Avi-Y-Goldstein/compression-jig-solidworks/SUB_UpperStack.SLDASM

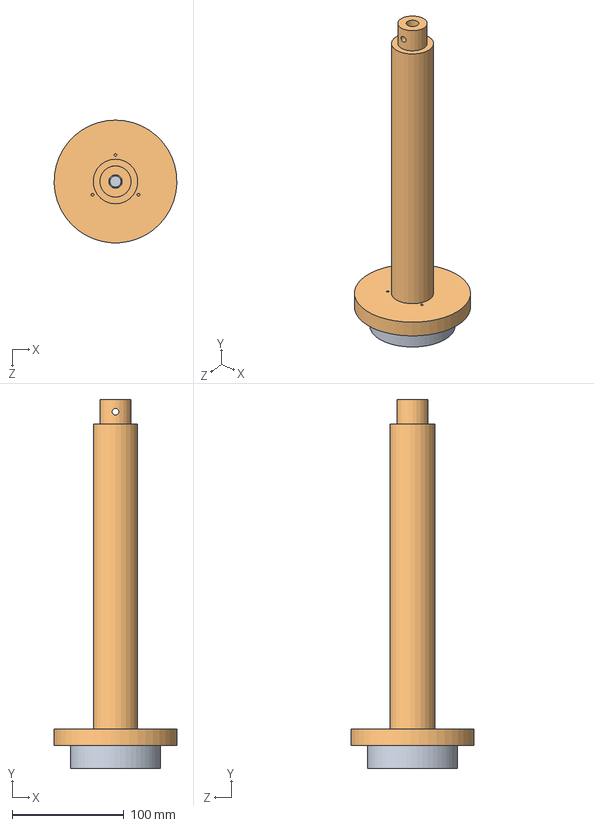
[picture p4: CAD file, 2026-10-13]
SUB_UpperStack.SLDASM
109.9 x 330.5 x 110.0 mm
24_MainCompressionRam
26_UpperPlatenInsulator
