Avi-Y-Goldstein/compression-jig-solidworks/CompressionJig_Assembly.SLDASM

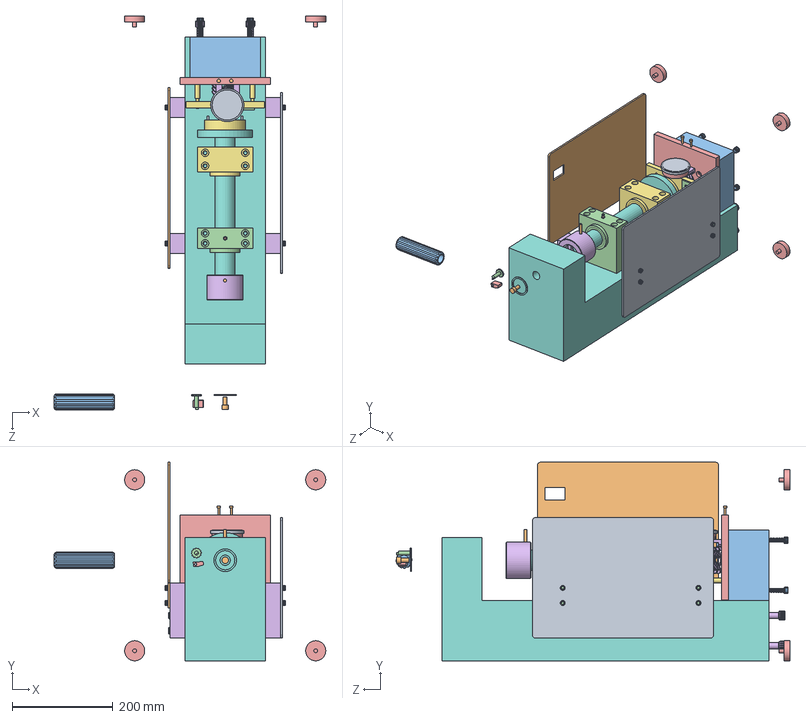
[picture p5: CAD file, 2026-10-13]
CompressionJig_Assembly.SLDASM
540.0 x 395.0 x 783.5 mm
01_Main_Frame_Body
04_LowerRamGuideBlock
08_ShieldMountingBracket x 4
16_BaseFeet x 4
05_UpperRamGuideBlock
03_Anvil_Pedestal
07_RightSafetyShield
06_Left_Safety_Shield
24_MainCompressionRam
26_UpperPlatenInsulator
23_RamCollar
20_SpringLoadedPawl
21_PawlSelectionSwitch
22_LeverHandleGrip
34_SHCS_M8x16_ISO4762
34_PawlPivotPin_4.5x18.5
35_Circlip_40x1.75_DIN471
34_SHCS_M8x40_ISO4762 x 8
34_SHCS_M12x45_ISO4762 x 4
34_GreaseFitting_M6_DIN71412
34_SHCS_M6x16_ISO4762 x 8
34_SHCS_M8x90_ISO4762 x 4
34_DowelPin_6x72_ISO2338
34_SHCS_M4x25_ISO4762 x 4
34_Magnet_D10x5_N42 x 2
31_LowerCompressionPlaten
09_WaveSpring
10_DialBackplate
12_DialNeedle
13_PinionGear
14_DialRack
11_DialBezel
15_LoadPlate
38_GuideStopPin x 2
36_DialFoot x 2
30_LowerInsulatingBaseBlock
28_LeftGuideBar
34_SHCS_M4x12_ISO4762 x 2
34_SHCS_M4x20_ISO4762 x 2
35_Circlip_46x1.75_DIN472
