Avi-Y-Goldstein/compression-jig-solidworks/SUB_LowerStack.SLDASM

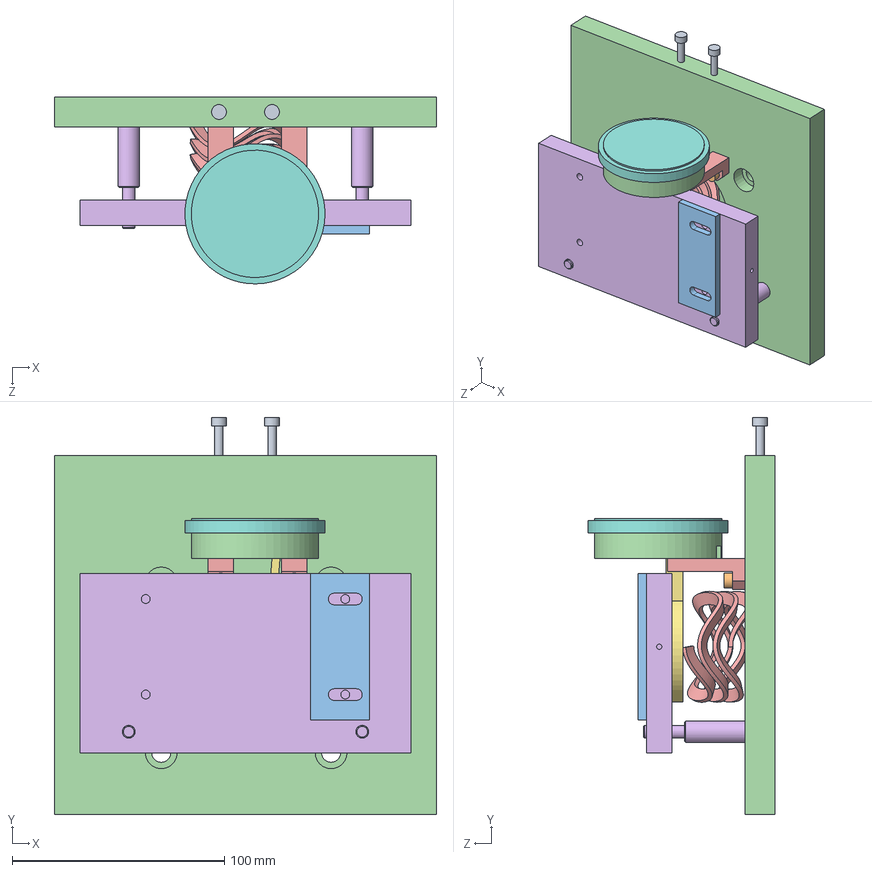
[picture p6: CAD file, 2026-10-13]
SUB_LowerStack.SLDASM
180.0 x 187.0 x 88.0 mm
31_LowerCompressionPlaten
09_WaveSpring
10_DialBackplate
12_DialNeedle
13_PinionGear
14_DialRack
11_DialBezel
15_LoadPlate
38_GuideStopPin x 2
36_DialFoot x 2
30_LowerInsulatingBaseBlock
28_LeftGuideBar
34_SHCS_M4x12_ISO4762 x 2
34_SHCS_M4x20_ISO4762 x 2
