Avi-Y-Goldstein/compression-jig-solidworks/Parts/24_MainCompressionRam.SLDPRT

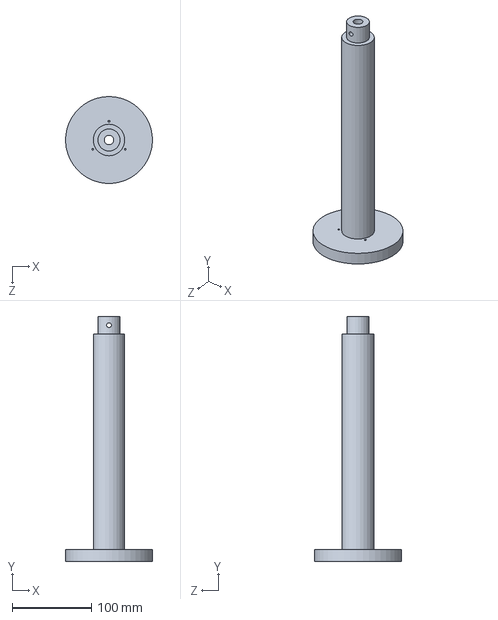
[picture p7: CAD file, 2026-10-13]
Parts/24_MainCompressionRam.SLDPRT
109.9 x 310.0 x 110.0 mm
