Avi-Y-Goldstein/compression-jig-solidworks/SUB_DialIndicator.SLDASM

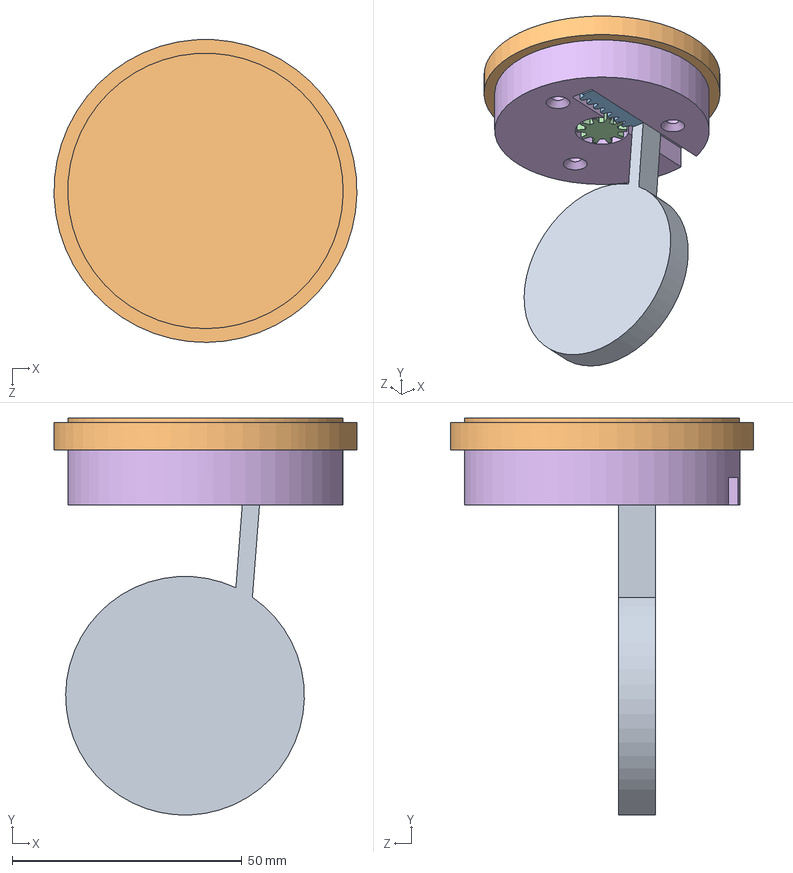
[picture p8: CAD file, 2026-10-13]
SUB_DialIndicator.SLDASM
66.0 x 86.5 x 66.0 mm
10_DialBackplate
12_DialNeedle
13_PinionGear
14_DialRack
11_DialBezel
15_LoadPlate
