Avi-Y-Goldstein/compression-jig-solidworks/Parts/01_Main_Frame_Body.SLDPRT

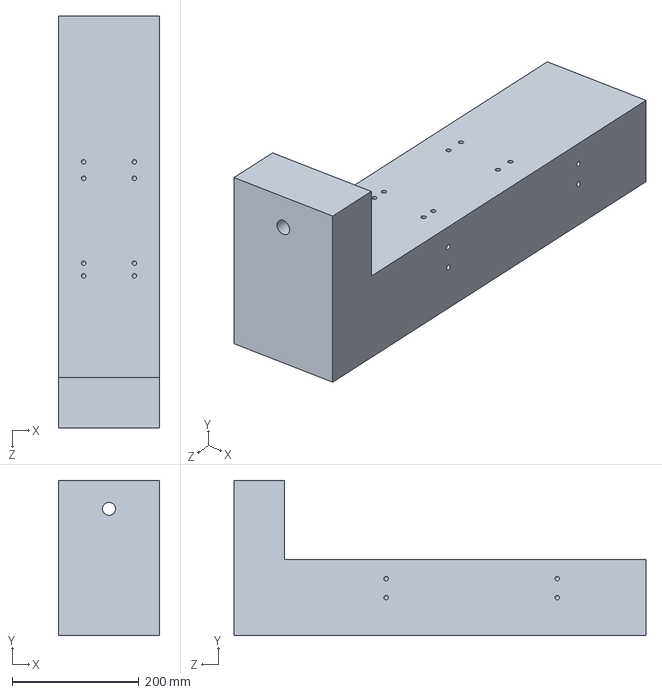
[picture p9: CAD file, 2026-10-13]
Parts/01_Main_Frame_Body.SLDPRT
160.0 x 245.0 x 650.0 mm
