Avi-Y-Goldstein/compression-jig-solidworks/Parts/07_RightSafetyShield.SLDPRT

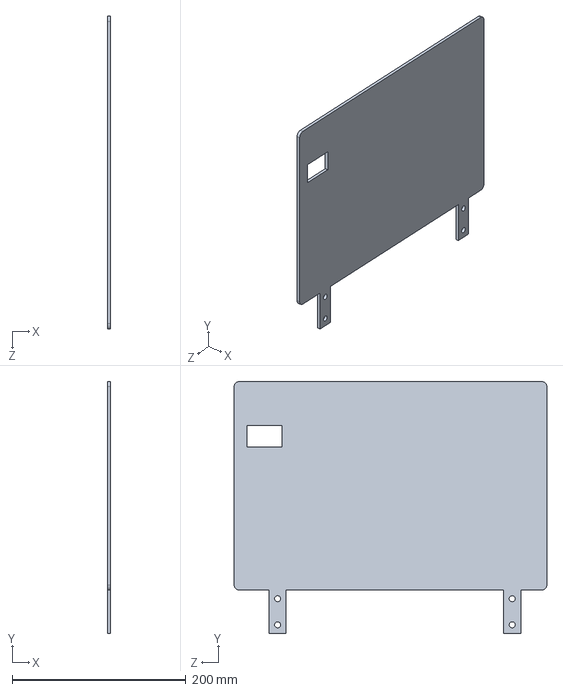
[picture p10: CAD file, 2026-10-13]
Parts/07_RightSafetyShield.SLDPRT
4.00 x 290.0 x 360.0 mm
