Avi-Y-Goldstein/compression-jig-solidworks/Parts/14_DialRack.SLDPRT

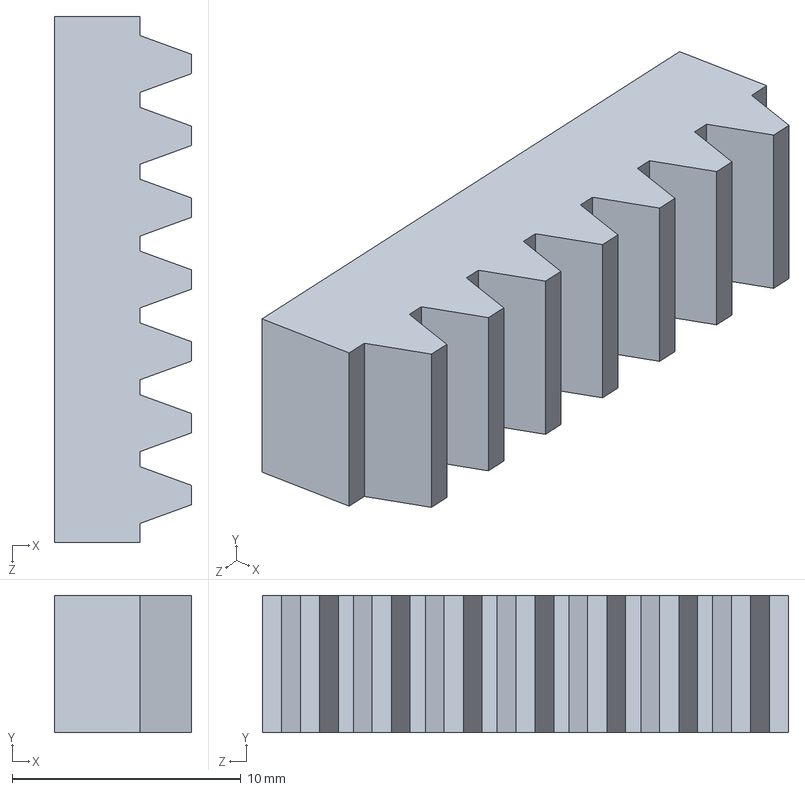
[picture p11: CAD file, 2026-10-13]
Parts/14_DialRack.SLDPRT
6.00 x 6.00 x 23.0 mm
