Avi-Y-Goldstein/compression-jig-solidworks/Parts/16_BaseFeet.SLDPRT

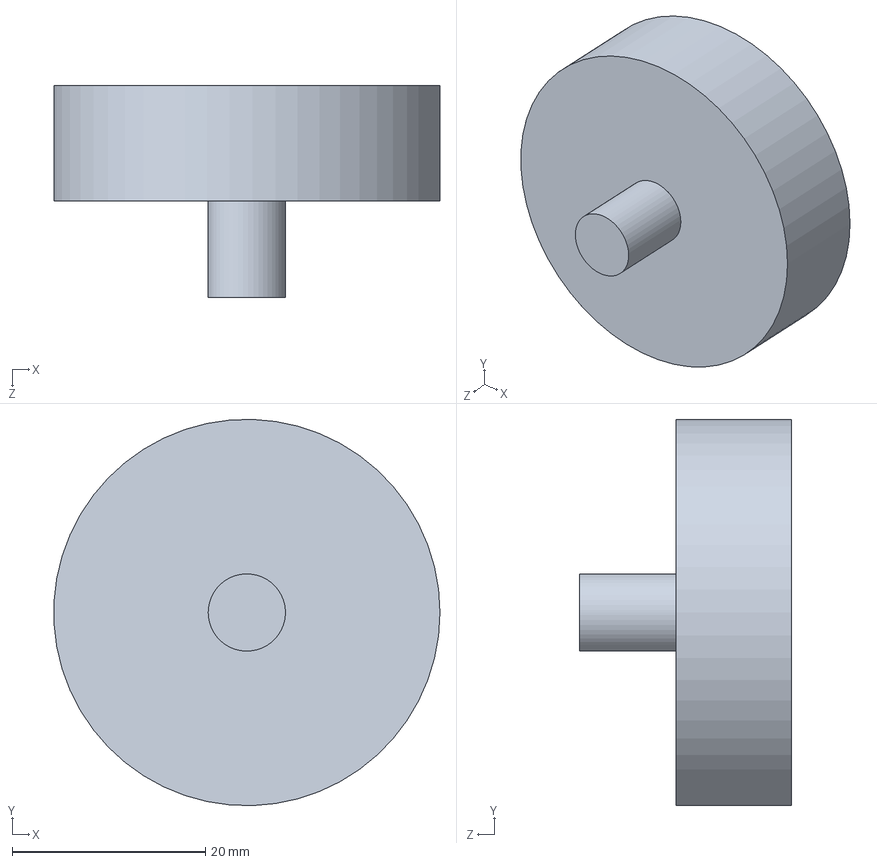
[picture p12: CAD file, 2026-10-13]
Parts/16_BaseFeet.SLDPRT
40.0 x 40.0 x 22.0 mm
