Avi-Y-Goldstein/compression-jig-solidworks/Parts/34_SHCS_M6x16_ISO4762.SLDPRT

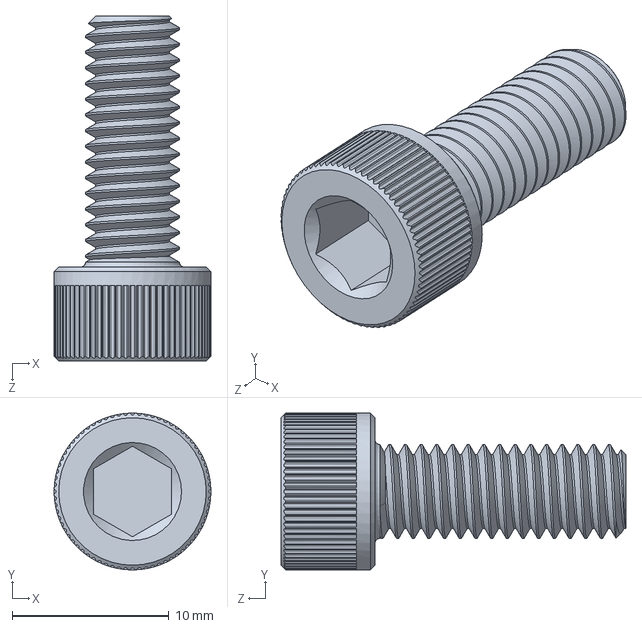
[picture p13: CAD file, 2026-10-13]
Parts/34_SHCS_M6x16_ISO4762.SLDPRT
10.0 x 10.0 x 22.0 mm
