Avi-Y-Goldstein/compression-jig-solidworks/Parts/28_LeftGuideBar.SLDPRT

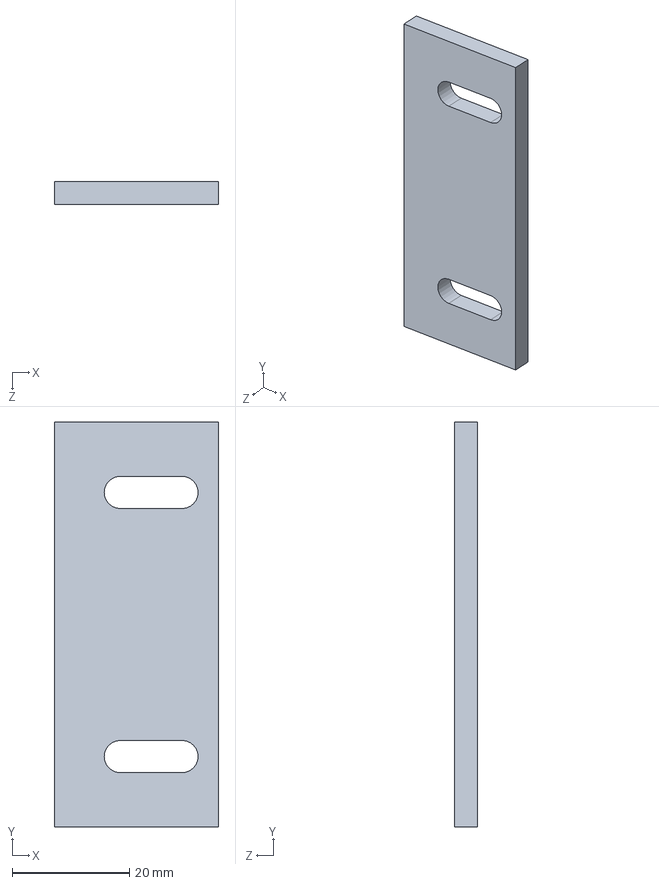
[picture p14: CAD file, 2026-10-13]
Parts/28_LeftGuideBar.SLDPRT
28.0 x 69.0 x 4.00 mm
