Avi-Y-Goldstein/compression-jig-solidworks/Parts/26_UpperPlatenInsulator.SLDPRT

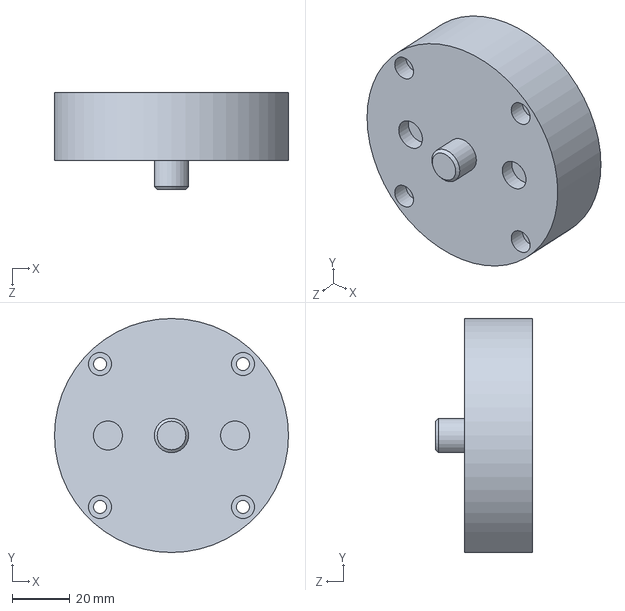
[picture p15: CAD file, 2026-10-13]
Parts/26_UpperPlatenInsulator.SLDPRT
81.0 x 81.0 x 33.5 mm
