Avi-Y-Goldstein/compression-jig-solidworks/Parts/21_PawlSelectionSwitch.SLDPRT

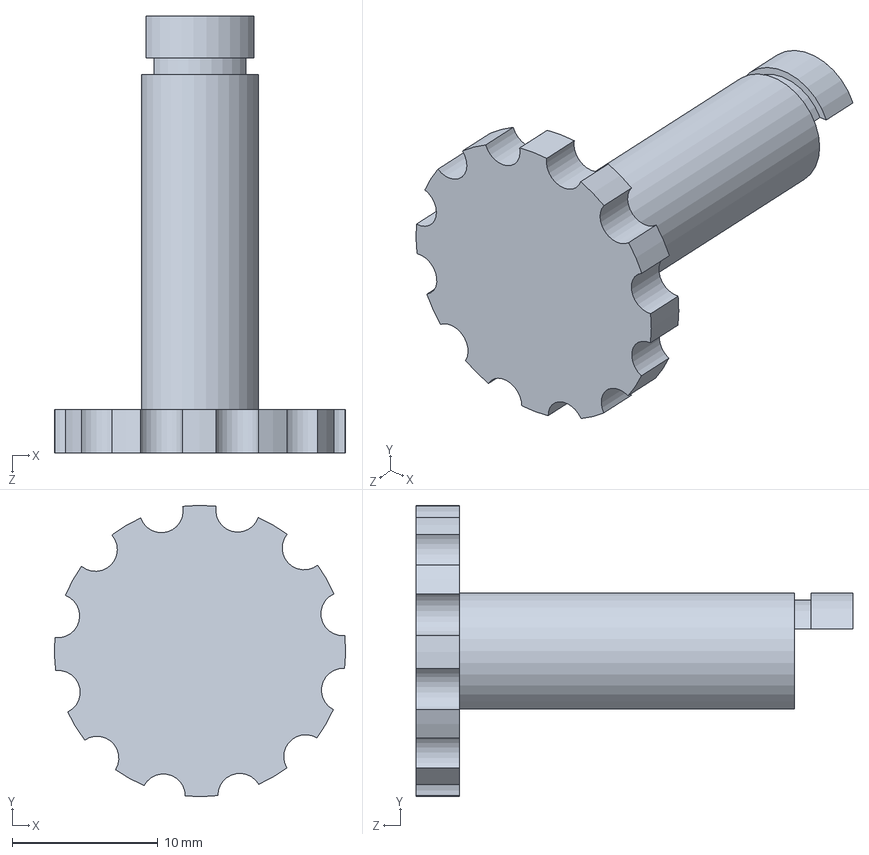
[picture p16: CAD file, 2026-10-13]
Parts/21_PawlSelectionSwitch.SLDPRT
20.0 x 20.0 x 30.0 mm
