Avi-Y-Goldstein/compression-jig-solidworks/Parts/34_SHCS_M4x12_ISO4762.SLDPRT

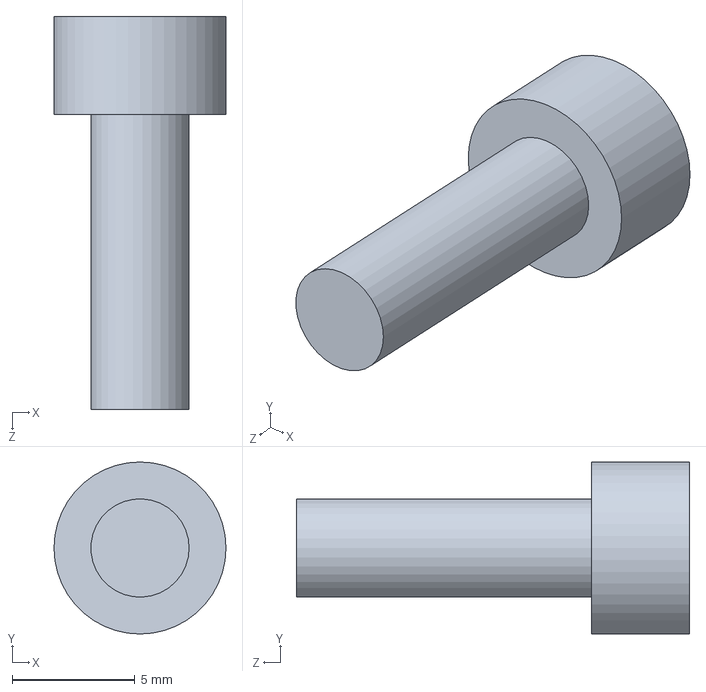
[picture p17: CAD file, 2026-10-13]
Parts/34_SHCS_M4x12_ISO4762.SLDPRT
7.00 x 7.00 x 16.0 mm
