Avi-Y-Goldstein/compression-jig-solidworks/Parts/34_SHCS_M8x90_ISO4762.SLDPRT

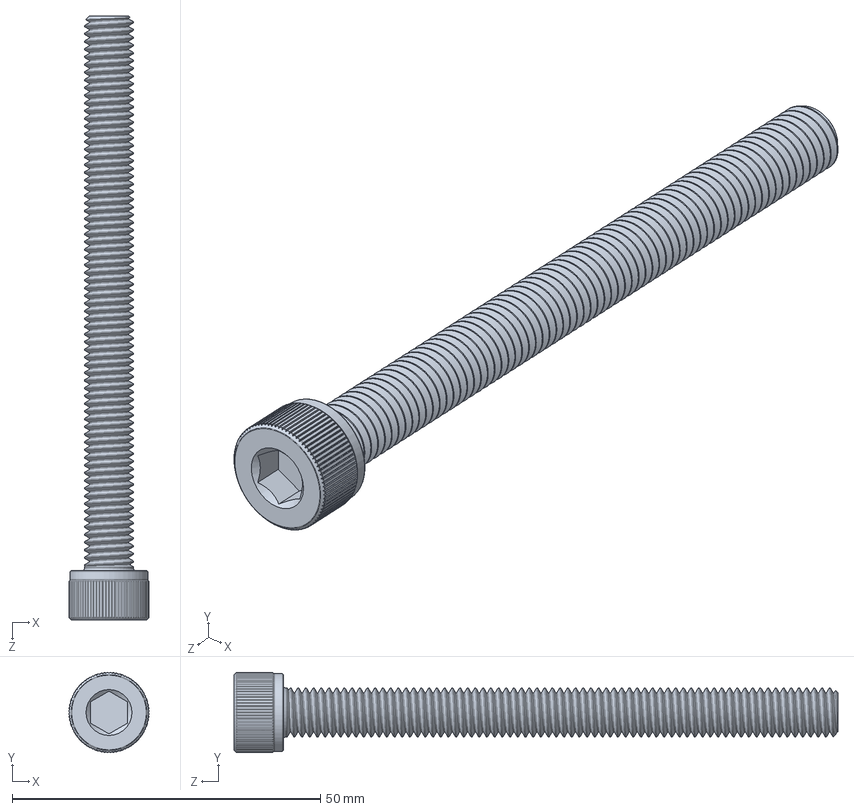
[picture p18: CAD file, 2026-10-13]
Parts/34_SHCS_M8x90_ISO4762.SLDPRT
13.0 x 13.0 x 98.0 mm
