Avi-Y-Goldstein/compression-jig-solidworks/Parts/04_LowerRamGuideBlock.SLDPRT

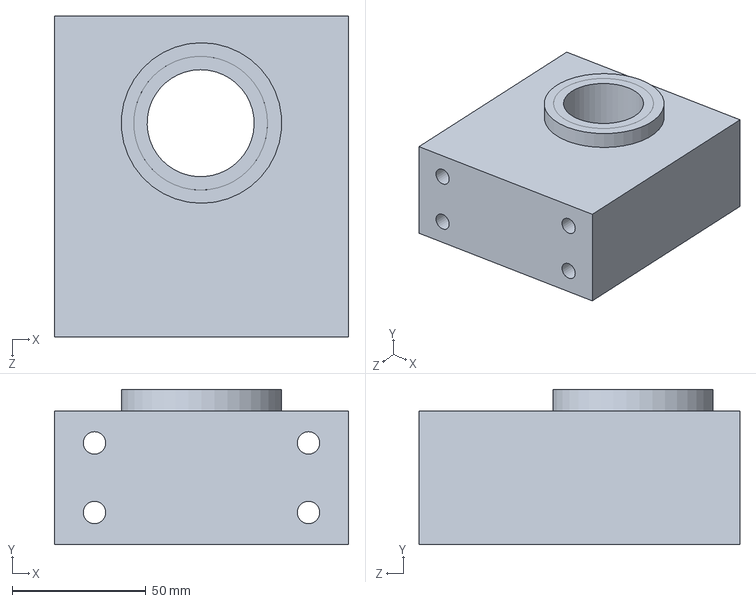
[picture p19: CAD file, 2026-10-13]
Parts/04_LowerRamGuideBlock.SLDPRT
110.0 x 58.0 x 120.0 mm
