Avi-Y-Goldstein/compression-jig-solidworks/Parts/34_SHCS_M12x45_ISO4762.SLDPRT

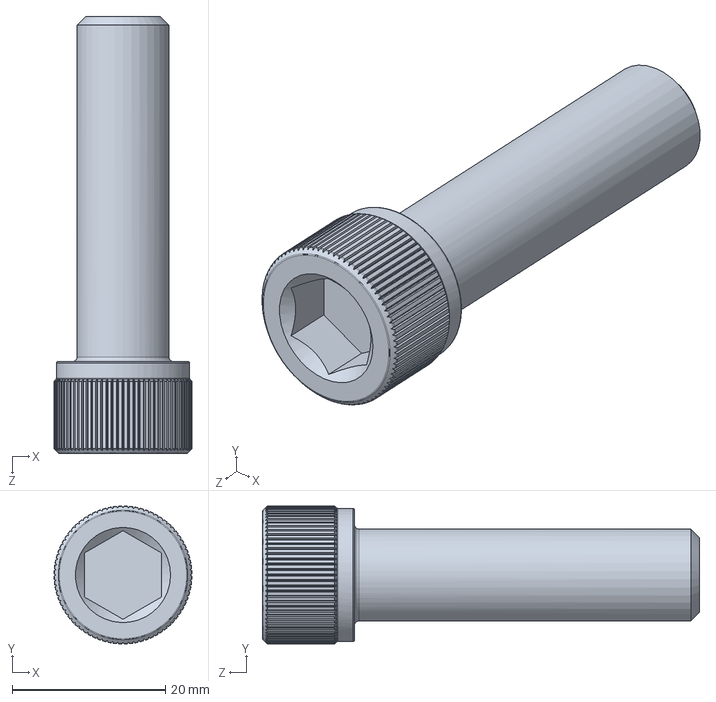
[picture p20: CAD file, 2026-10-13]
Parts/34_SHCS_M12x45_ISO4762.SLDPRT
18.0 x 18.0 x 57.0 mm
