Avi-Y-Goldstein/compression-jig-solidworks/Parts/05_UpperRamGuideBlock.SLDPRT

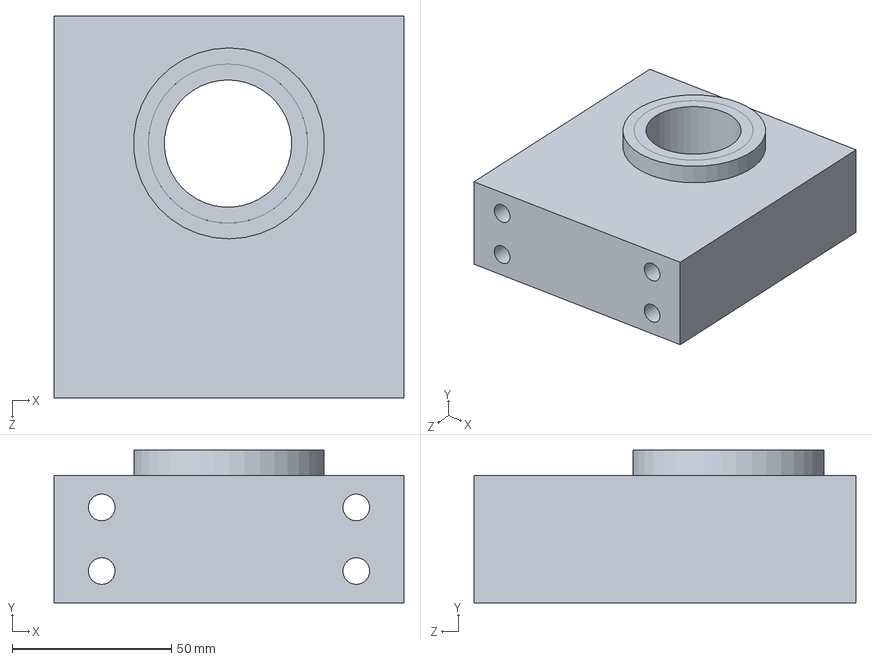
[picture p21: CAD file, 2026-10-13]
Parts/05_UpperRamGuideBlock.SLDPRT
110.0 x 48.0 x 120.0 mm
