Avi-Y-Goldstein/compression-jig-solidworks/Parts/34_Magnet_D10x5_N42.SLDPRT

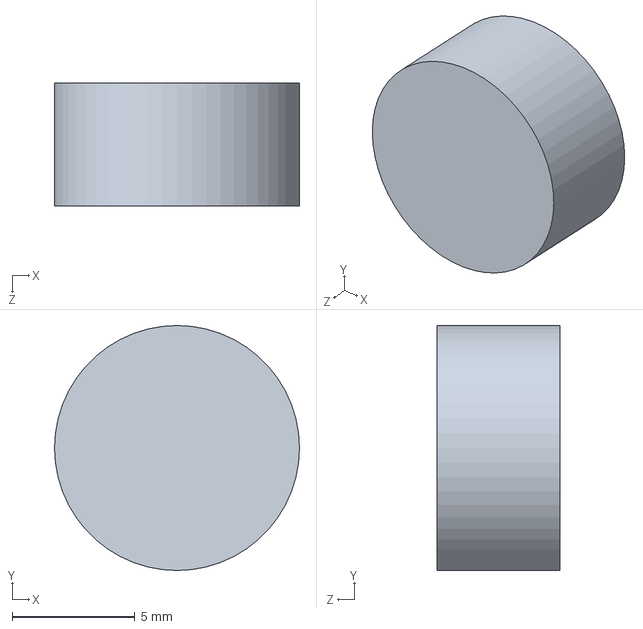
[picture p22: CAD file, 2026-10-13]
Parts/34_Magnet_D10x5_N42.SLDPRT
10.0 x 10.0 x 5.00 mm
