Avi-Y-Goldstein/compression-jig-solidworks/Parts/09_WaveSpring.SLDPRT

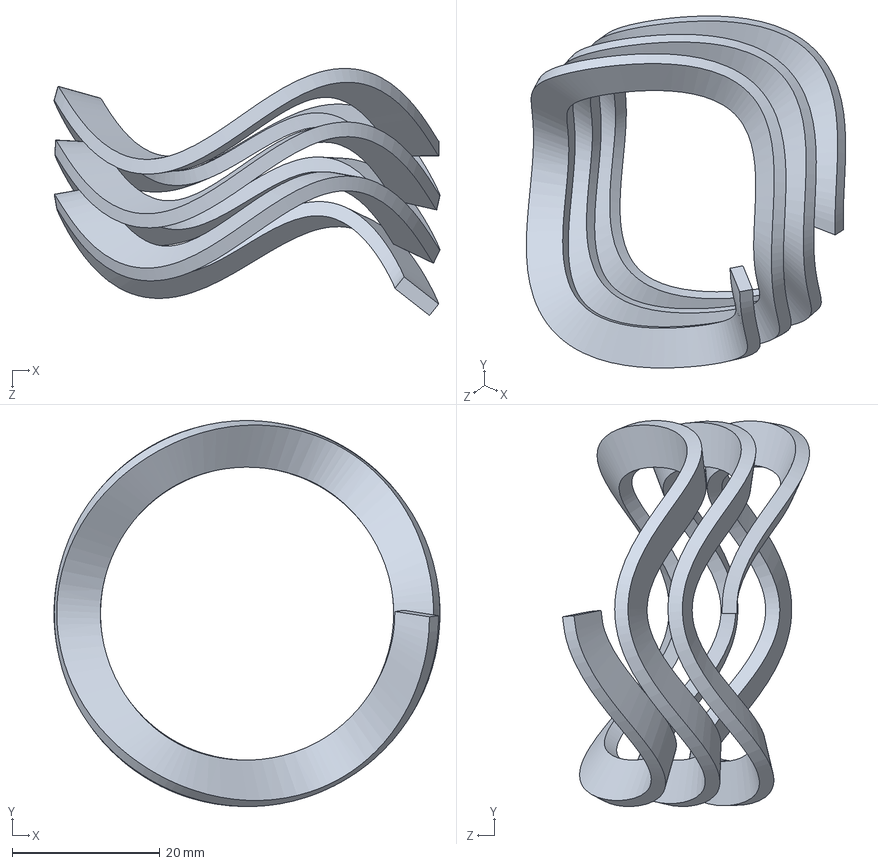
[picture p23: CAD file, 2026-10-13]
Parts/09_WaveSpring.SLDPRT
52.3 x 52.3 x 33.5 mm
