Avi-Y-Goldstein/compression-jig-solidworks/Parts/34_SHCS_M8x40_ISO4762.SLDPRT

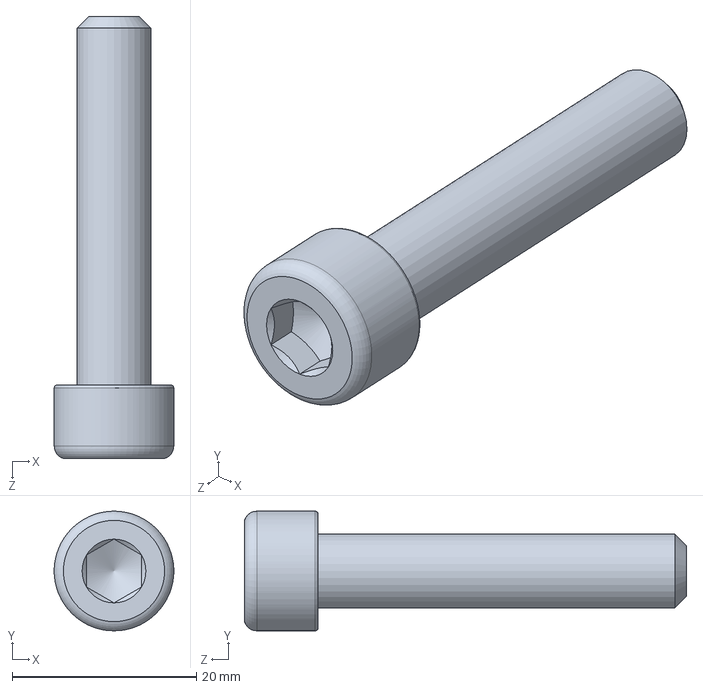
[picture p25: CAD file, 2026-10-13]
Parts/34_SHCS_M8x40_ISO4762.SLDPRT
13.0 x 13.0 x 48.0 mm
