Avi-Y-Goldstein/compression-jig-solidworks/Parts/35_Circlip_40x1.75_DIN471.SLDPRT

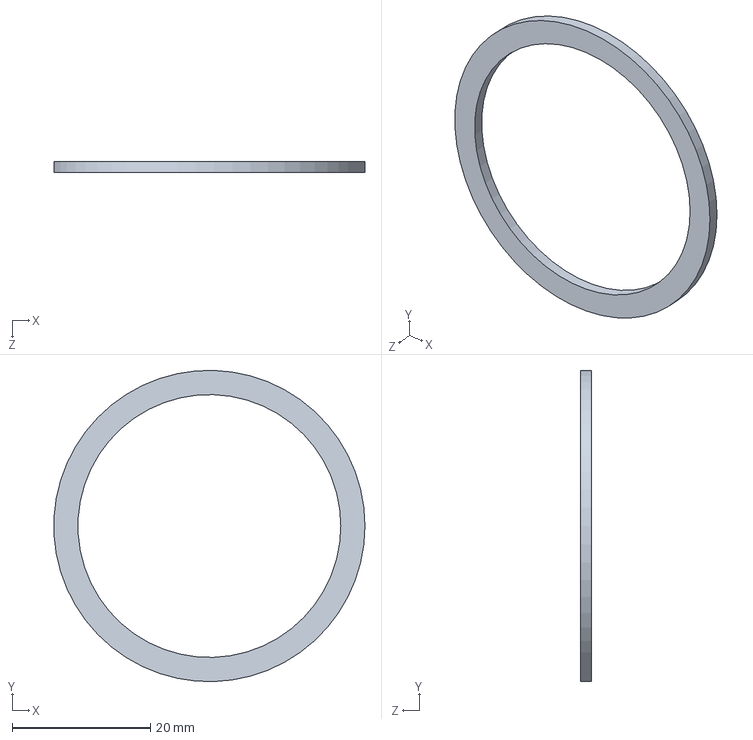
[picture p26: CAD file, 2026-10-13]
Parts/35_Circlip_40x1.75_DIN471.SLDPRT
45.0 x 45.0 x 1.60 mm
