Avi-Y-Goldstein/compression-jig-solidworks/Parts/38_GuideStopPin.SLDPRT

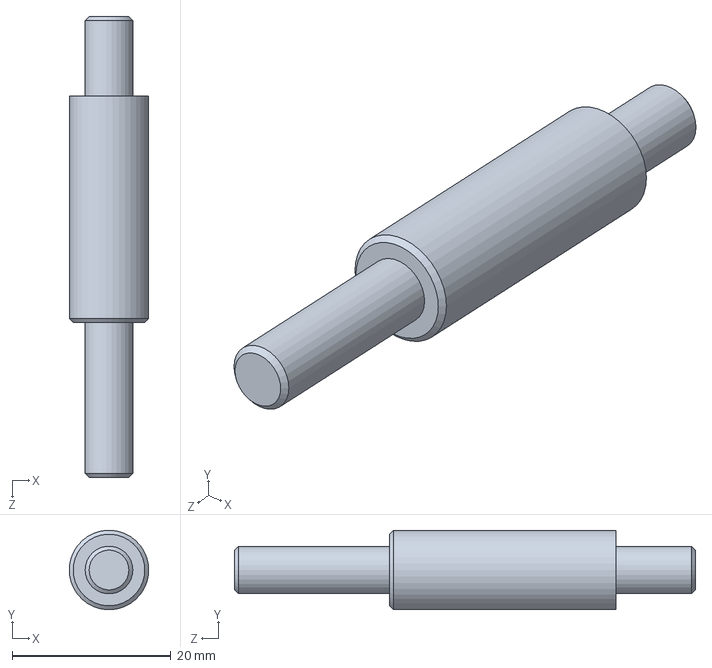
[picture p27: CAD file, 2026-10-13]
Parts/38_GuideStopPin.SLDPRT
10.0 x 9.97 x 58.0 mm
