Avi-Y-Goldstein/compression-jig-solidworks/Parts/34_GreaseFitting_M6_DIN71412.SLDPRT

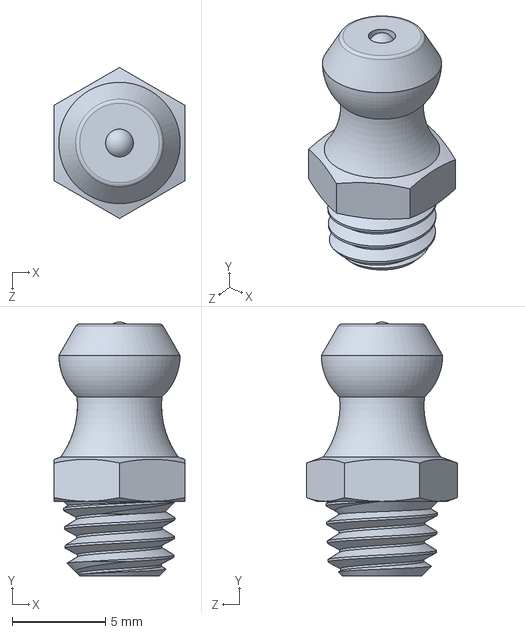
[picture p28: CAD file, 2026-10-13]
Parts/34_GreaseFitting_M6_DIN71412.SLDPRT
7.00 x 13.6 x 8.08 mm
