Avi-Y-Goldstein/compression-jig-solidworks/Parts/10_DialBackplate.SLDPRT

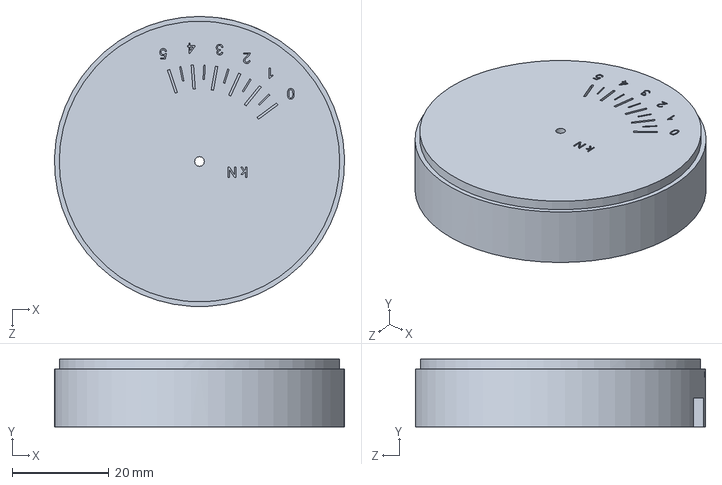
[picture p29: CAD file, 2026-10-13]
Parts/10_DialBackplate.SLDPRT
60.0 x 14.0 x 60.0 mm
