Avi-Y-Goldstein/compression-jig-solidworks/Parts/11_DialBezel.SLDPRT

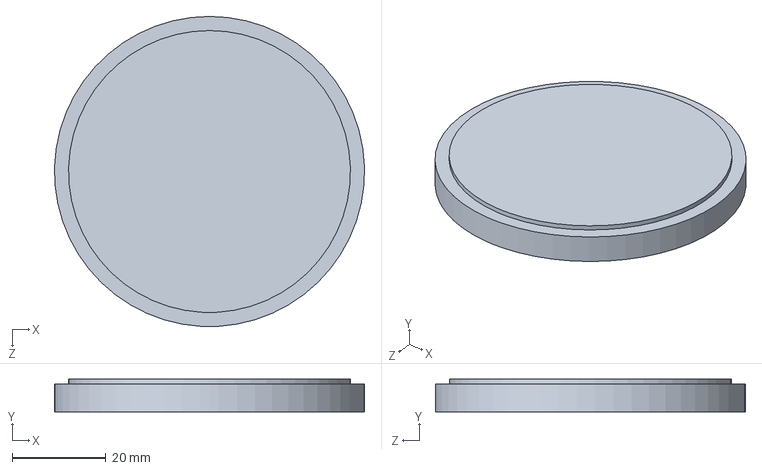
[picture p30: CAD file, 2026-10-13]
Parts/11_DialBezel.SLDPRT
66.0 x 7.00 x 66.0 mm
