Avi-Y-Goldstein/compression-jig-solidworks/Parts/20_SpringLoadedPawl.SLDPRT

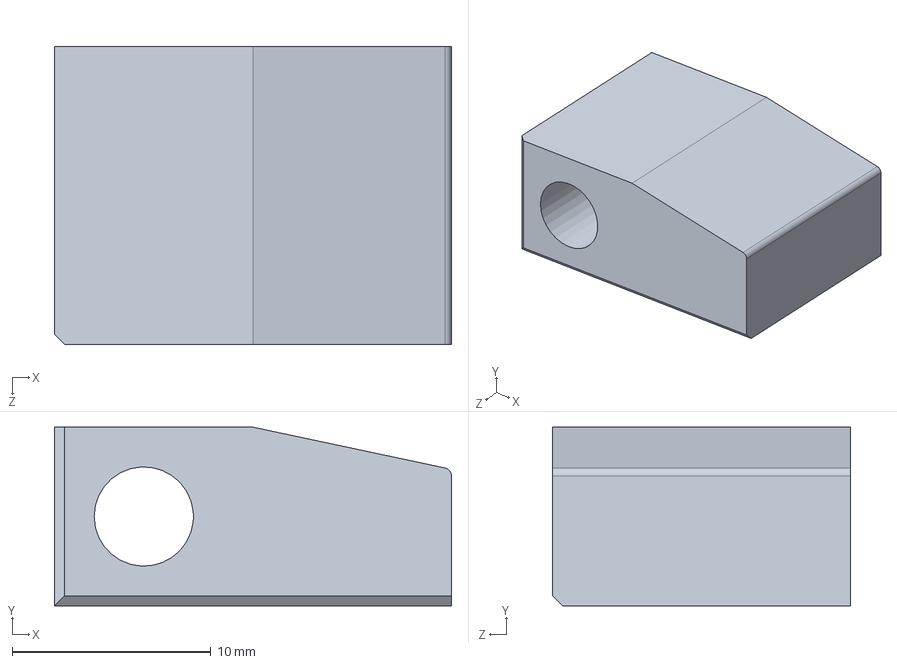
[picture p31: CAD file, 2026-10-13]
Parts/20_SpringLoadedPawl.SLDPRT
20.0 x 9.00 x 15.0 mm
