Avi-Y-Goldstein/compression-jig-solidworks/Parts/06_Left_Safety_Shield.SLDPRT

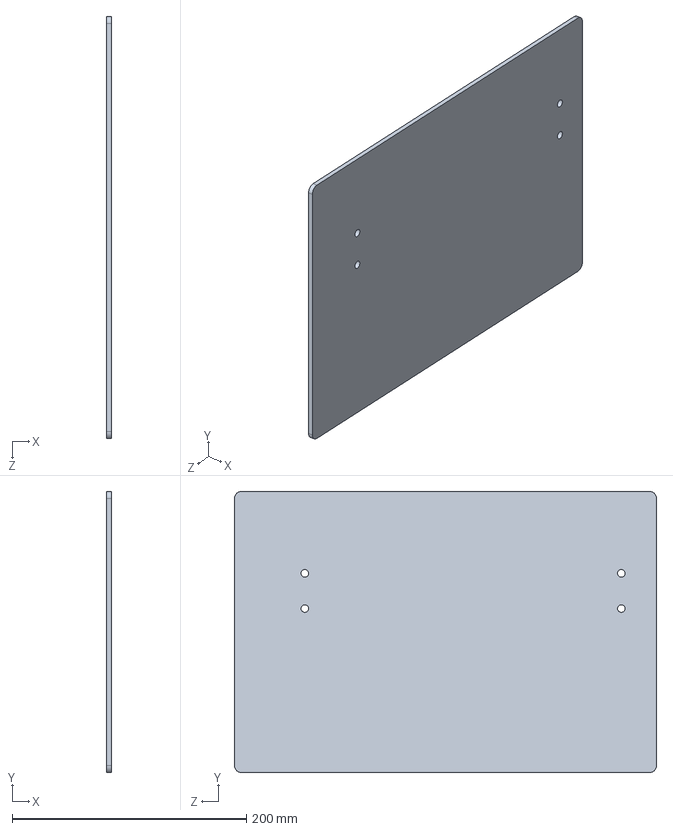
[picture p32: CAD file, 2026-10-13]
Parts/06_Left_Safety_Shield.SLDPRT
4.00 x 240.0 x 360.0 mm
