Avi-Y-Goldstein/compression-jig-solidworks/Parts/03_Anvil_Pedestal.SLDPRT

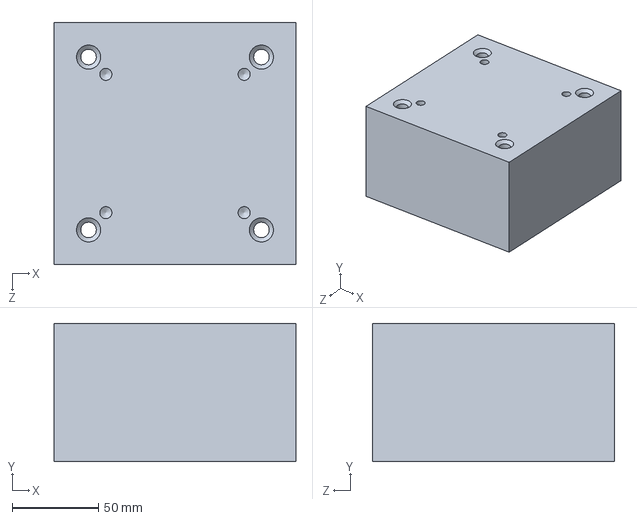
[picture p33: CAD file, 2026-10-13]
Parts/03_Anvil_Pedestal.SLDPRT
140.0 x 80.0 x 140.0 mm
