Avi-Y-Goldstein/compression-jig-solidworks/Parts/34_PawlPivotPin_4.5x18.5.SLDPRT

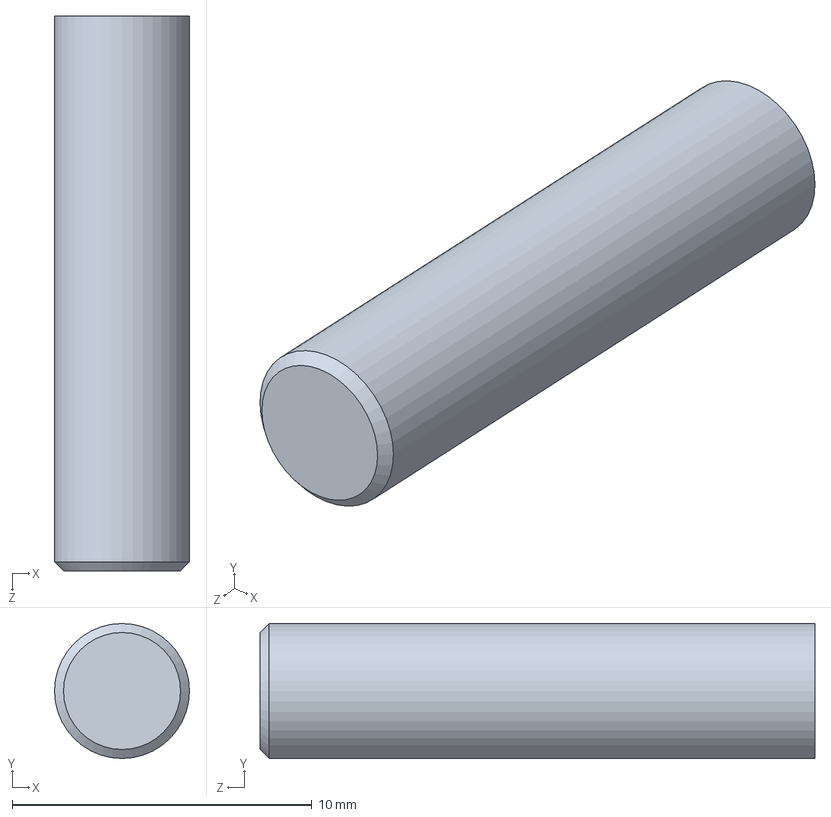
[picture p34: CAD file, 2026-10-13]
Parts/34_PawlPivotPin_4.5x18.5.SLDPRT
4.50 x 4.50 x 18.5 mm
