Avi-Y-Goldstein/compression-jig-solidworks/Parts/08_ShieldMountingBracket.SLDPRT

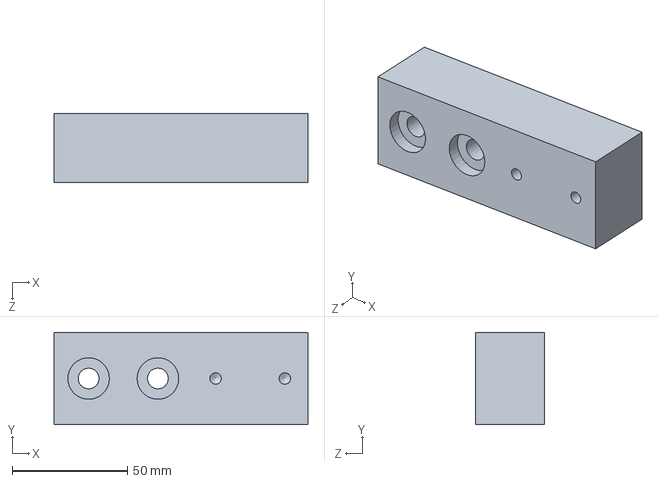
[picture p35: CAD file, 2026-10-13]
Parts/08_ShieldMountingBracket.SLDPRT
110.0 x 40.0 x 30.0 mm
