Avi-Y-Goldstein/compression-jig-solidworks/Parts/36_DialFoot.SLDPRT

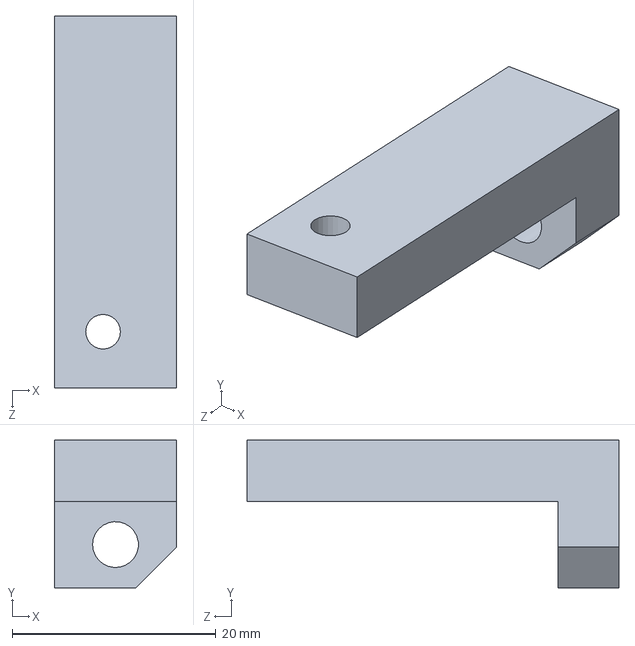
[picture p36: CAD file, 2026-10-13]
Parts/36_DialFoot.SLDPRT
12.0 x 14.5 x 36.5 mm
