Avi-Y-Goldstein/compression-jig-solidworks/Parts/13_PinionGear.SLDPRT

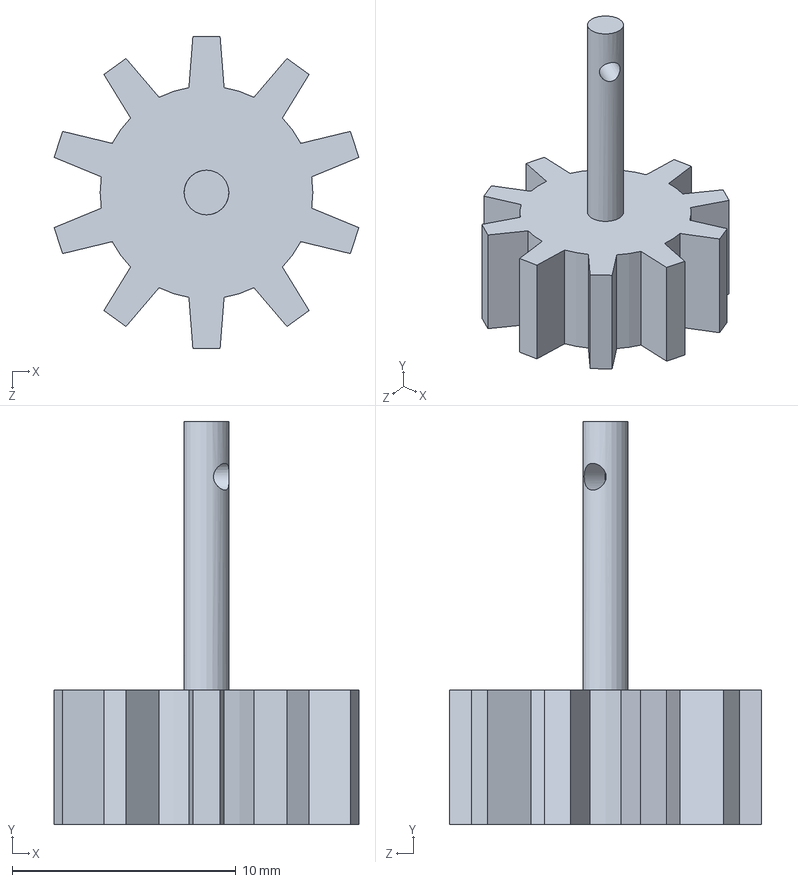
[picture p37: CAD file, 2026-10-13]
Parts/13_PinionGear.SLDPRT
13.6 x 18.0 x 13.9 mm
