Avi-Y-Goldstein/compression-jig-solidworks/Parts/30_LowerInsulatingBaseBlock.SLDPRT

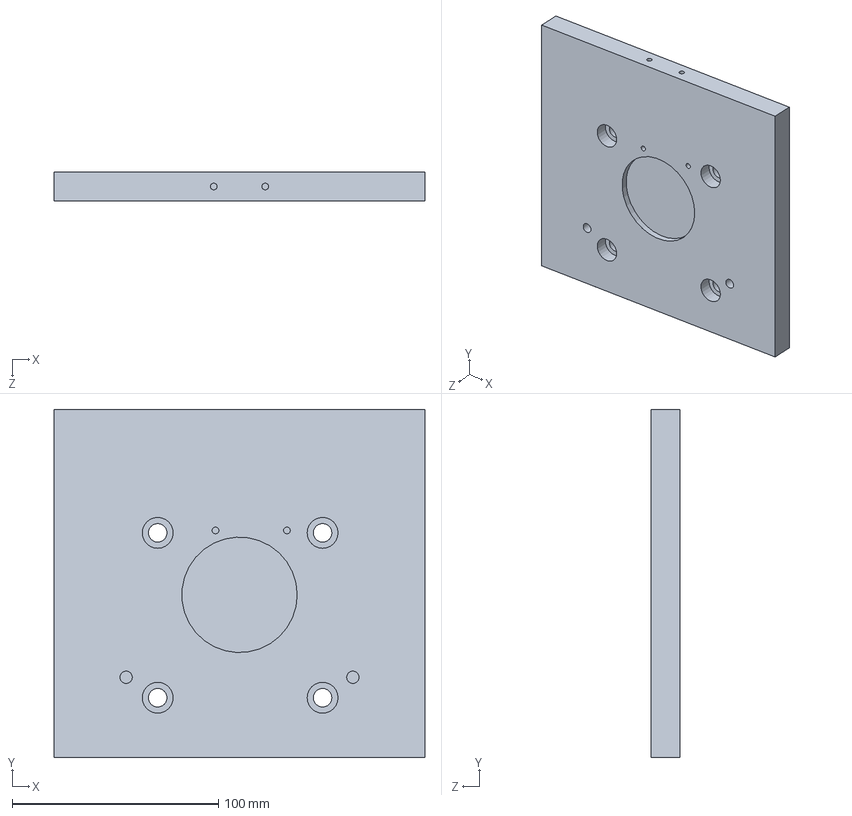
[picture p38: CAD file, 2026-10-13]
Parts/30_LowerInsulatingBaseBlock.SLDPRT
180.0 x 169.0 x 14.0 mm
