Avi-Y-Goldstein/compression-jig-solidworks/Parts/34_DowelPin_6x72_ISO2338.SLDPRT

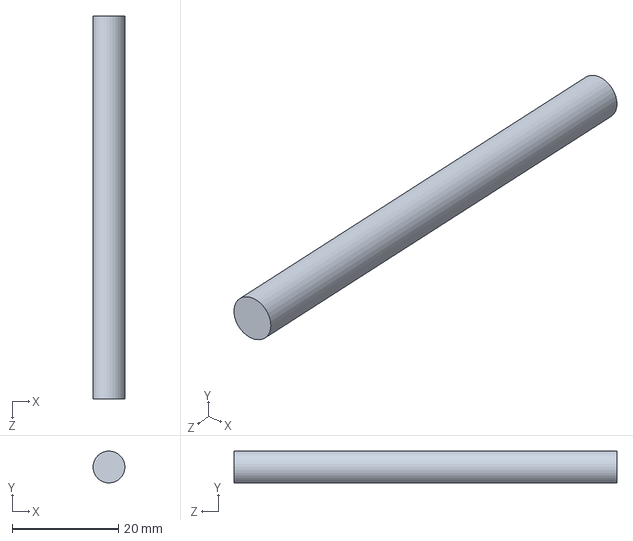
[picture p39: CAD file, 2026-10-13]
Parts/34_DowelPin_6x72_ISO2338.SLDPRT
5.99 x 5.99 x 72.0 mm
