Avi-Y-Goldstein/compression-jig-solidworks/Parts/35_Circlip_46x1.75_DIN472.SLDPRT

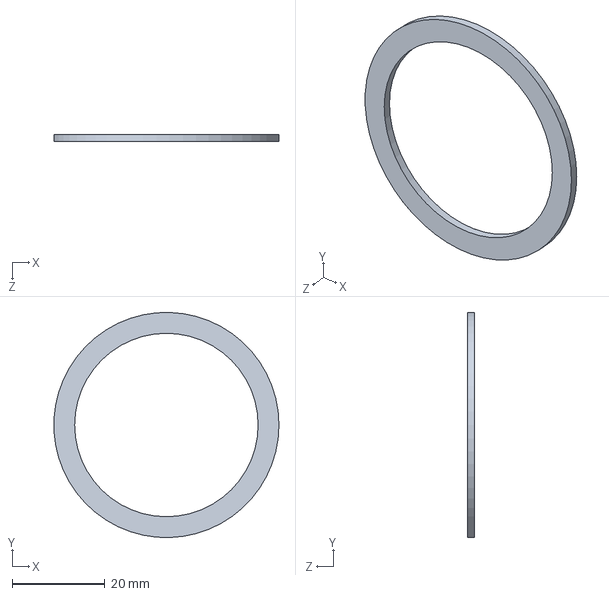
[picture p40: CAD file, 2026-10-13]
Parts/35_Circlip_46x1.75_DIN472.SLDPRT
48.5 x 48.5 x 1.60 mm
