Avi-Y-Goldstein/compression-jig-solidworks/Parts/22_LeverHandleGrip.SLDPRT

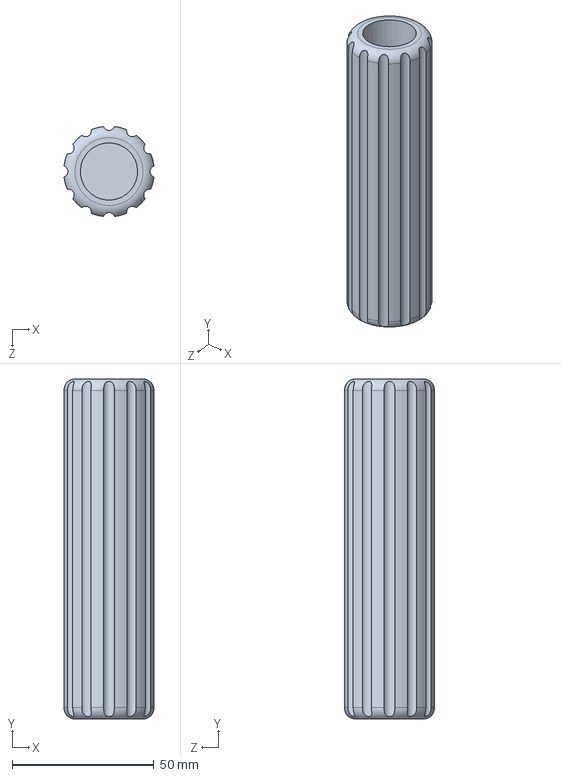
[picture p41: CAD file, 2026-10-13]
Parts/22_LeverHandleGrip.SLDPRT
31.8 x 120.0 x 31.8 mm
