Avi-Y-Goldstein/compression-jig-solidworks/Parts/15_LoadPlate.SLDPRT

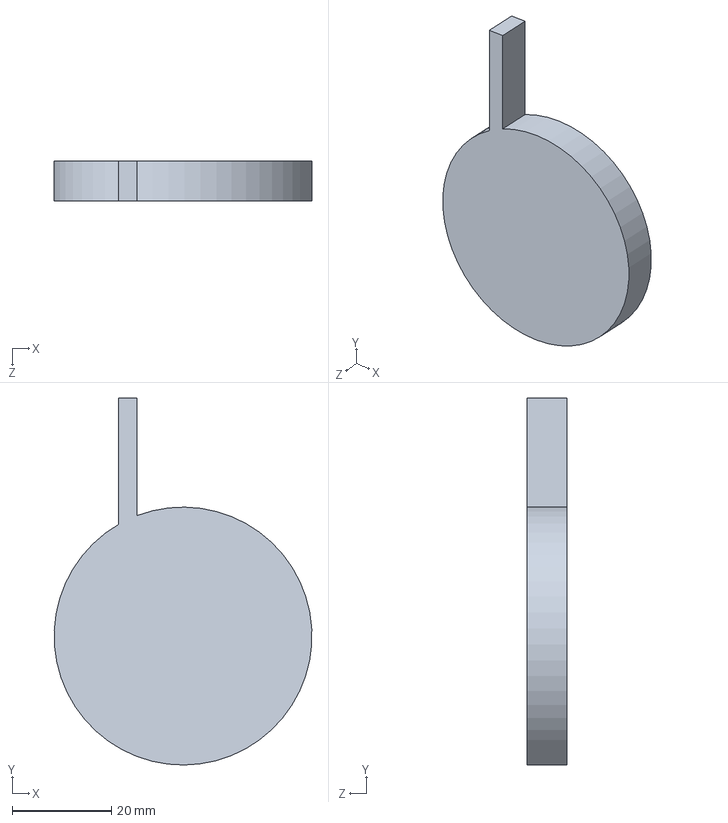
[picture p42: CAD file, 2026-10-13]
Parts/15_LoadPlate.SLDPRT
51.9 x 74.0 x 8.00 mm
