Avi-Y-Goldstein/compression-jig-solidworks/Parts/12_DialNeedle.SLDPRT

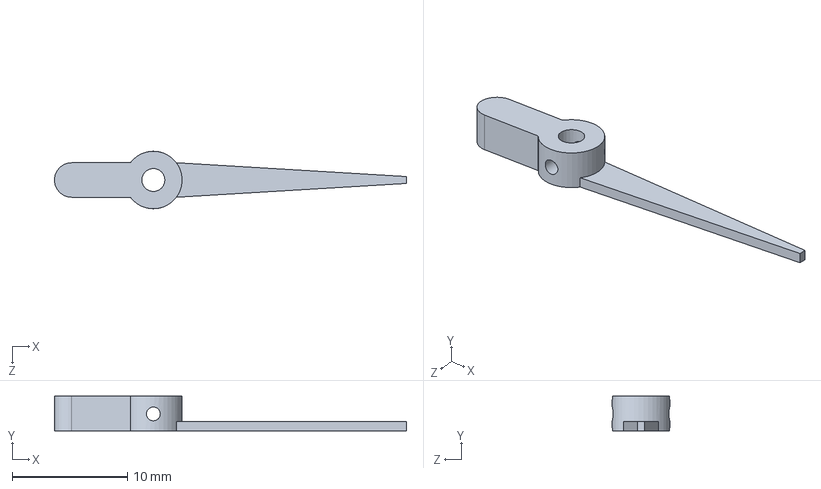
[picture p43: CAD file, 2026-10-13]
Parts/12_DialNeedle.SLDPRT
30.6 x 3.00 x 5.00 mm
