Avi-Y-Goldstein/compression-jig-solidworks/Parts/23_RamCollar.SLDPRT

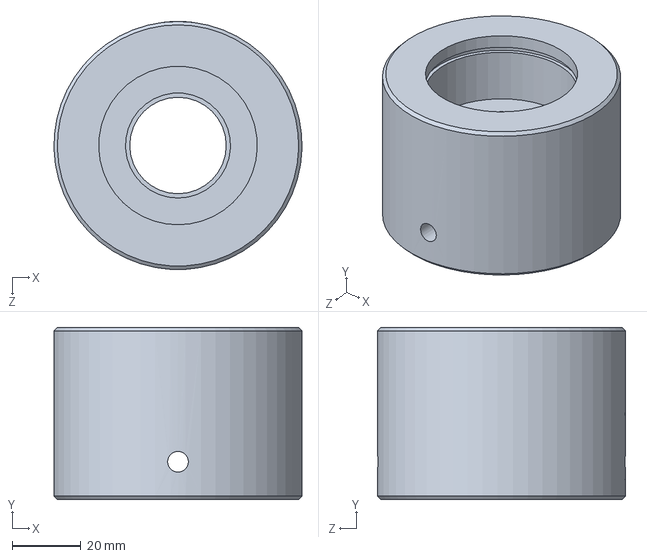
[picture p44: CAD file, 2026-10-13]
Parts/23_RamCollar.SLDPRT
72.0 x 50.0 x 72.0 mm
