Avi-Y-Goldstein/compression-jig-solidworks/Parts/31_LowerCompressionPlaten.SLDPRT

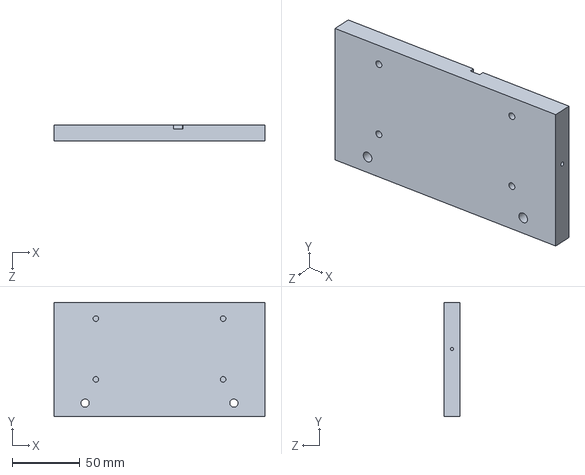
[picture p45: CAD file, 2026-10-13]
Parts/31_LowerCompressionPlaten.SLDPRT
156.0 x 84.5 x 12.0 mm
