Avi-Y-Goldstein/compression-jig-solidworks/Parts/34_SHCS_M4x20_ISO4762.SLDPRT

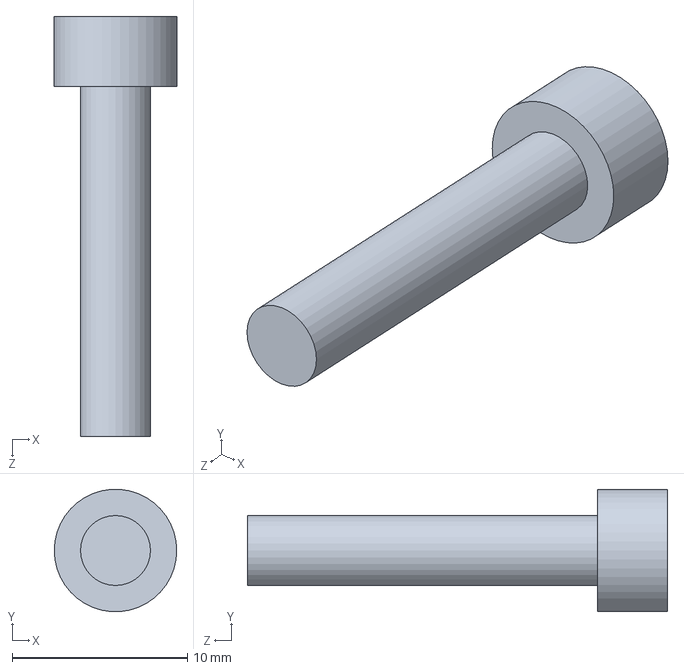
[picture p46: CAD file, 2026-10-13]
Parts/34_SHCS_M4x20_ISO4762.SLDPRT
7.00 x 6.98 x 24.0 mm
