Avi-Y-Goldstein/compression-jig-solidworks/Parts/34_SHCS_M4x25_ISO4762.SLDPRT

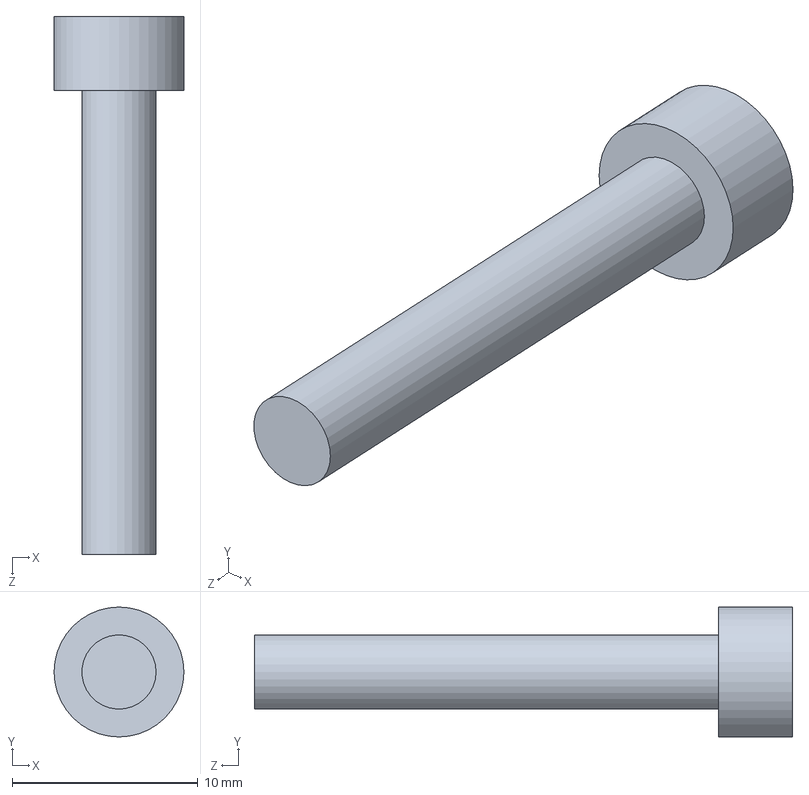
[picture p47: CAD file, 2026-10-13]
Parts/34_SHCS_M4x25_ISO4762.SLDPRT
7.00 x 7.00 x 29.0 mm
