Avi-Y-Goldstein/compression-jig-solidworks/Parts/18_RatchetingLeverArm.SLDPRT

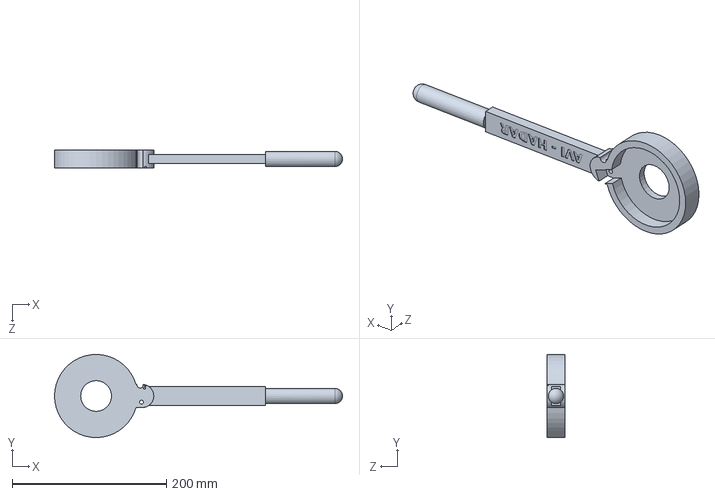
[picture p48: CAD file, 2026-10-13]
Parts/18_RatchetingLeverArm.SLDPRT
374.0 x 108.0 x 23.0 mm
