Avi-Y-Goldstein/compression-jig-solidworks/Parts/37_DialPin.SLDPRT

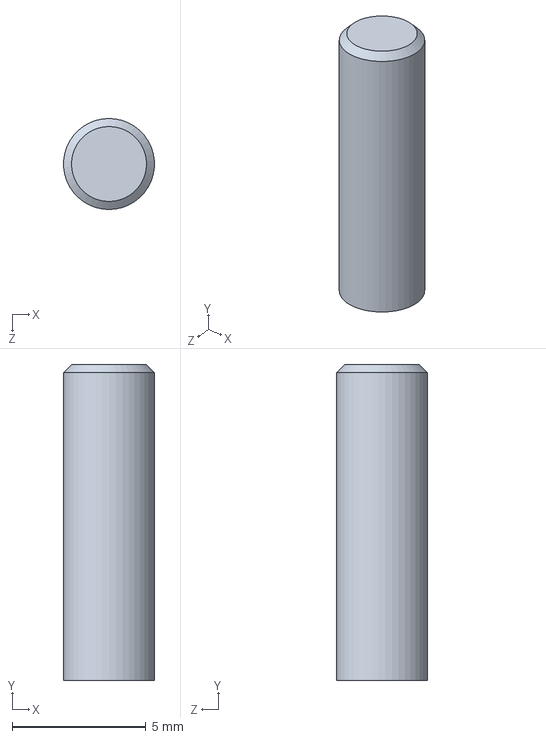
[picture p49: CAD file, 2026-10-13]
Parts/37_DialPin.SLDPRT
3.39 x 11.8 x 3.40 mm
