Avi-Y-Goldstein/compression-jig-solidworks/Parts/35_RetainingRing_8x0.8_DIN471.SLDPRT

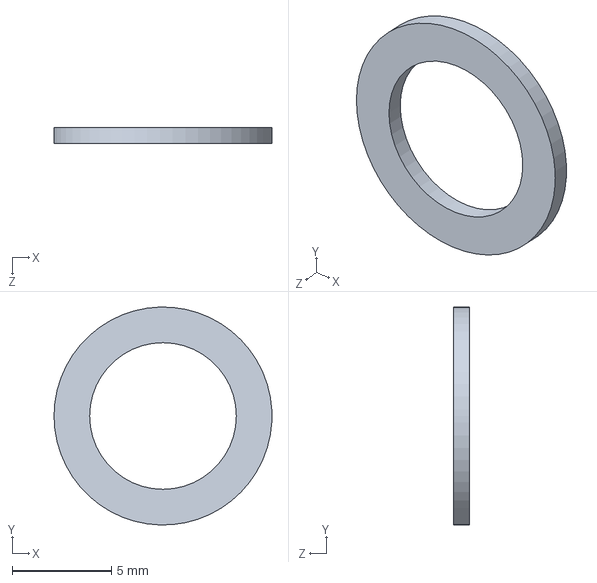
[picture p50: CAD file, 2026-10-13]
Parts/35_RetainingRing_8x0.8_DIN471.SLDPRT
11.0 x 11.0 x 0.8 mm
