Avi-Y-Goldstein/compression-jig-solidworks/Parts/32_TerminalContactBlock.SLDPRT

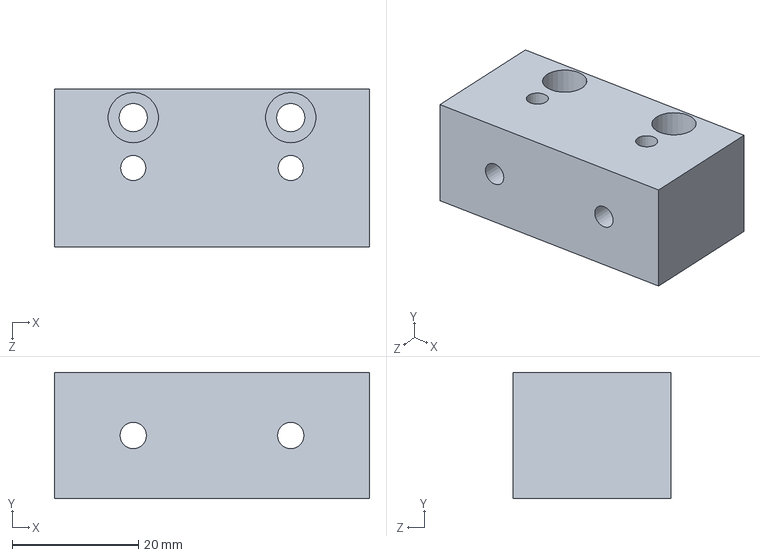
[picture p51: CAD file, 2026-10-13]
Parts/32_TerminalContactBlock.SLDPRT
50.0 x 20.0 x 25.0 mm
