Avi-Y-Goldstein/compression-jig-solidworks/Parts/19_RatchetGearHub.SLDPRT

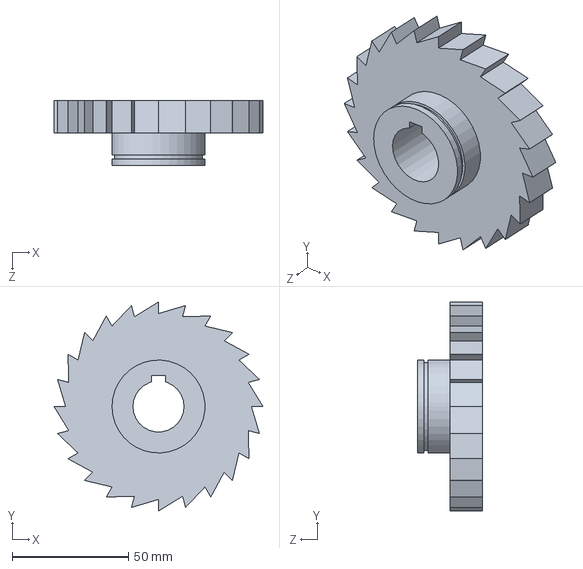
[picture p52: CAD file, 2026-10-13]
Parts/19_RatchetGearHub.SLDPRT
90.0 x 90.0 x 28.0 mm
