Avi-Y-Goldstein/compression-jig-solidworks/Parts/34_HexNut_DialNeedle.SLDPRT

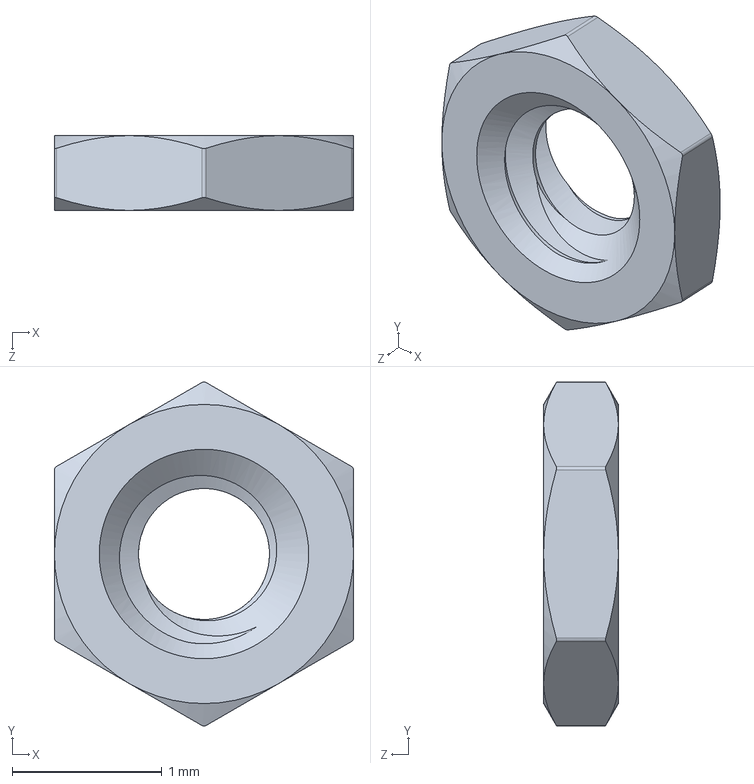
[picture p55: CAD file, 2026-10-13]
Parts/34_HexNut_DialNeedle.SLDPRT
2.00 x 2.30 x 0.5 mm
