Avi-Y-Goldstein/compression-jig-solidworks/Parts/33_MultiLayerBatterySample.SLDPRT

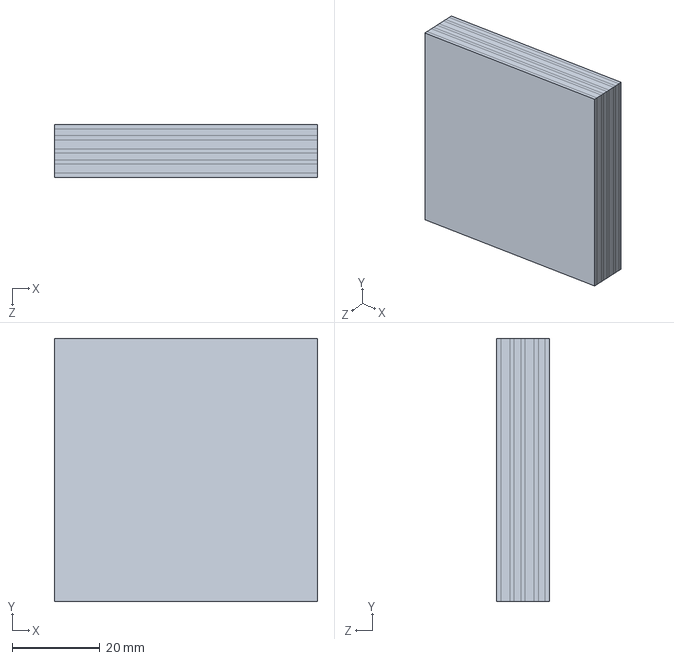
[picture p56: CAD file, 2026-10-13]
Parts/33_MultiLayerBatterySample.SLDPRT
60.0 x 60.0 x 12.0 mm
