Avi-Y-Goldstein/compression-jig-solidworks/Parts/27_UpperCompressionPlaten.SLDPRT

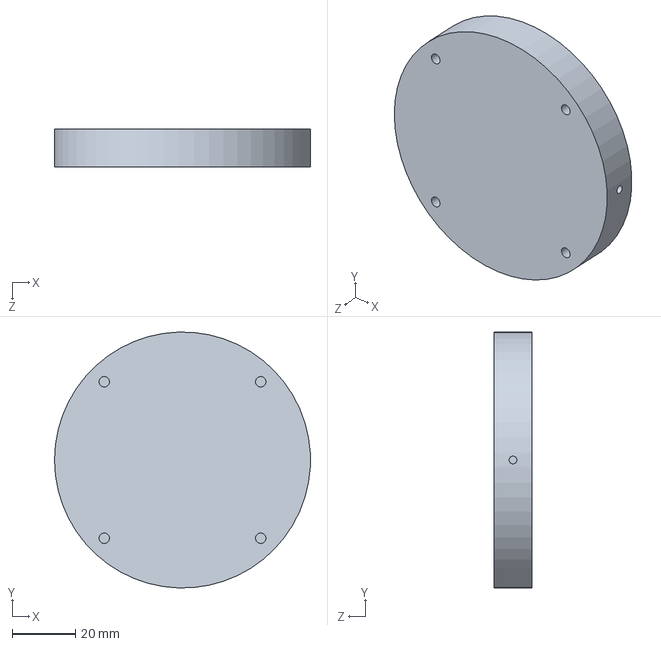
[picture p57: CAD file, 2026-10-13]
Parts/27_UpperCompressionPlaten.SLDPRT
81.0 x 81.0 x 12.0 mm
