Avi-Y-Goldstein/compression-jig-solidworks/Parts/02_Heavy_Base_Plate.SLDPRT

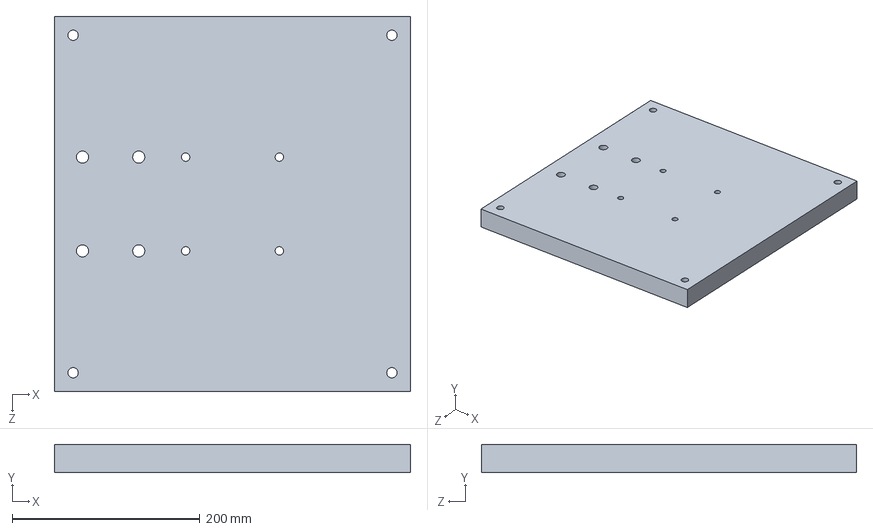
[picture p58: CAD file, 2026-10-13]
Parts/02_Heavy_Base_Plate.SLDPRT
380.0 x 30.0 x 400.0 mm
