Avi-Y-Goldstein/compression-jig-solidworks/Parts/34_ParallelKey_6x6x20_DIN6885.SLDPRT

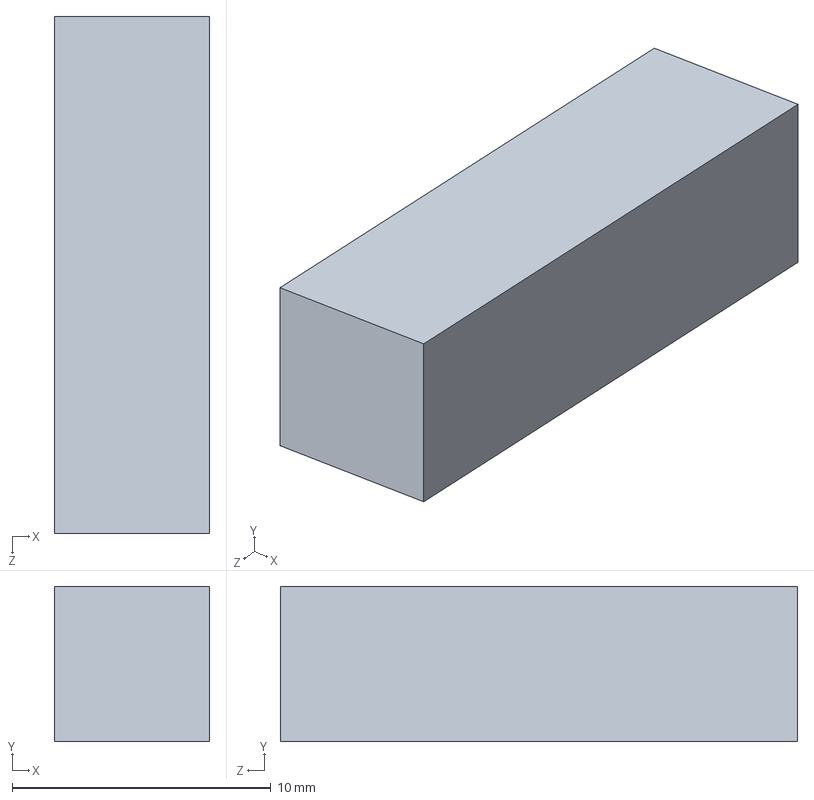
[picture p59: CAD file, 2026-10-13]
Parts/34_ParallelKey_6x6x20_DIN6885.SLDPRT
6.00 x 6.00 x 20.0 mm
