Avi-Y-Goldstein/compression-jig-solidworks/Parts/34_SHCS_M3x8_ISO4762.SLDPRT

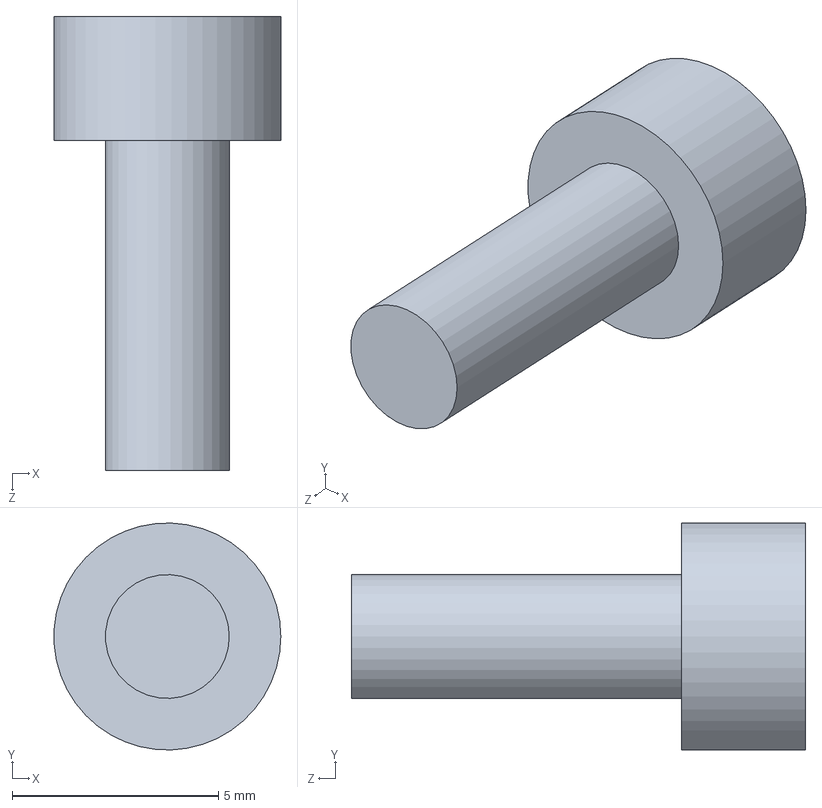
[picture p60: CAD file, 2026-10-13]
Parts/34_SHCS_M3x8_ISO4762.SLDPRT
5.49 x 5.50 x 11.0 mm
