Avi-Y-Goldstein/compression-jig-solidworks/SUB_RatchetDrive.SLDASM

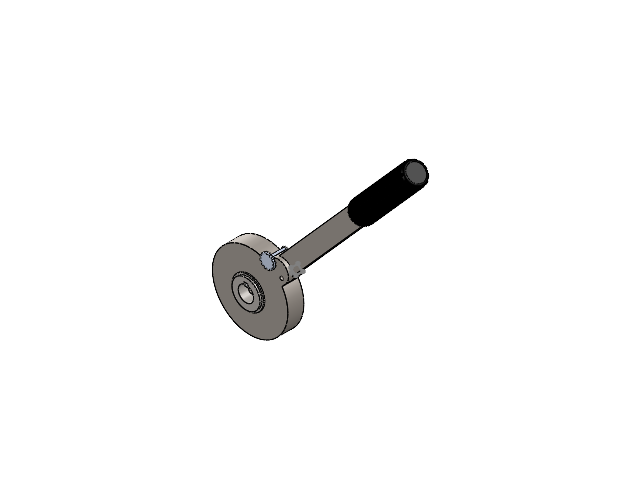
[picture p61: CAD file, 2026-10-13]
SUB_RatchetDrive.SLDASM
19_RatchetGearHub
18_RatchetingLeverArm
20_SpringLoadedPawl
21_PawlSelectionSwitch
35_RetainingRing_8x0.8_DIN471
22_LeverHandleGrip
34_SHCS_M8x16_ISO4762
34_ParallelKey_6x6x20_DIN6885
34_PawlPivotPin_4.5x18.5
34_Washer_8.4x24x2_DIN9021
35_Circlip_40x1.75_DIN471
