Avi-Y-Goldstein/compression-jig-solidworks/(list of files, cad)

Other CAD files:
Parts/29_RightGuideBar.SLDPRT
Drawings/01_Main_Frame_Body.SLDDRW
Drawings/02_Heavy_Base_Plate.SLDDRW
Drawings/03_Anvil_Pedestal.SLDDRW
Drawings/04_LowerRamGuideBlock.SLDDRW
Drawings/05_UpperRamGuideBlock.SLDDRW
Drawings/06_Left_Safety_Shield.SLDDRW
Drawings/07_RightSafetyShield.SLDDRW
Drawings/08_ShieldMountingBracket.SLDDRW
Drawings/09_WaveSpring.SLDDRW
Drawings/10_DialBackplate.SLDDRW
Drawings/11_DialBezel.SLDDRW
Drawings/12_DialNeedle.SLDDRW
Drawings/13_PinionGear.SLDDRW
Drawings/14_DialRack.SLDDRW
Drawings/15_LoadPlate.SLDDRW
Drawings/16_BaseFeet.SLDDRW
Drawings/17_ThreadedLeadScrew.SLDDRW
Drawings/18_RatchetingLeverArm.SLDDRW
Drawings/19_RatchetGearHub.SLDDRW
Drawings/20_SpringLoadedPawl.SLDDRW
Drawings/21_PawlSelectionSwitch.SLDDRW
Drawings/22_LeverHandleGrip.SLDDRW
Drawings/23_RamCollar.SLDDRW
Drawings/24_MainCompressionRam.SLDDRW
Drawings/25_ThrustWasher.SLDDRW
Drawings/26_UpperPlatenInsulator.SLDDRW
Drawings/27_UpperCompressionPlaten.SLDDRW
Drawings/28_LeftGuideBar.SLDDRW
Drawings/29_RightGuideBar.SLDDRW
Drawings/30_LowerInsulatingBaseBlock.SLDDRW
Drawings/31_LowerCompressionPlaten.SLDDRW
Drawings/32_TerminalContactBlock.SLDDRW
Drawings/33_MultiLayerBatterySample.SLDDRW
Drawings/34_ButtonHeadScrew_M5x10_ISO7380.SLDDRW
Drawings/34_CheeseHeadScrew_DialNeedle.SLDDRW
Drawings/34_DowelPin_6x72_ISO2338.SLDDRW
Drawings/34_GreaseFitting_M6_DIN71412.SLDDRW
Drawings/34_HexNut_DialNeedle.SLDDRW
Drawings/34_Magnet_D10x5_N42.SLDDRW
Drawings/34_ParallelKey_6x6x20_DIN6885.SLDDRW
Drawings/34_PawlPivotPin_4.5x18.5.SLDDRW
Drawings/34_SHCS_M12x45_ISO4762.SLDDRW
Drawings/34_SHCS_M3x8_ISO4762.SLDDRW
Drawings/34_SHCS_M4x12_ISO4762.SLDDRW
Drawings/34_SHCS_M4x20_ISO4762.SLDDRW
Drawings/34_SHCS_M4x25_ISO4762.SLDDRW
Drawings/34_SHCS_M6x16_ISO4762.SLDDRW
Drawings/34_SHCS_M8x16_ISO4762.SLDDRW
Drawings/34_SHCS_M8x20_ISO4762.SLDDRW
Drawings/34_SHCS_M8x40_ISO4762.SLDDRW
Drawings/34_SHCS_M8x80_ISO4762.SLDDRW
Drawings/34_SHCS_M8x90_ISO4762.SLDDRW
Drawings/34_Washer_8.4x24x2_DIN9021.SLDDRW
Drawings/35_Circlip_40x1.75_DIN471.SLDDRW
Drawings/35_Circlip_46x1.75_DIN472.SLDDRW
Drawings/35_RetainingRing_8x0.8_DIN471.SLDDRW
Drawings/36_DialFoot.SLDDRW
Drawings/37_DialPin.SLDDRW
Drawings/38_GuideStopPin.SLDDRW
Parts/17_ThreadedLeadScrew.SLDPRT
Parts/25_ThrustWasher.SLDPRT
Parts/34_ButtonHeadScrew_M5x10_ISO7380.SLDPRT
Parts/34_CheeseHeadScrew_DialNeedle.SLDPRT
Parts/34_Washer_8.4x24x2_DIN9021.SLDPRT
