Avi-Y-Goldstein/compression-jig-solidworks/CompressionJig_Drawings.pdf

E | E
F | F

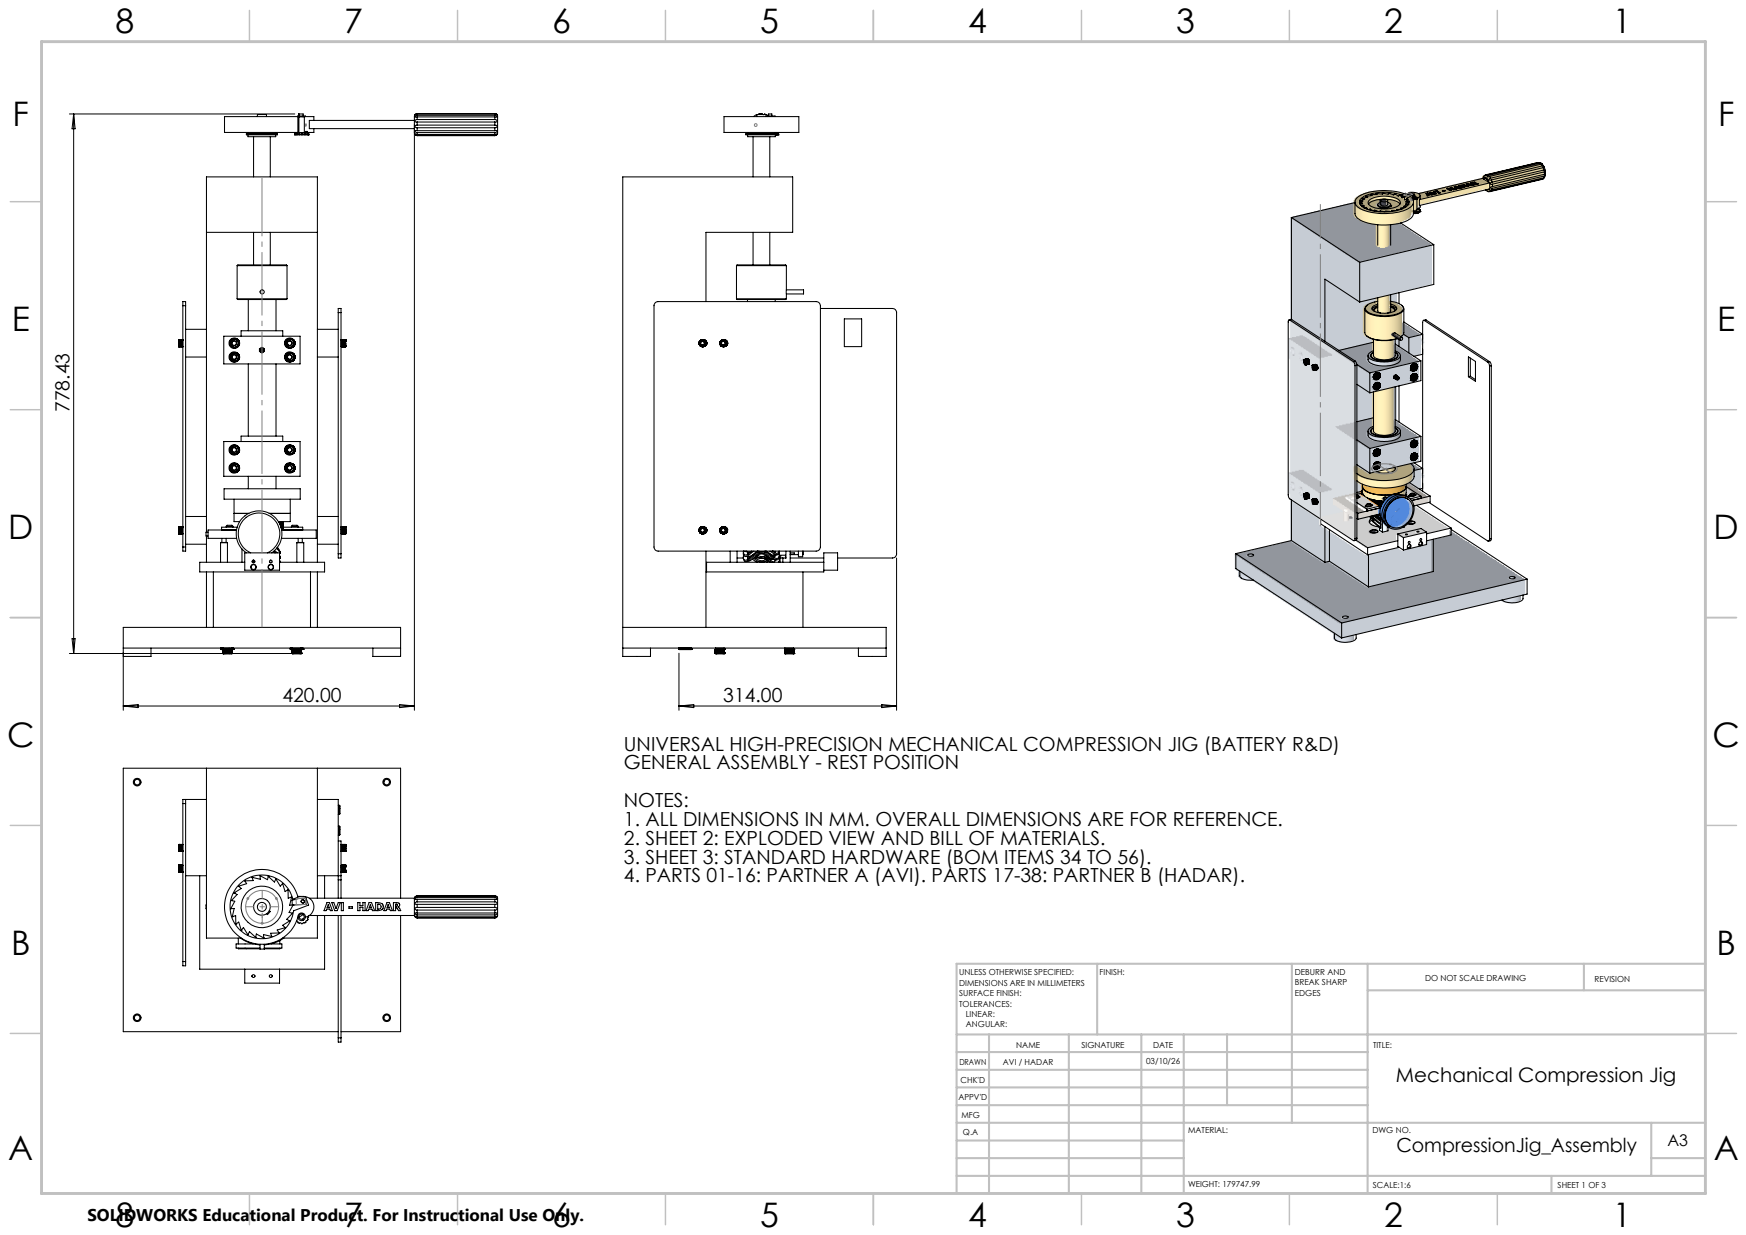
[picture p62: page 1]
FINISH:; DEBURR AND; BREAK SHARP EDGES; DO NOT SCALE DRAWING; REVISION; SCALE:1:6; SHEET 1 OF 3; WEIGHT: 179747.99

UNIVERSAL HIGH-PRECISION MECHANICAL COMPRESSION JIG (BATTERY R&D)
GENERAL ASSEMBLY - REST POSITION
NOTES:
1. ALL DIMENSIONS IN MM. OVERALL DIMENSIONS ARE FOR REFERENCE.
2. SHEET 2: EXPLODED VIEW AND BILL OF MATERIALS.
3. SHEET 3: STANDARD HARDWARE (BOM ITEMS 34 TO 56).
4. PARTS 01-16: PARTNER A (AVI). PARTS 17-38: PARTNER B (HADAR).

UNLESS OTHERWISE SPECIFIED:
DIMENSIONS ARE IN MILLIMETERS
SURFACE FINISH:
TOLERANCES:
LINEAR:
ANGULAR:

NAME | SIGNATURE | DATE | | | | TITLE: Mechanical Compression Jig

DRAWN | AVI / HADAR | | 03/10/26
CHK'D
APPV'D
MFG
Q.A | | | | MATERIAL: | DWG NO. CompressionJig_Assembly | A3

SOLIDWORKS Educational Product. For Instructional Use Only.

54 | 18 | 19 | 53 | 48 | 41 | 56 | 20 | 21

55

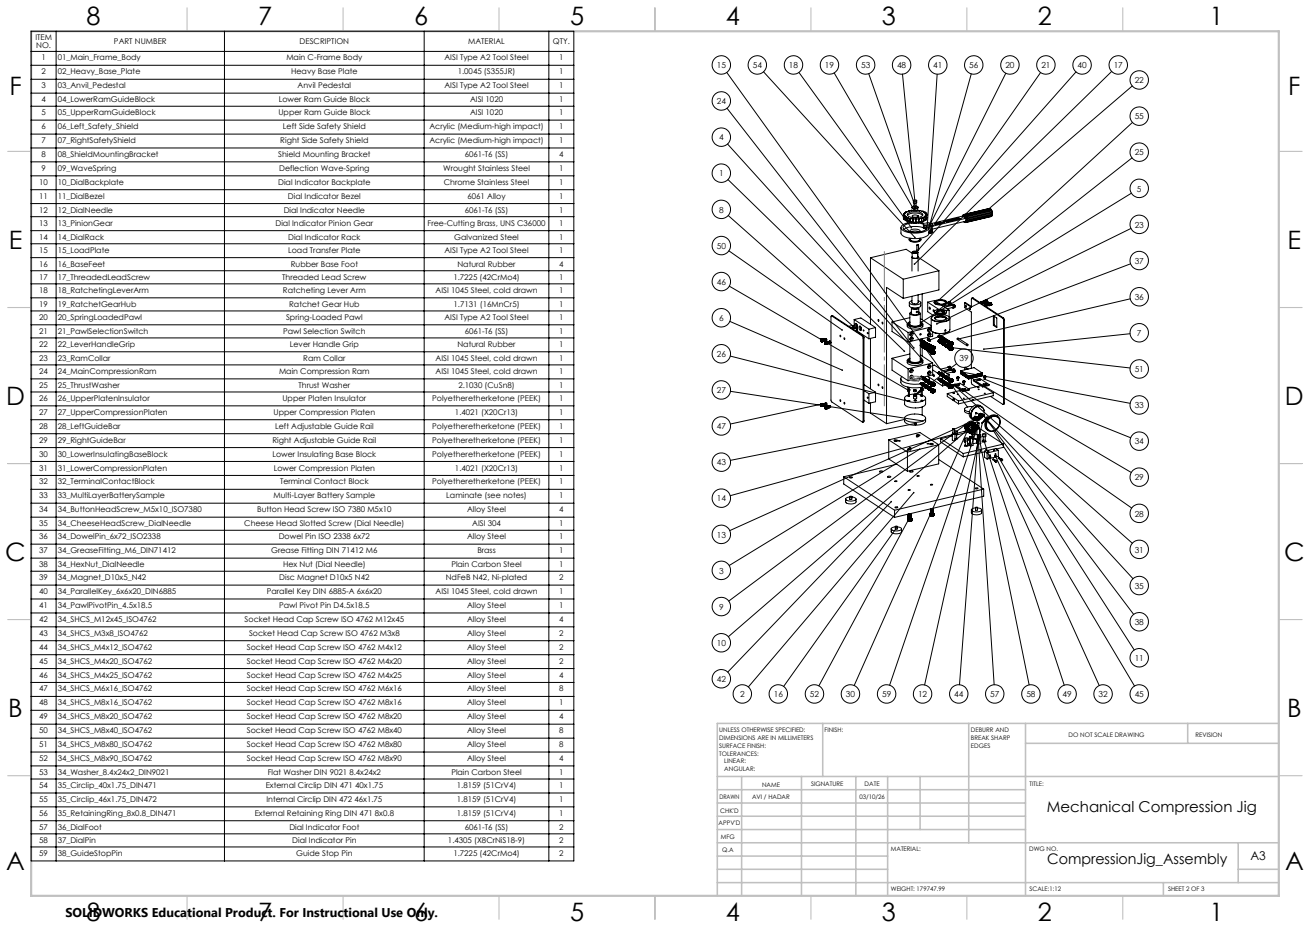
[picture p63: page 2]
ITEM; PART NUMBER; DESCRIPTION; MATERIAL; QTY.; 1 01_Main_Frame_Body; Main C-Frame Body; AISI Type A2 Tool Steel; 2 02_Heavy_Base_Plate; Heavy Base Plate; 3 03_Anvil_Pedestal; Anvil Pedestal; 4 04_LowerRamGuideBlock; Lower Ram Guide Block; AISI 1020; 5 05_UpperRamGuideBlock; Upper Ram Guide Block; 6 06_Left_Safety_Shield; Left Side Safety Shield; Acrylic (Medium-high impact); 7 07_RightSafetyShield; Right Side Safety Shield; 8 08_ShieldMountingBracket; Shield Mounting Bracket; 9 09_WaveSpring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

UNLESS OTHERWISE SPECIFIED:
DIMENSIONS ARE IN MILLIMETERS
SURFACE FINISH:
TOLERANCES:
LINEAR:
ANGULAR:

NAME | SIGNATURE | DATE | | | TITLE: Mechanical Compression Jig

DRAWN | AVI / HADAR | | 03/10/26
CHK'D
APPV'D
MFG

CompressionJig_Assembly | A3

## SOCKET HEAD CAP SCREW ISO 4762 M8x40

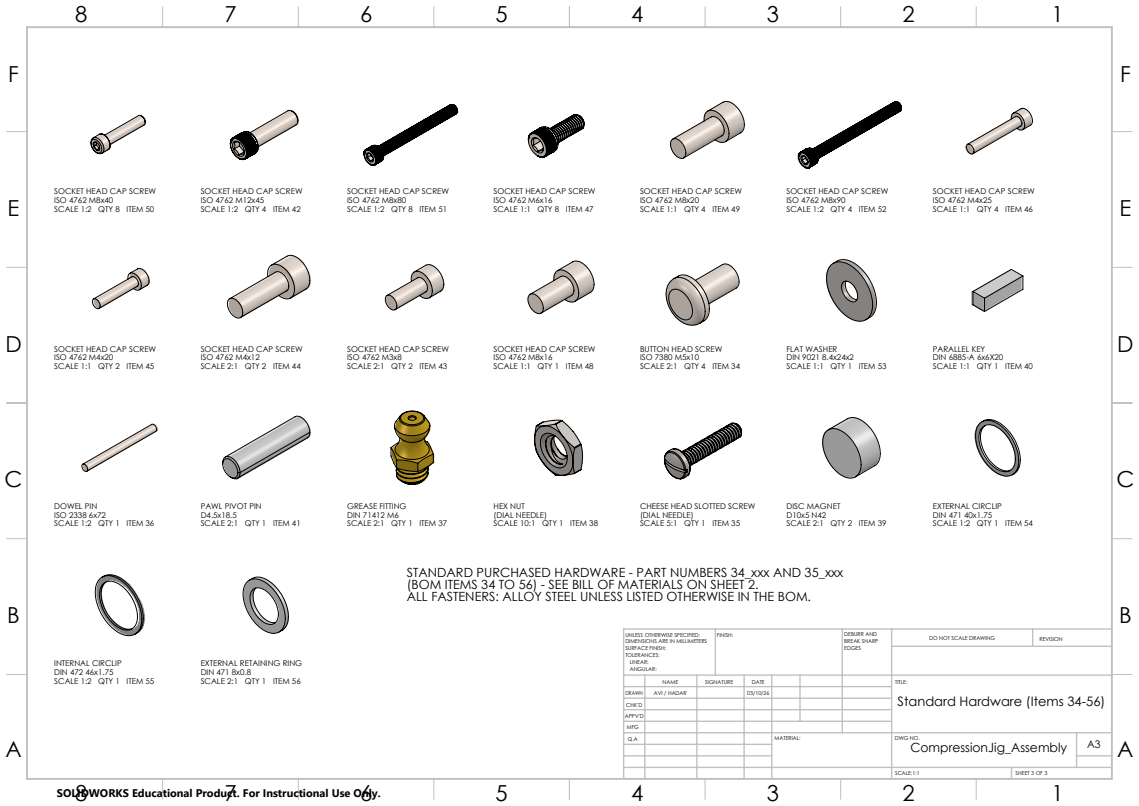
[picture p64: page 3]
FINISH:; DEBURR AND; BREAK SHARP EDGES; DO NOT SCALE DRAWING; REVISION; SCALE:1:1; SHEET 3 OF 3

SOCKET HEAD CAP SCREW
ISO 4762 M12x45
SCALE 1:2 QTY 4 ITEM 42

ISO 4762 M8x80
SCALE 1:2 QTY 8 ITEM 51

ISO 4762 M6x16
SCALE 1:1 QTY 8 ITEM 47

ISO 4762 M8x20
SCALE 1:1 QTY 4 ITEM 49

ISO 4762 M8x90
SCALE 1:2 QTY 4 ITEM 52

ISO 4762 M4x25
SCALE 1:1 QTY 4 ITEM 46

SCALE 1:2 QTY 8 ITEM 50

ISO 4762 M4x20
SCALE 1:1 QTY 2 ITEM 45

ISO 4762 M4x12
SCALE 2:1 QTY 2 ITEM 44

ISO 4762 M3x8
SCALE 2:1 QTY 2 ITEM 43

ISO 4762 M8x16
SCALE 1:1 QTY 1 ITEM 48

BUTTON HEAD SCREW
ISO 7380 M5x10
SCALE 2:1 QTY 4 ITEM 34

FLAT WASHER
DIN 9021 8.4x24x2
SCALE 1:1 QTY 1 ITEM 53

PARALLEL KEY
DIN 6885-A 6x6X20
SCALE 1:1 QTY 1 ITEM 40

DOWEL PIN
ISO 2338 6x72
SCALE 1:2 QTY 1 ITEM 36

PAWL PIVOT PIN
SCALE 2:1 QTY 1 ITEM 41

GREASE FITTING
DIN 71412 M6
SCALE 2:1 QTY 1 ITEM 37

HEX NUT
(DIAL NEEDLE)
SCALE 10:1 QTY 1 ITEM 38

CHEESE HEAD SLOTTED SCREW
SCALE 5:1 QTY 1 ITEM 35

DISC MAGNET
SCALE 2:1 QTY 2 ITEM 39

EXTERNAL CIRCLIP
DIN 471 40x1.75
SCALE 1:2 QTY 1 ITEM 54

STANDARD PURCHASED HARDWARE - PART NUMBERS 34_xxx AND 35_xxx
(BOM ITEMS 34 TO 56) - SEE BILL OF MATERIALS ON SHEET 2.
ALL FASTENERS: ALLOY STEEL UNLESS LISTED OTHERWISE IN THE BOM.

UNLESS OTHERWISE SPECIFIED:
DIMENSIONS ARE IN MILLIMETERS
SURFACE FINISH:
TOLERANCES:
LINEAR:
ANGULAR:

INTERNAL CIRCLIP
DIN 472 46x1.75
SCALE 1:2 QTY 1 ITEM 55

EXTERNAL RETAINING RING
DIN 471 8x0.8
SCALE 2:1 QTY 1 ITEM 56

NAME | SIGNATURE | DATE | | | TITLE: Standard Hardware (Items 34-56)

DRAWN | AVI / HADAR | | 03/10/26
CHK'D
APPV'D
MFG

CompressionJig_Assembly | A3

# 20.50 THRU ALL 45.00

80.00

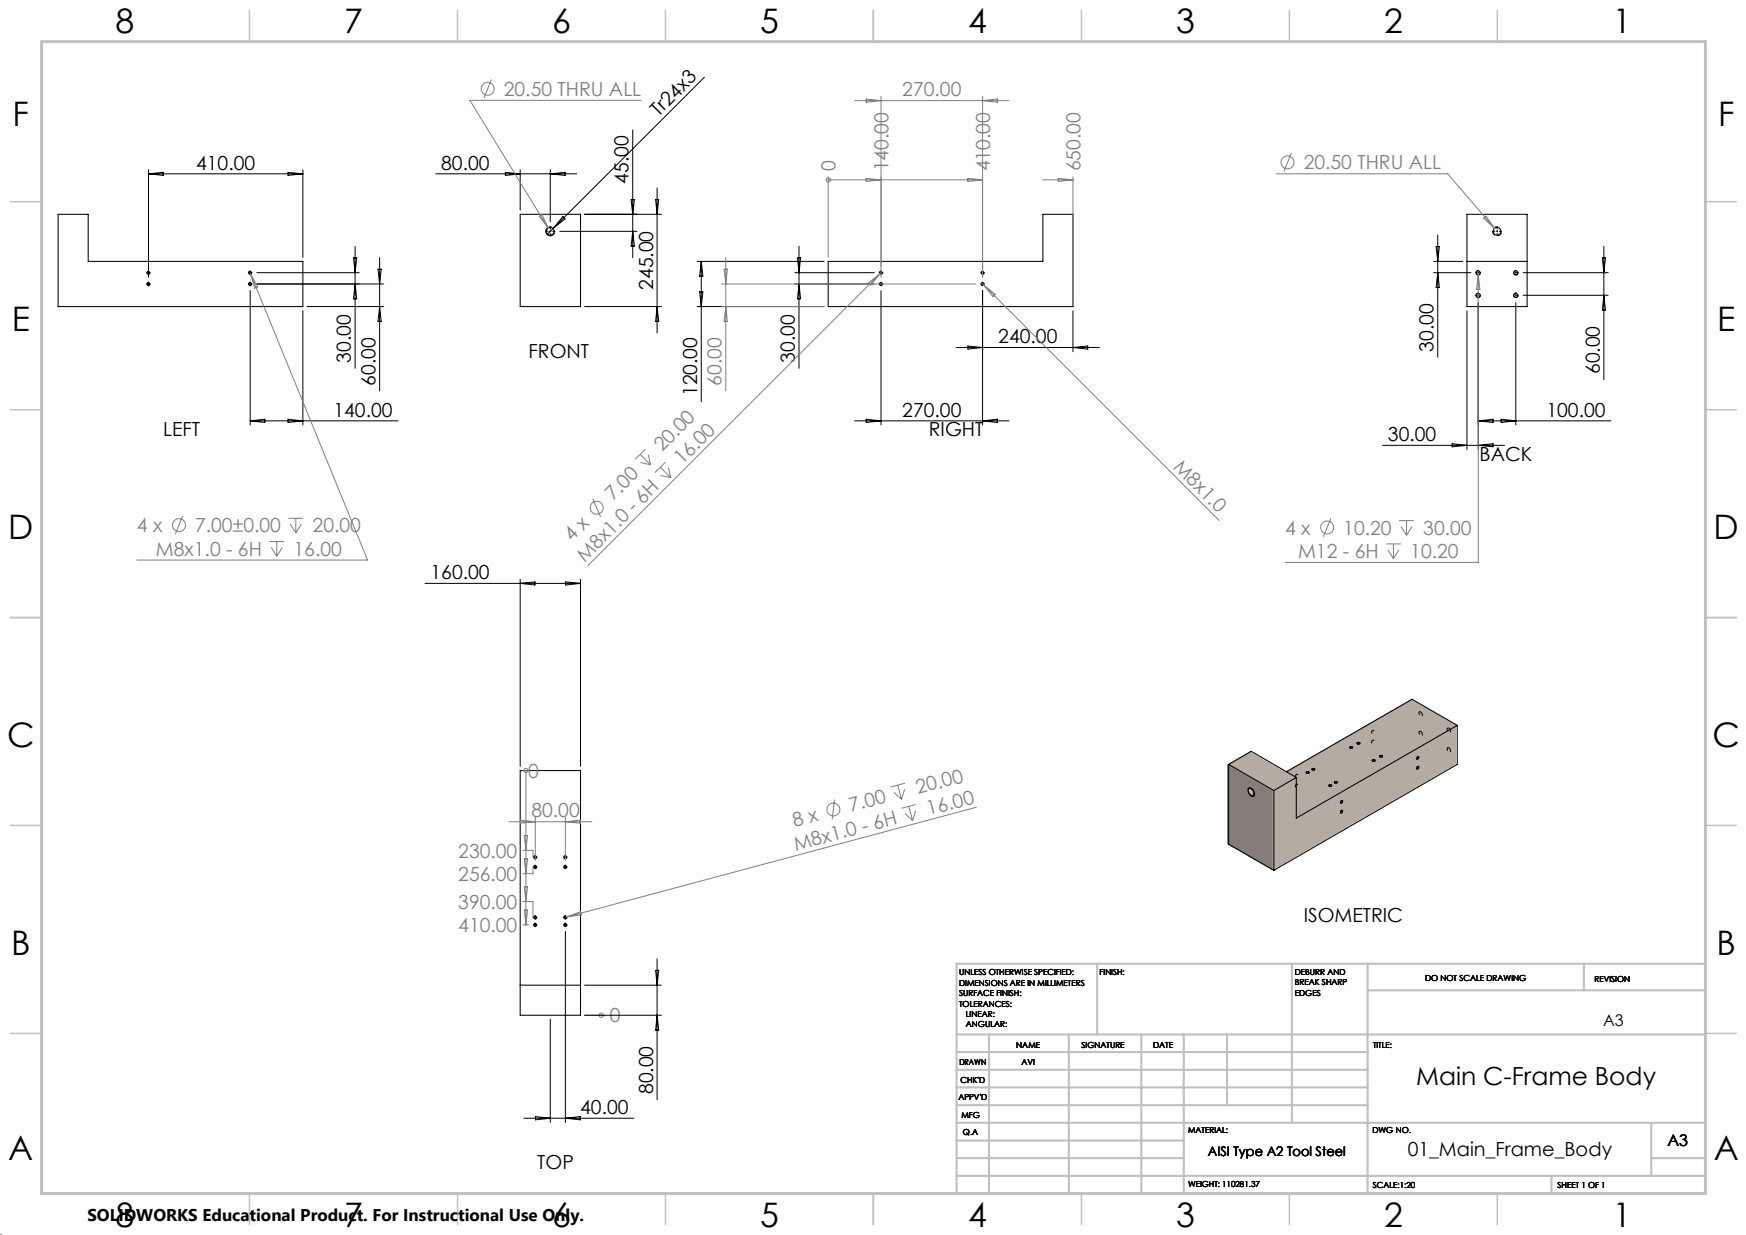
[picture p65: page 4]
FRONT; TOP; RIGHT; LEFT; 20.50 THRU ALL 30.00; BACK; ISOMETRIC; FINISH:; DEBURR AND; BREAK SHARP EDGES; DO NOT SCALE DRAWING; REVISION

UNLESS OTHERWISE SPECIFIED:
DIMENSIONS ARE IN MILLIMETERS
SURFACE FINISH:
TOLERANCES:
LINEAR:
ANGULAR:

NAME NAME NAME NAME NAME | SIGNATURE SIGNATURE SIGNATURE SIGNATURE SIGNATURE | DATE DATE DATE DATE DATE | | | | TITLE: TITLE: TITLE: TITLE: TITLE: Main C-Frame Body

DRAWN DRAWN DRAWN DRAWN DRAWN | AVI AVI AVI AVI AVI
CHK'D CHK'D CHK'D CHK'D CHK'D
APPV'D APPV'D APPV'D APPV'D APPV'D
MFG MFG MFG MFG MFG

AISI Type A2 Tool Steel | 01_Main_Frame_Body | A3 AISI Type A2 Tool Steel A3 AISI Type A2 Tool Steel

WEIGHT: 110281.37 WEIGHT: 110281.37 WEIGHT: 110281.37 WEIGHT: 110281.37 WEIGHT: 110281.37 | SCALE:1:20 SCALE:1:20 SCALE:1:20 SCALE:1:20 SCALE:1:20 | SHEET 1 OF 1 SHEET 1 OF 1 SHEET 1 OF 1 SHEET 1 OF 1 SHEET 1 OF 1

250.00
E | E

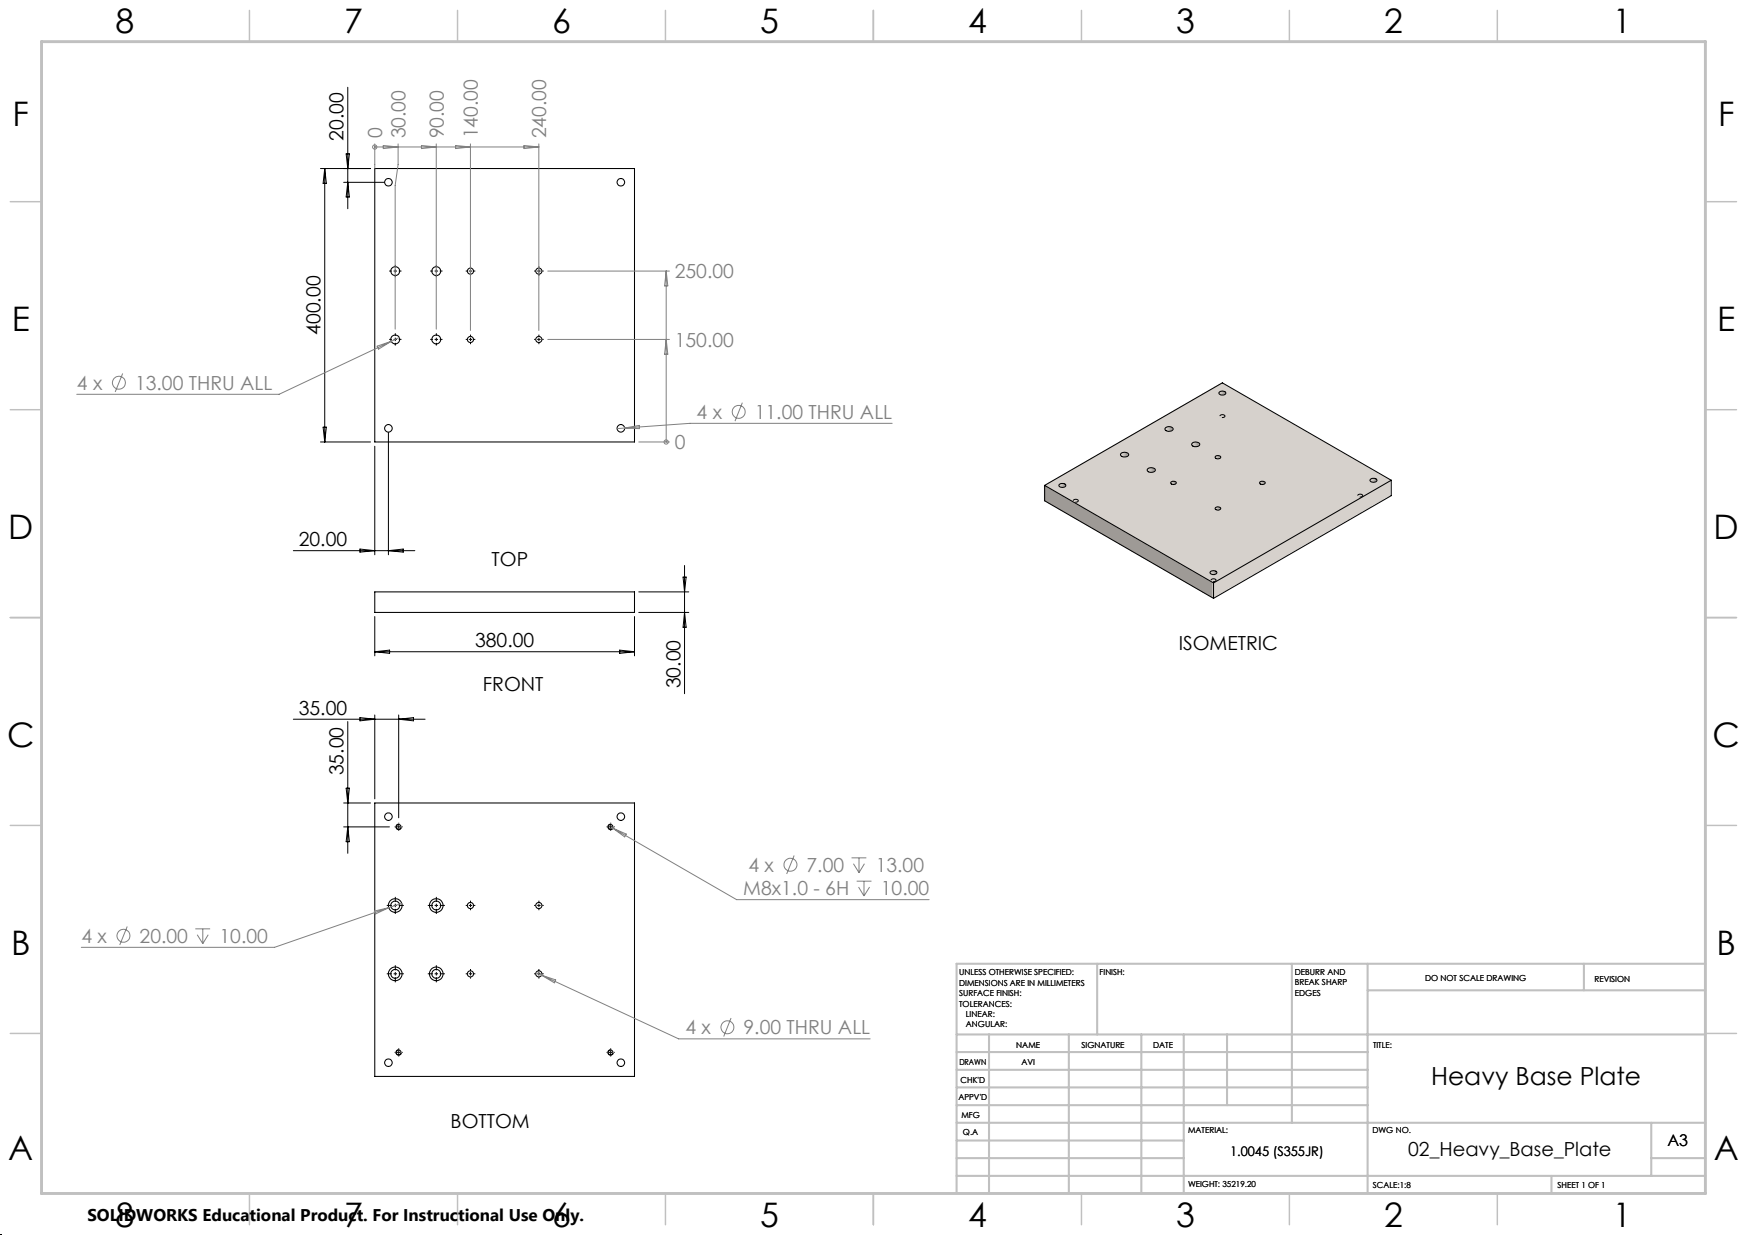
[picture p66: page 5]
FRONT; 13.00 THRU ALL; 11.00 THRU ALL; TOP; 9.00 THRU ALL; BOTTOM; ISOMETRIC; FINISH:; DEBURR AND; BREAK SHARP EDGES; DO NOT SCALE DRAWING; REVISION

UNLESS OTHERWISE SPECIFIED:
DIMENSIONS ARE IN MILLIMETERS
SURFACE FINISH:
TOLERANCES:
LINEAR:
ANGULAR:

NAME | SIGNATURE | DATE | | | | TITLE: TITLE: Heavy Base Plate

DRAWN | AVI
CHK'D
APPV'D
MFG

02_Heavy_Base_Plate | A3 1.0045 (S355JR)

WEIGHT: 35219.20 | SCALE:1:8 | SHEET 1 OF 1

80.00

# 4 x 9.00 THRU ALL

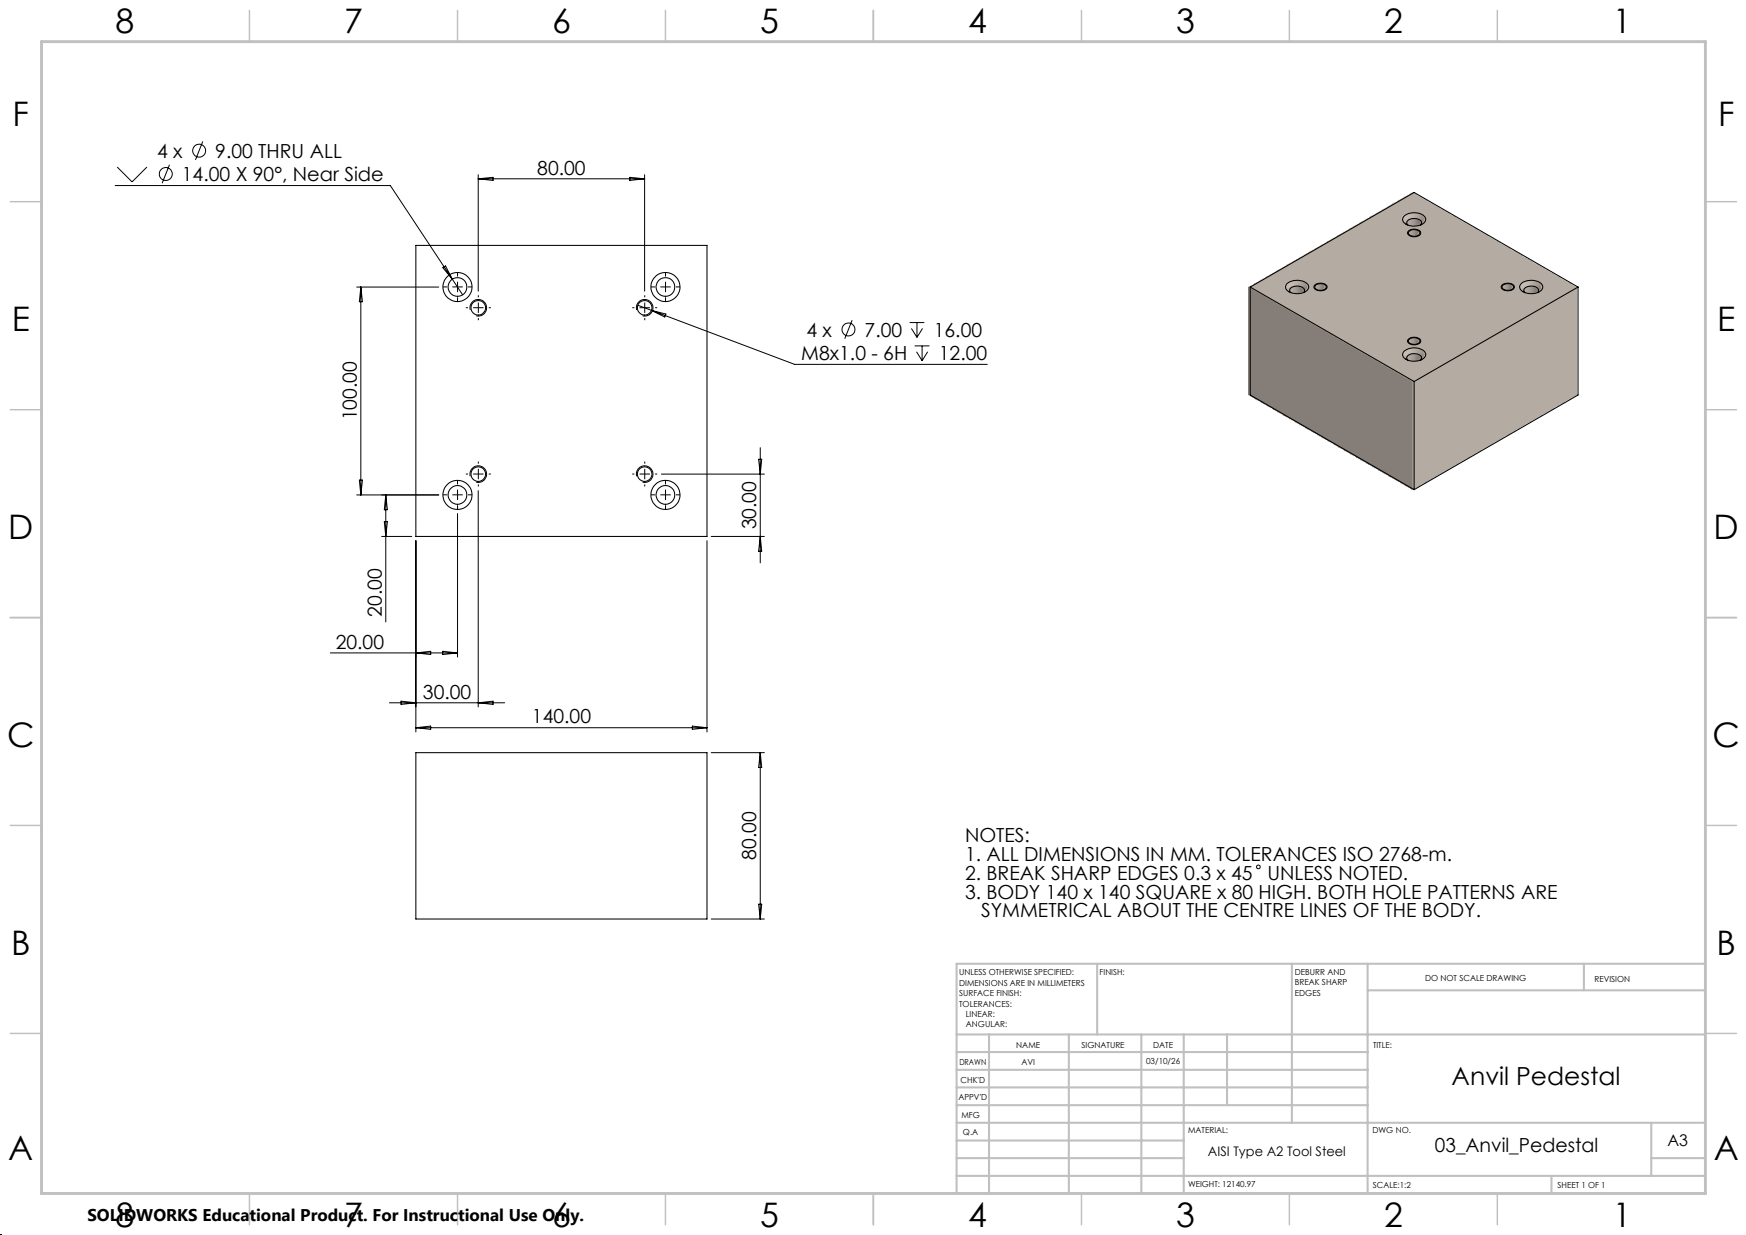
[picture p67: page 6]
20.00 ¹⁰⁰.00 20.00; 14.00 X 90°, Near Side; FINISH:; DEBURR AND; BREAK SHARP EDGES; DO NOT SCALE DRAWING; REVISION

NOTES:
1. ALL DIMENSIONS IN MM. TOLERANCES ISO 2768-m.
2. BREAK SHARP EDGES 0.3 x 45 UNLESS NOTED.
3. BODY 140 x 140 SQUARE x 80 HIGH. BOTH HOLE PATTERNS ARE
SYMMETRICAL ABOUT THE CENTRE LINES OF THE BODY.

UNLESS OTHERWISE SPECIFIED:
DIMENSIONS ARE IN MILLIMETERS
SURFACE FINISH:
TOLERANCES:
LINEAR:
ANGULAR:

NAME | SIGNATURE | DATE | | | | TITLE: Anvil Pedestal

DRAWN | AVI | | 03/10/26
CHK'D
APPV'D
MFG

03_Anvil_Pedestal | A3 AISI Type A2 Tool Steel

WEIGHT: 12140.97 | SCALE:1:2 | SHEET 1 OF 1

40.00

H7

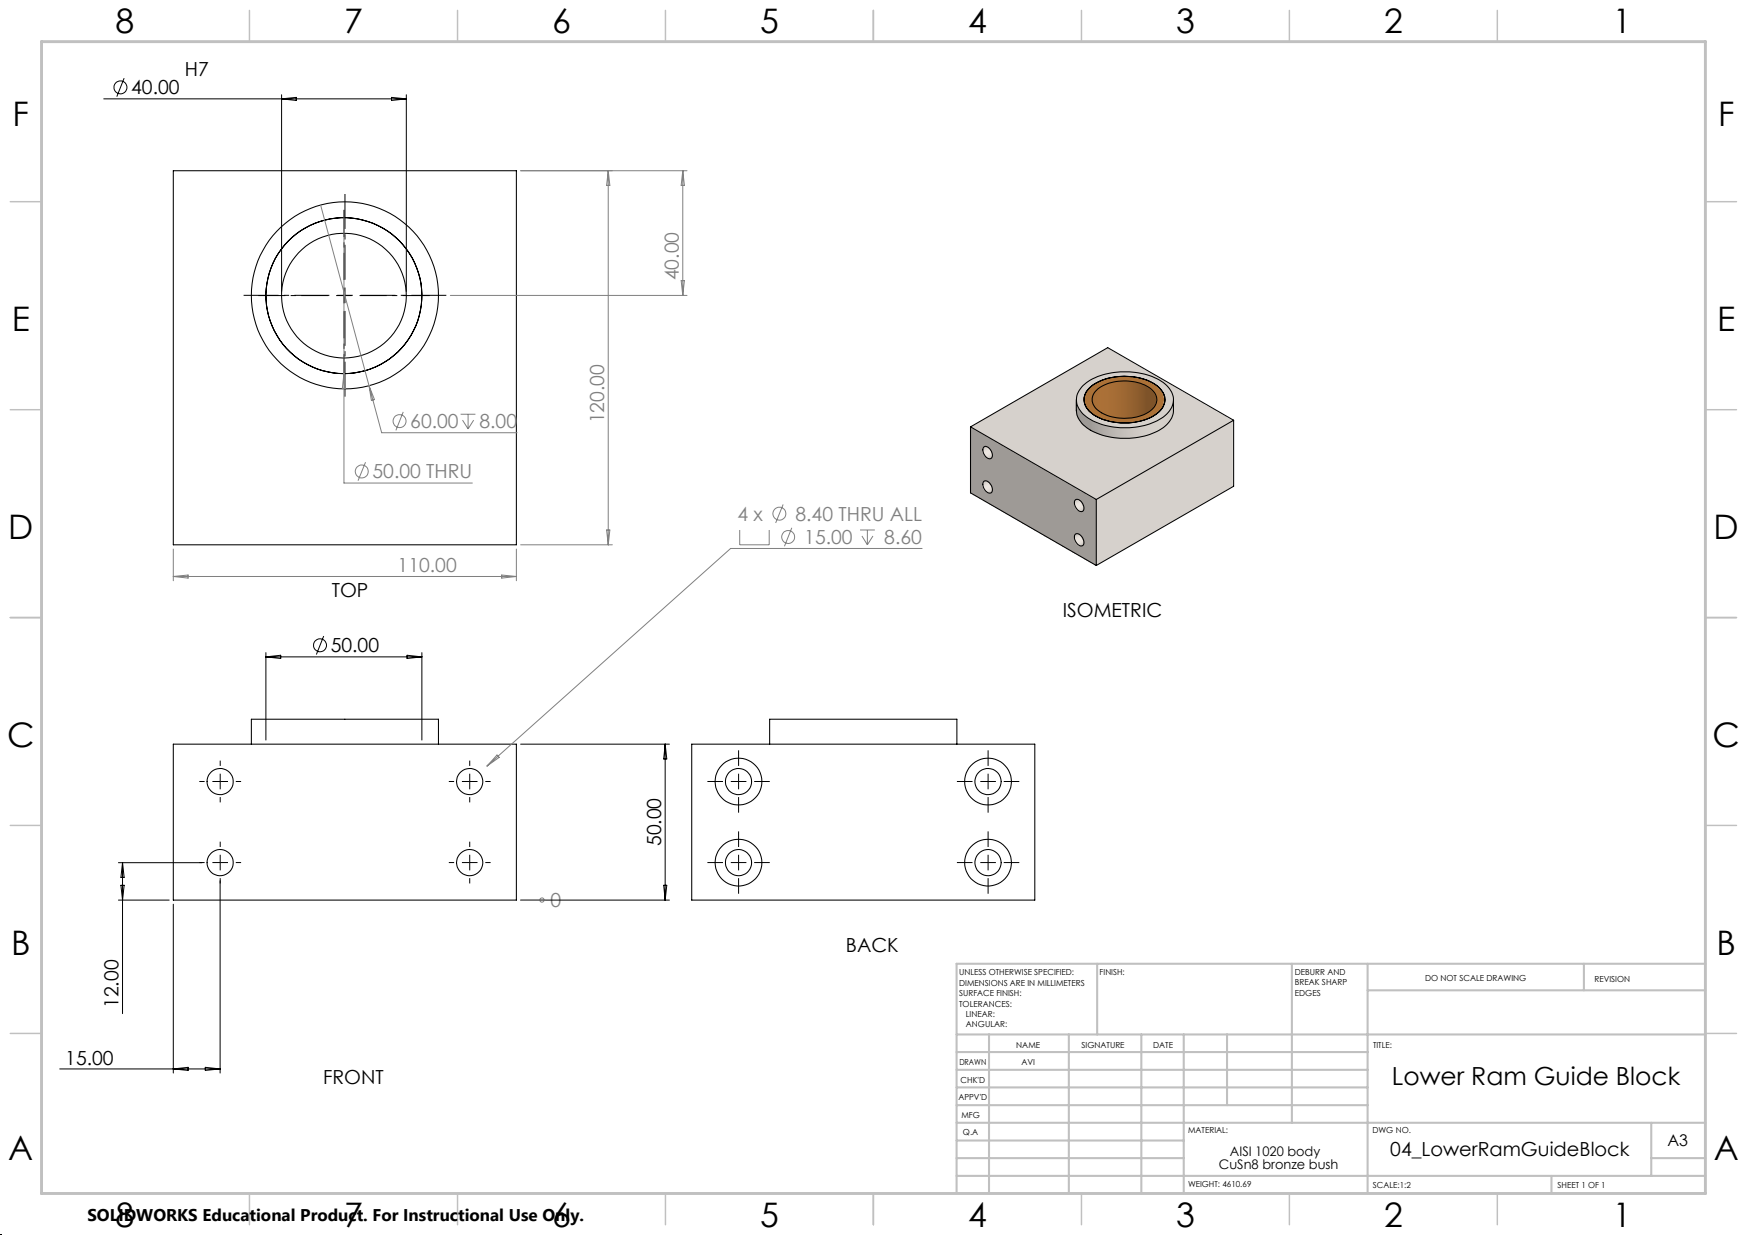
[picture p68: page 7]
8.40 THRU ALL; FRONT; 50.00 THRU; TOP; BACK; ISOMETRIC; 04_LowerRamGuideBlock; FINISH:; DEBURR AND; BREAK SHARP EDGES; DO NOT SCALE DRAWING; REVISION

UNLESS OTHERWISE SPECIFIED:
DIMENSIONS ARE IN MILLIMETERS
SURFACE FINISH:
TOLERANCES:
LINEAR:
ANGULAR:

NAME | SIGNATURE | DATE | | | | TITLE: Lower Ram Guide Block

DRAWN | AVI
CHK'D
APPV'D
MFG

CuSn8 bronze bush | | A3 AISI 1020 body

WEIGHT: 4610.69 | SCALE:1:2 | SHEET 1 OF 1

50.00

15.00

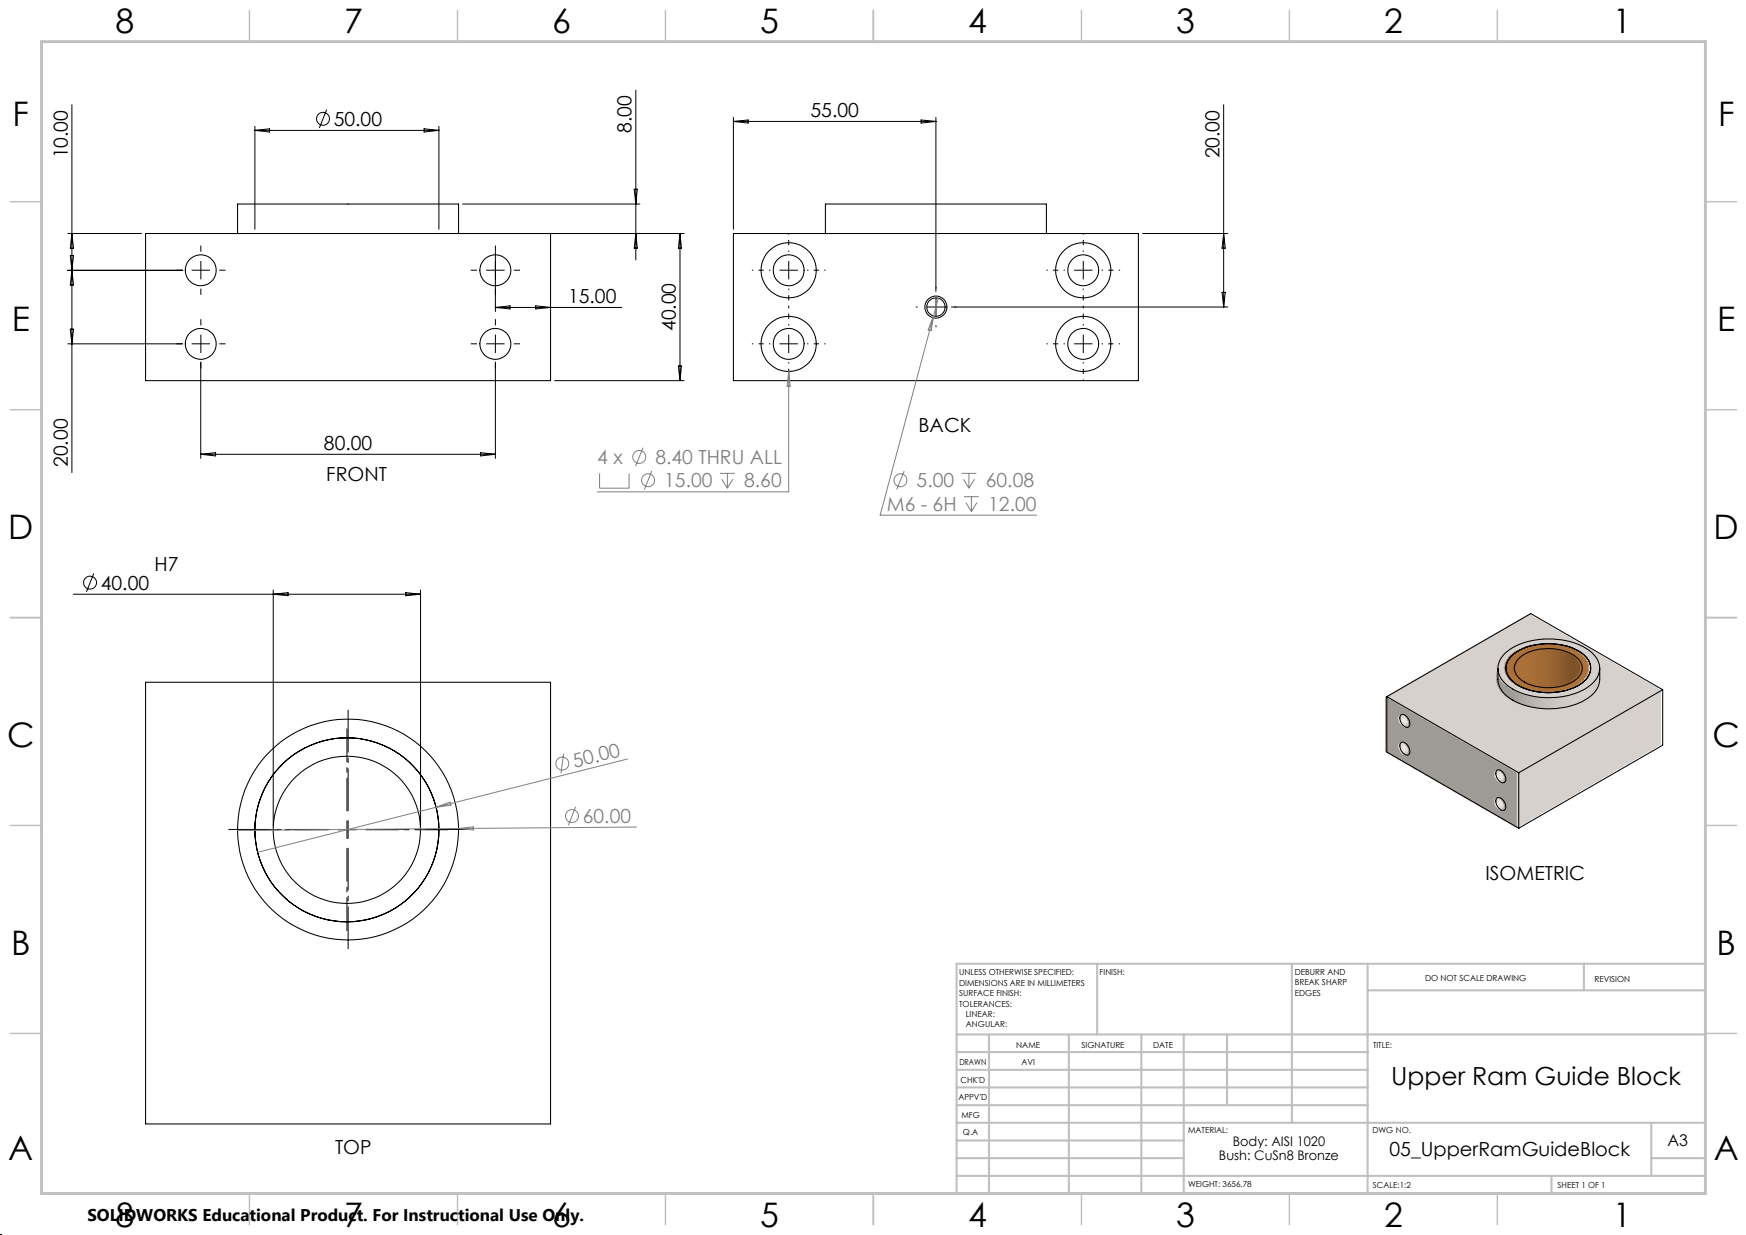
[picture p69: page 8]
FRONT; TOP; 8.40 THRU ALL; BACK; ISOMETRIC; 05_UpperRamGuideBlock; FINISH:; DEBURR AND; BREAK SHARP EDGES; DO NOT SCALE DRAWING; REVISION; SCALE:1:2; SHEET 1 OF 1; WEIGHT: 3656.78

UNLESS OTHERWISE SPECIFIED:
DIMENSIONS ARE IN MILLIMETERS
SURFACE FINISH:
TOLERANCES:
LINEAR:
ANGULAR:

NAME | SIGNATURE | DATE | | | TITLE: Upper Ram Guide Block

DRAWN | AVI
CHK'D
APPV'D
MFG

Body: AISI 1020 Bush: CuSn8 Bronze | A3

E | E
F | F

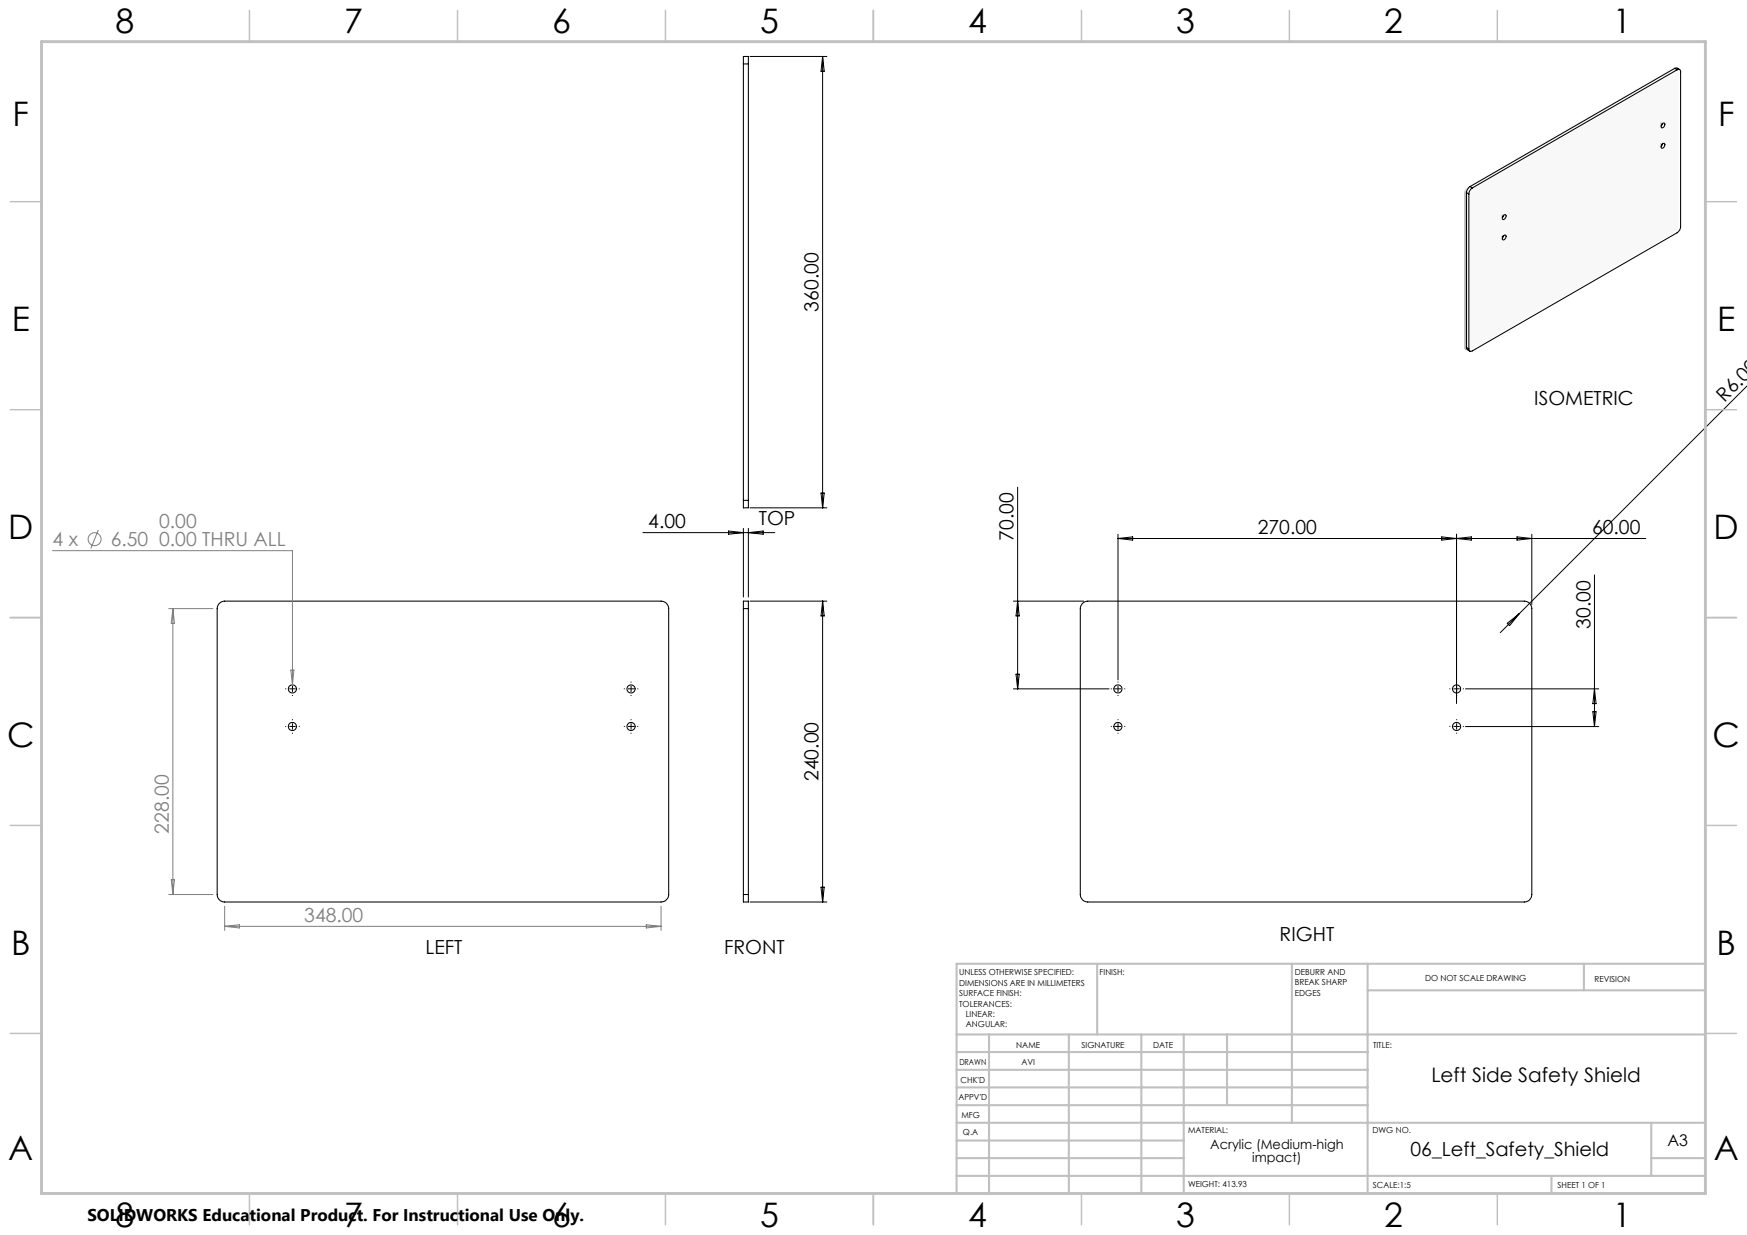
[picture p70: page 9]
FRONT; TOP; RIGHT; 0.00 0.00 THRU ALL 228.00; LEFT; ISOMETRIC; 06_Left_Safety_Shield; FINISH:; DEBURR AND; BREAK SHARP EDGES; DO NOT SCALE DRAWING; REVISION; SCALE:1:5; SHEET 1 OF 1; WEIGHT: 413.93

UNLESS OTHERWISE SPECIFIED:
DIMENSIONS ARE IN MILLIMETERS
SURFACE FINISH:
TOLERANCES:
LINEAR:
ANGULAR:

NAME | SIGNATURE | DATE | | | TITLE: Left Side Safety Shield

DRAWN | AVI
CHK'D
APPV'D
MFG

Acrylic (Medium-high impact) | A3

4.00
15.00

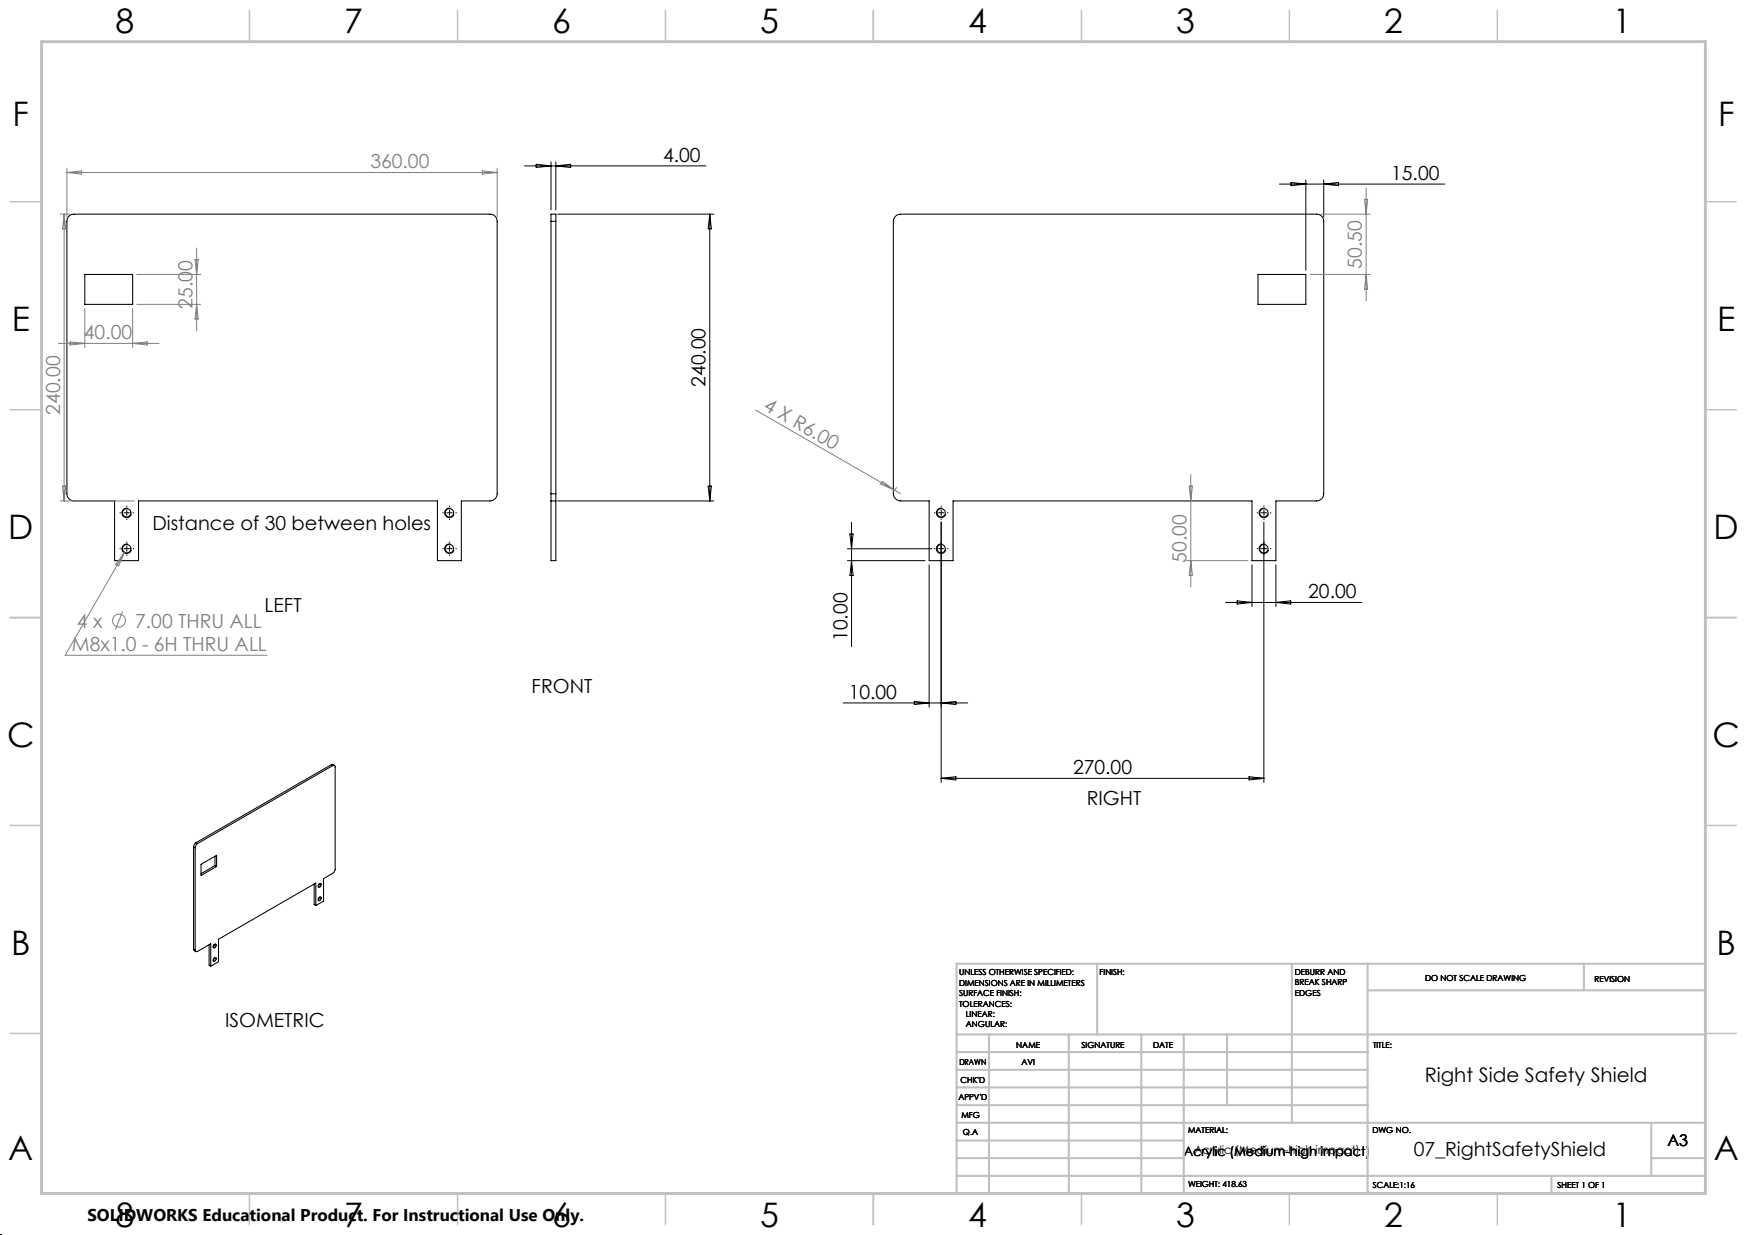
[picture p71: page 10]
FRONT; RIGHT; 7.00 THRU ALL; M8x1.0 - 6H THRU ALL; LEFT; ISOMETRIC; FINISH:; DEBURR AND; BREAK SHARP EDGES; DO NOT SCALE DRAWING; REVISION

Distance of 30 between holes

UNLESS OTHERWISE SPECIFIED:
DIMENSIONS ARE IN MILLIMETERS
SURFACE FINISH:
TOLERANCES:
LINEAR:
ANGULAR:

NAME NAME | SIGNATURE SIGNATURE | DATE DATE | | | | TITLE: TITLE: TITLE: TITLE: Right Side Safety Shield

DRAWN DRAWN | AVI AVI
CHK'D CHK'D
APPV'D APPV'D
MFG MFG

07_RightSafetyShield | A3 Acrylic (Medium-high impact) A3 Acrylic (Medium-high impact)

WEIGHT: 418.63 WEIGHT: 418.63 | SCALE:1:16 SCALE:1:16 | SHEET 1 OF 1 SHEET 1 OF 1

110.00

E | E

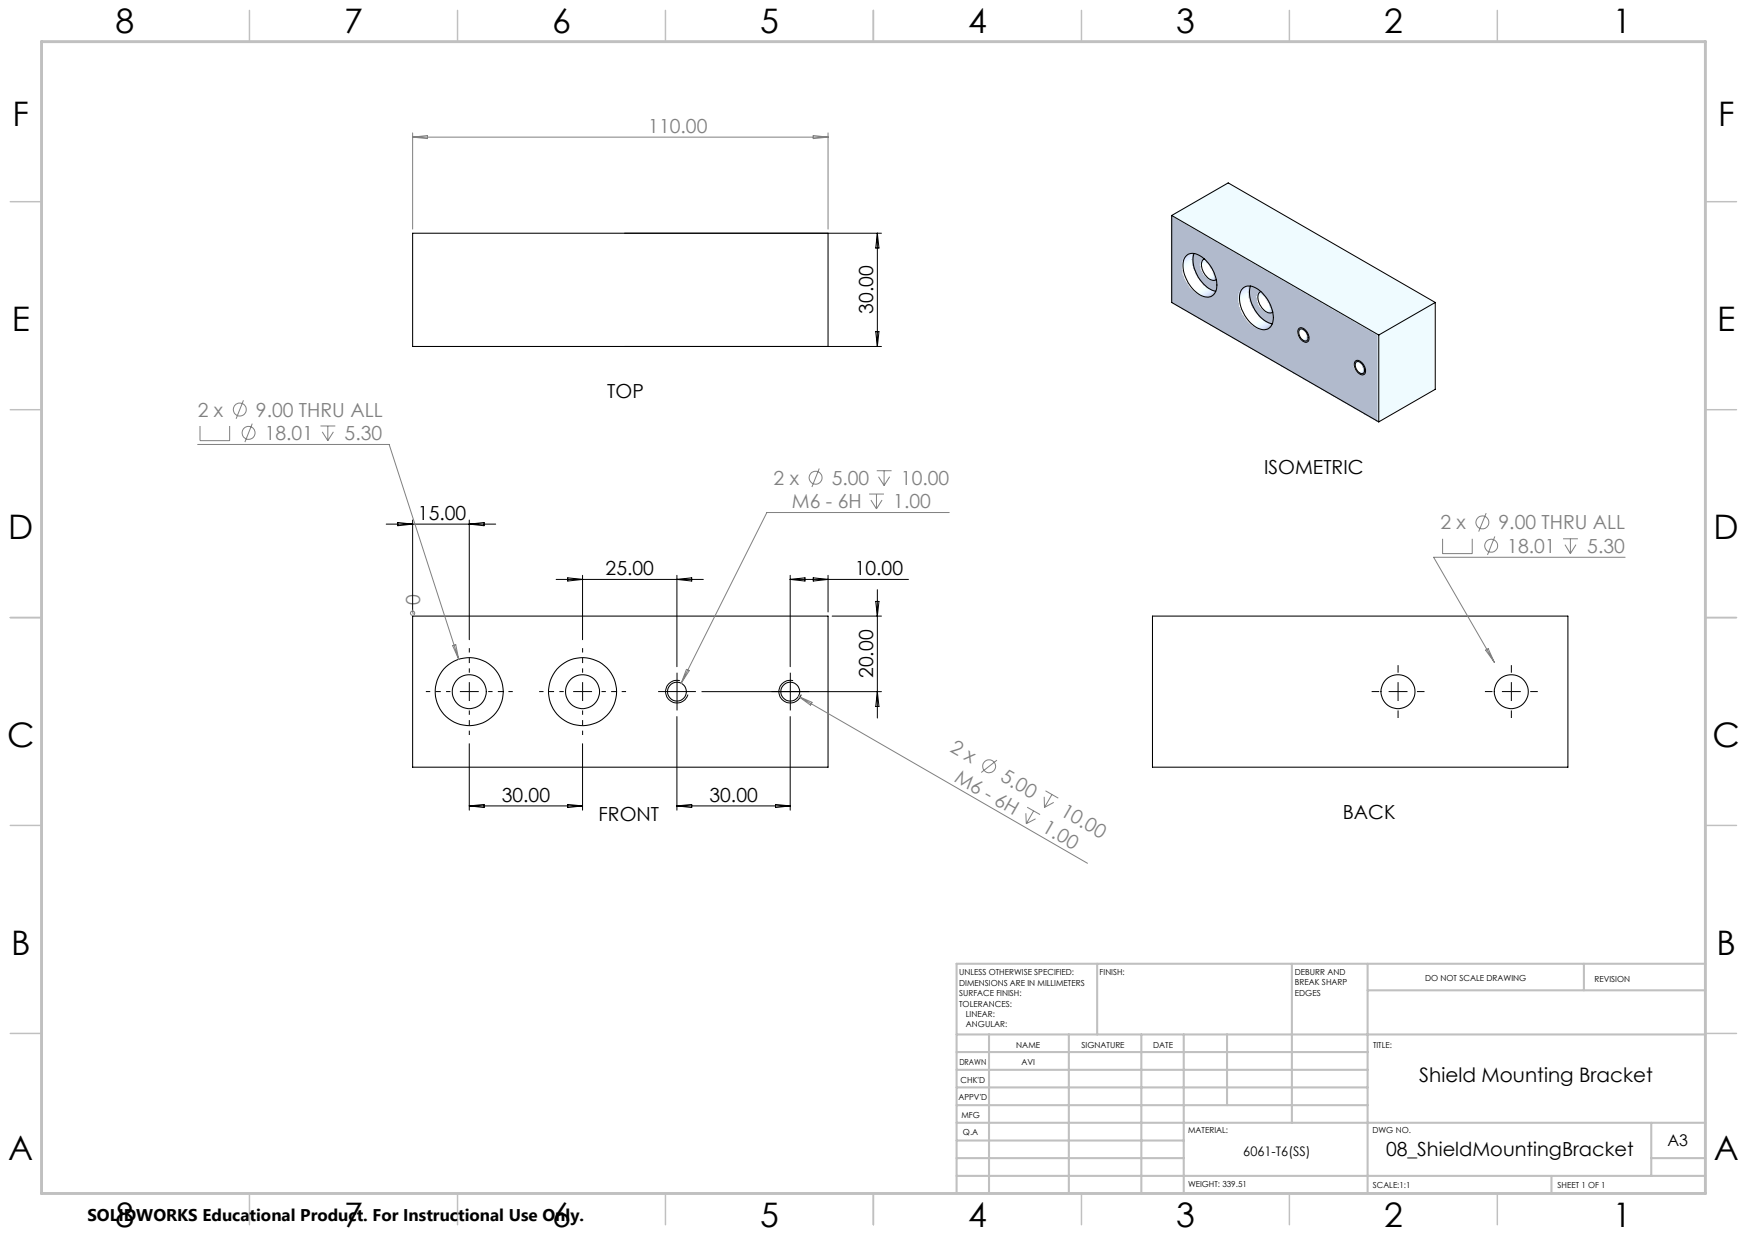
[picture p72: page 11]
9.00 THRU ALL; FRONT; TOP; BACK; ISOMETRIC; 08_ShieldMountingBracket; FINISH:; DEBURR AND; BREAK SHARP EDGES; DO NOT SCALE DRAWING; REVISION

UNLESS OTHERWISE SPECIFIED:
DIMENSIONS ARE IN MILLIMETERS
SURFACE FINISH:
TOLERANCES:
LINEAR:
ANGULAR:

NAME | SIGNATURE | DATE | | | | TITLE: Shield Mounting Bracket

DRAWN | AVI
CHK'D
APPV'D
MFG

WEIGHT: 339.51 | SCALE:1:1 | SHEET 1 OF 1

# Free Height: 31

E | E

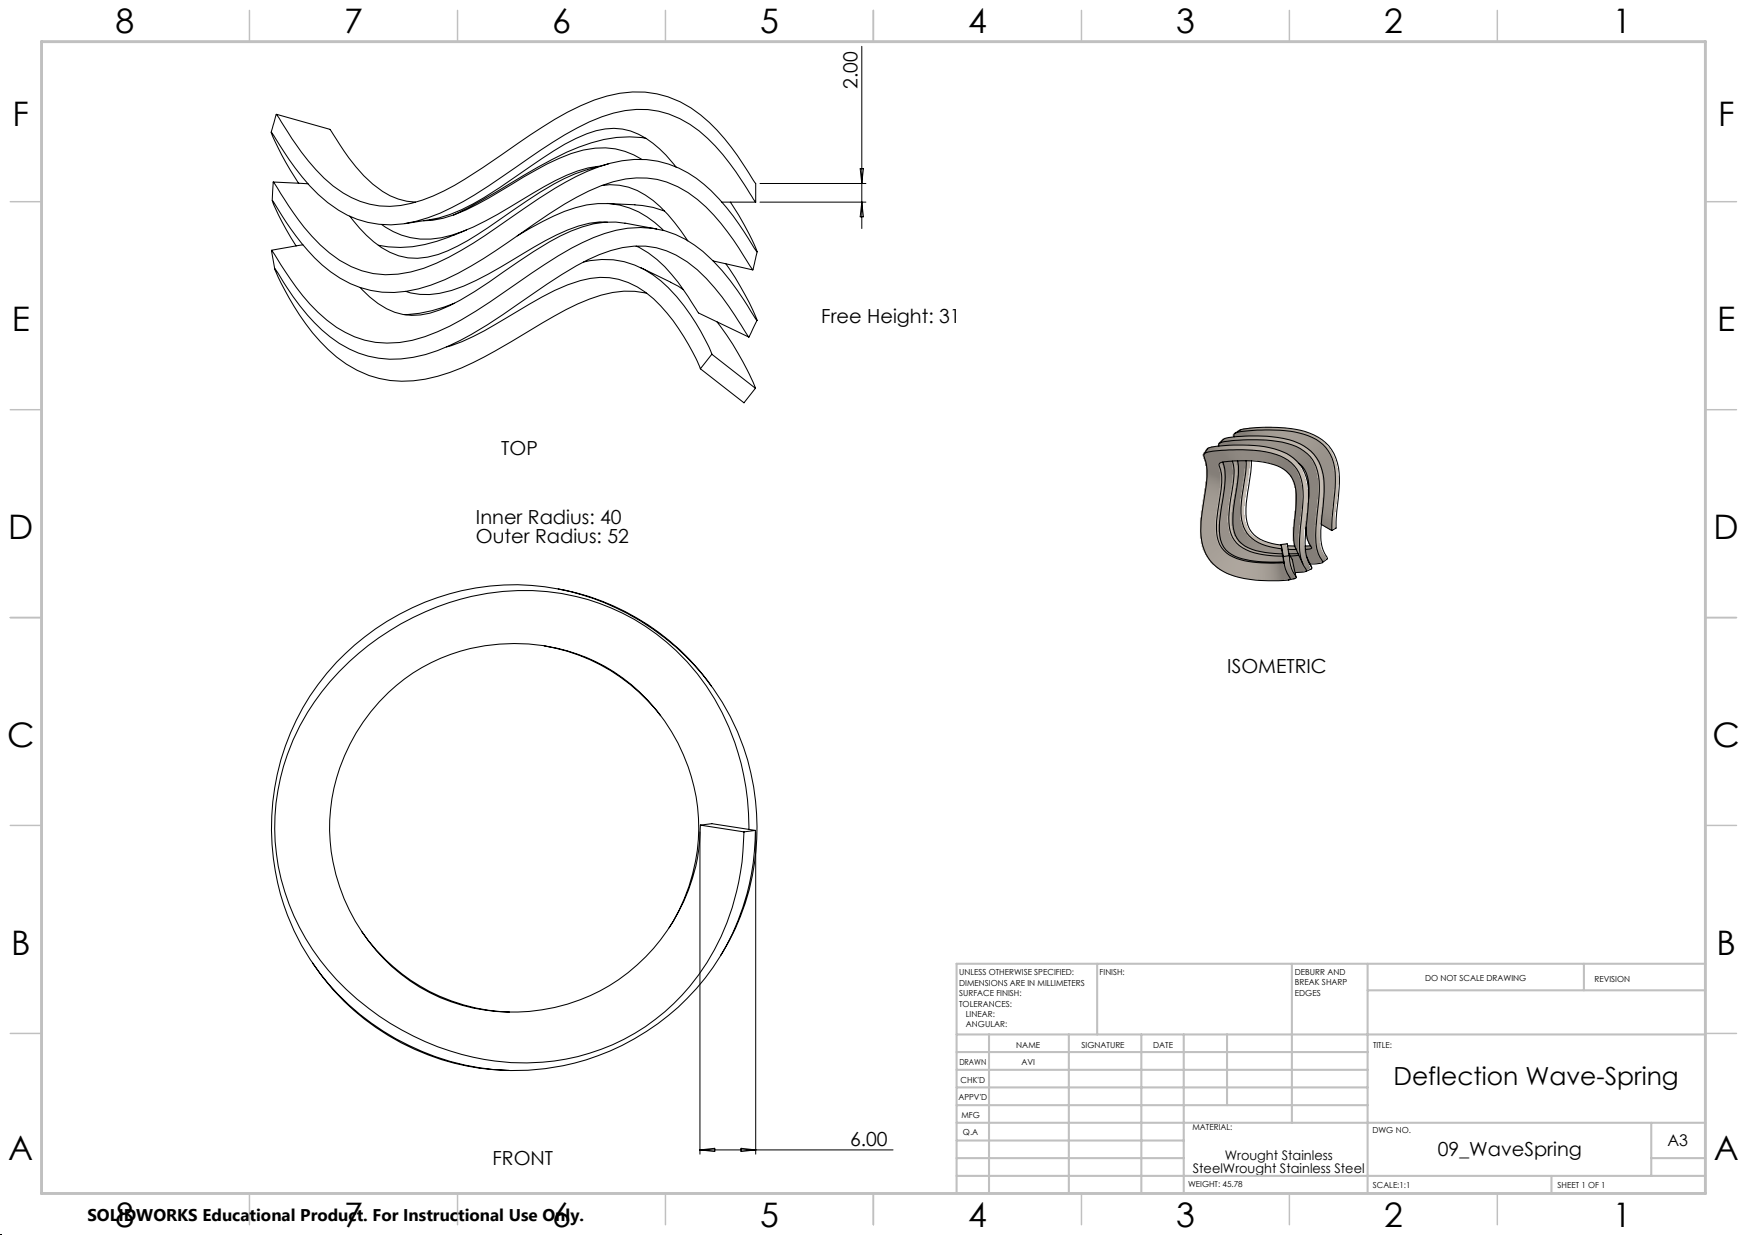
[picture p73: page 12]
FRONT; Inner Radius: 40 Outer Radius: 52; TOP; ISOMETRIC; 09_WaveSpring; FINISH:; DEBURR AND; BREAK SHARP EDGES; DO NOT SCALE DRAWING; REVISION; SCALE:1:1; SHEET 1 OF 1; WEIGHT: 45.78

UNLESS OTHERWISE SPECIFIED:
DIMENSIONS ARE IN MILLIMETERS
SURFACE FINISH:
TOLERANCES:
LINEAR:
ANGULAR:

NAME | SIGNATURE | DATE | | | TITLE: Deflection Wave-Spring

DRAWN | AVI
CHK'D
APPV'D
MFG

MATERIAL: Wrought Stainless SteelWrought Stainless Steel | A3

# Dial scale 0-5 kN engraved over the 72 deg needle sweep, 2 mm deep

# (0 = rest, 5 = overload stop) 15.00

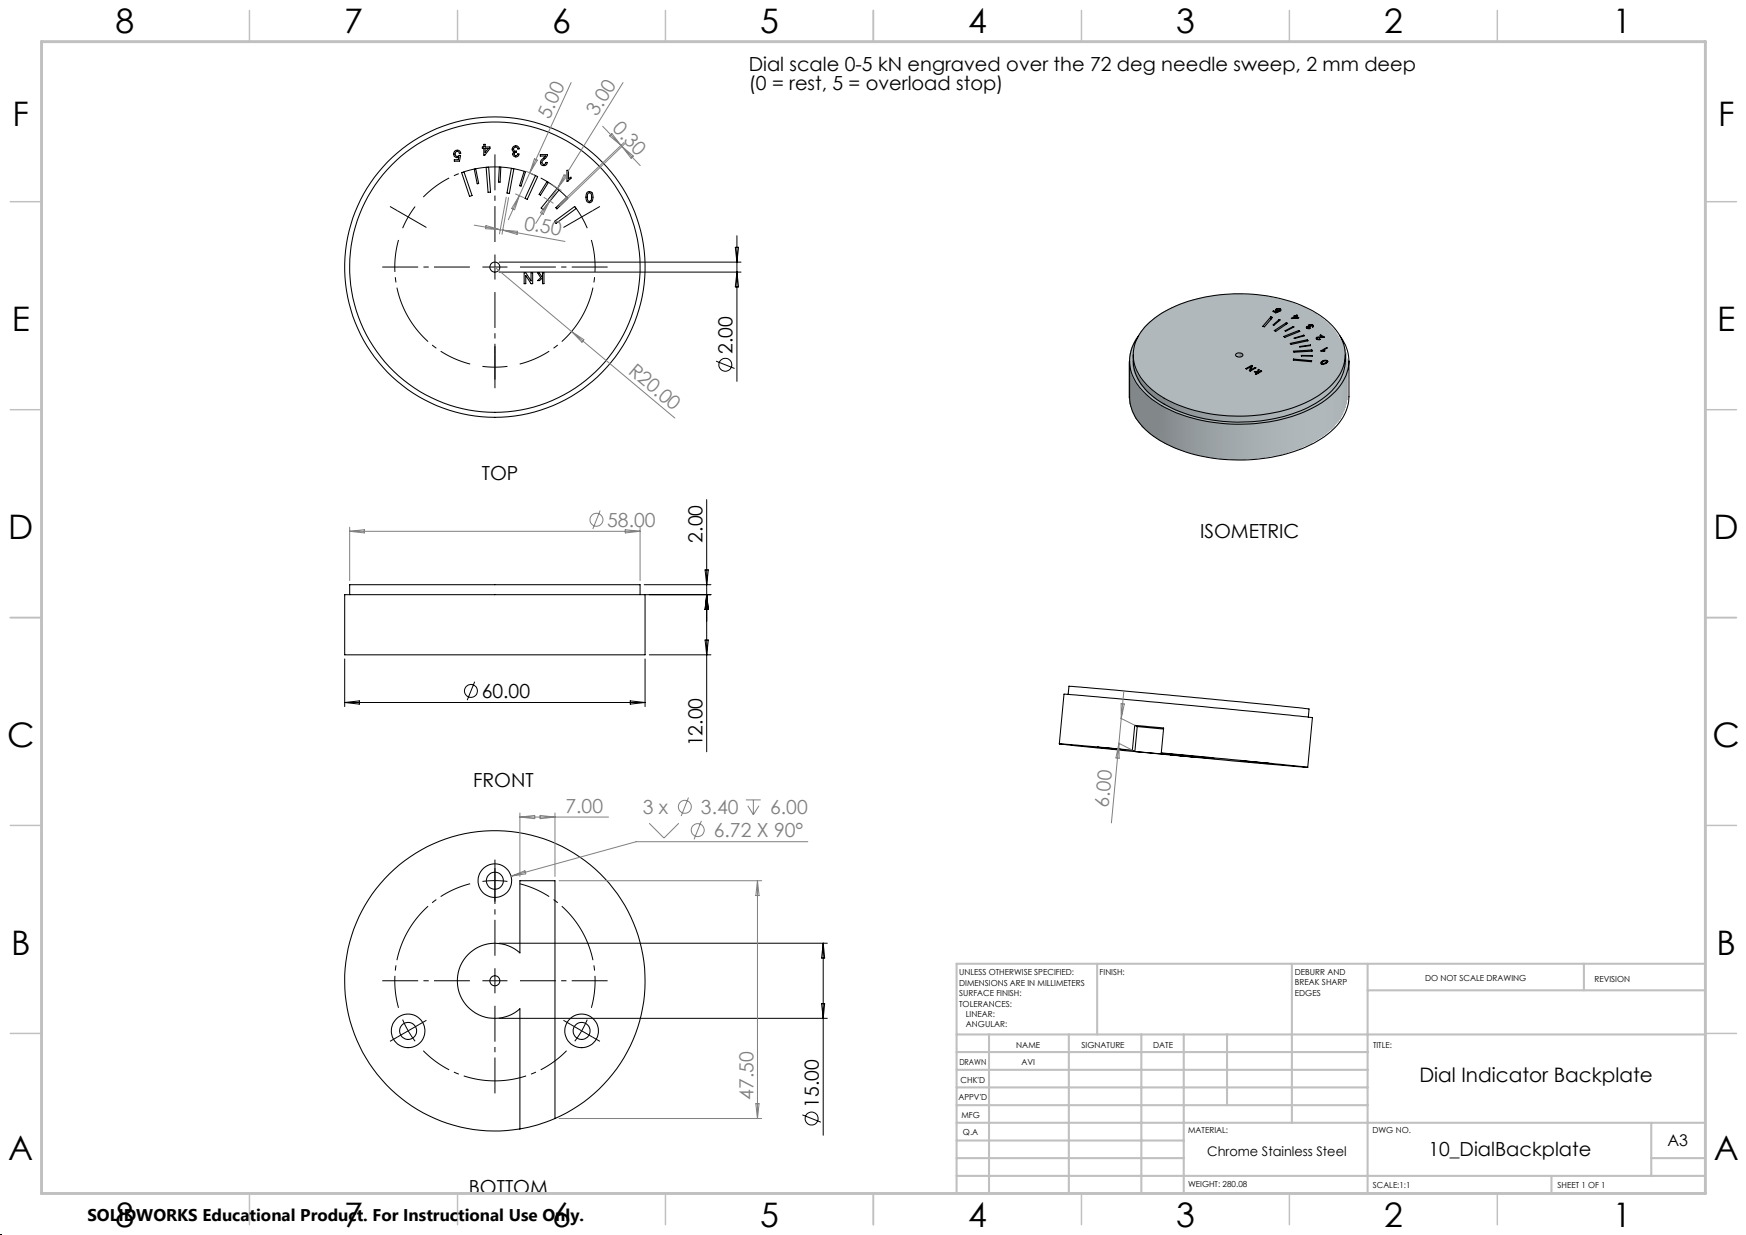
[picture p74: page 13]
FRONT; TOP; BOTTOM; ISOMETRIC; 10_DialBackplate; FINISH:; DEBURR AND; BREAK SHARP EDGES; DO NOT SCALE DRAWING; REVISION

UNLESS OTHERWISE SPECIFIED:
DIMENSIONS ARE IN MILLIMETERS
SURFACE FINISH:
TOLERANCES:
LINEAR:
ANGULAR:

NAME | SIGNATURE | DATE | | | | TITLE: Dial Indicator Backplate

DRAWN | AVI
CHK'D
APPV'D
MFG

A3 Chrome Stainless Steel

WEIGHT: 280.08 | SCALE:1:1 | SHEET 1 OF 1

60.00

66.00

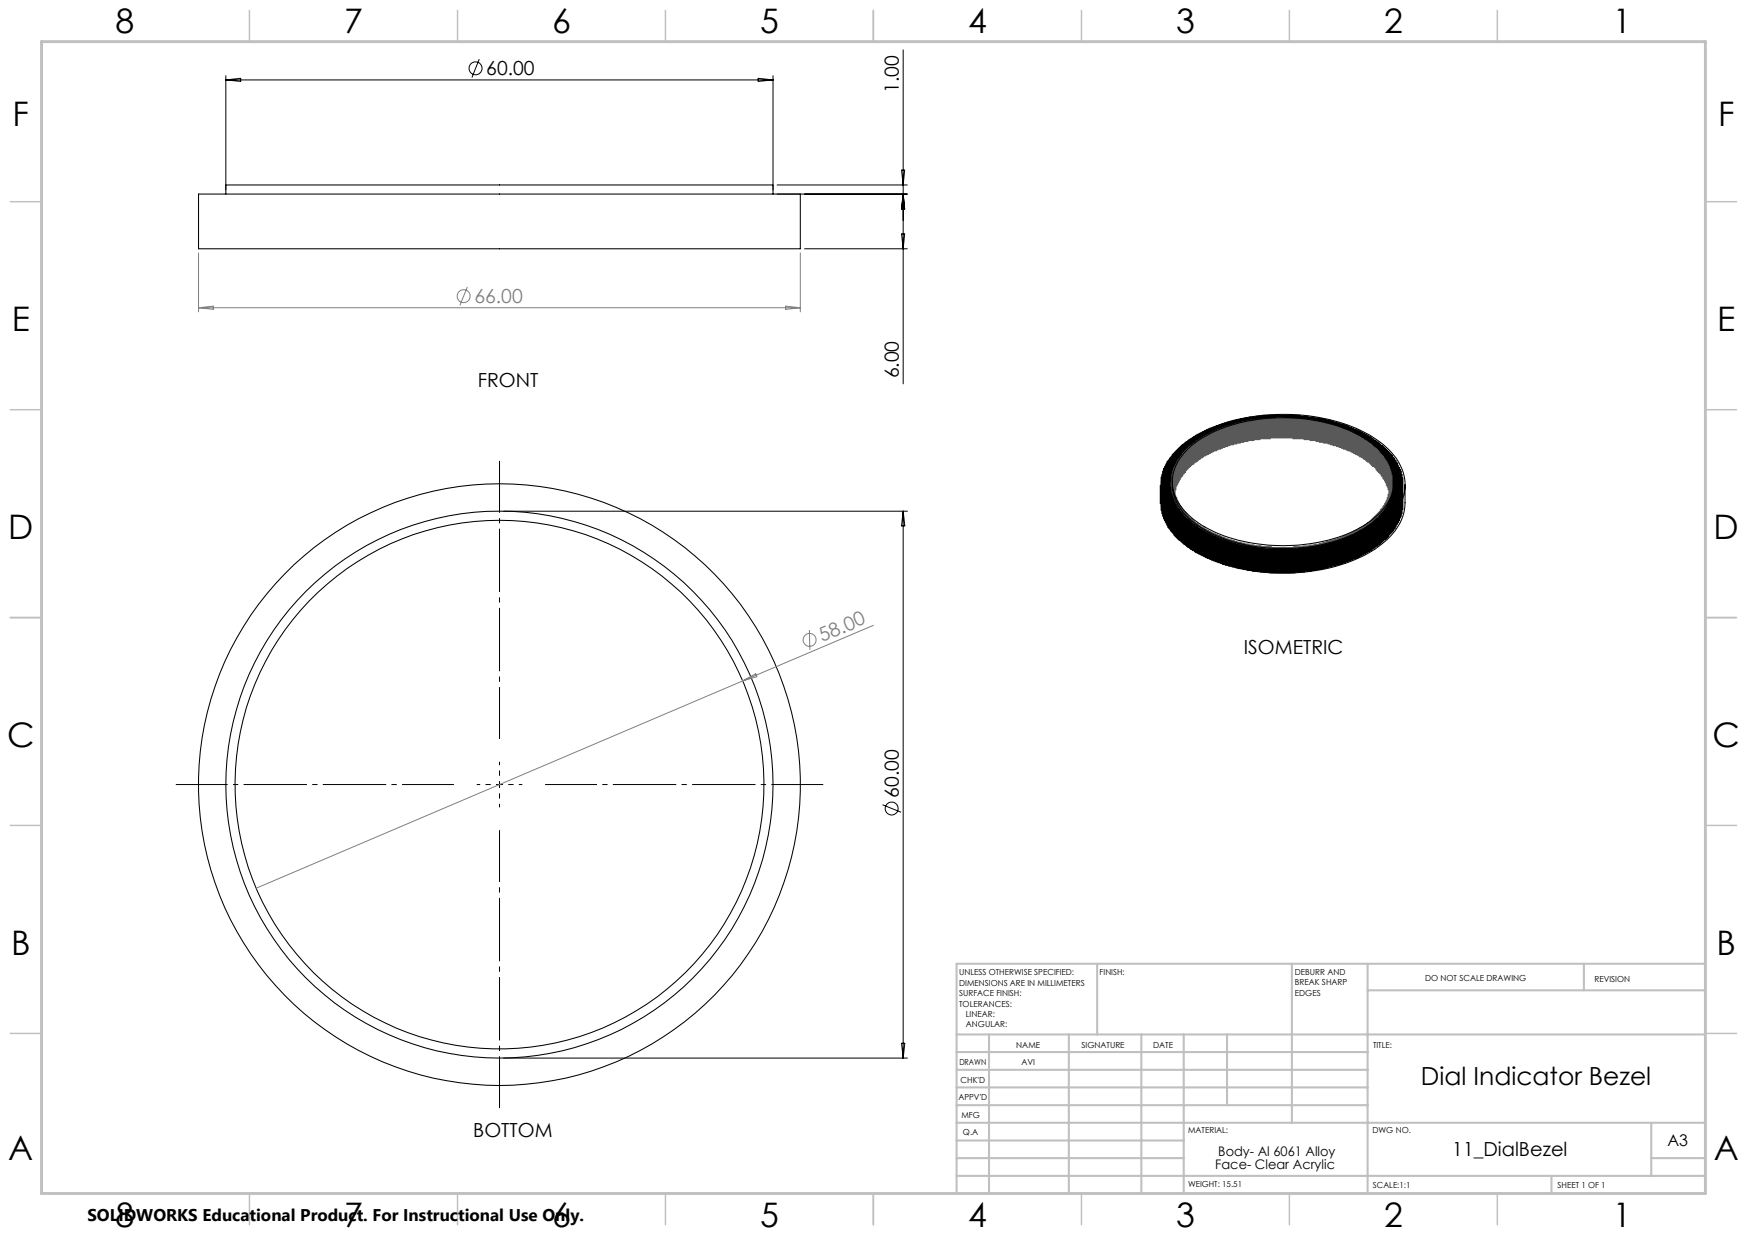
[picture p75: page 14]
FRONT; BOTTOM; ISOMETRIC; 11_DialBezel; FINISH:; DEBURR AND; BREAK SHARP EDGES; DO NOT SCALE DRAWING; REVISION

UNLESS OTHERWISE SPECIFIED:
DIMENSIONS ARE IN MILLIMETERS
SURFACE FINISH:
TOLERANCES:
LINEAR:
ANGULAR:

NAME | SIGNATURE | DATE | | | | TITLE: Dial Indicator Bezel

DRAWN | AVI
CHK'D
APPV'D
MFG

Face- Clear Acrylic | | A3 Body- Al 6061 Alloy

WEIGHT: 15.51 | SCALE:1:1 | SHEET 1 OF 1

11.10
E | E

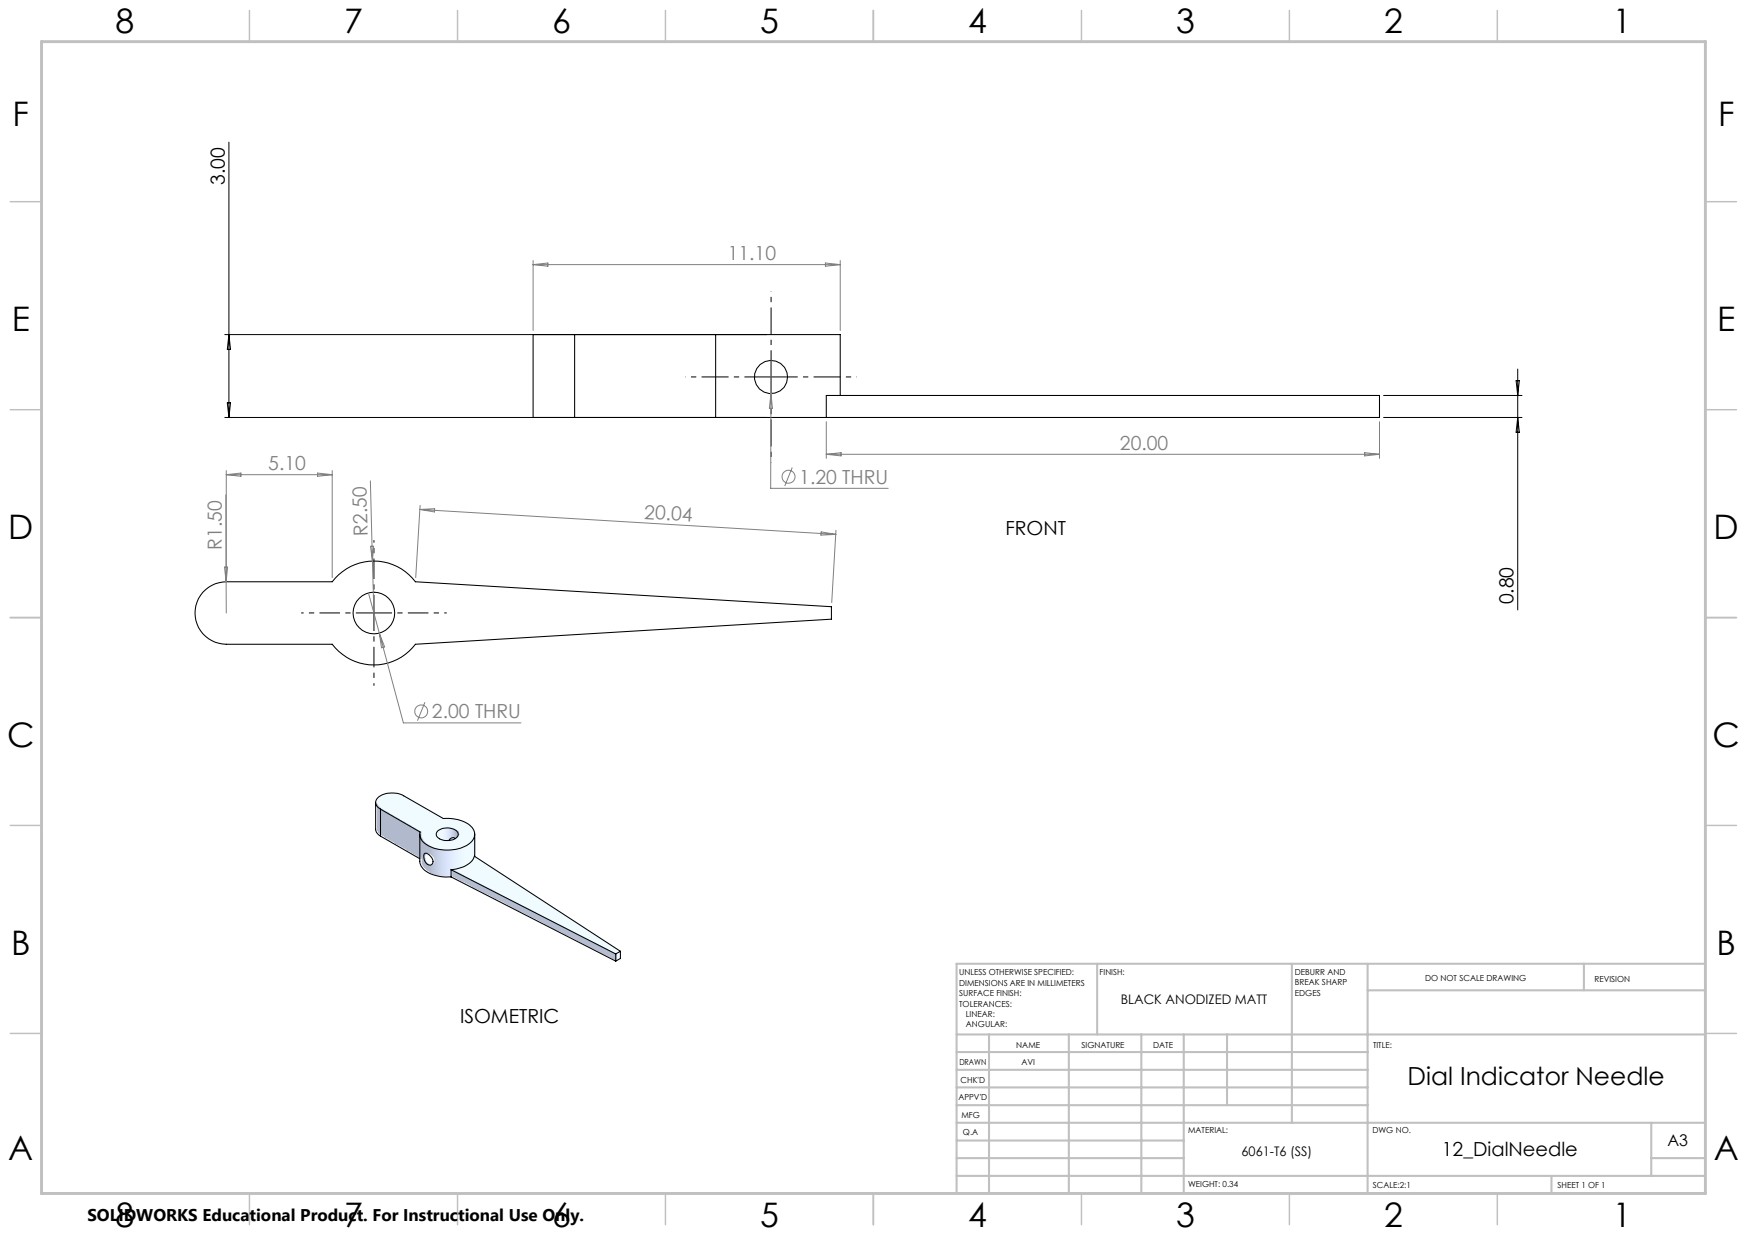
[picture p76: page 15]
1.20 THRU; FRONT; ISOMETRIC; 2.00 THRU; 12_DialNeedle; FINISH:; DEBURR AND; BREAK SHARP EDGES; DO NOT SCALE DRAWING; REVISION

UNLESS OTHERWISE SPECIFIED:
DIMENSIONS ARE IN MILLIMETERS
SURFACE FINISH:
TOLERANCES:
LINEAR:
ANGULAR:

BLACK ANODIZED MATT

NAME | SIGNATURE | DATE | | | | TITLE: Dial Indicator Needle

DRAWN | AVI
CHK'D
APPV'D
MFG

WEIGHT: 0.34 | SCALE:2:1 | SHEET 1 OF 1

E | E
F | F

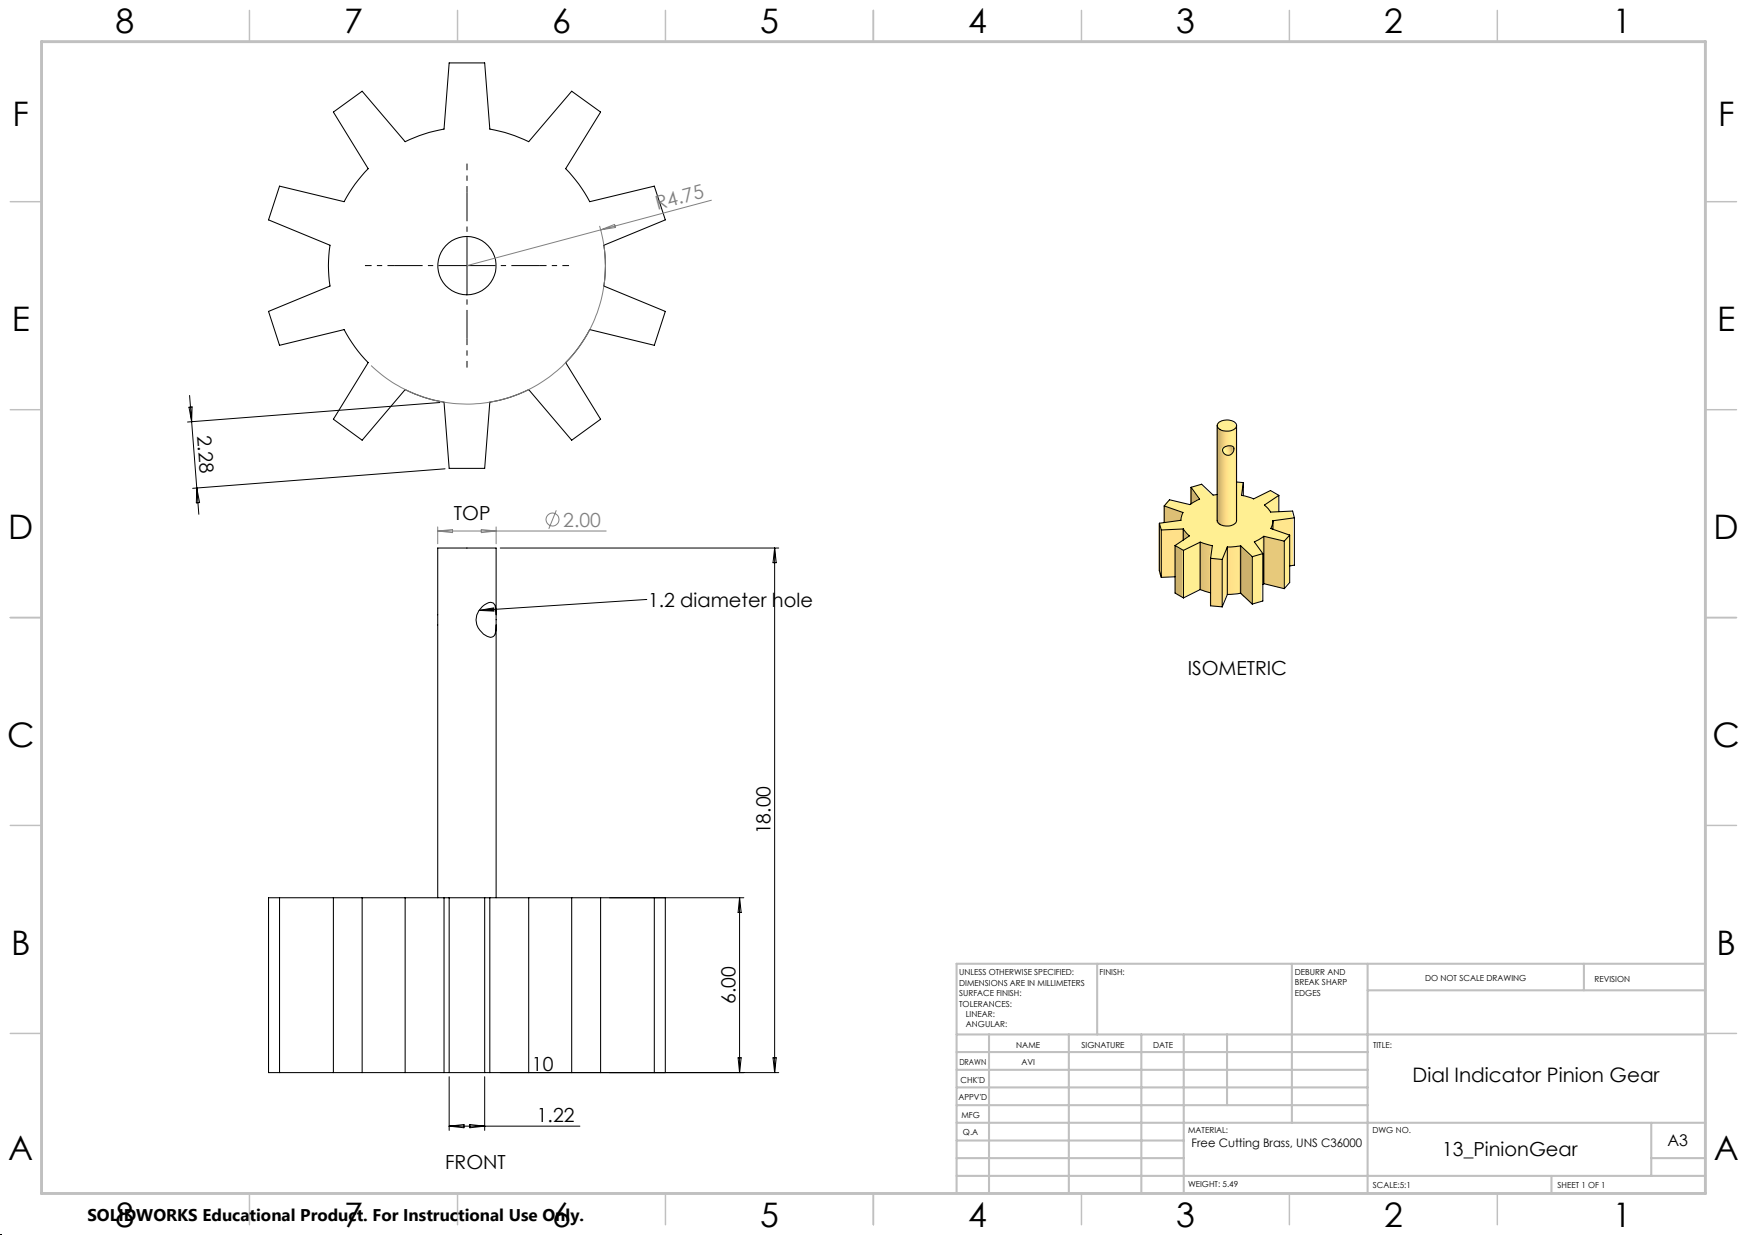
[picture p77: page 16]
FRONT; 1.2 diameter hole; TOP; ISOMETRIC; 13_PinionGear; FINISH:; DEBURR AND; BREAK SHARP EDGES; DO NOT SCALE DRAWING; REVISION; SCALE:5:1; SHEET 1 OF 1; WEIGHT: 5.49

UNLESS OTHERWISE SPECIFIED:
DIMENSIONS ARE IN MILLIMETERS
SURFACE FINISH:
TOLERANCES:
LINEAR:
ANGULAR:

NAME | SIGNATURE | DATE | | | TITLE: Dial Indicator Pinion Gear

DRAWN | AVI
CHK'D
APPV'D
MFG

Free Cutting Brass, UNS C36000 | A3

E | E
F | F

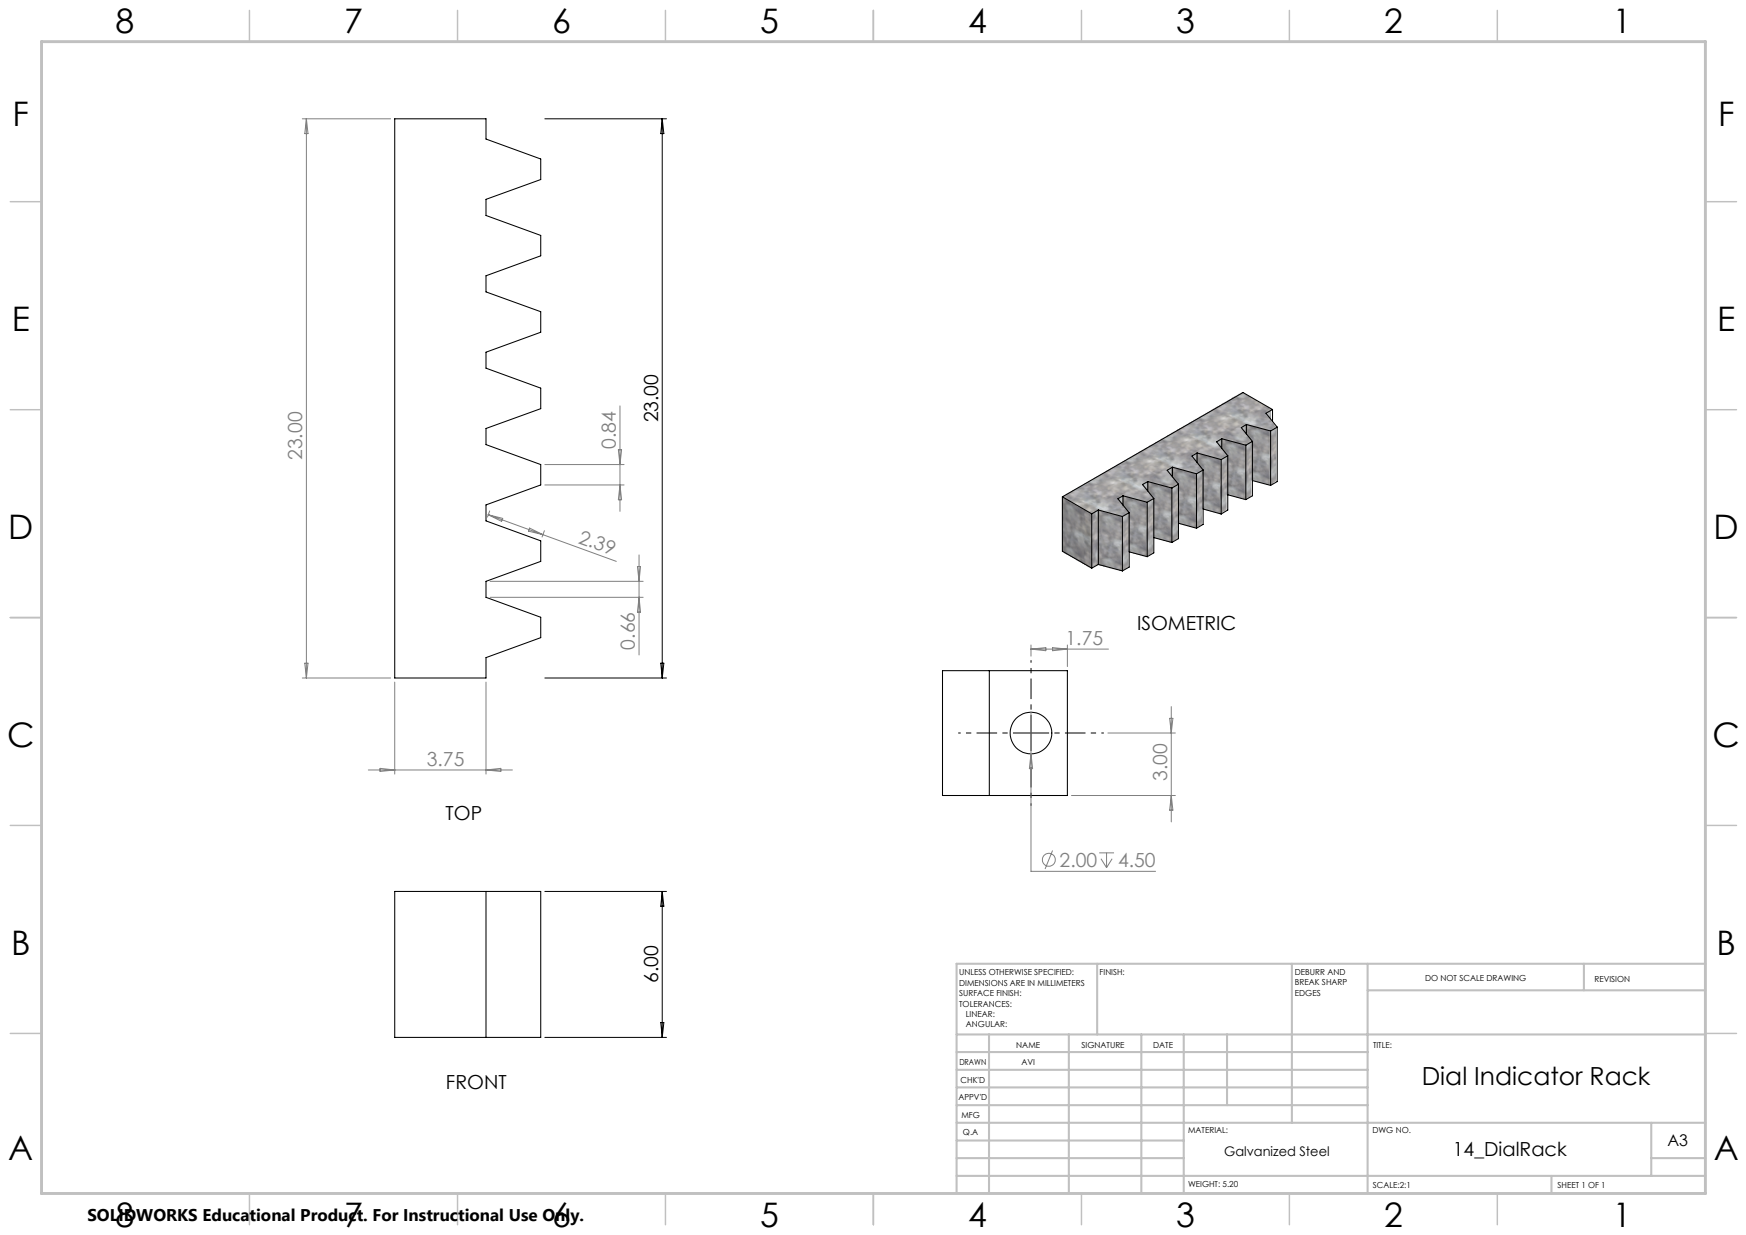
[picture p78: page 17]
FRONT; TOP; ISOMETRIC; 14_DialRack; FINISH:; DEBURR AND; BREAK SHARP EDGES; NAME; SIGNATURE; DATE; DO NOT SCALE DRAWING; REVISION

UNLESS OTHERWISE SPECIFIED:
DIMENSIONS ARE IN MILLIMETERS
SURFACE FINISH:
TOLERANCES:
LINEAR:
ANGULAR:

TITLE:
Dial Indicator Rack

DRAWN | AVI
CHK'D
APPV'D
MFG

A3 Galvanized Steel

WEIGHT: 5.20 | SCALE:2:1 | SHEET 1 OF 1

3.75

# TOP

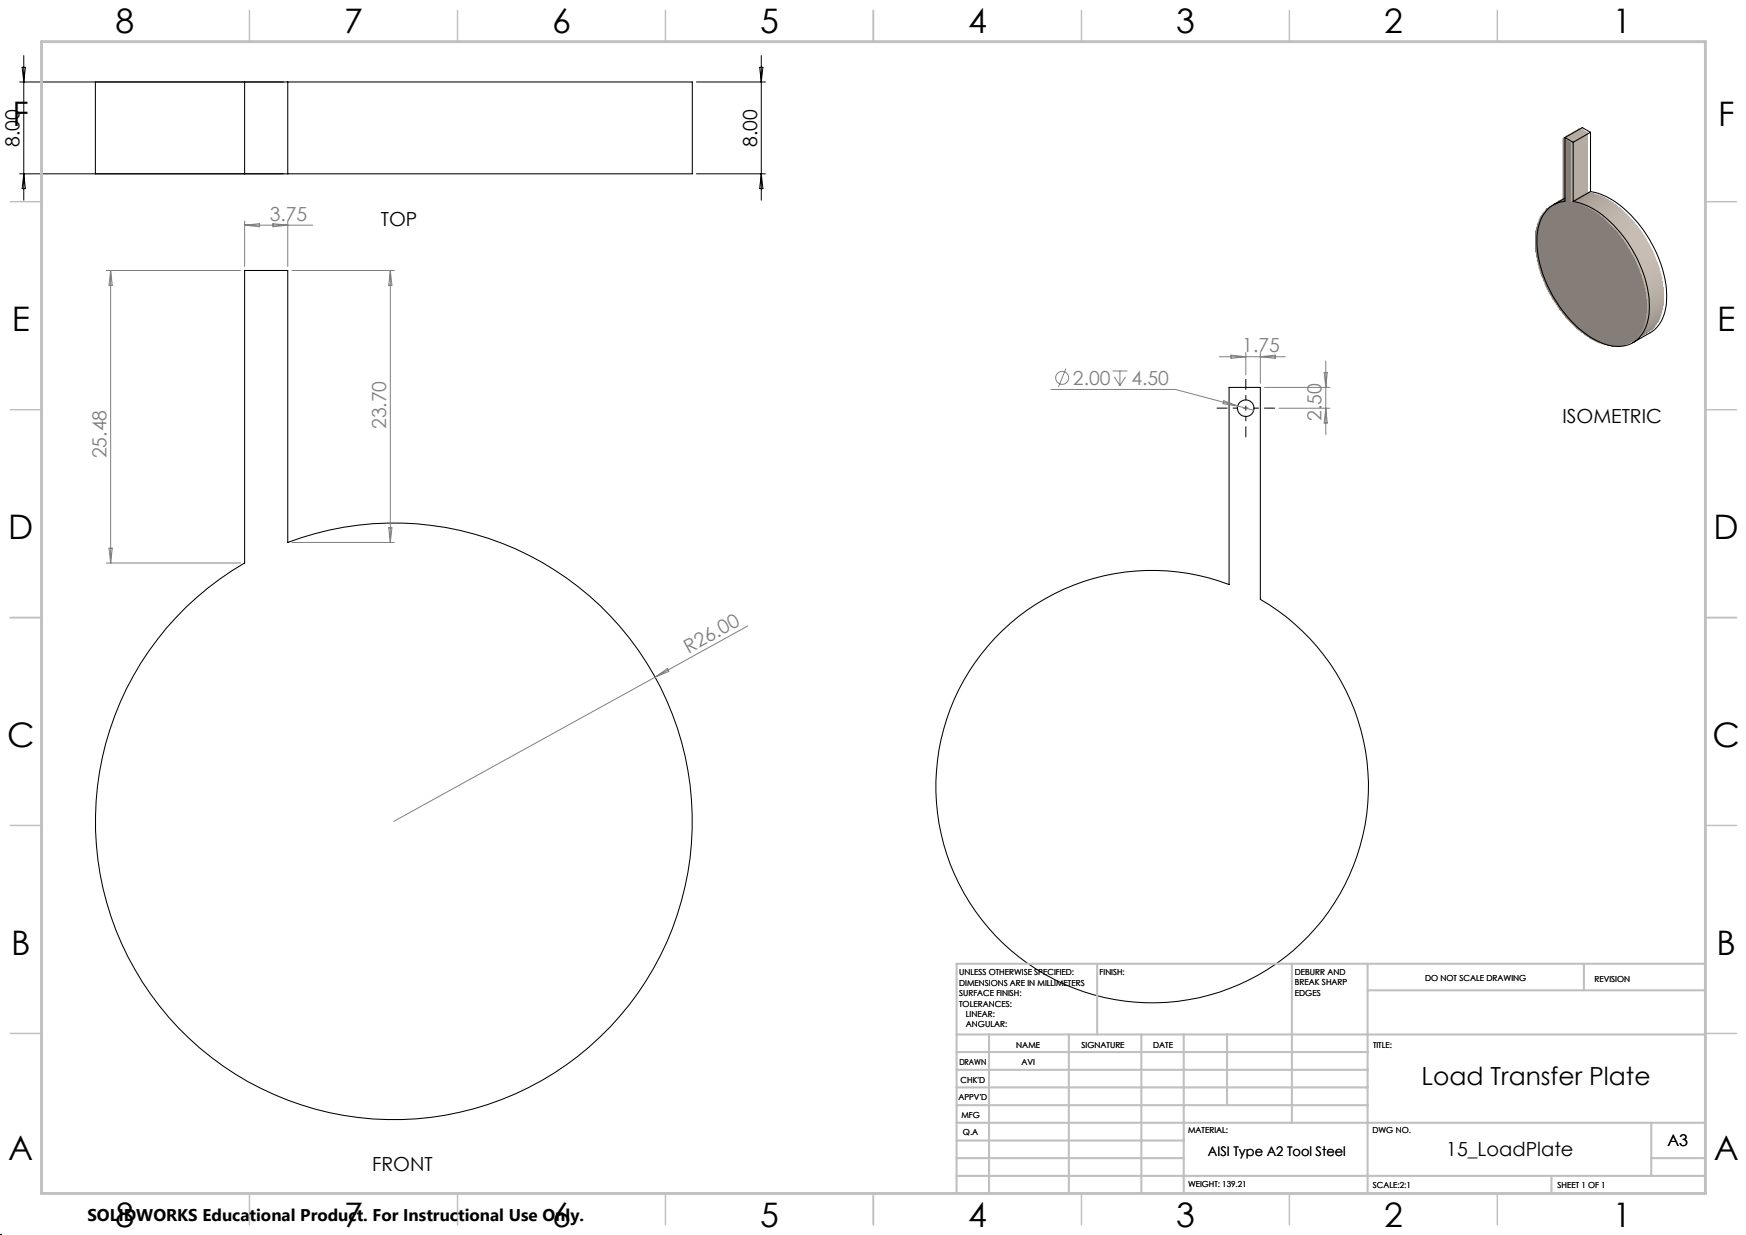
[picture p79: page 18]
FRONT; ISOMETRIC; FINISH:; DEBURR AND; BREAK SHARP EDGES; DO NOT SCALE DRAWING; REVISION

UNLESS OTHERWISE SPECIFIED:
DIMENSIONS ARE IN MILLIMETERS
SURFACE FINISH:
TOLERANCES:
LINEAR:
ANGULAR:

NAME | SIGNATURE | DATE | | | | TITLE: TITLE: Load Transfer Plate

DRAWN | AVI
CHK'D
APPV'D
MFG

15_LoadPlate | A3 AISI Type A2 Tool Steel

WEIGHT: 139.21 | SCALE:2:1 | SHEET 1 OF 1

E | E
F | F

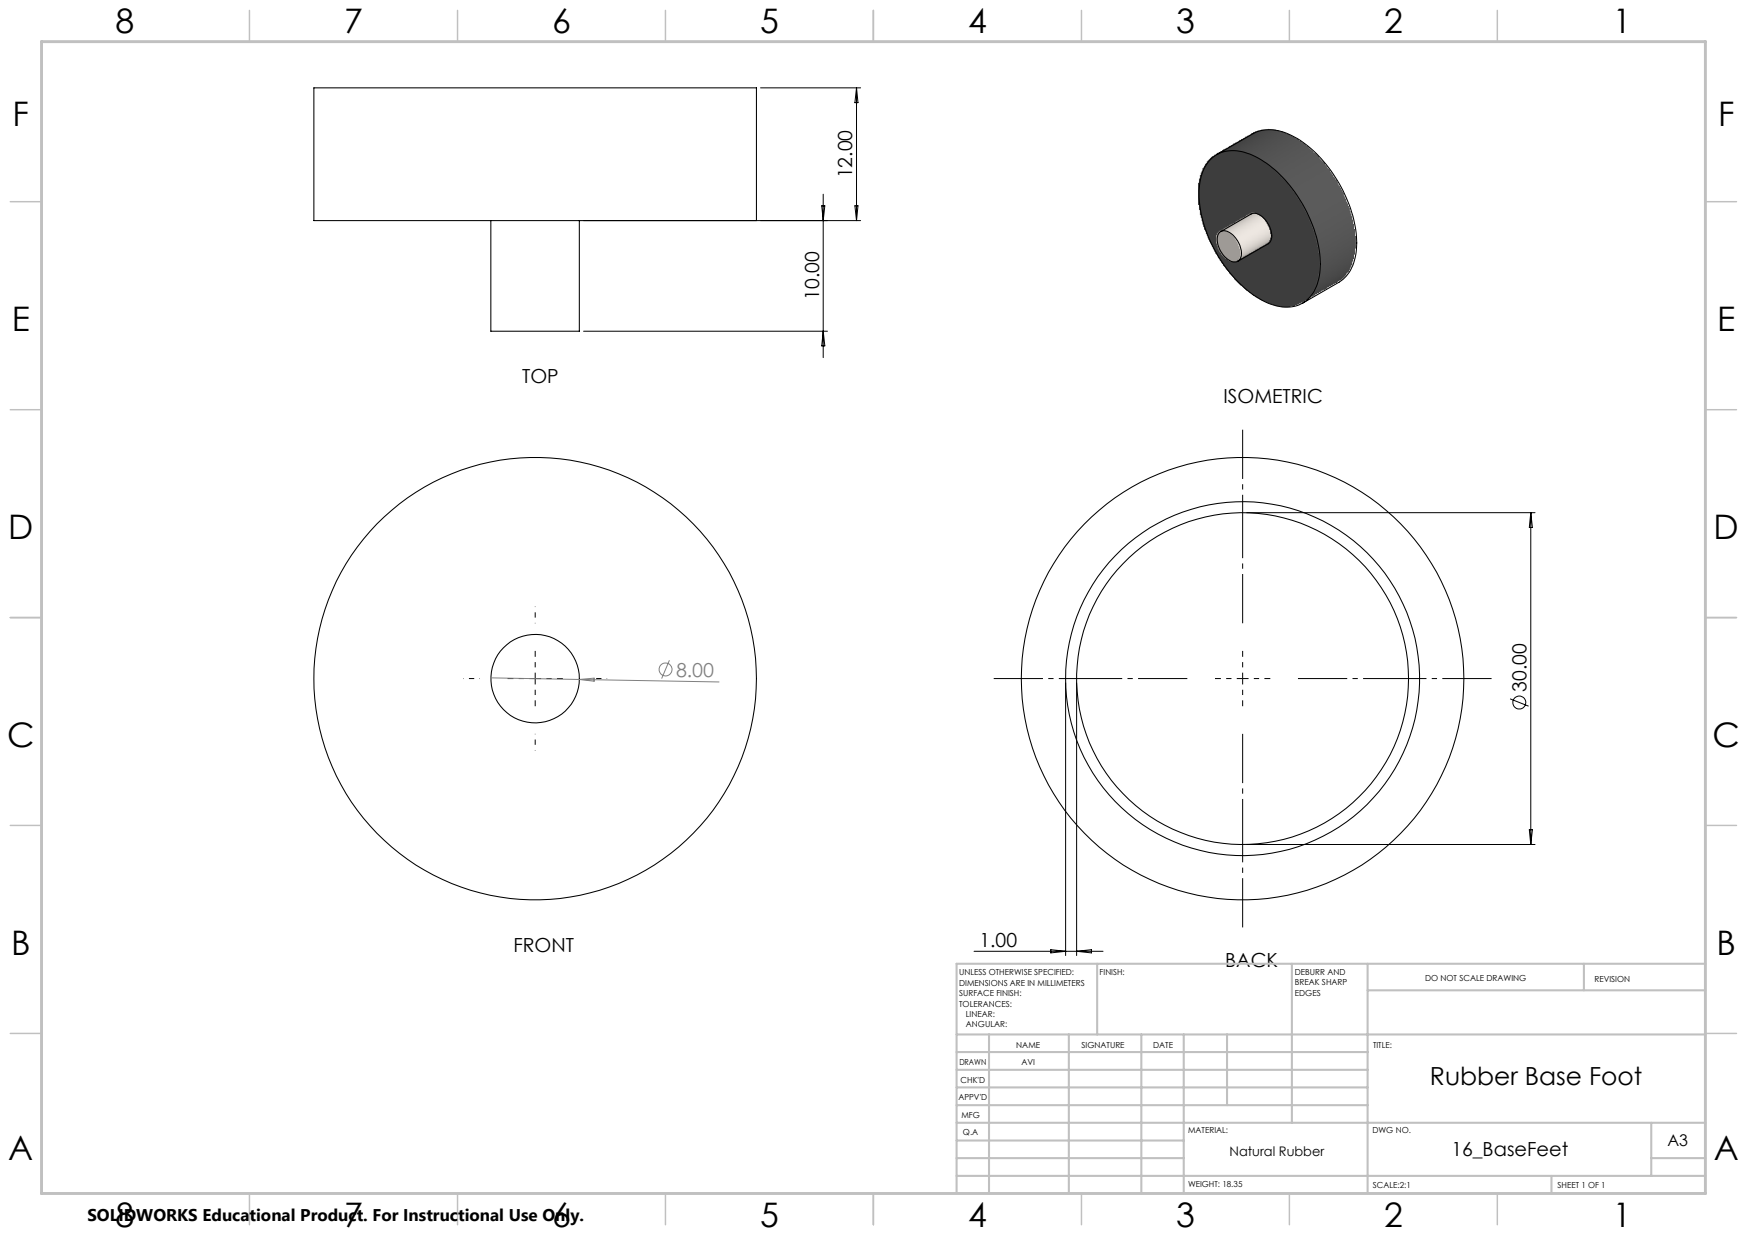
[picture p80: page 19]
FRONT; TOP; BACK; ISOMETRIC; 16_BaseFeet; FINISH:; DEBURR AND; BREAK SHARP EDGES; DO NOT SCALE DRAWING; REVISION

UNLESS OTHERWISE SPECIFIED:
DIMENSIONS ARE IN MILLIMETERS
SURFACE FINISH:
TOLERANCES:
LINEAR:
ANGULAR:

NAME | SIGNATURE | DATE | | | | TITLE: Rubber Base Foot

DRAWN | AVI
CHK'D
APPV'D
MFG

A3 Natural Rubber

WEIGHT: 18.35 | SCALE:2:1 | SHEET 1 OF 1

22.00 24.00
19.00

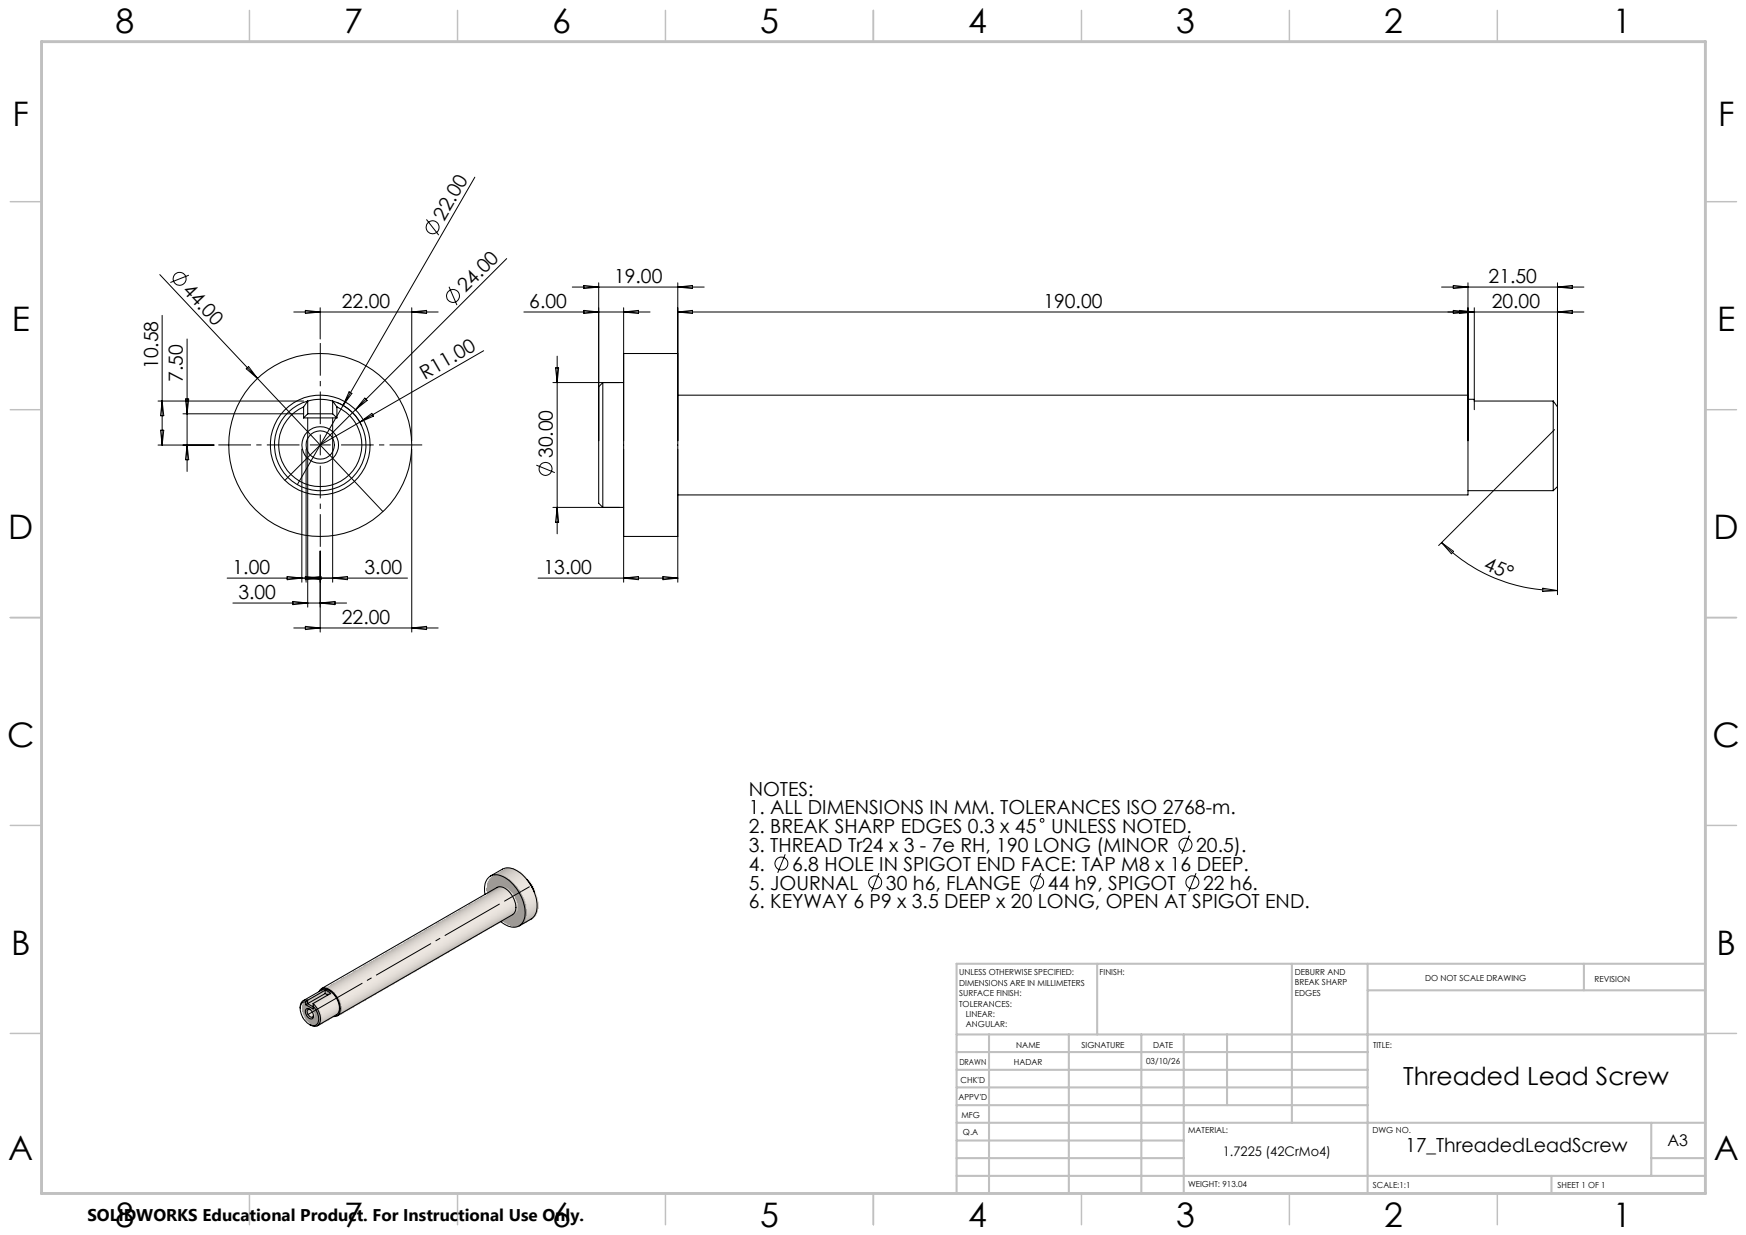
[picture p81: page 20]
FINISH:; DEBURR AND; BREAK SHARP EDGES; DO NOT SCALE DRAWING; REVISION

NOTES:
1. ALL DIMENSIONS IN MM. TOLERANCES ISO 2768-m.
2. BREAK SHARP EDGES 0.3 x 45 UNLESS NOTED.
3. THREAD Tr24 x 3 - 7e RH, 190 LONG (MINOR 20.5).
4. 6.8 HOLE IN SPIGOT END FACE: TAP M8 x 16 DEEP.
5. JOURNAL 30 h6, FLANGE 44 h9, SPIGOT 22 h6.
6. KEYWAY 6 P9 x 3.5 DEEP x 20 LONG, OPEN AT SPIGOT END.

UNLESS OTHERWISE SPECIFIED:
DIMENSIONS ARE IN MILLIMETERS
SURFACE FINISH:
TOLERANCES:
LINEAR:
ANGULAR:

NAME | SIGNATURE | DATE | | | | TITLE: Threaded Lead Screw

DRAWN | HADAR | | 03/10/26
CHK'D
APPV'D
MFG

17_ThreadedLeadScrew | A3 1.7225 (42CrMo4)

WEIGHT: 913.04 | SCALE:1:1 | SHEET 1 OF 1

60.00

320.00

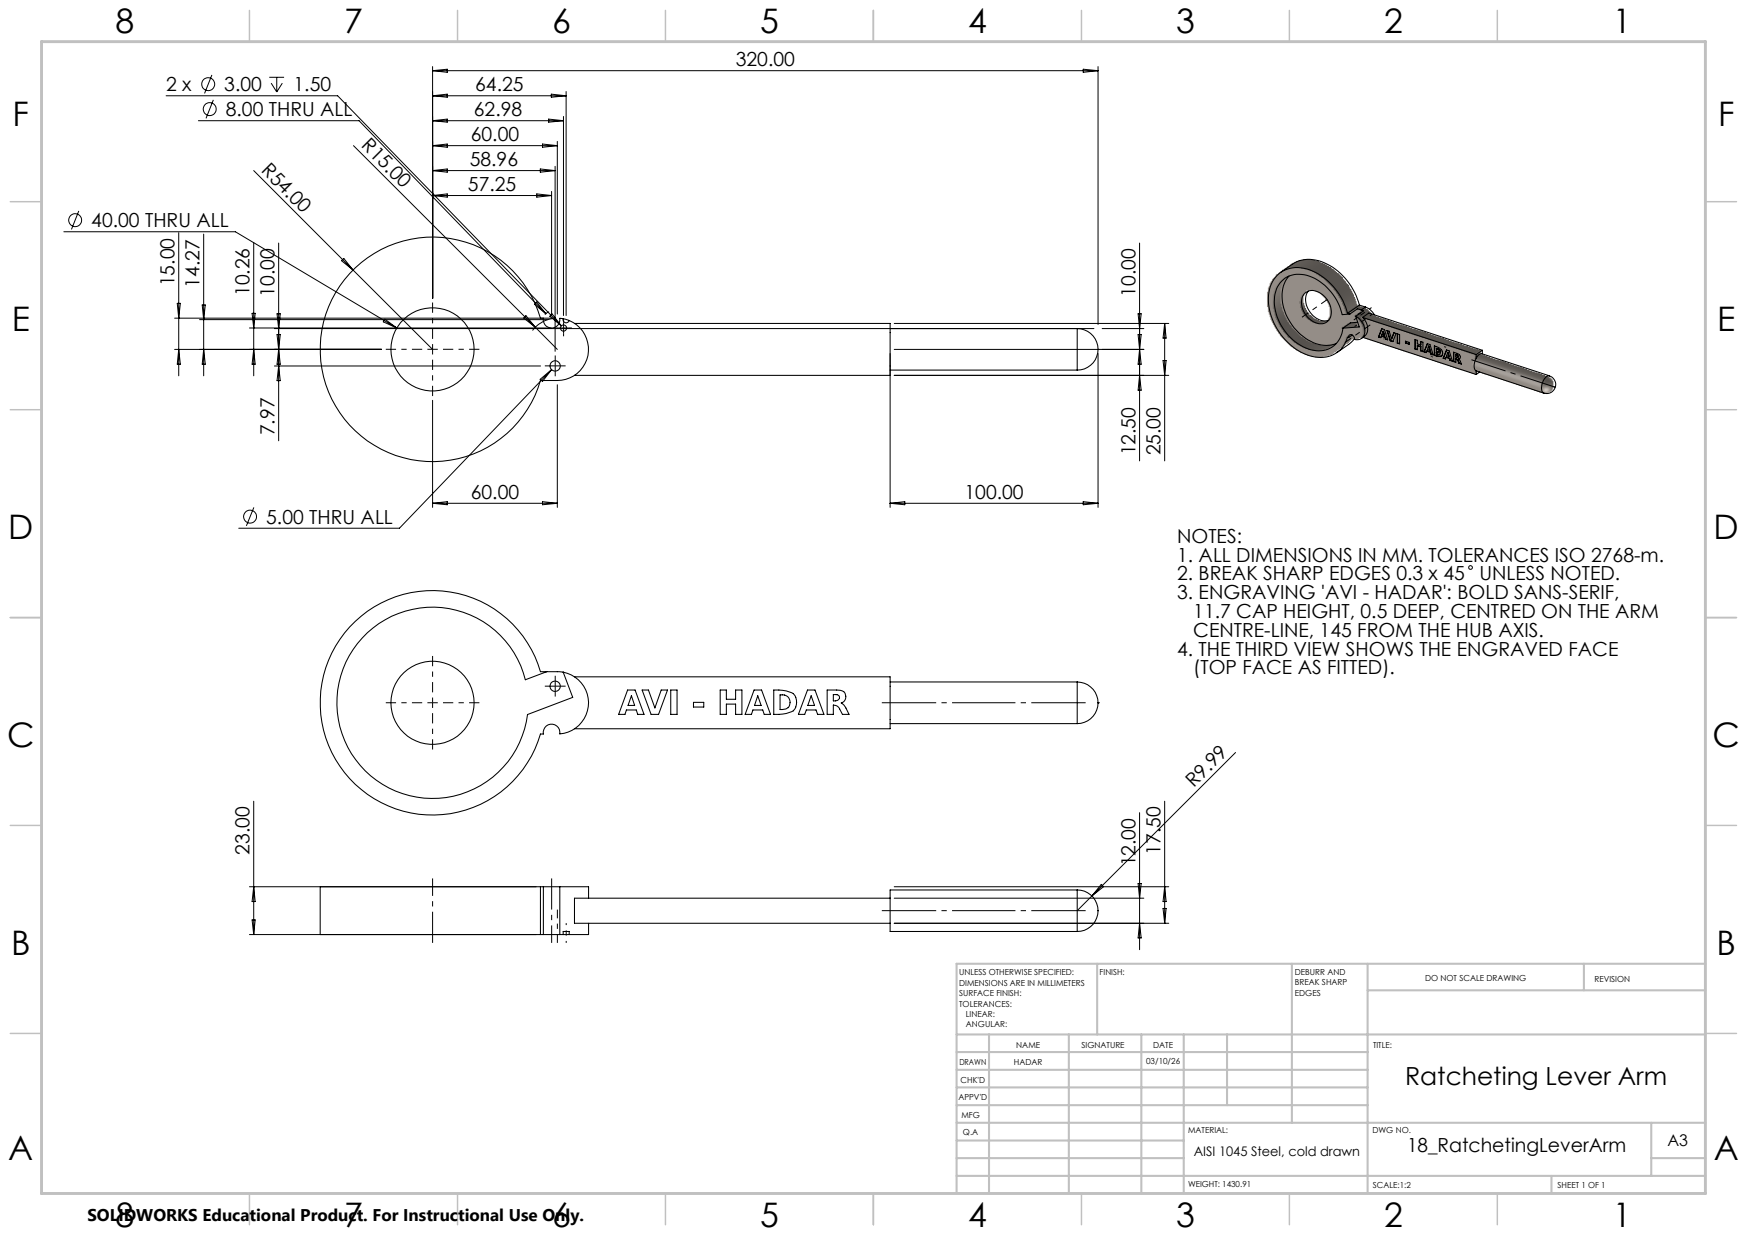
[picture p82: page 21]
8.00 THRU ALL; 5.00 THRU ALL; 40.00 THRU ALL; FINISH:; DEBURR AND; BREAK SHARP EDGES; DO NOT SCALE DRAWING; REVISION

NOTES:
1. ALL DIMENSIONS IN MM. TOLERANCES ISO 2768-m.
2. BREAK SHARP EDGES 0.3 x 45 UNLESS NOTED.
3. ENGRAVING 'AVI - HADAR': BOLD SANS-SERIF,
11.7 CAP HEIGHT, 0.5 DEEP, CENTRED ON THE ARM
CENTRE-LINE, 145 FROM THE HUB AXIS.
4. THE THIRD VIEW SHOWS THE ENGRAVED FACE
(TOP FACE AS FITTED).

UNLESS OTHERWISE SPECIFIED:
DIMENSIONS ARE IN MILLIMETERS
SURFACE FINISH:
TOLERANCES:
LINEAR:
ANGULAR:

NAME | SIGNATURE | DATE | | | | TITLE: Ratcheting Lever Arm

DRAWN | HADAR | | 03/10/26
CHK'D
APPV'D
MFG

18_RatchetingLeverArm | A3 AISI 1045 Steel, cold drawn

WEIGHT: 1430.91 | SCALE:1:2 | SHEET 1 OF 1

90.00
6.00

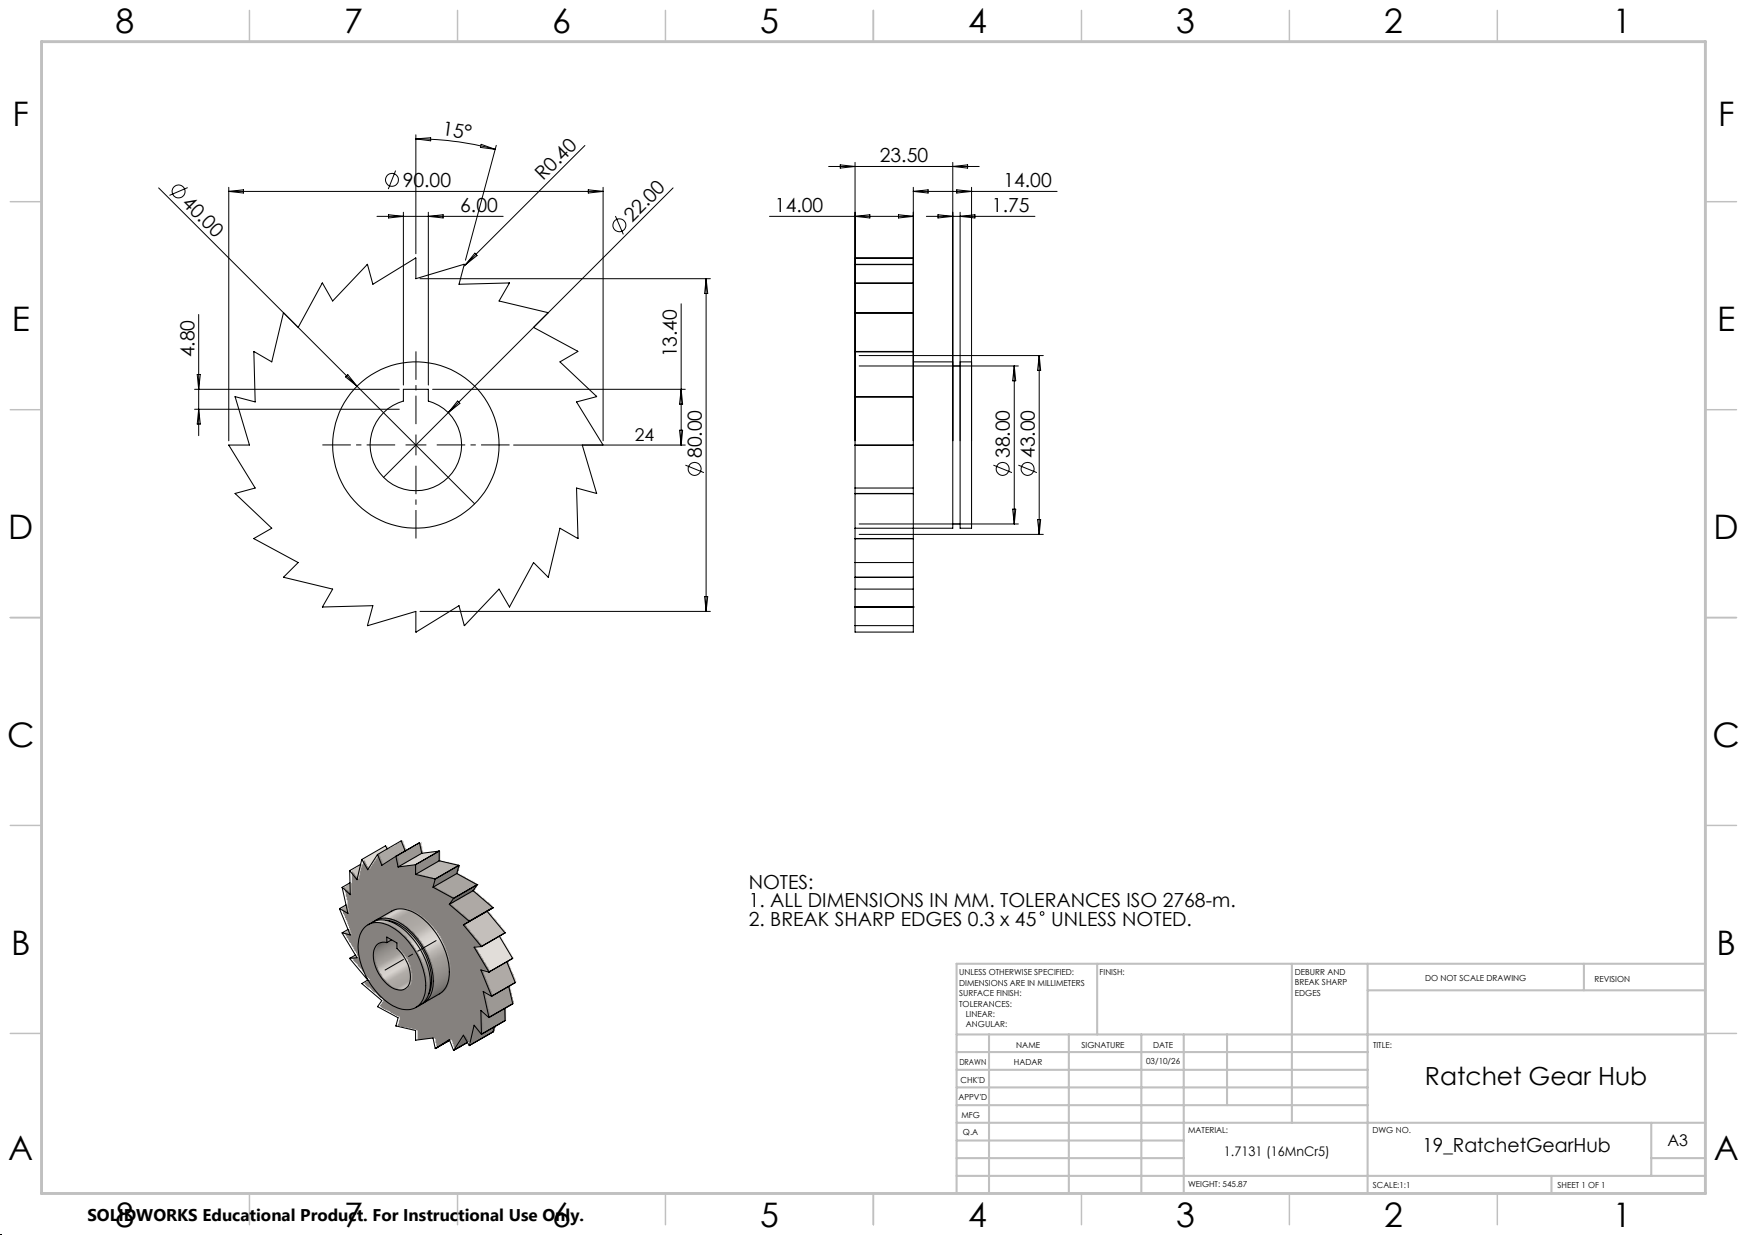
[picture p83: page 22]
FINISH:; DEBURR AND; BREAK SHARP EDGES; DO NOT SCALE DRAWING; REVISION

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

UNLESS OTHERWISE SPECIFIED:
DIMENSIONS ARE IN MILLIMETERS
SURFACE FINISH:
TOLERANCES:
LINEAR:
ANGULAR:

NAME | SIGNATURE | DATE | | | | TITLE: Ratchet Gear Hub

DRAWN | HADAR | | 03/10/26
CHK'D
APPV'D
MFG

19_RatchetGearHub | A3 1.7131 (16MnCr5)

WEIGHT: 545.87 | SCALE:1:1 | SHEET 1 OF 1

5.00

10.00

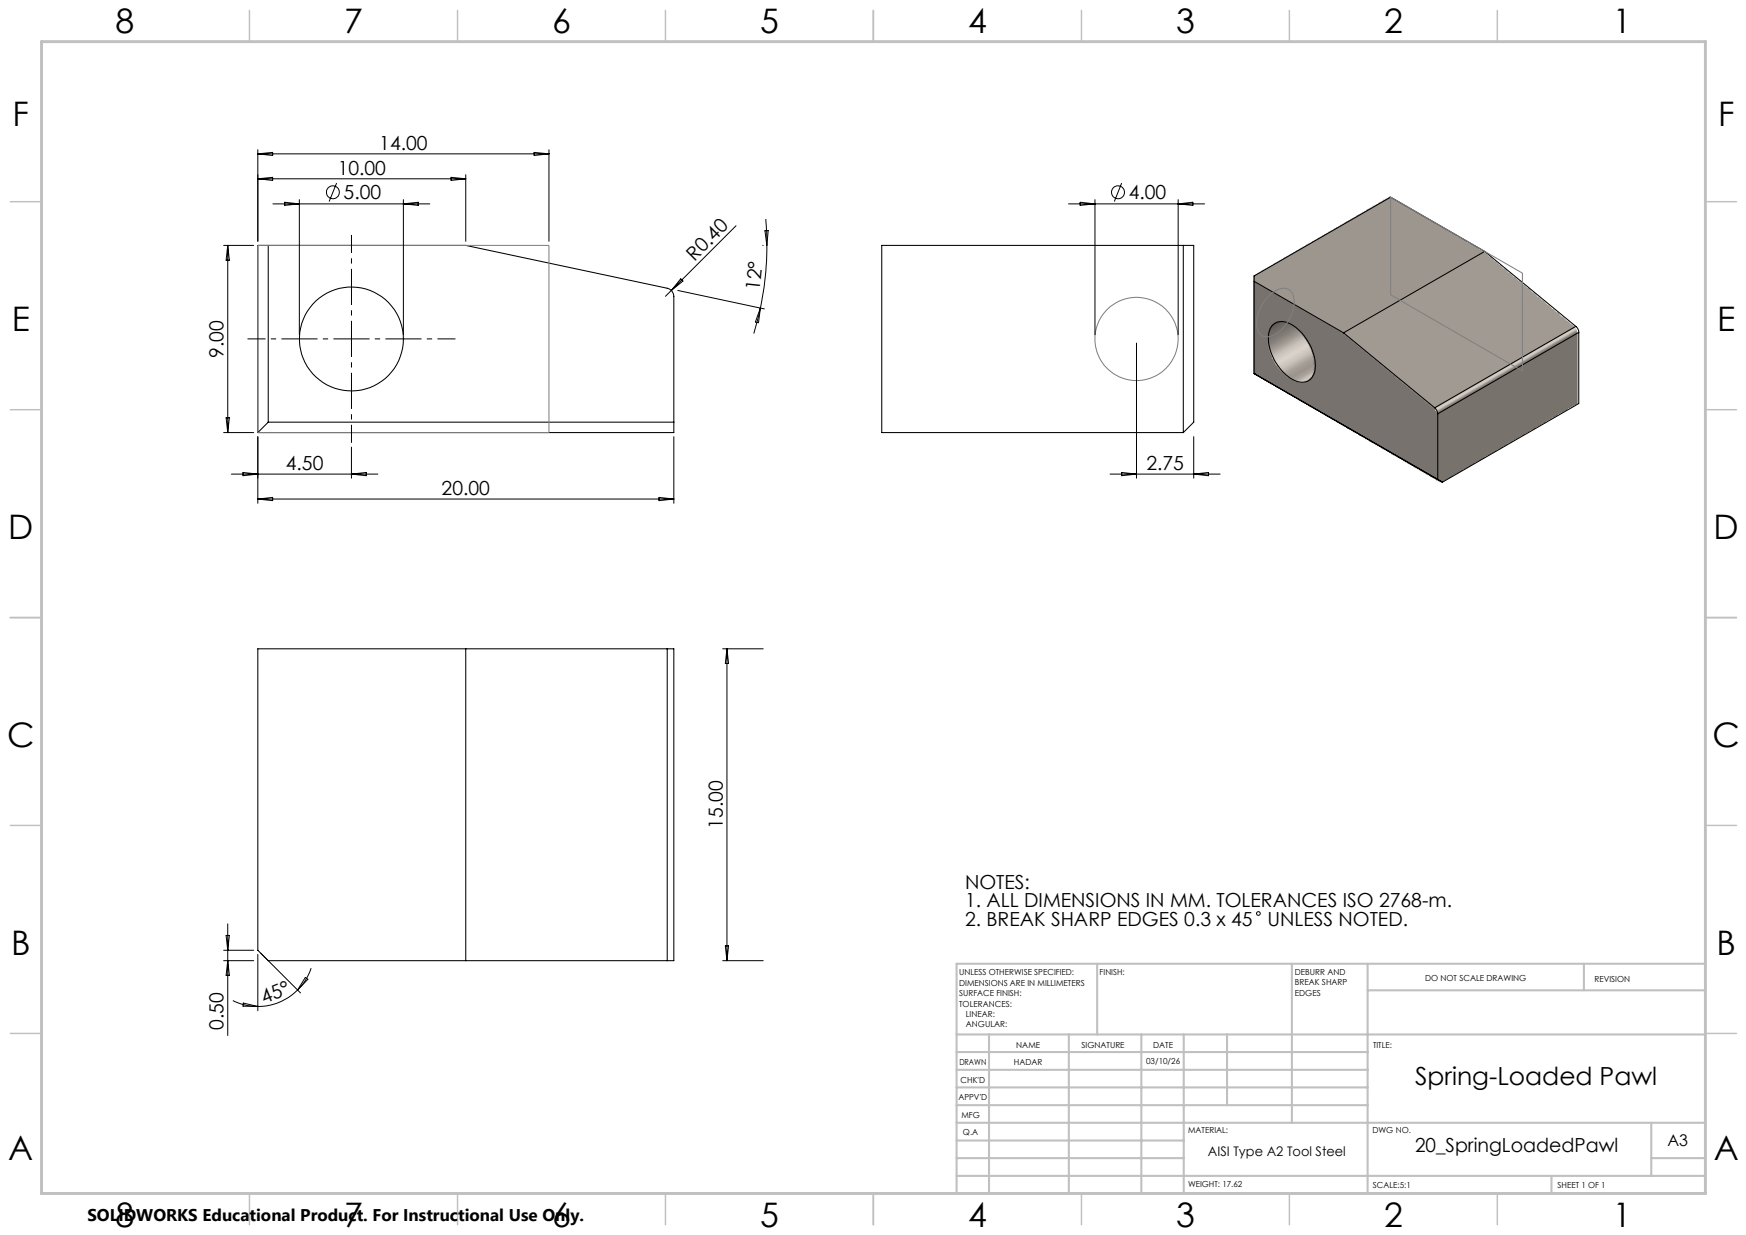
[picture p84: page 23]
FINISH:; DEBURR AND; BREAK SHARP EDGES; DO NOT SCALE DRAWING; REVISION

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

UNLESS OTHERWISE SPECIFIED:
DIMENSIONS ARE IN MILLIMETERS
SURFACE FINISH:
TOLERANCES:
LINEAR:
ANGULAR:

NAME | SIGNATURE | DATE | | | | TITLE: Spring-Loaded Pawl

DRAWN | HADAR | | 03/10/26
CHK'D
APPV'D
MFG

20_SpringLoadedPawl | A3 AISI Type A2 Tool Steel

WEIGHT: 17.62 | SCALE:5:1 | SHEET 1 OF 1

20.00

12

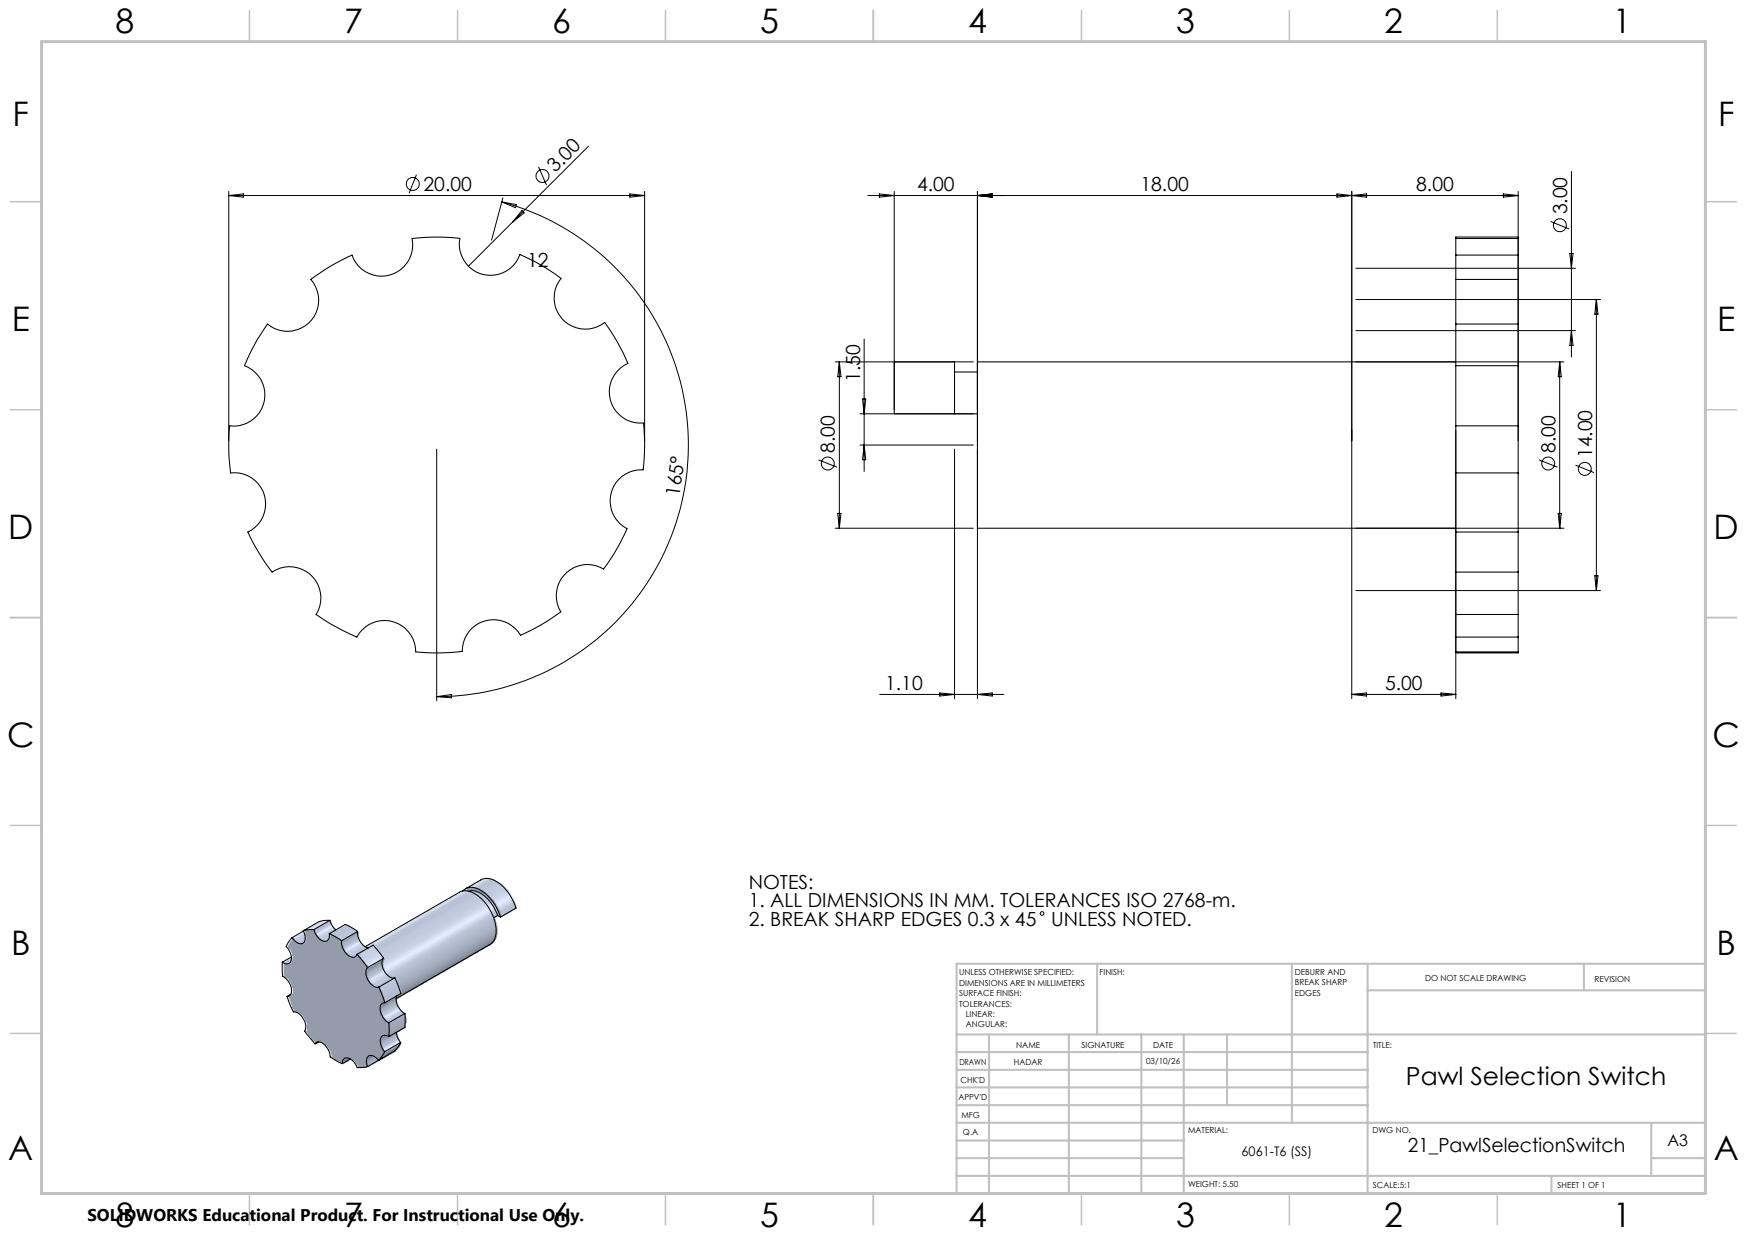
[picture p85: page 24]
FINISH:; DEBURR AND; BREAK SHARP EDGES; DO NOT SCALE DRAWING; REVISION

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

UNLESS OTHERWISE SPECIFIED:
DIMENSIONS ARE IN MILLIMETERS
SURFACE FINISH:
TOLERANCES:
LINEAR:
ANGULAR:

NAME | SIGNATURE | DATE | | | | TITLE: Pawl Selection Switch

DRAWN | HADAR | | 03/10/26
CHK'D
APPV'D
MFG

21_PawlSelectionSwitch | A3 6061-T6 (SS)

WEIGHT: 5.50 | SCALE:5:1 | SHEET 1 OF 1

E | E
F | F

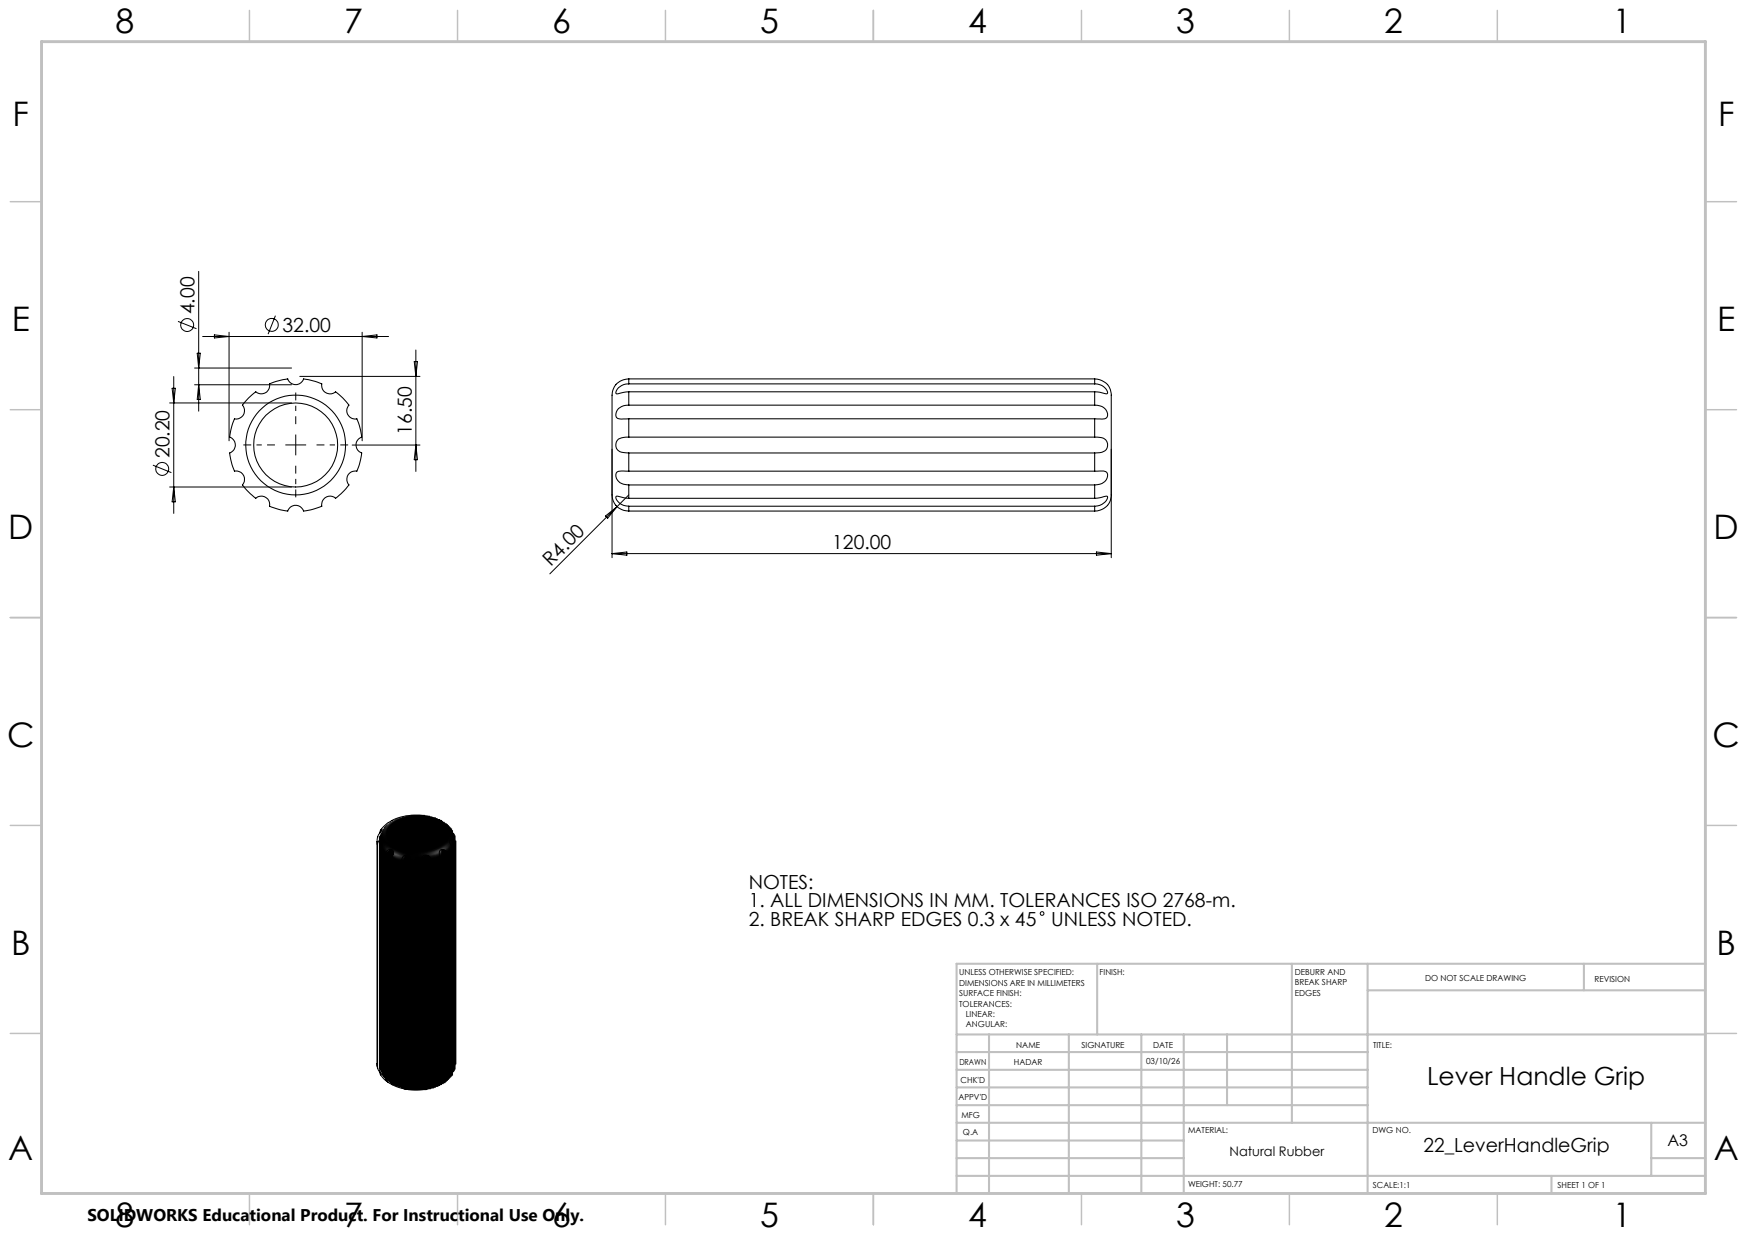
[picture p86: page 25]
FINISH:; DEBURR AND; BREAK SHARP EDGES; DO NOT SCALE DRAWING; REVISION

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

UNLESS OTHERWISE SPECIFIED:
DIMENSIONS ARE IN MILLIMETERS
SURFACE FINISH:
TOLERANCES:
LINEAR:
ANGULAR:

NAME | SIGNATURE | DATE | | | | TITLE: Lever Handle Grip

DRAWN | HADAR | | 03/10/26
CHK'D
APPV'D
MFG

22_LeverHandleGrip | A3 Natural Rubber

WEIGHT: 50.77 | SCALE:1:1 | SHEET 1 OF 1

72.00
46.00

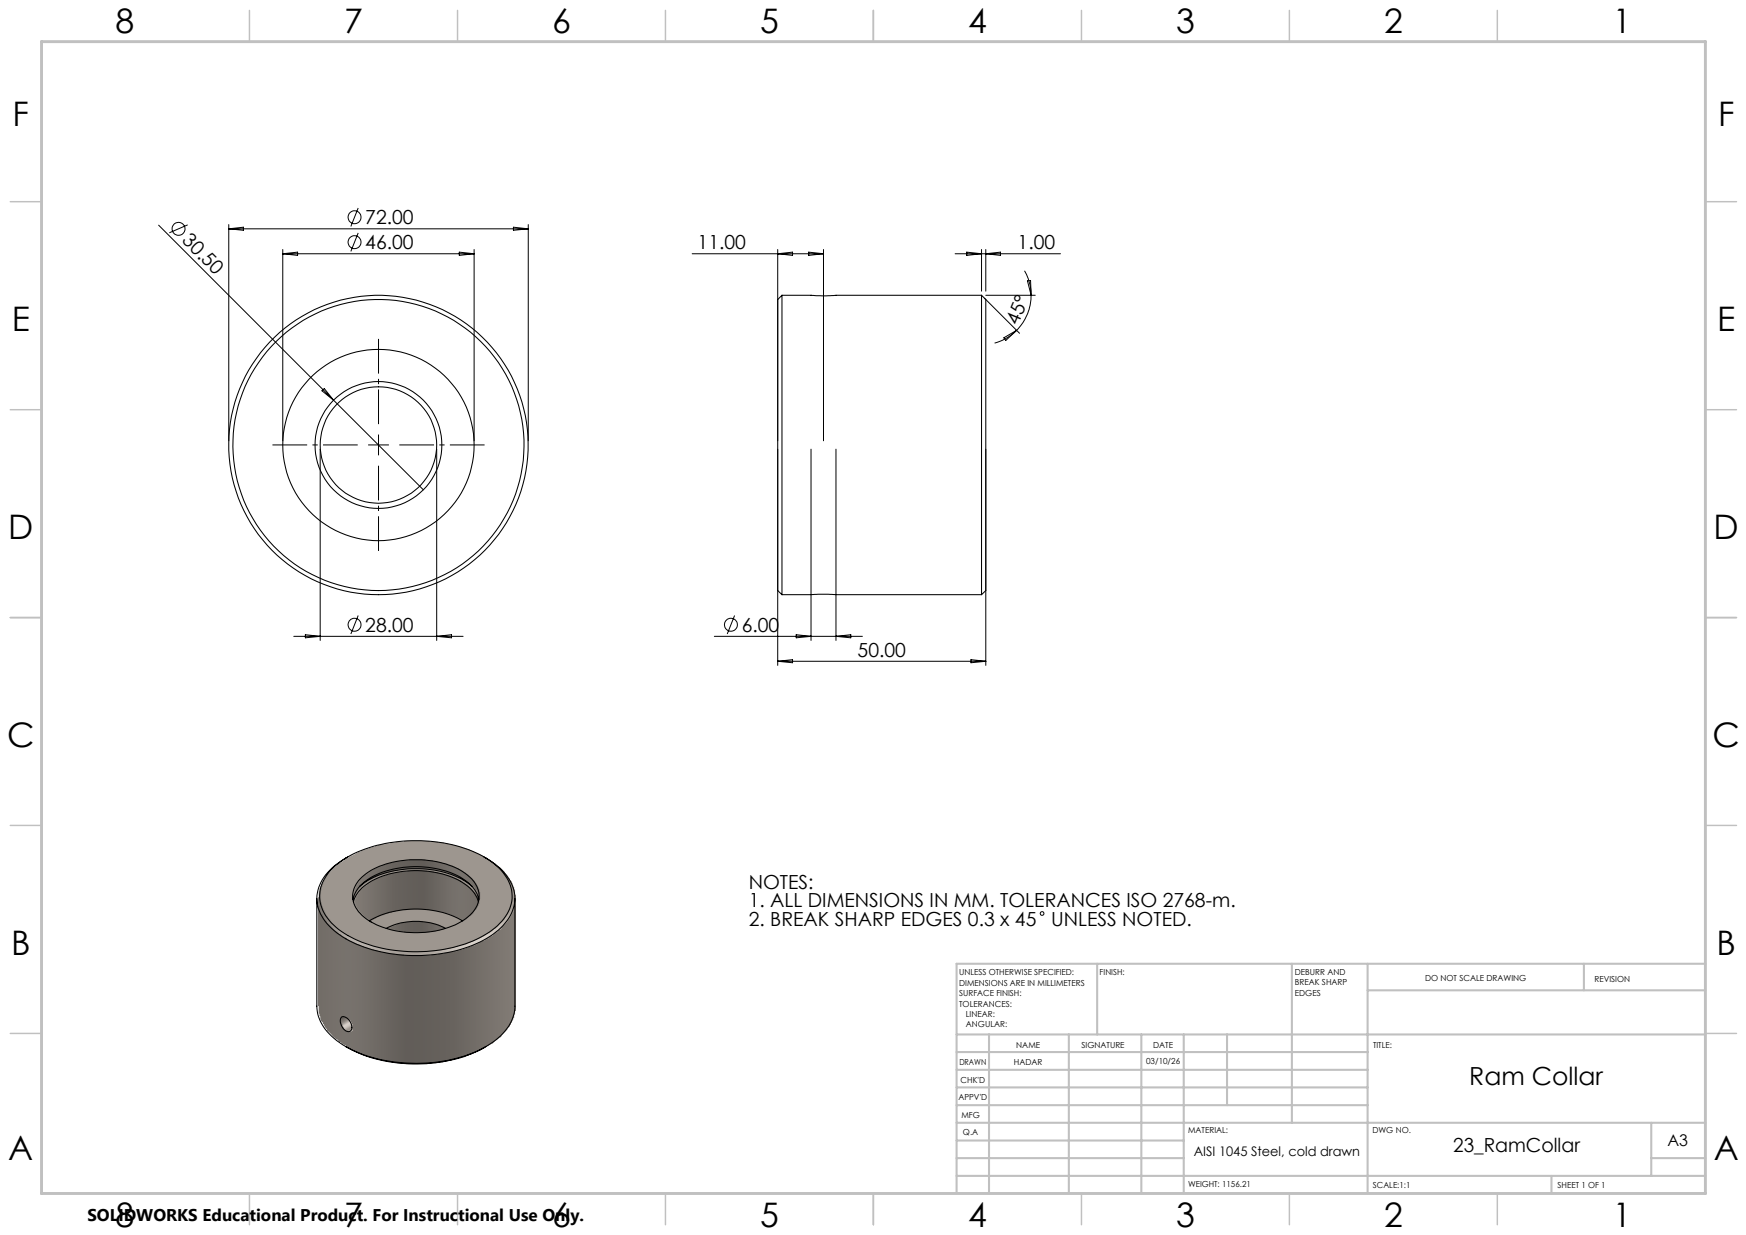
[picture p87: page 26]
FINISH:; DEBURR AND; BREAK SHARP EDGES; DO NOT SCALE DRAWING; REVISION

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

UNLESS OTHERWISE SPECIFIED:
DIMENSIONS ARE IN MILLIMETERS
SURFACE FINISH:
TOLERANCES:
LINEAR:
ANGULAR:

NAME | SIGNATURE | DATE | | | | TITLE: Ram Collar

DRAWN | HADAR | | 03/10/26
CHK'D
APPV'D
MFG

23_RamCollar | A3 AISI 1045 Steel, cold drawn

WEIGHT: 1156.21 | SCALE:1:1 | SHEET 1 OF 1

110.00
40.00

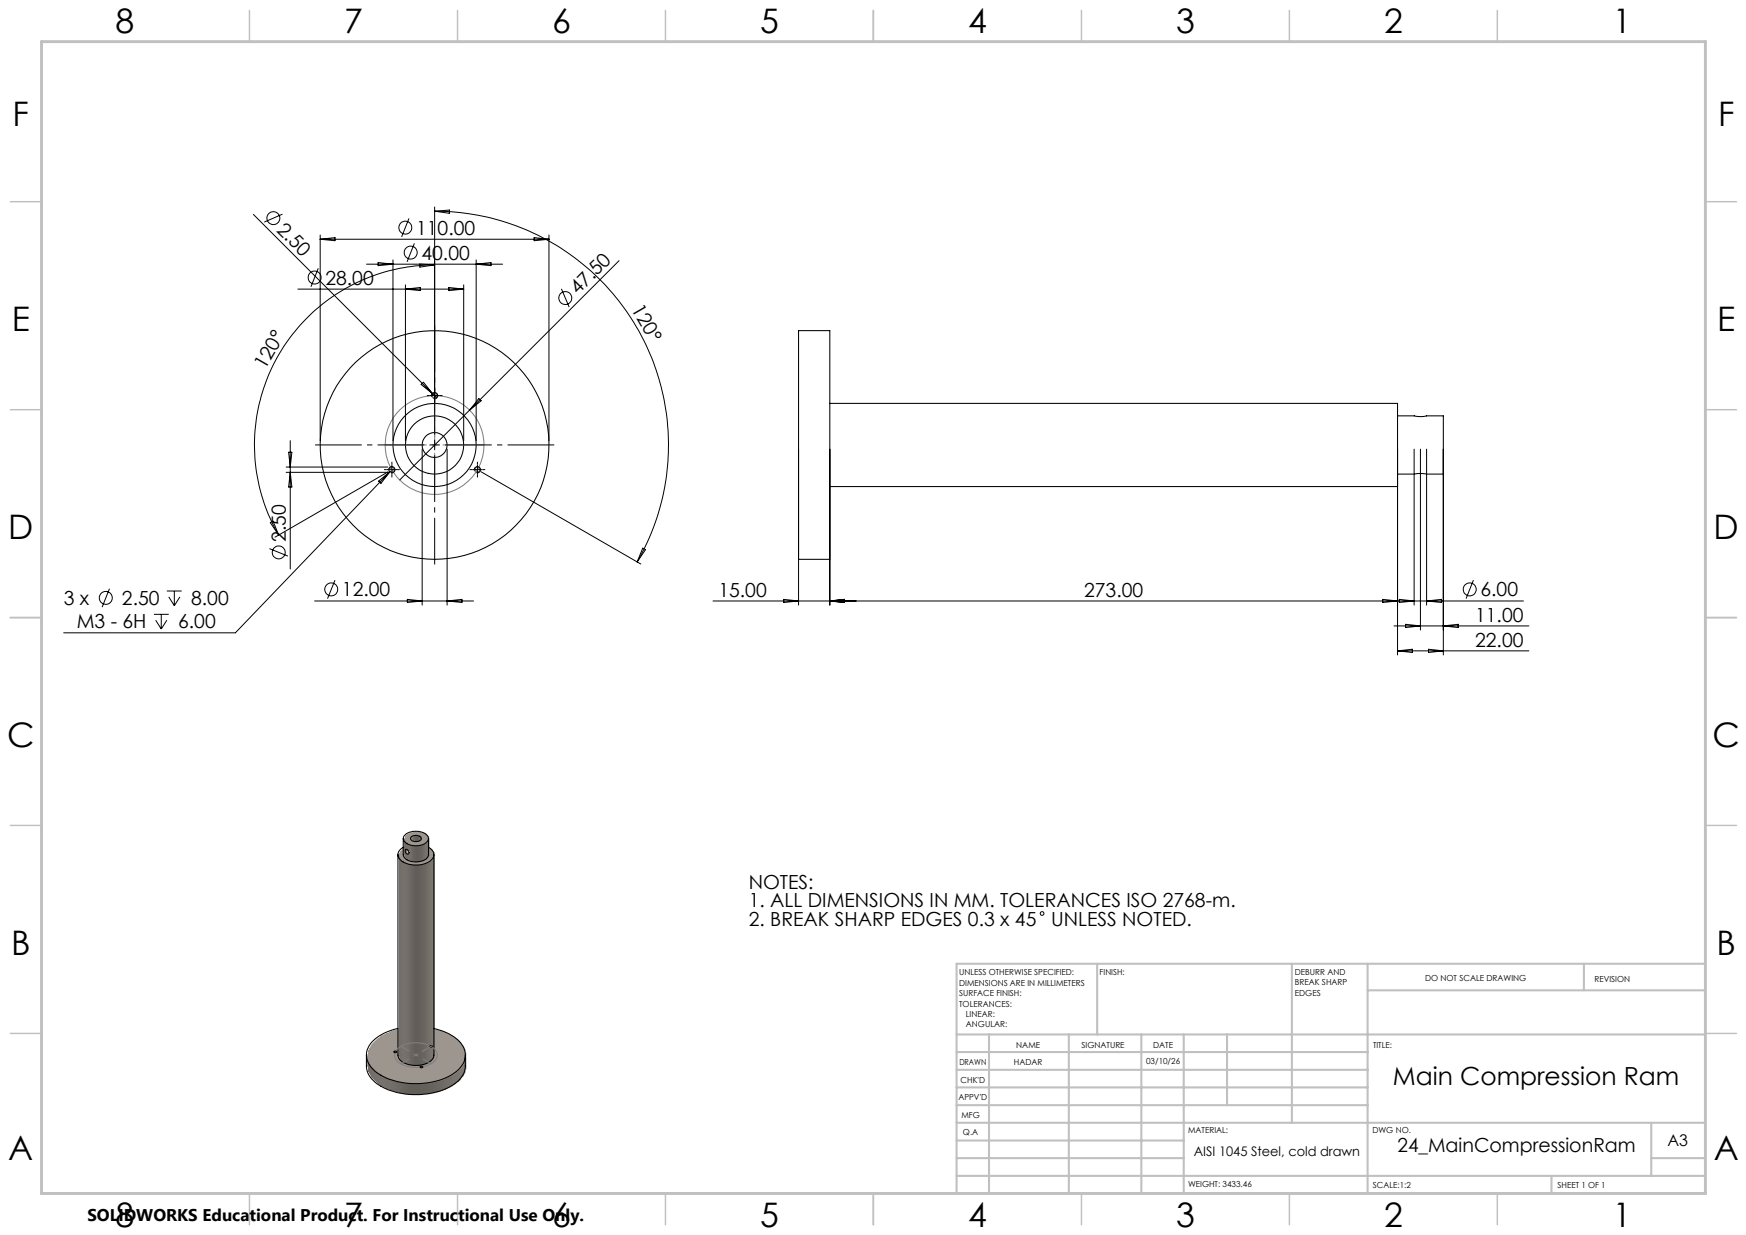
[picture p88: page 27]
FINISH:; DEBURR AND; BREAK SHARP EDGES; DO NOT SCALE DRAWING; REVISION

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

UNLESS OTHERWISE SPECIFIED:
DIMENSIONS ARE IN MILLIMETERS
SURFACE FINISH:
TOLERANCES:
LINEAR:
ANGULAR:

NAME | SIGNATURE | DATE | | | | TITLE: Main Compression Ram

DRAWN | HADAR | | 03/10/26
CHK'D
APPV'D
MFG

24_MainCompressionRam | A3 AISI 1045 Steel, cold drawn

WEIGHT: 3433.46 | SCALE:1:2 | SHEET 1 OF 1

46.00

2.00

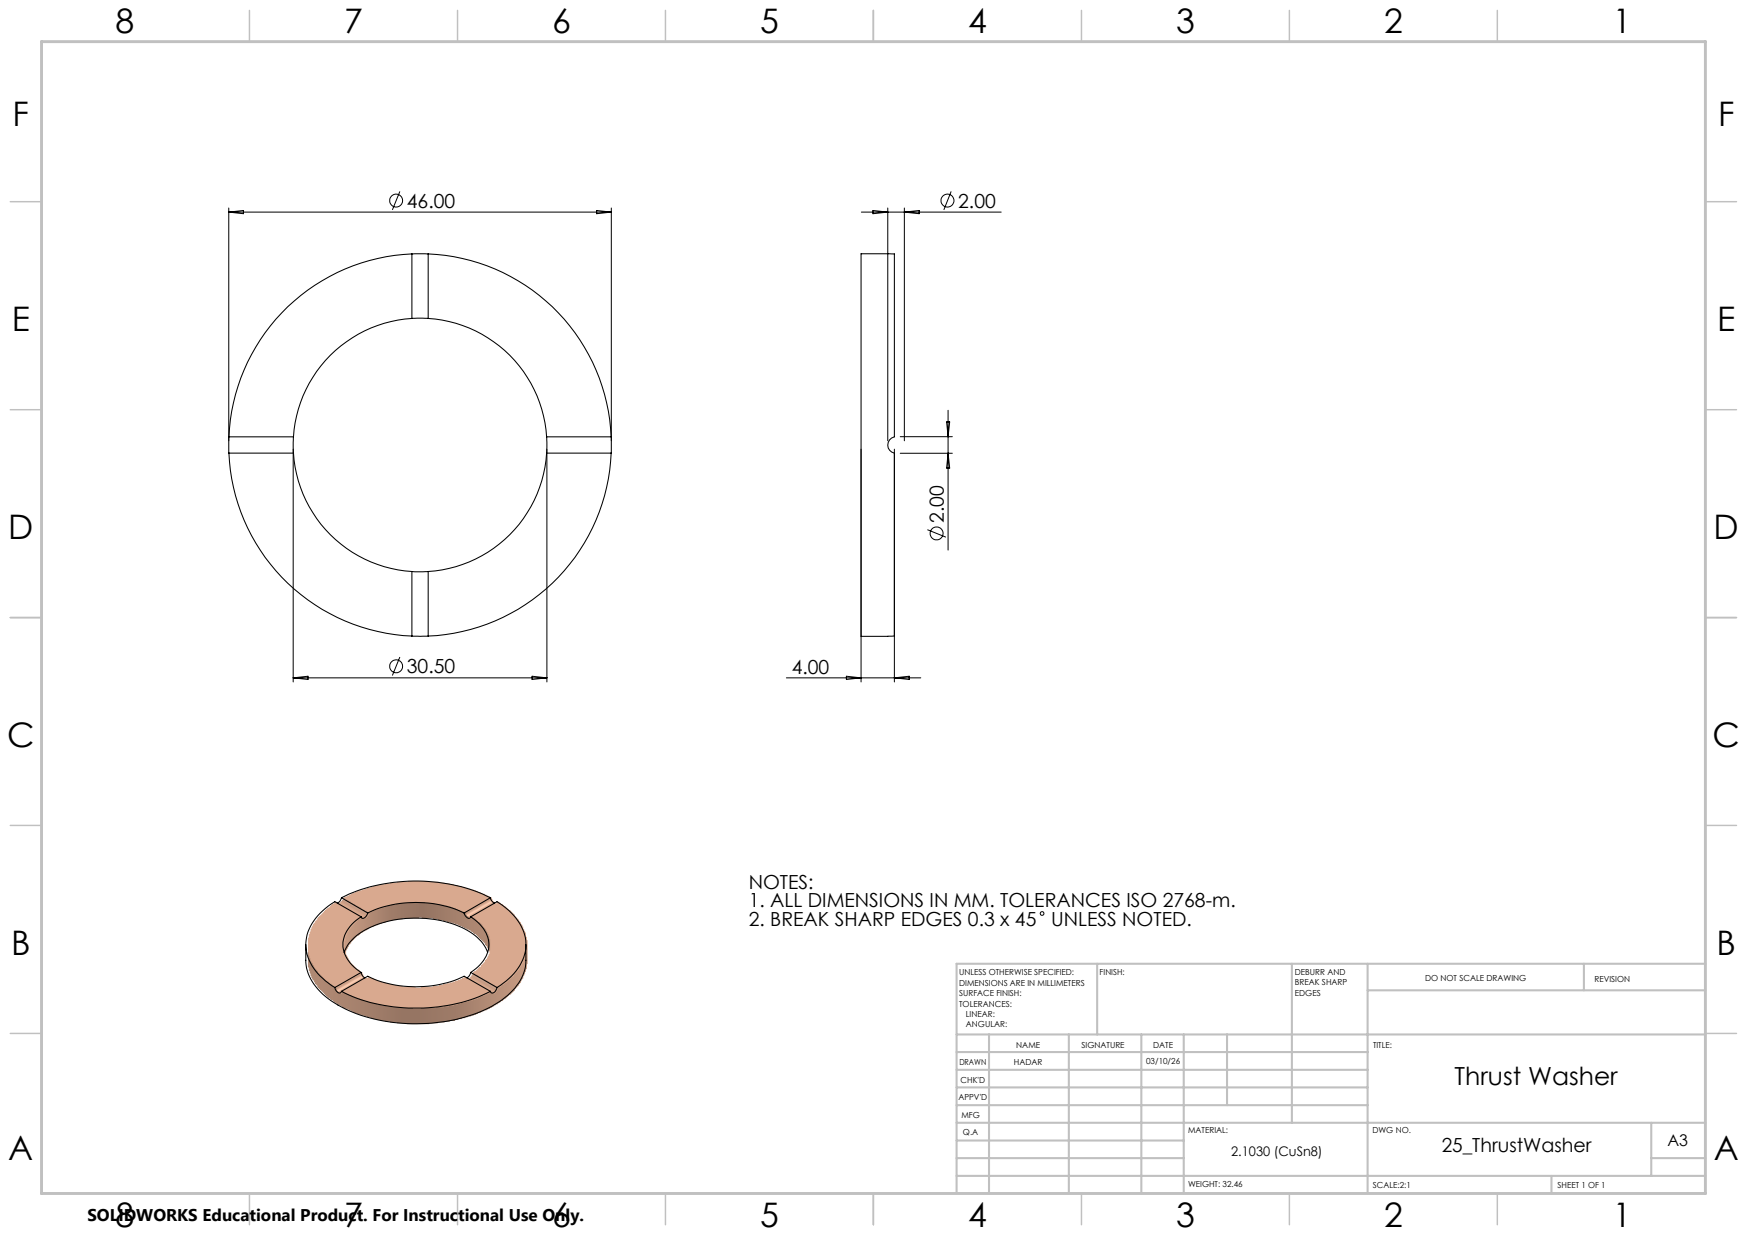
[picture p89: page 28]
FINISH:; DEBURR AND; BREAK SHARP EDGES; DO NOT SCALE DRAWING; REVISION

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

UNLESS OTHERWISE SPECIFIED:
DIMENSIONS ARE IN MILLIMETERS
SURFACE FINISH:
TOLERANCES:
LINEAR:
ANGULAR:

NAME | SIGNATURE | DATE | | | | TITLE: Thrust Washer

DRAWN | HADAR | | 03/10/26
CHK'D
APPV'D
MFG

25_ThrustWasher | A3 2.1030 (CuSn8)

WEIGHT: 32.46 | SCALE:2:1 | SHEET 1 OF 1

2 x 10.10 5.20

22.00

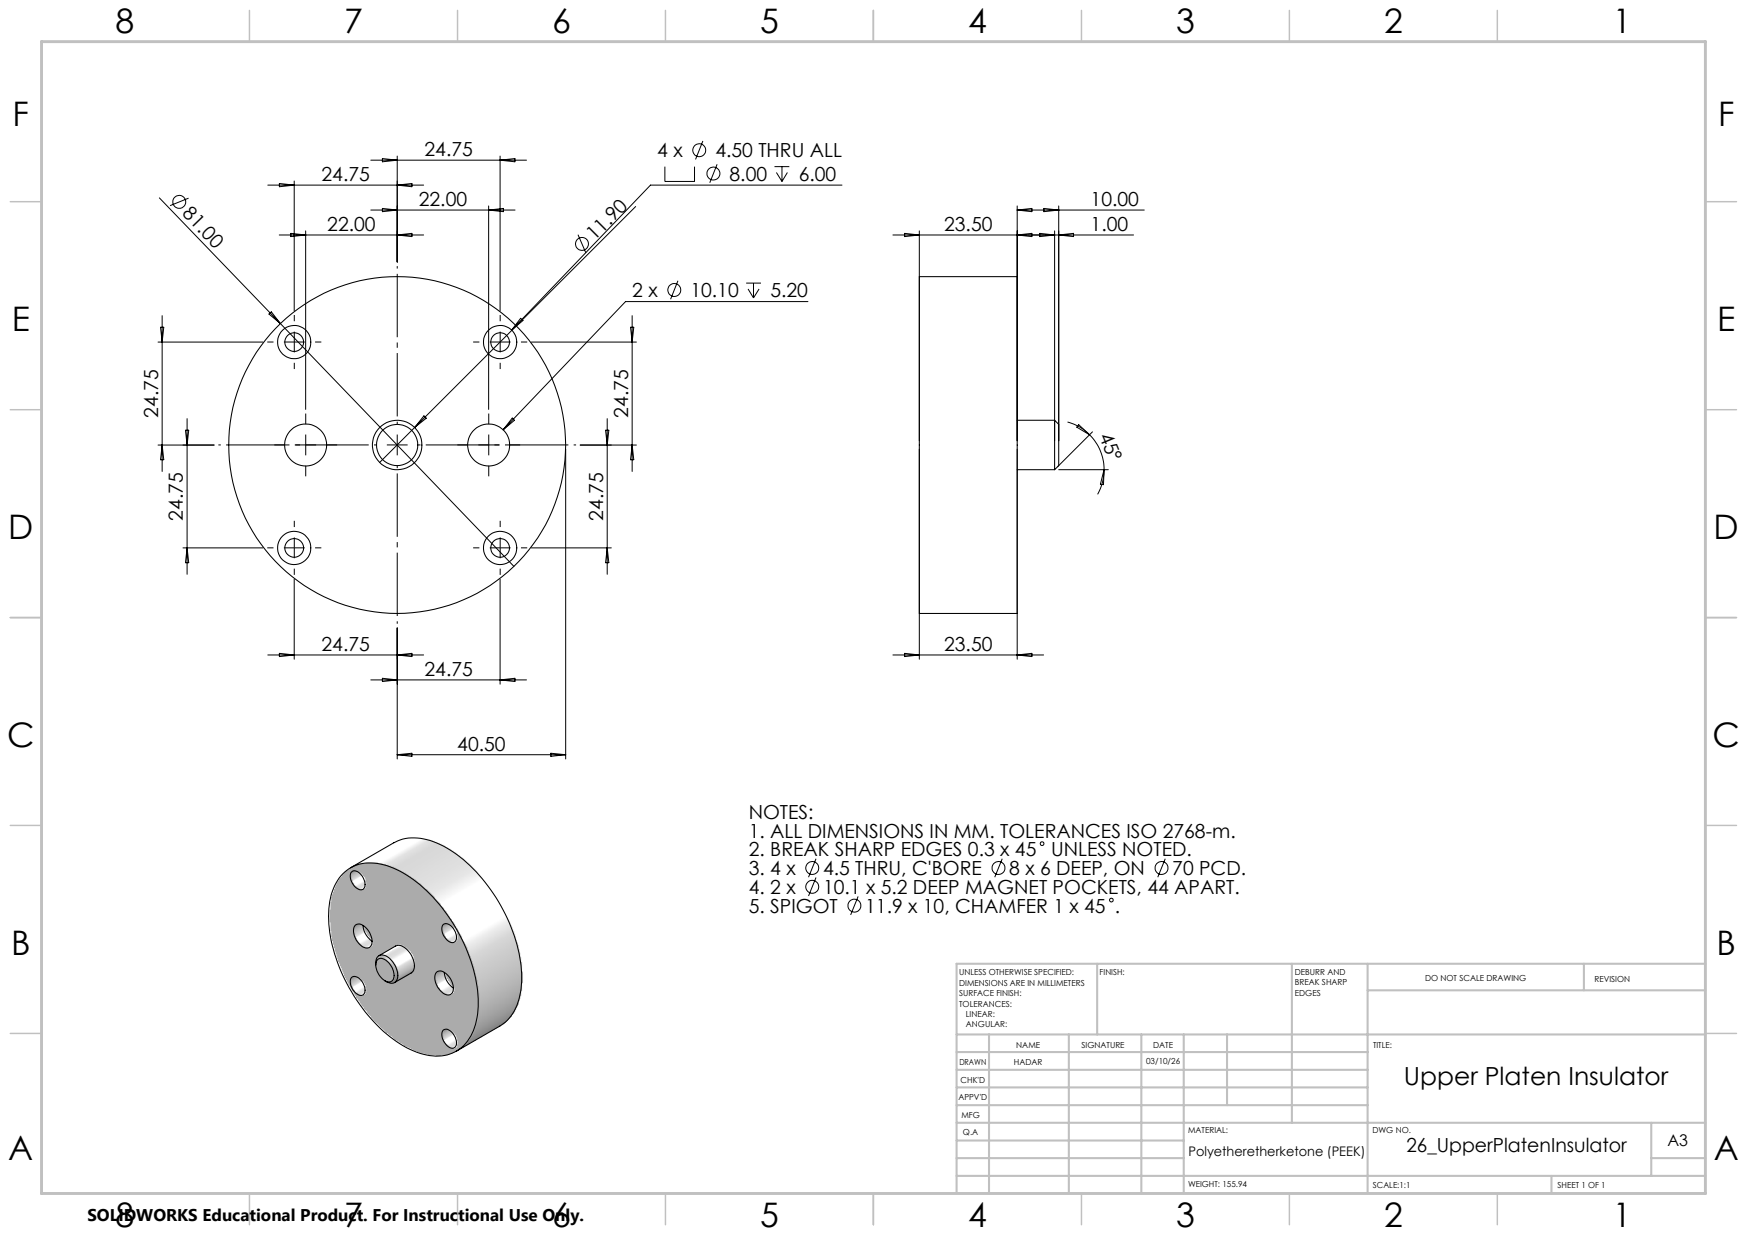
[picture p90: page 29]
4.50 THRU ALL; FINISH:; DEBURR AND; BREAK SHARP EDGES; DO NOT SCALE DRAWING; REVISION

NOTES:
1. ALL DIMENSIONS IN MM. TOLERANCES ISO 2768-m.
2. BREAK SHARP EDGES 0.3 x 45 UNLESS NOTED.
3. 4 x 4.5 THRU, C'BORE 8 x 6 DEEP, ON 70 PCD.
4. 2 x 10.1 x 5.2 DEEP MAGNET POCKETS, 44 APART.
5. SPIGOT 11.9 x 10, CHAMFER 1 x 45 .

UNLESS OTHERWISE SPECIFIED:
DIMENSIONS ARE IN MILLIMETERS
SURFACE FINISH:
TOLERANCES:
LINEAR:
ANGULAR:

NAME | SIGNATURE | DATE | | | | TITLE: Upper Platen Insulator

DRAWN | HADAR | | 03/10/26
CHK'D
APPV'D
MFG

26_UpperPlatenInsulator | A3 Polyetheretherketone (PEEK)

WEIGHT: 155.94 | SCALE:1:1 | SHEET 1 OF 1

4 x 3.30 8.00

24.75

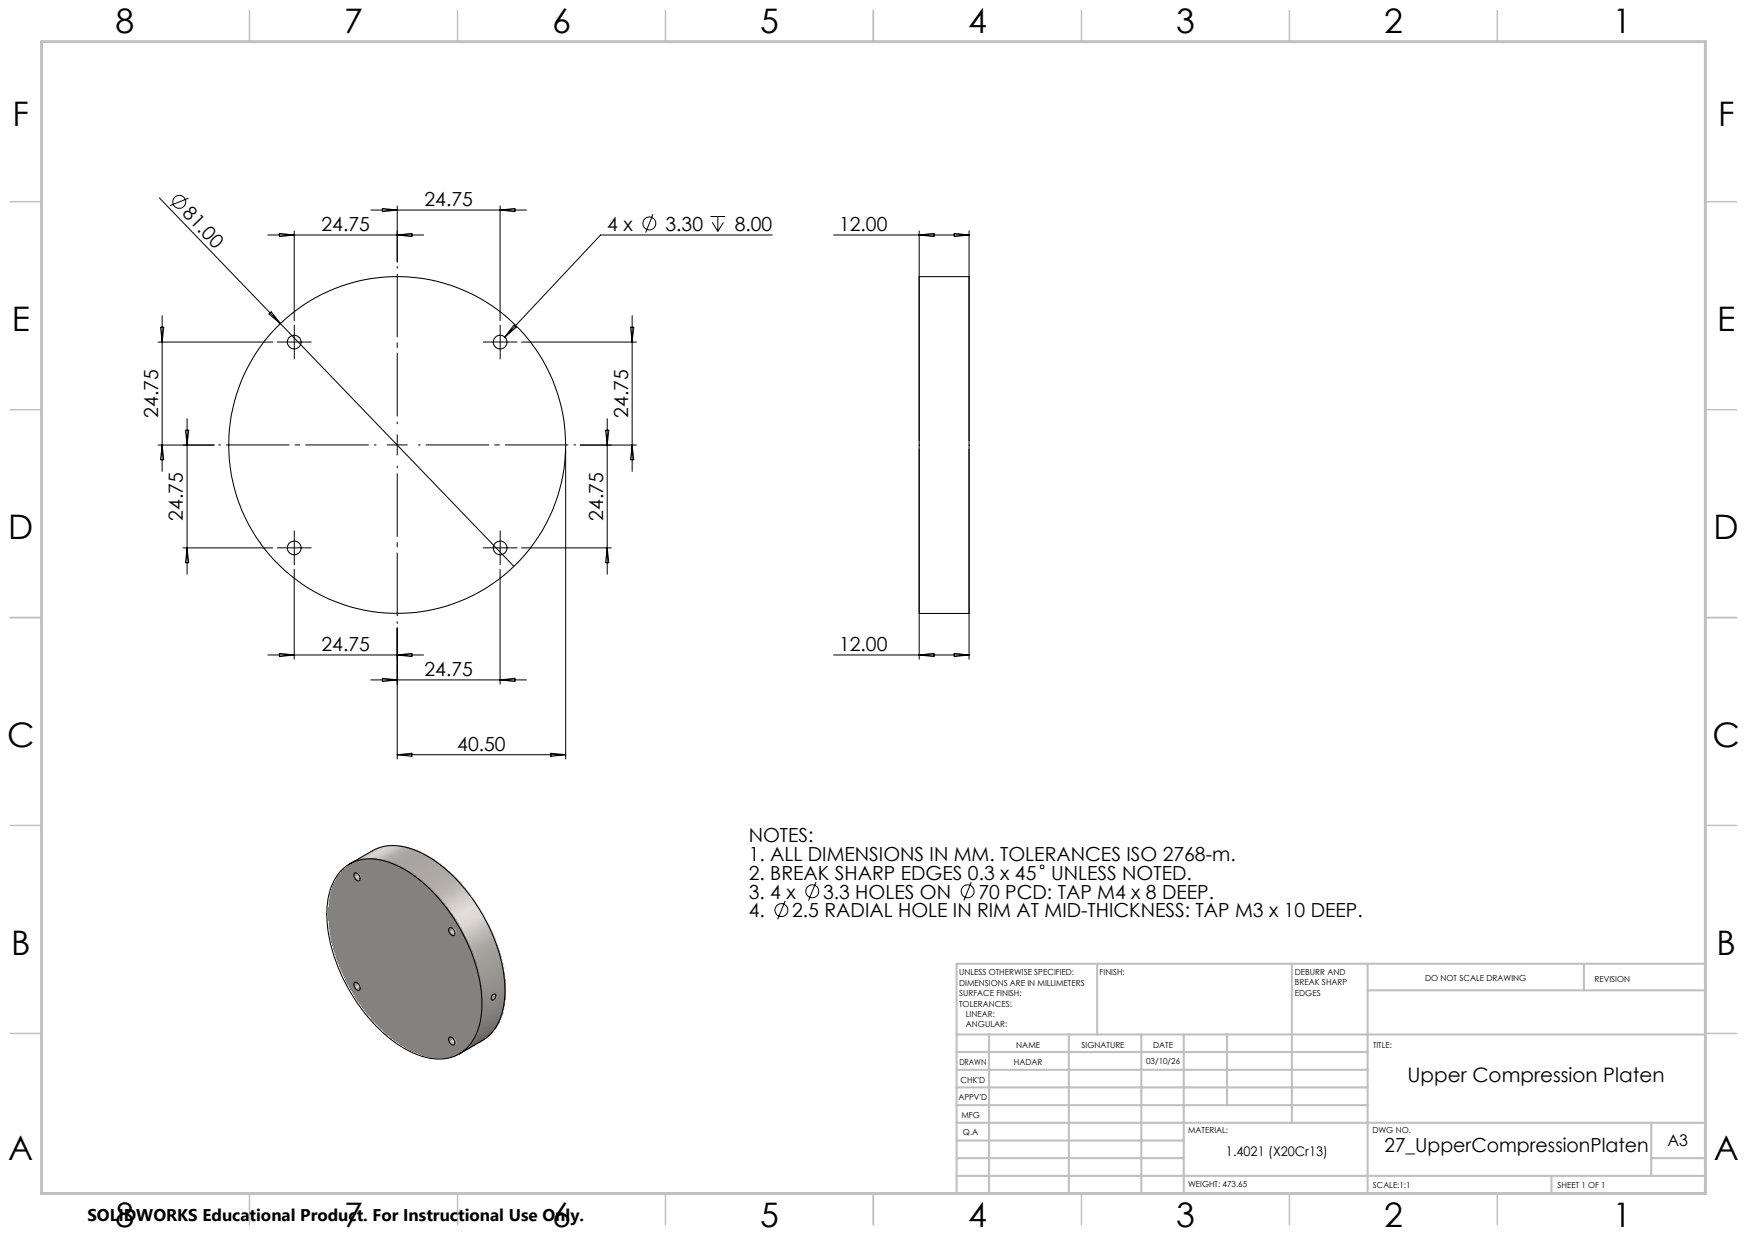
[picture p91: page 30]
FINISH:; DEBURR AND; BREAK SHARP EDGES; DO NOT SCALE DRAWING; REVISION

NOTES:
1. ALL DIMENSIONS IN MM. TOLERANCES ISO 2768-m.
2. BREAK SHARP EDGES 0.3 x 45 UNLESS NOTED.
3. 4 x 3.3 HOLES ON 70 PCD: TAP M4 x 8 DEEP.
4. 2.5 RADIAL HOLE IN RIM AT MID-THICKNESS: TAP M3 x 10 DEEP.

UNLESS OTHERWISE SPECIFIED:
DIMENSIONS ARE IN MILLIMETERS
SURFACE FINISH:
TOLERANCES:
LINEAR:
ANGULAR:

NAME | SIGNATURE | DATE | | | | TITLE: Upper Compression Platen

DRAWN | HADAR | | 03/10/26
CHK'D
APPV'D
MFG

27_UpperCompressionPlaten | A3 1.4021 (X20Cr13)

WEIGHT: 473.65 | SCALE:1:1 | SHEET 1 OF 1

E | E
F | F

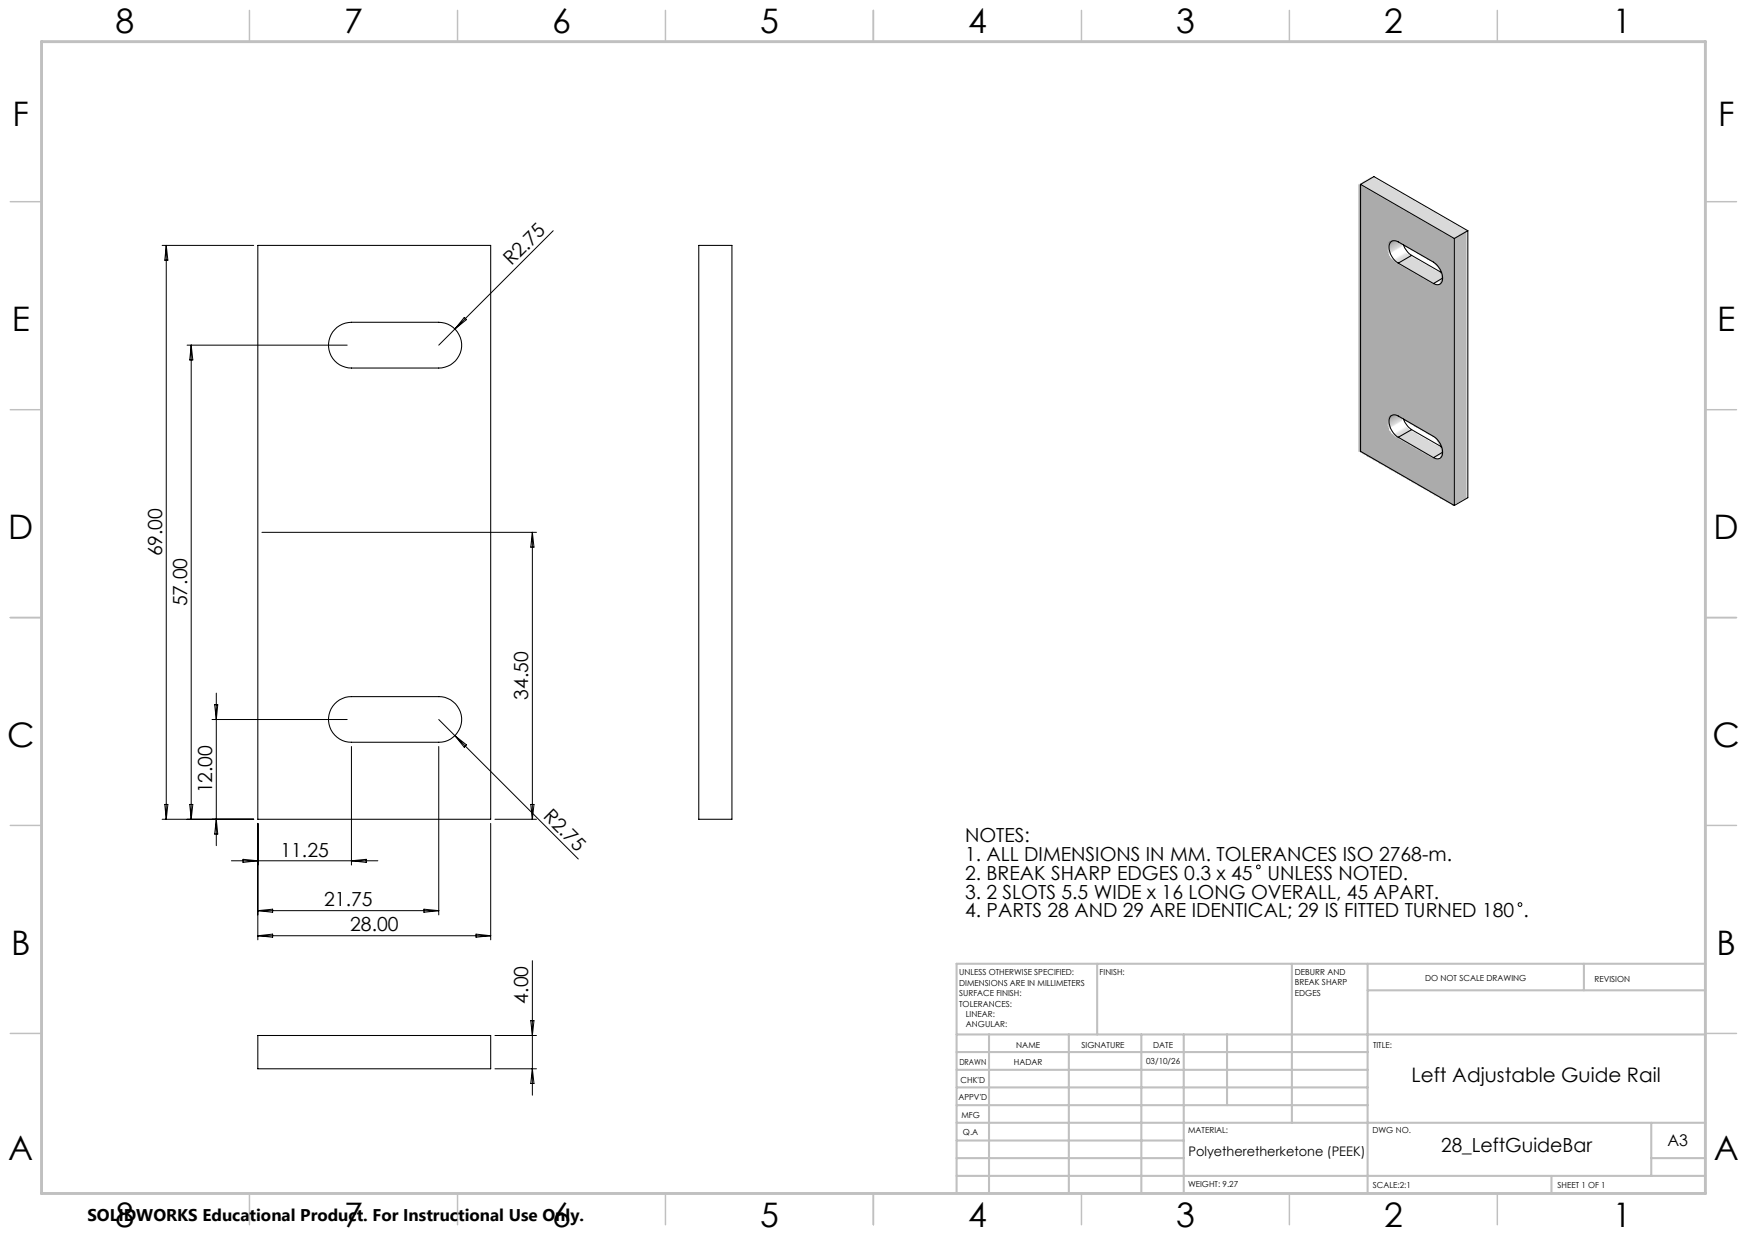
[picture p92: page 31]
FINISH:; DEBURR AND; BREAK SHARP EDGES; DO NOT SCALE DRAWING; REVISION

NOTES:
1. ALL DIMENSIONS IN MM. TOLERANCES ISO 2768-m.
2. BREAK SHARP EDGES 0.3 x 45 UNLESS NOTED.
3. 2 SLOTS 5.5 WIDE x 16 LONG OVERALL, 45 APART.
4. PARTS 28 AND 29 ARE IDENTICAL; 29 IS FITTED TURNED 180 .

UNLESS OTHERWISE SPECIFIED:
DIMENSIONS ARE IN MILLIMETERS
SURFACE FINISH:
TOLERANCES:
LINEAR:
ANGULAR:

NAME | SIGNATURE | DATE | | | | TITLE: Left Adjustable Guide Rail

DRAWN | HADAR | | 03/10/26
CHK'D
APPV'D
MFG

28_LeftGuideBar | A3 Polyetheretherketone (PEEK)

WEIGHT: 9.27 | SCALE:2:1 | SHEET 1 OF 1

E | E
F | F

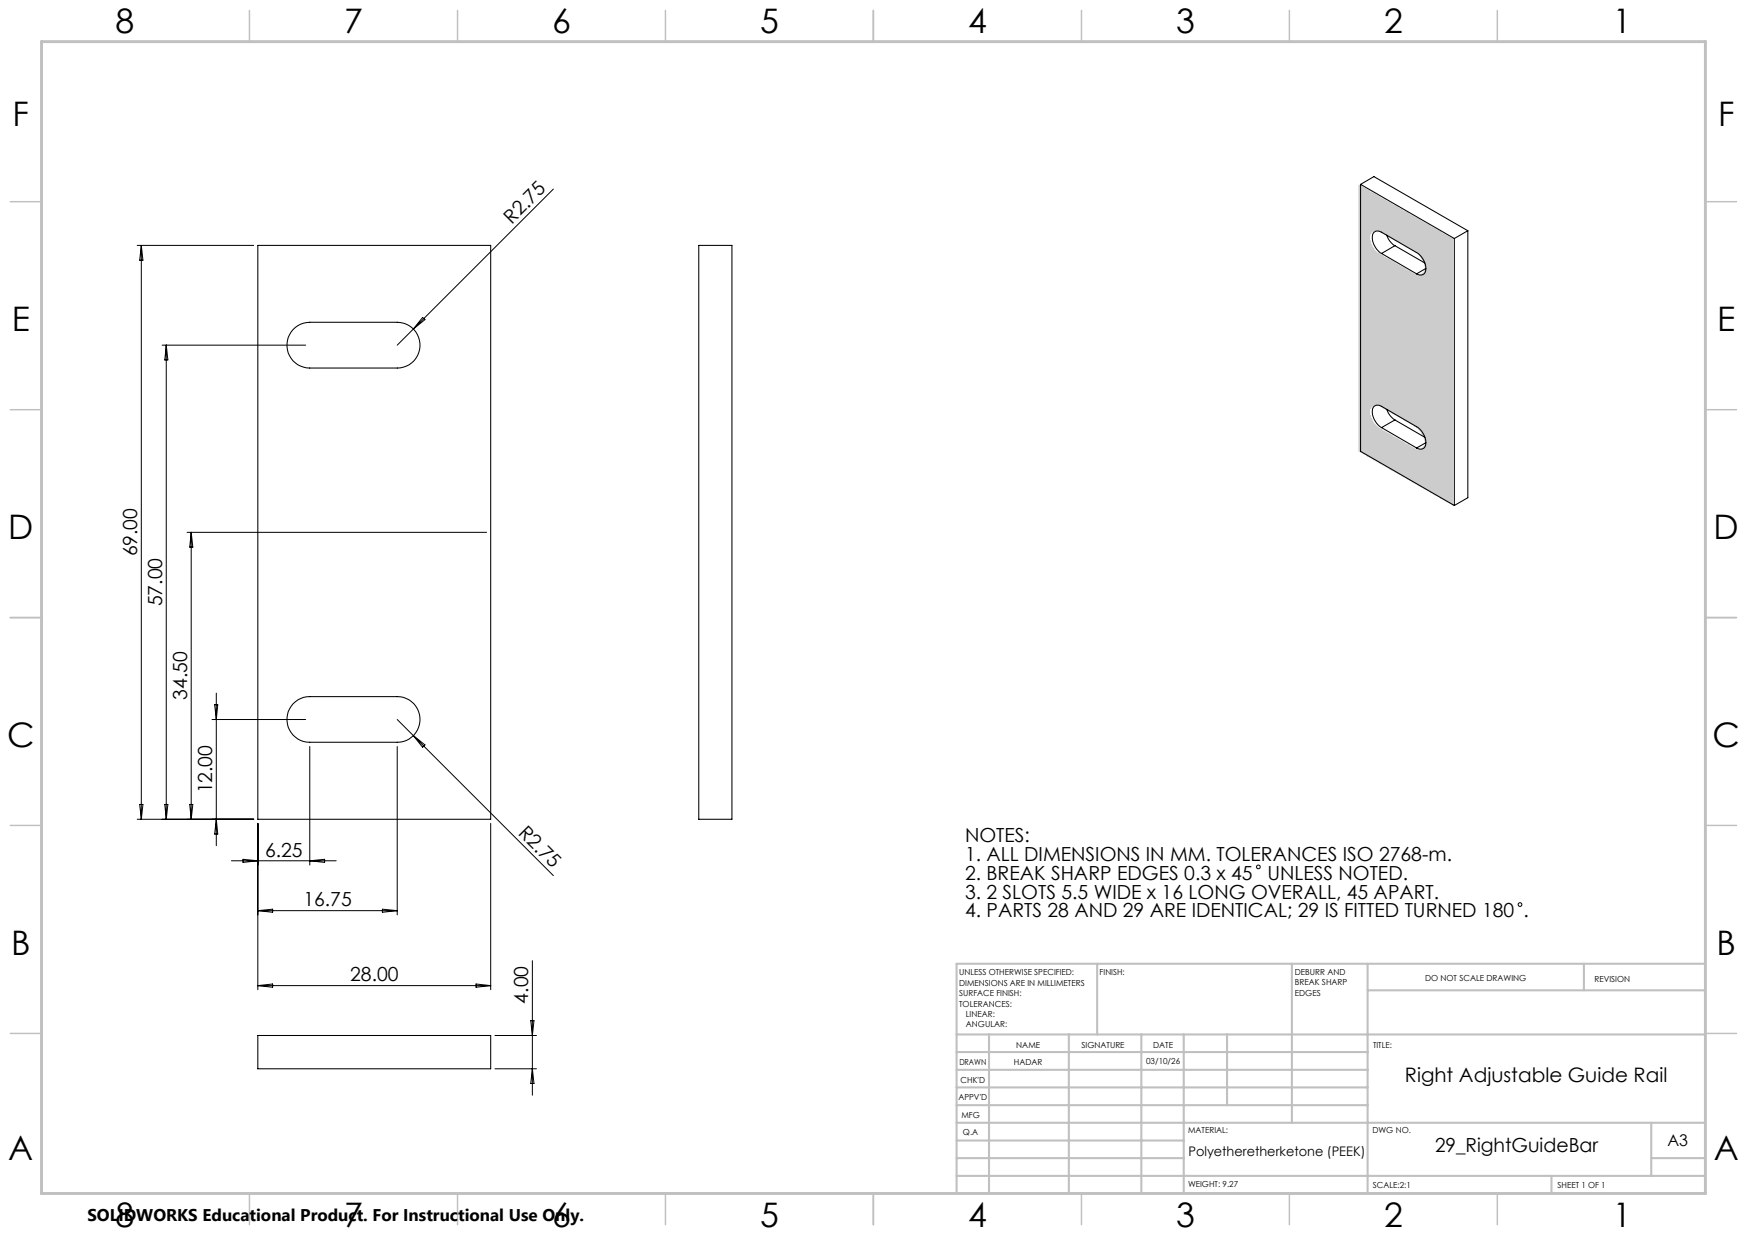
[picture p93: page 32]
FINISH:; DEBURR AND; BREAK SHARP EDGES; DO NOT SCALE DRAWING; REVISION

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

UNLESS OTHERWISE SPECIFIED:
DIMENSIONS ARE IN MILLIMETERS
SURFACE FINISH:
TOLERANCES:
LINEAR:
ANGULAR:

NAME | SIGNATURE | DATE | | | | TITLE: Right Adjustable Guide Rail

DRAWN | HADAR | | 03/10/26
CHK'D
APPV'D
MFG

29_RightGuideBar | A3 Polyetheretherketone (PEEK)

WEIGHT: 9.27 | SCALE:2:1 | SHEET 1 OF 1

90.00

56.00 4.00

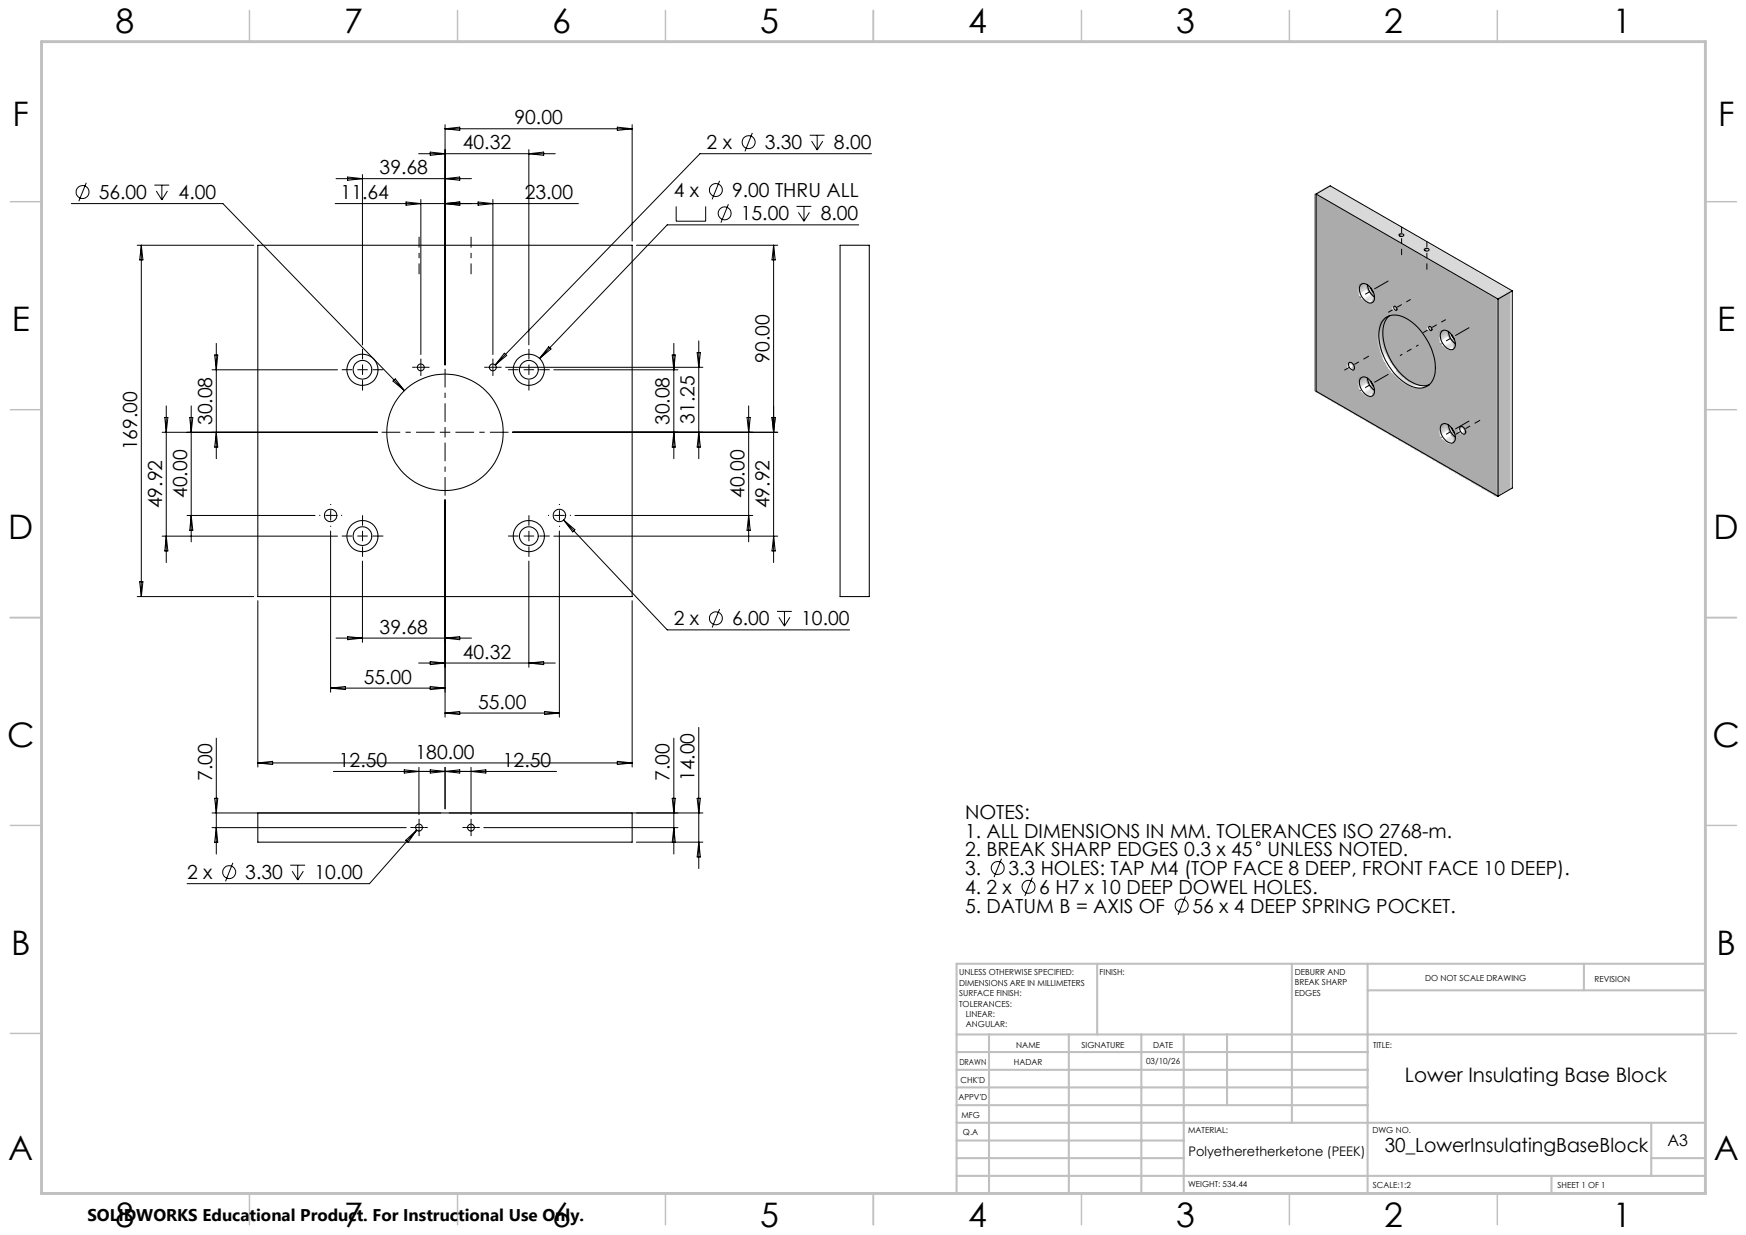
[picture p94: page 33]
9.00 THRU ALL; FINISH:; DEBURR AND; BREAK SHARP EDGES; DO NOT SCALE DRAWING; REVISION

NOTES:
1. ALL DIMENSIONS IN MM. TOLERANCES ISO 2768-m.
2. BREAK SHARP EDGES 0.3 x 45 UNLESS NOTED.
3. 3.3 HOLES: TAP M4 (TOP FACE 8 DEEP, FRONT FACE 10 DEEP).
4. 2 x 6 H7 x 10 DEEP DOWEL HOLES.
5. DATUM B = AXIS OF 56 x 4 DEEP SPRING POCKET.

UNLESS OTHERWISE SPECIFIED:
DIMENSIONS ARE IN MILLIMETERS
SURFACE FINISH:
TOLERANCES:
LINEAR:
ANGULAR:

NAME | SIGNATURE | DATE | | | | TITLE: Lower Insulating Base Block

DRAWN | HADAR | | 03/10/26
CHK'D
APPV'D
MFG

30_LowerInsulatingBaseBlock | A3 Polyetheretherketone (PEEK)

WEIGHT: 534.44 | SCALE:1:2 | SHEET 1 OF 1

4 x 4.20 8.00

47.00

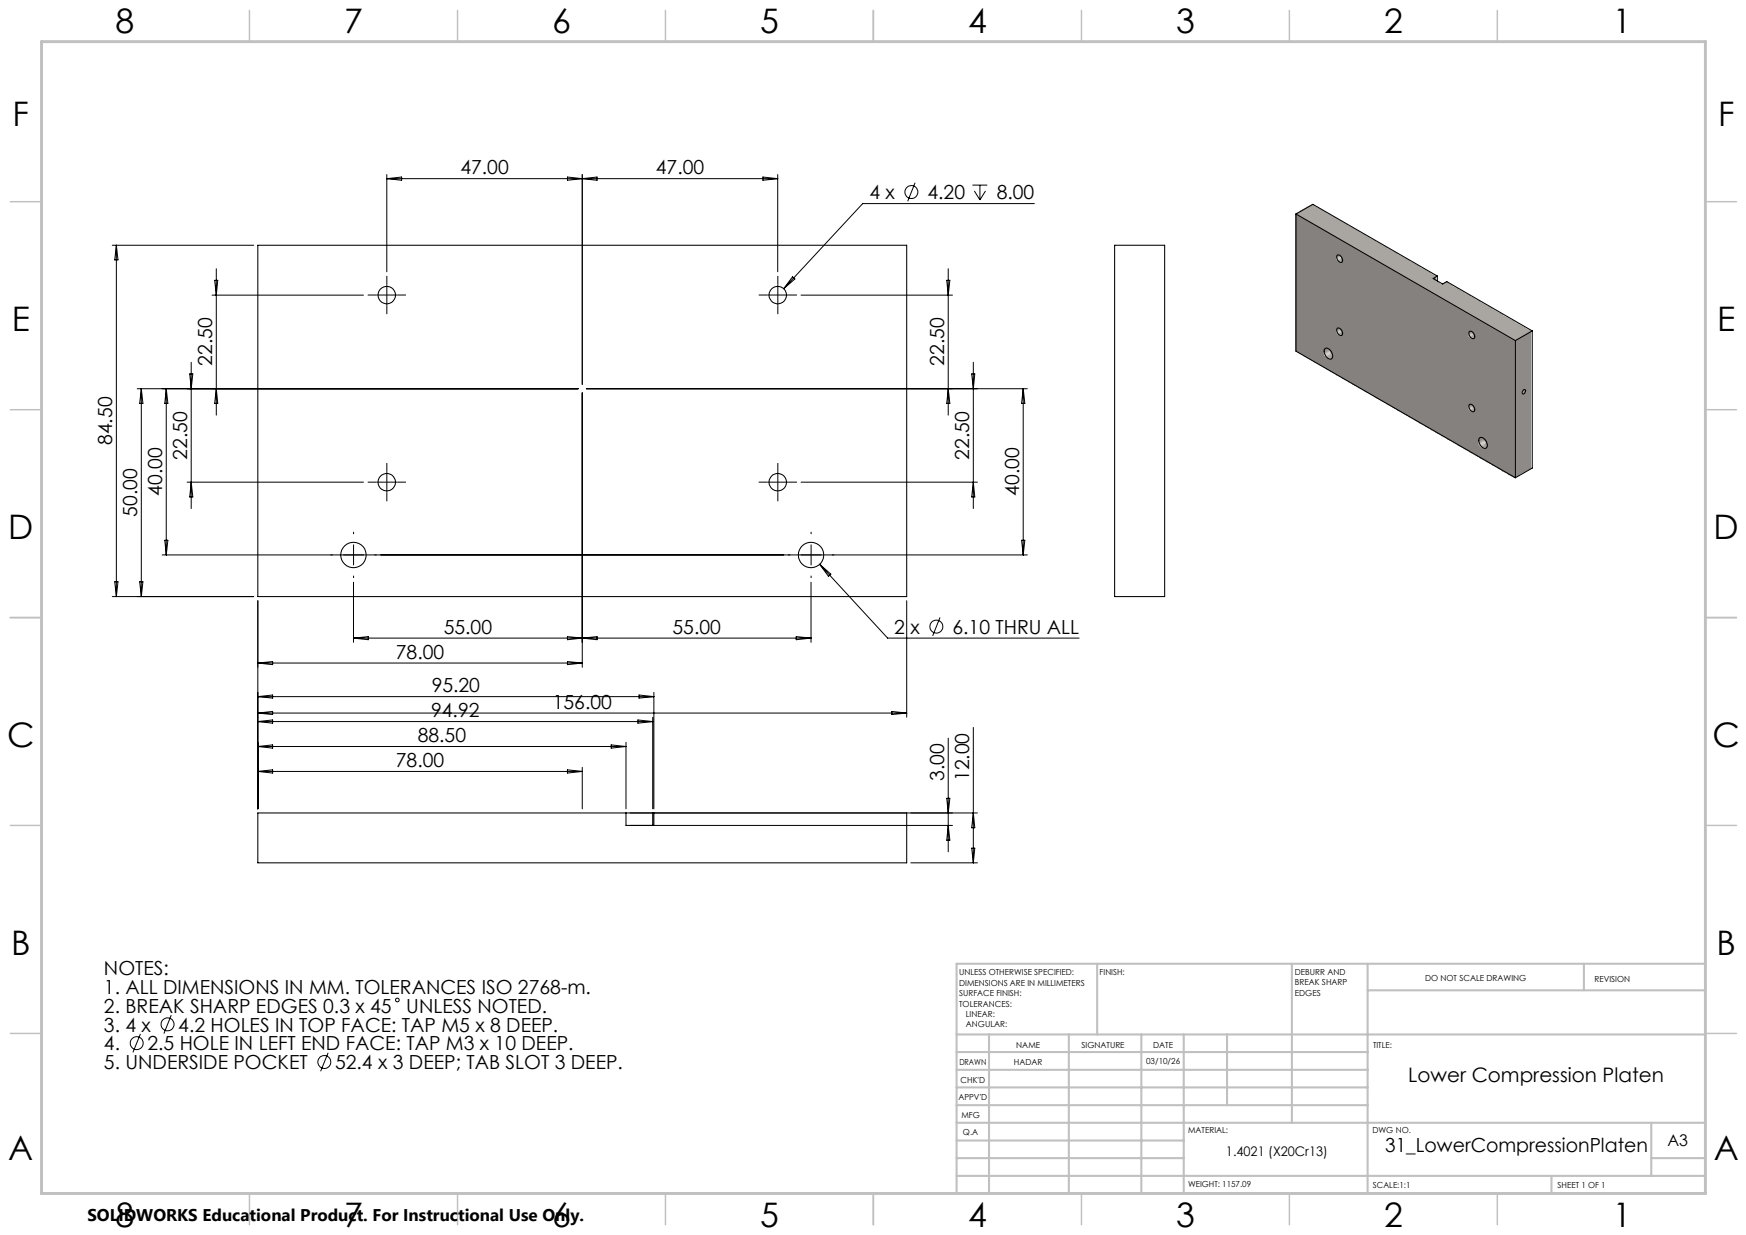
[picture p95: page 34]
6.10 THRU ALL; 5. UNDERSIDE POCKET 52.4 x 3 DEEP; TAB SLOT 3 DEEP.; Lower Compression Platen; FINISH:; DEBURR AND; BREAK SHARP EDGES; DO NOT SCALE DRAWING; REVISION

NOTES:
1. ALL DIMENSIONS IN MM. TOLERANCES ISO 2768-m.
2. BREAK SHARP EDGES 0.3 x 45 UNLESS NOTED.
3. 4 x 4.2 HOLES IN TOP FACE: TAP M5 x 8 DEEP.
4. 2.5 HOLE IN LEFT END FACE: TAP M3 x 10 DEEP.

UNLESS OTHERWISE SPECIFIED:
DIMENSIONS ARE IN MILLIMETERS
SURFACE FINISH:
TOLERANCES:
LINEAR:
ANGULAR:

NAME | SIGNATURE | DATE | | | | TITLE:

DRAWN | HADAR | | 03/10/26
CHK'D
APPV'D
MFG

31_LowerCompressionPlaten | A3 1.4021 (X20Cr13)

WEIGHT: 1157.09 | SCALE:1:1 | SHEET 1 OF 1

2 x | 4.20 44.69 | 12.50

12.50

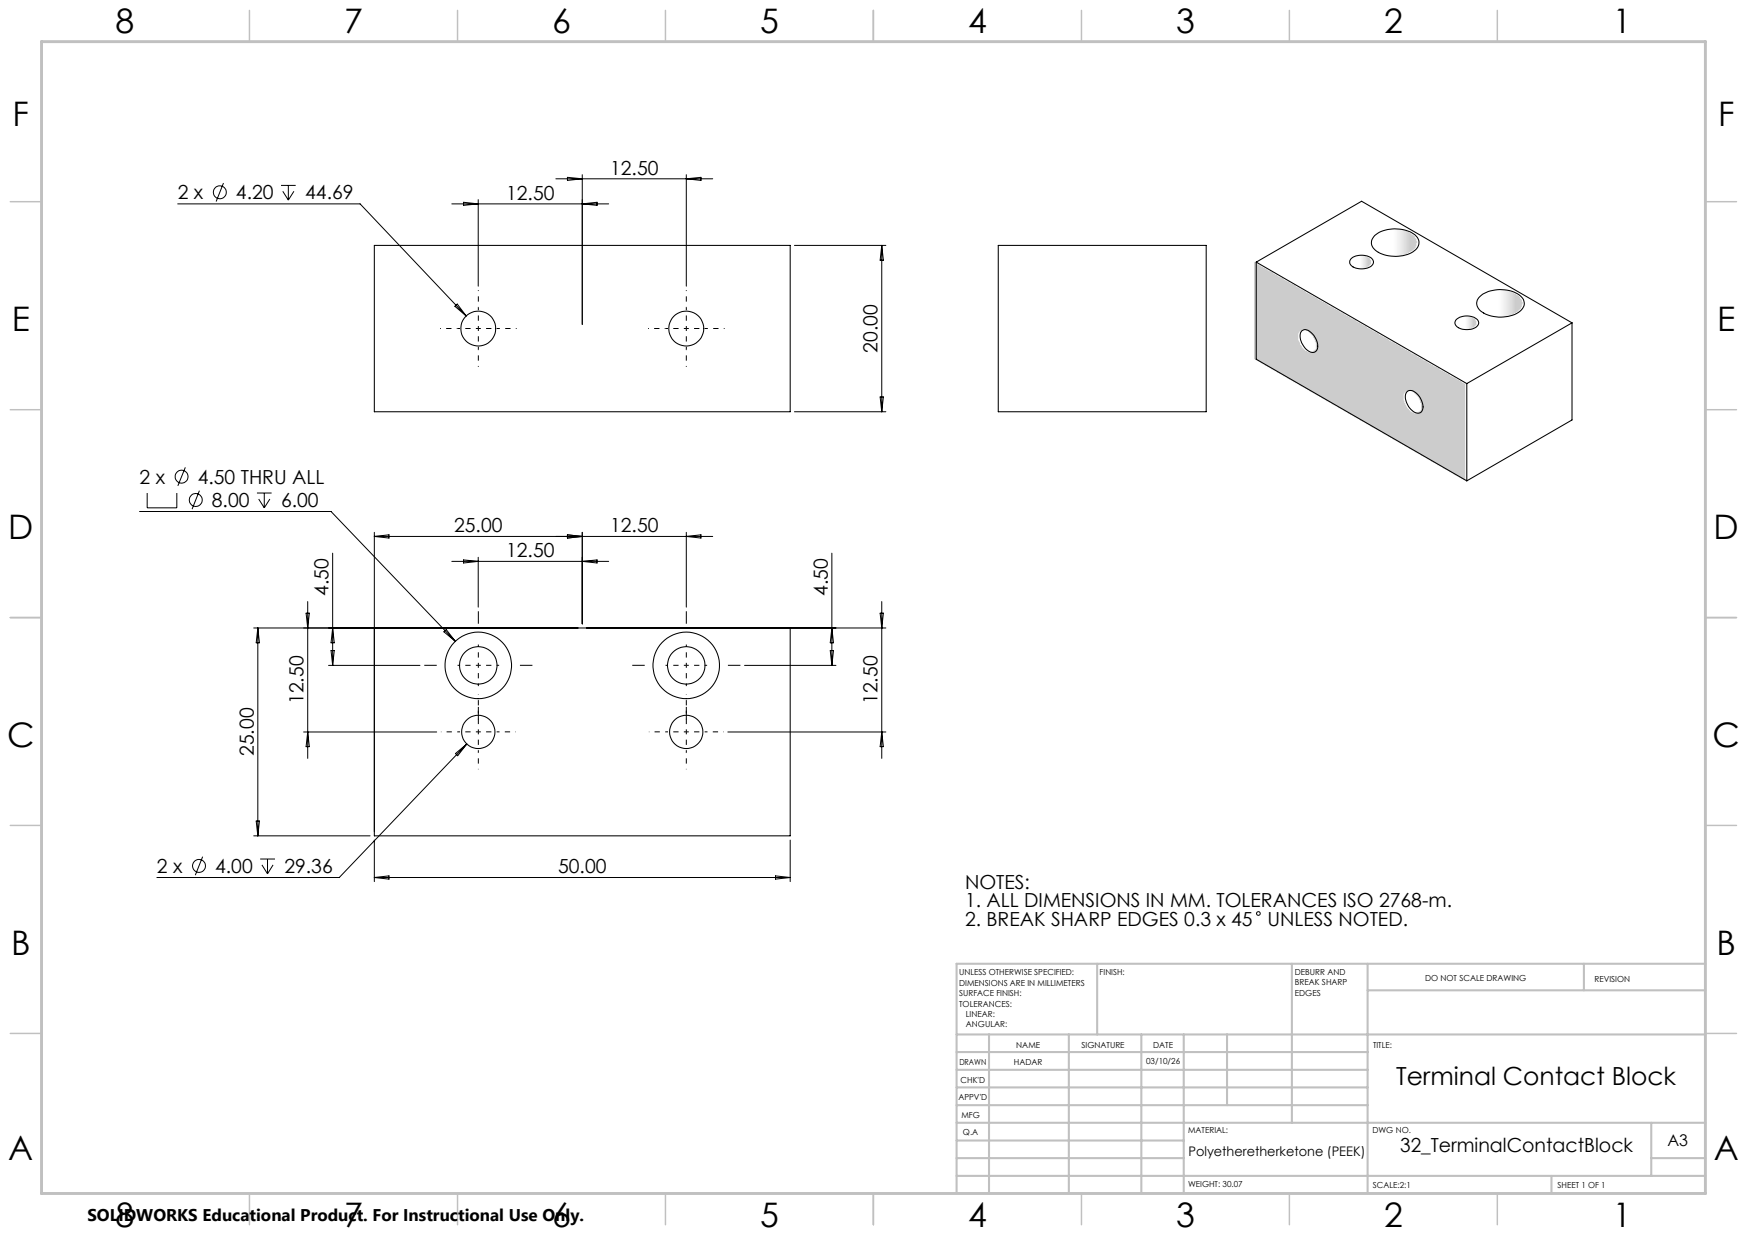
[picture p96: page 35]
4.50 THRU ALL; FINISH:; DEBURR AND; BREAK SHARP EDGES; DO NOT SCALE DRAWING; REVISION

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

UNLESS OTHERWISE SPECIFIED:
DIMENSIONS ARE IN MILLIMETERS
SURFACE FINISH:
TOLERANCES:
LINEAR:
ANGULAR:

NAME | SIGNATURE | DATE | | | | TITLE: Terminal Contact Block

DRAWN | HADAR | | 03/10/26
CHK'D
APPV'D
MFG

32_TerminalContactBlock | A3 Polyetheretherketone (PEEK)

WEIGHT: 30.07 | SCALE:2:1 | SHEET 1 OF 1

1.00

1.50

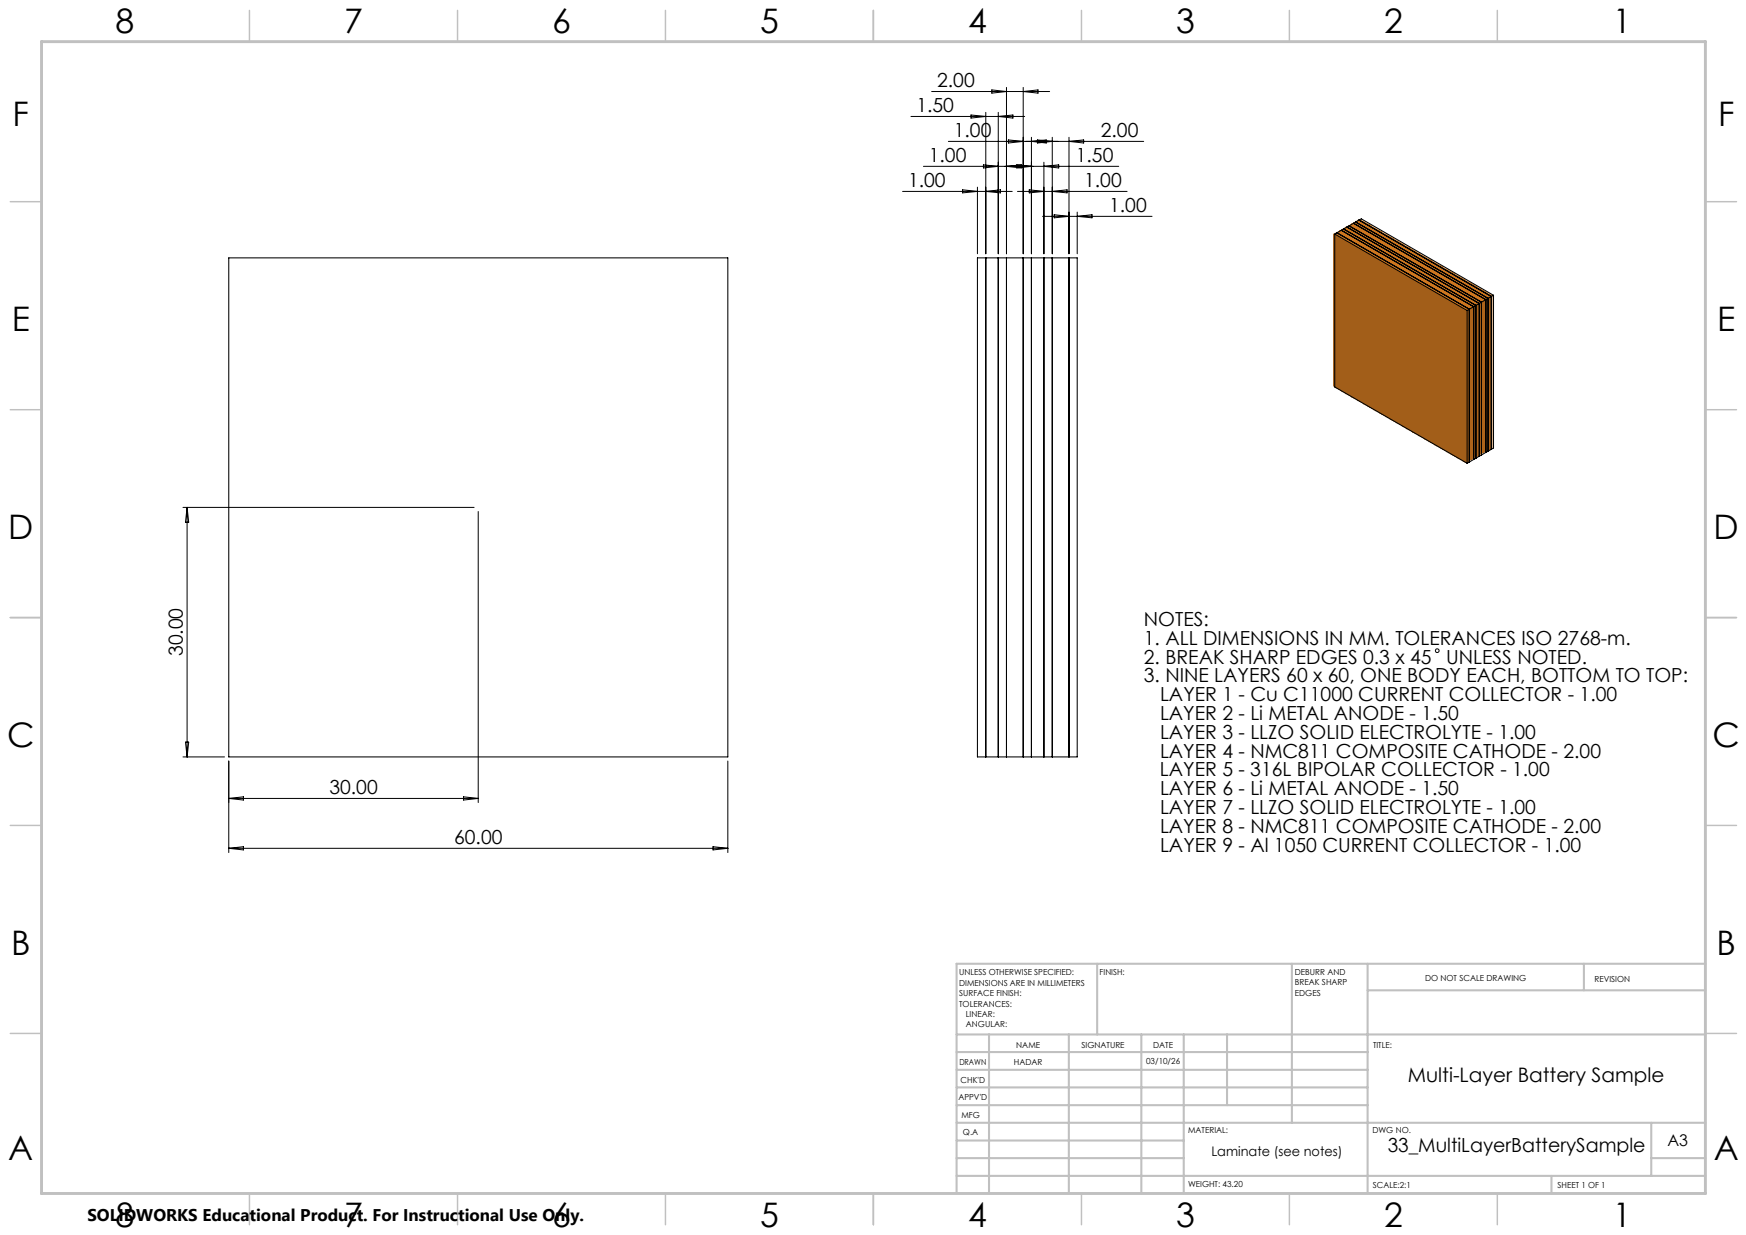
[picture p97: page 36]
FINISH:; DEBURR AND; BREAK SHARP EDGES; DO NOT SCALE DRAWING; REVISION

NOTES:
1. ALL DIMENSIONS IN MM. TOLERANCES ISO 2768-m.
2. BREAK SHARP EDGES 0.3 x 45 UNLESS NOTED.
3. NINE LAYERS 60 x 60, ONE BODY EACH, BOTTOM TO TOP:
LAYER 1 - Cu C11000 CURRENT COLLECTOR - 1.00
LAYER 2 - Li METAL ANODE - 1.50
LAYER 3 - LLZO SOLID ELECTROLYTE - 1.00
LAYER 4 - NMC811 COMPOSITE CATHODE - 2.00
LAYER 5 - 316L BIPOLAR COLLECTOR - 1.00
LAYER 6 - Li METAL ANODE - 1.50
LAYER 7 - LLZO SOLID ELECTROLYTE - 1.00
LAYER 8 - NMC811 COMPOSITE CATHODE - 2.00
LAYER 9 - Al 1050 CURRENT COLLECTOR - 1.00

UNLESS OTHERWISE SPECIFIED:
DIMENSIONS ARE IN MILLIMETERS
SURFACE FINISH:
TOLERANCES:
LINEAR:
ANGULAR:

NAME | SIGNATURE | DATE | | | | TITLE: Multi-Layer Battery Sample

DRAWN | HADAR | | 03/10/26
CHK'D
APPV'D
MFG

33_MultiLayerBatterySample | A3 Laminate (see notes)

WEIGHT: 43.20 | SCALE:2:1 | SHEET 1 OF 1

E | E
F | F

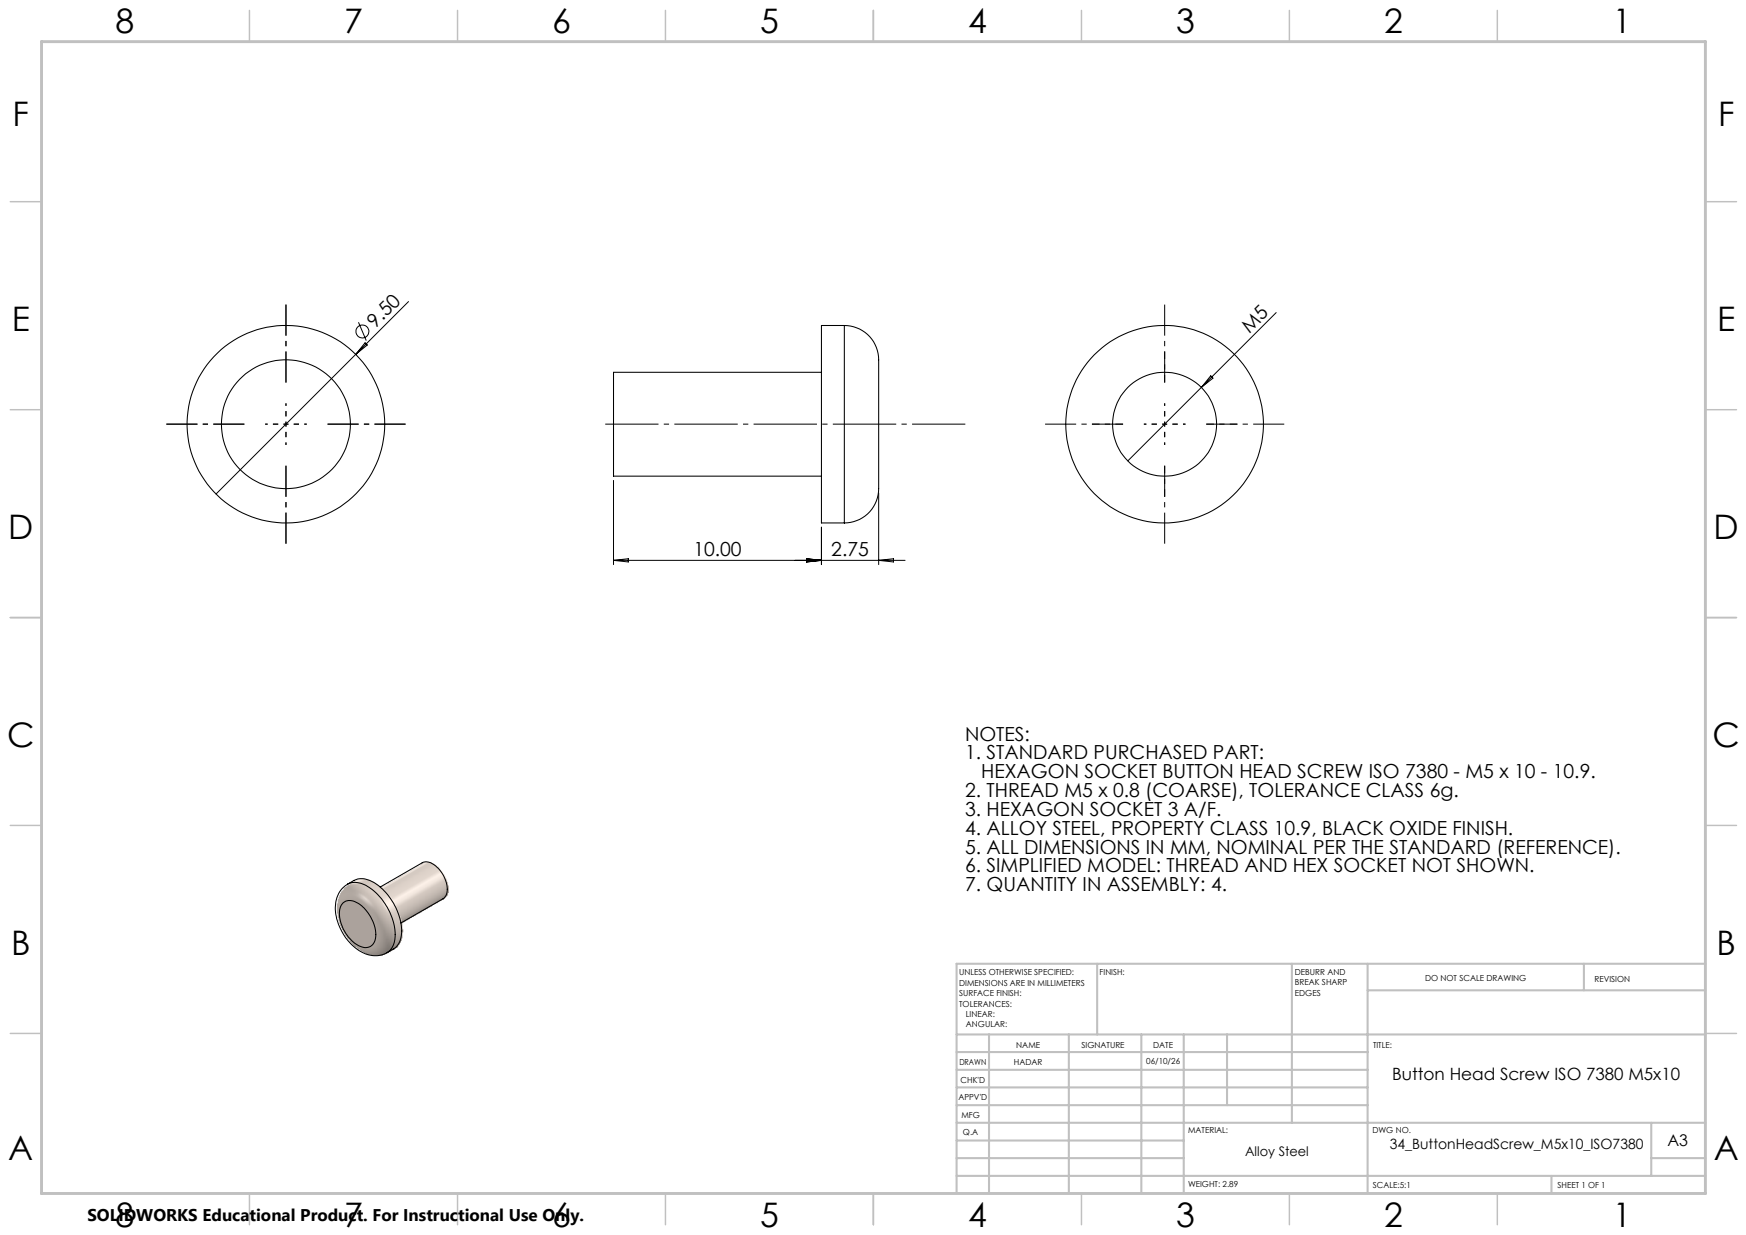
[picture p98: page 37]
FINISH:; DEBURR AND; BREAK SHARP EDGES; DO NOT SCALE DRAWING; REVISION

NOTES:
1. STANDARD PURCHASED PART:
HEXAGON SOCKET BUTTON HEAD SCREW ISO 7380 - M5 x 10 - 10.9.
2. THREAD M5 x 0.8 (COARSE), TOLERANCE CLASS 6g.
3. HEXAGON SOCKET 3 A/F.
4. ALLOY STEEL, PROPERTY CLASS 10.9, BLACK OXIDE FINISH.
5. ALL DIMENSIONS IN MM, NOMINAL PER THE STANDARD (REFERENCE).
6. SIMPLIFIED MODEL: THREAD AND HEX SOCKET NOT SHOWN.
7. QUANTITY IN ASSEMBLY: 4.

UNLESS OTHERWISE SPECIFIED:
DIMENSIONS ARE IN MILLIMETERS
SURFACE FINISH:
TOLERANCES:
LINEAR:
ANGULAR:

NAME | SIGNATURE | DATE | | | | TITLE: Button Head Screw ISO 7380 M5x10

DRAWN | HADAR | | 06/10/26
CHK'D
APPV'D
MFG

34_ButtonHeadScrew_M5x10_ISO7380 | A3 Alloy Steel

WEIGHT: 2.89 | SCALE:5:1 | SHEET 1 OF 1

E | E
F | F

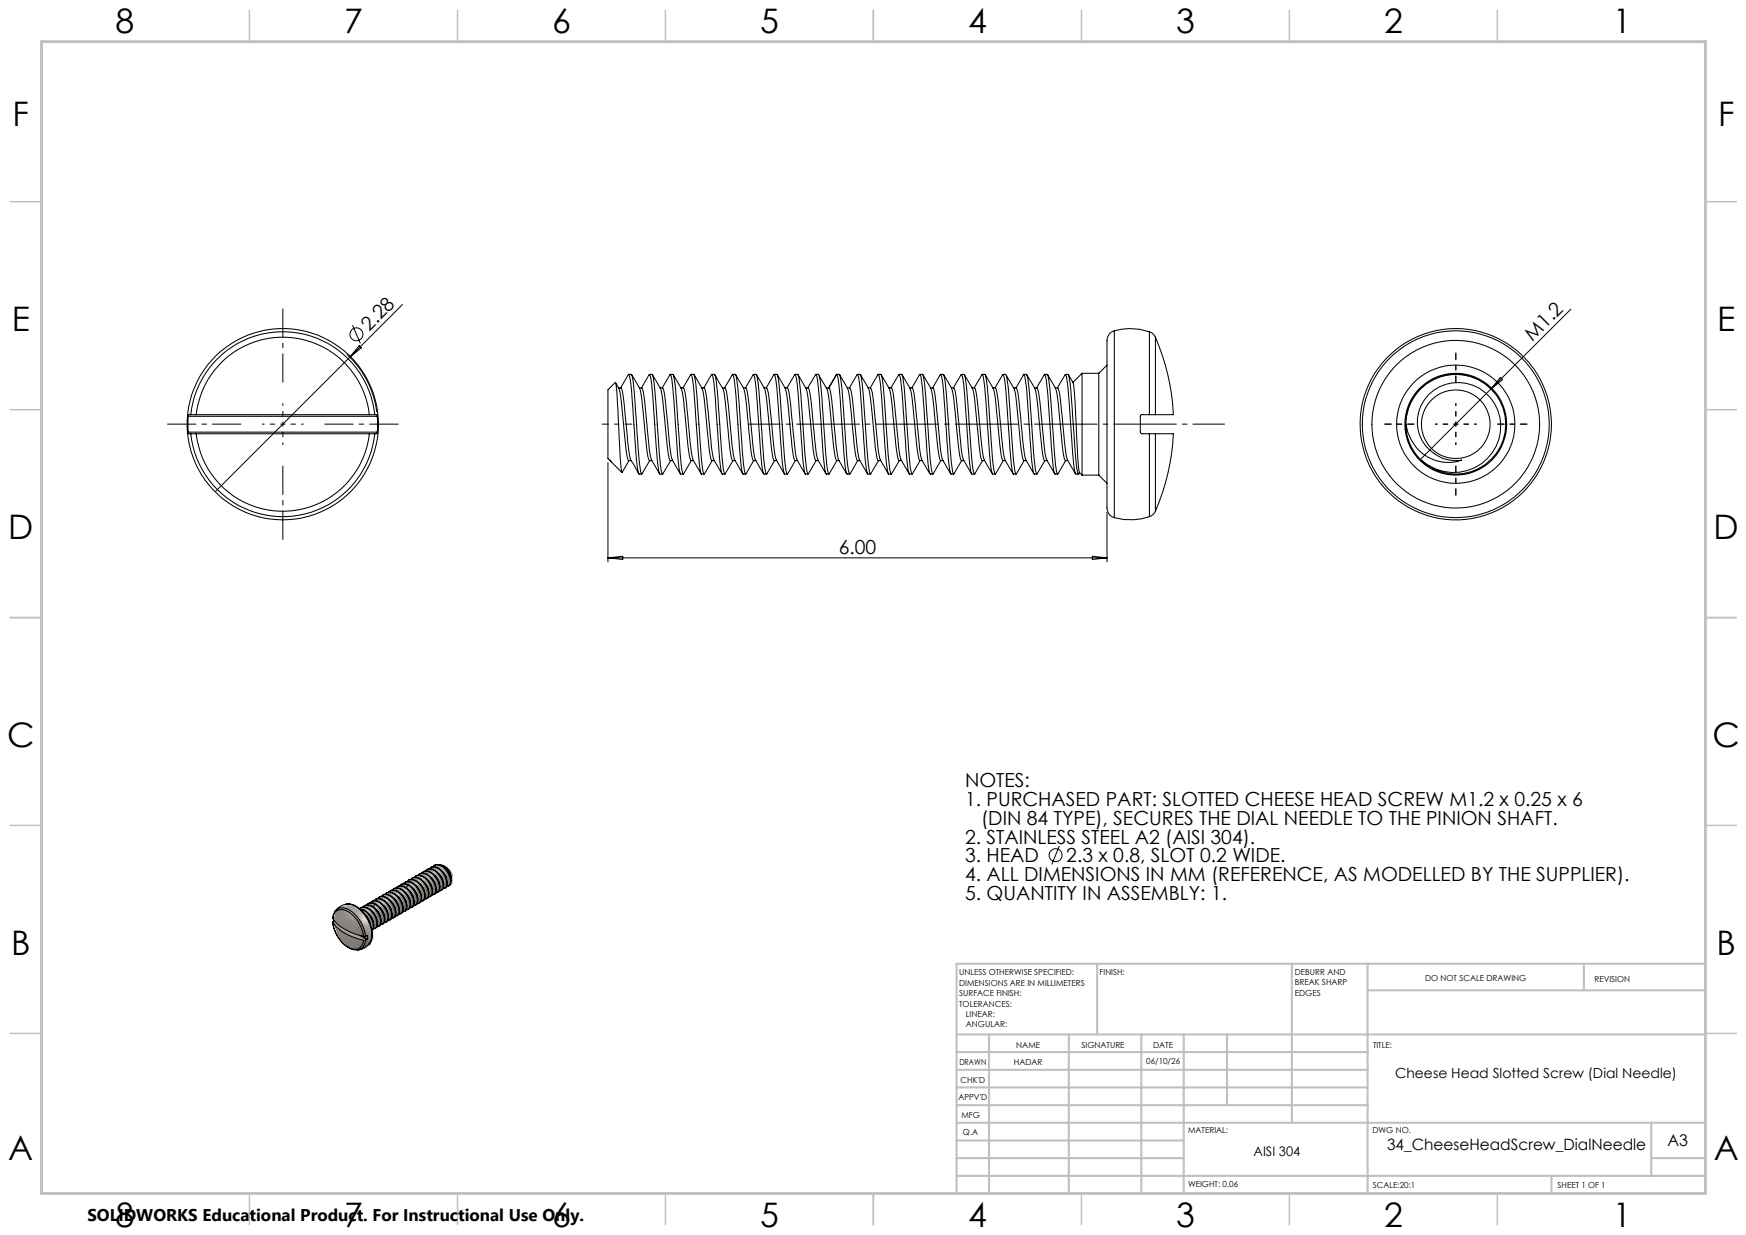
[picture p99: page 38]
FINISH:; DEBURR AND; BREAK SHARP EDGES; DO NOT SCALE DRAWING; REVISION

NOTES:
1. PURCHASED PART: SLOTTED CHEESE HEAD SCREW M1.2 x 0.25 x 6
(DIN 84 TYPE), SECURES THE DIAL NEEDLE TO THE PINION SHAFT.
2. STAINLESS STEEL A2 (AISI 304).
3. HEAD 2.3 x 0.8, SLOT 0.2 WIDE.
4. ALL DIMENSIONS IN MM (REFERENCE, AS MODELLED BY THE SUPPLIER).
5. QUANTITY IN ASSEMBLY: 1.

UNLESS OTHERWISE SPECIFIED:
DIMENSIONS ARE IN MILLIMETERS
SURFACE FINISH:
TOLERANCES:
LINEAR:
ANGULAR:

NAME | SIGNATURE | DATE | | | | TITLE: Cheese Head Slotted Screw (Dial Needle)

DRAWN | HADAR | | 06/10/26
CHK'D
APPV'D
MFG

34_CheeseHeadScrew_DialNeedle | A3 AISI 304

WEIGHT: 0.06 | SCALE:20:1 | SHEET 1 OF 1

E | E
F | F

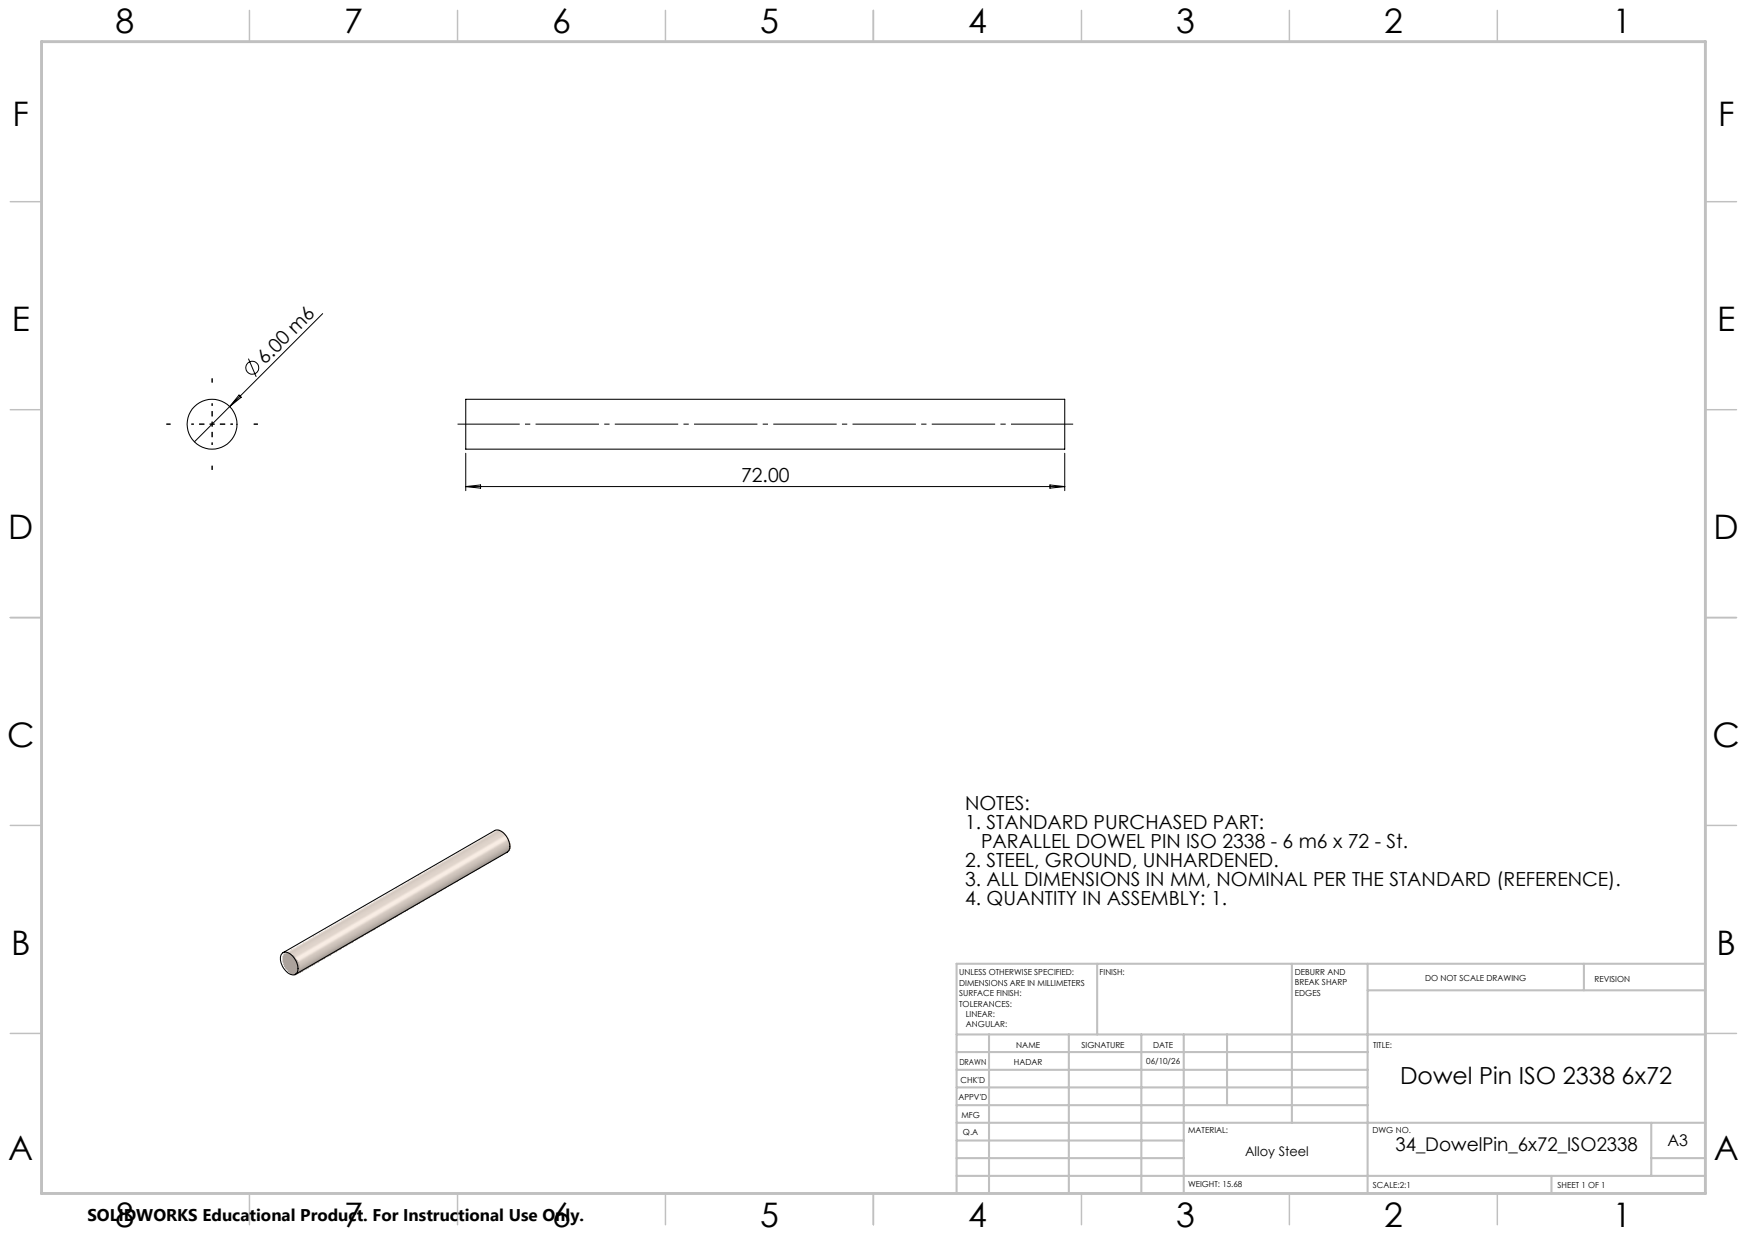
[picture p100: page 39]
FINISH:; DEBURR AND; BREAK SHARP EDGES; DO NOT SCALE DRAWING; REVISION

NOTES:
1. STANDARD PURCHASED PART:
PARALLEL DOWEL PIN ISO 2338 - 6 m6 x 72 - St.
2. STEEL, GROUND, UNHARDENED.
3. ALL DIMENSIONS IN MM, NOMINAL PER THE STANDARD (REFERENCE).
4. QUANTITY IN ASSEMBLY: 1.

UNLESS OTHERWISE SPECIFIED:
DIMENSIONS ARE IN MILLIMETERS
SURFACE FINISH:
TOLERANCES:
LINEAR:
ANGULAR:

NAME | SIGNATURE | DATE | | | | TITLE: Dowel Pin ISO 2338 6x72

DRAWN | HADAR | | 06/10/26
CHK'D
APPV'D
MFG

34_DowelPin_6x72_ISO2338 | A3 Alloy Steel

WEIGHT: 15.68 | SCALE:2:1 | SHEET 1 OF 1

4.00
E | E

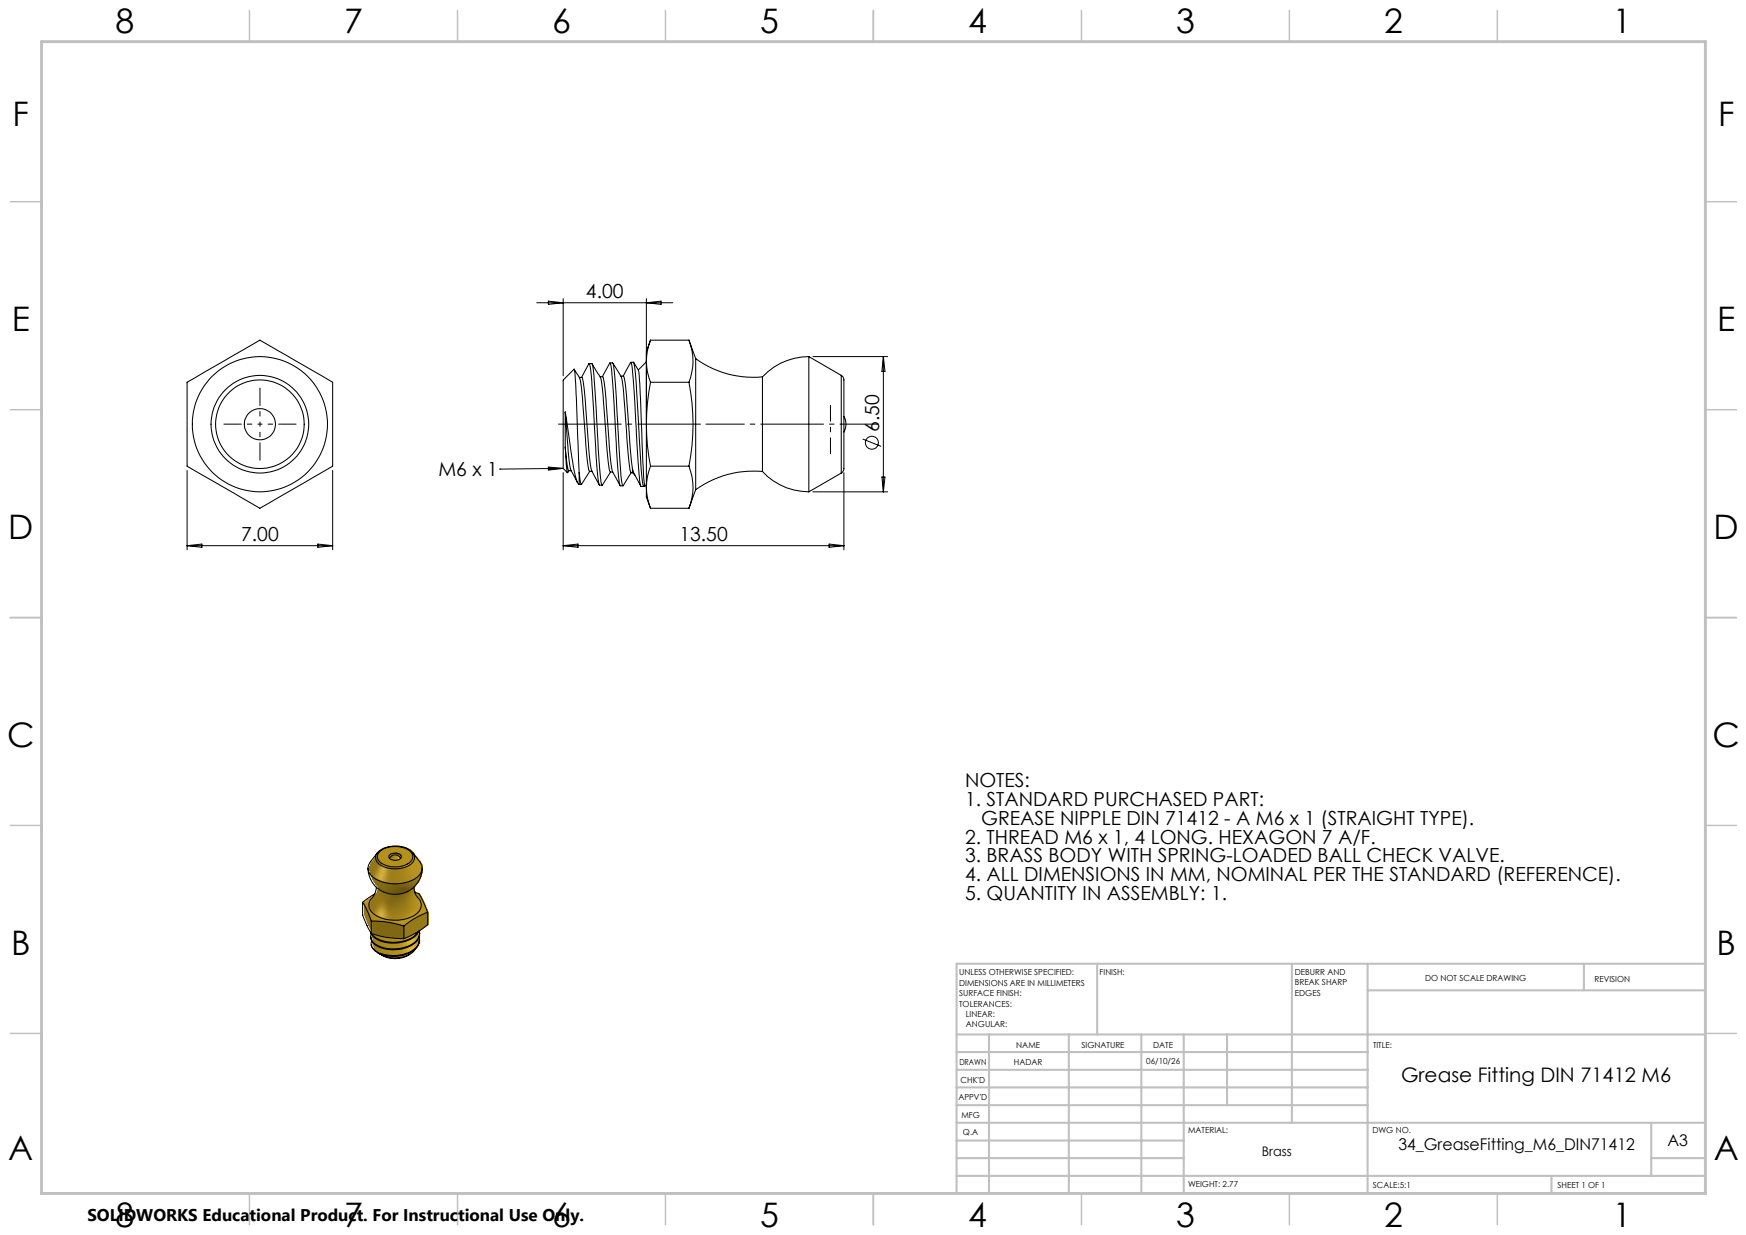
[picture p101: page 40]
FINISH:; DEBURR AND; BREAK SHARP EDGES; DO NOT SCALE DRAWING; REVISION; SCALE:5:1; SHEET 1 OF 1; WEIGHT: 2.77

NOTES:
1. STANDARD PURCHASED PART:
GREASE NIPPLE DIN 71412 - A M6 x 1 (STRAIGHT TYPE).
2. THREAD M6 x 1, 4 LONG. HEXAGON 7 A/F.
3. BRASS BODY WITH SPRING-LOADED BALL CHECK VALVE.
4. ALL DIMENSIONS IN MM, NOMINAL PER THE STANDARD (REFERENCE).
5. QUANTITY IN ASSEMBLY: 1.

UNLESS OTHERWISE SPECIFIED:
DIMENSIONS ARE IN MILLIMETERS
SURFACE FINISH:
TOLERANCES:
LINEAR:
ANGULAR:

NAME | SIGNATURE | DATE | | | | TITLE: Grease Fitting DIN 71412 M6

DRAWN | HADAR | | 06/10/26
CHK'D
APPV'D
MFG

Brass | 34_GreaseFitting_M6_DIN71412 | A3

E | E
F | F

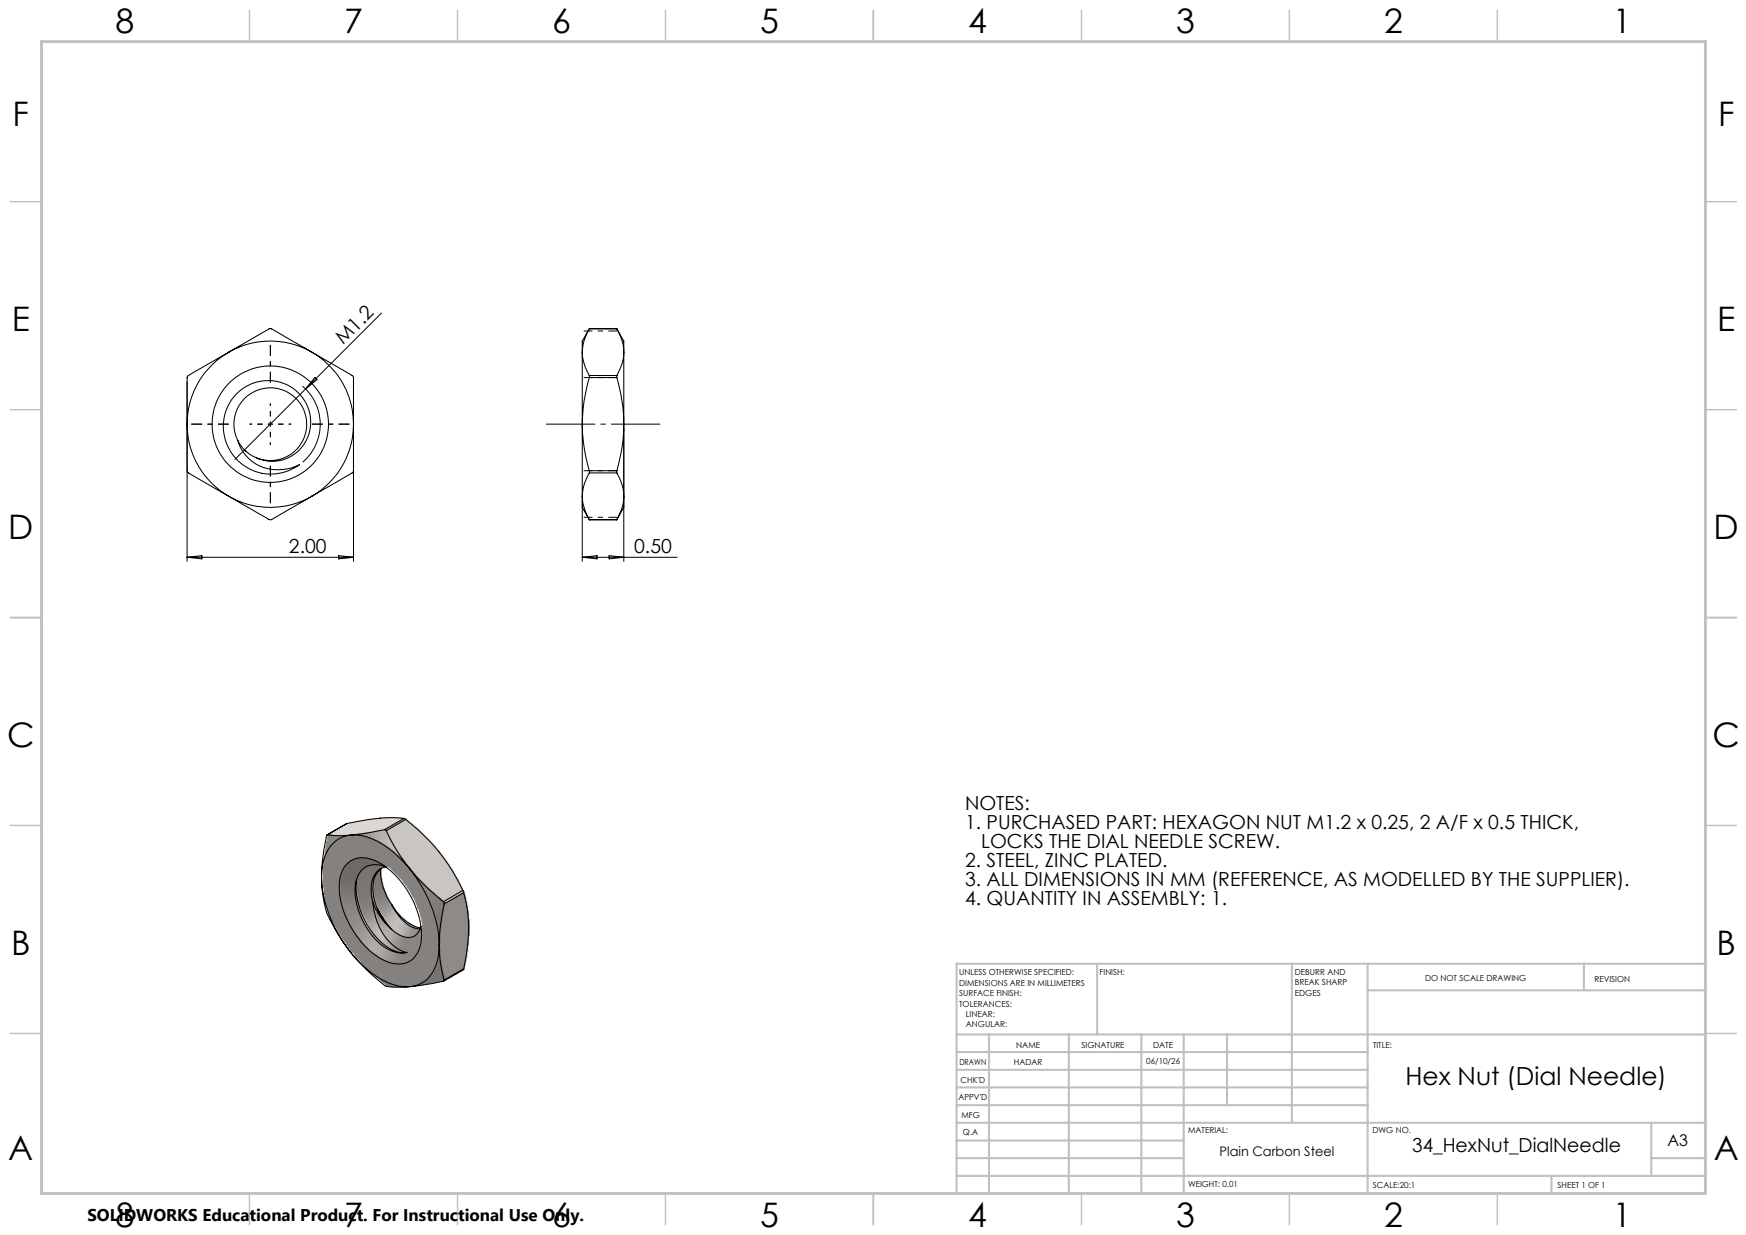
[picture p102: page 41]
FINISH:; DEBURR AND; BREAK SHARP EDGES; DO NOT SCALE DRAWING; REVISION

NOTES:
1. PURCHASED PART: HEXAGON NUT M1.2 x 0.25, 2 A/F x 0.5 THICK,
LOCKS THE DIAL NEEDLE SCREW.
2. STEEL, ZINC PLATED.
3. ALL DIMENSIONS IN MM (REFERENCE, AS MODELLED BY THE SUPPLIER).
4. QUANTITY IN ASSEMBLY: 1.

UNLESS OTHERWISE SPECIFIED:
DIMENSIONS ARE IN MILLIMETERS
SURFACE FINISH:
TOLERANCES:
LINEAR:
ANGULAR:

NAME | SIGNATURE | DATE | | | | TITLE: Hex Nut (Dial Needle)

DRAWN | HADAR | | 06/10/26
CHK'D
APPV'D
MFG

34_HexNut_DialNeedle | A3 Plain Carbon Steel

WEIGHT: 0.01 | SCALE:20:1 | SHEET 1 OF 1

E | E
F | F

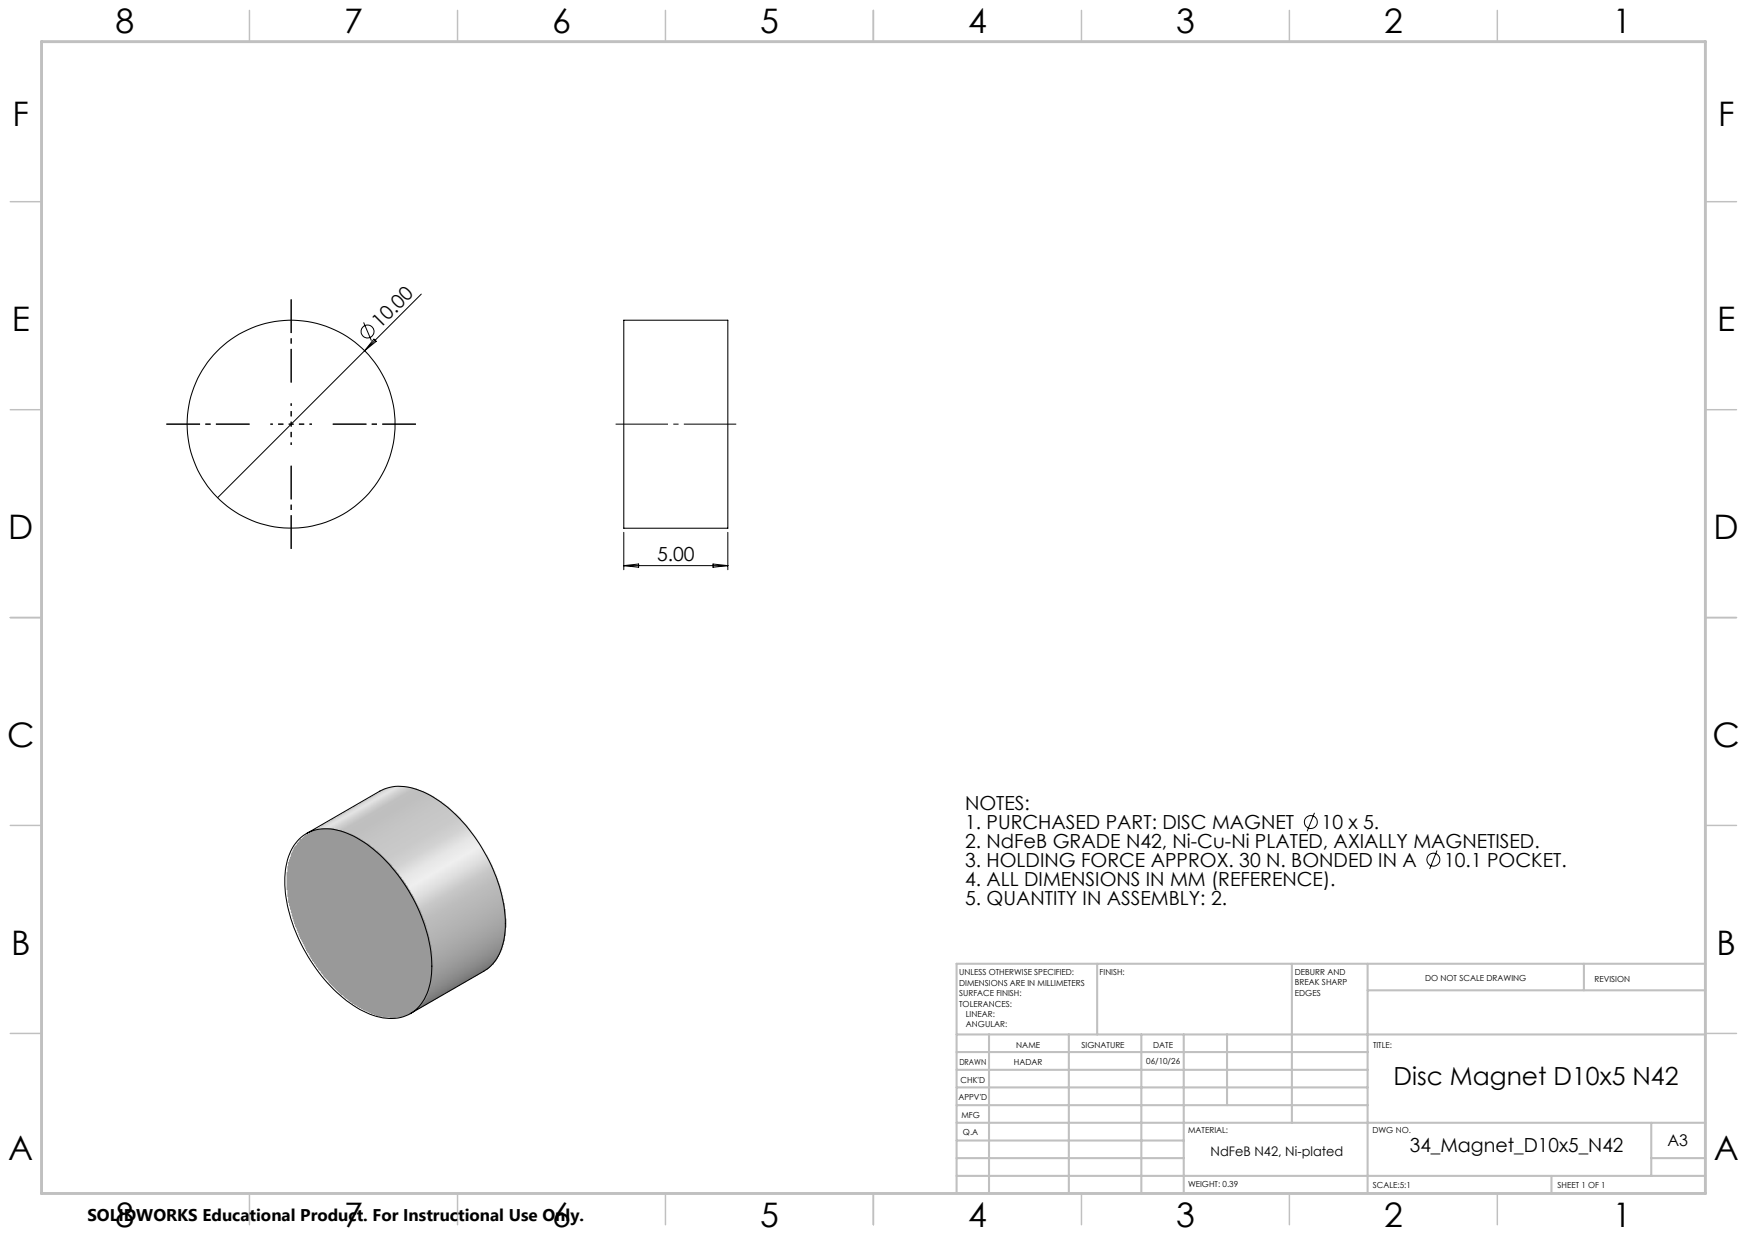
[picture p103: page 42]
FINISH:; DEBURR AND; BREAK SHARP EDGES; DO NOT SCALE DRAWING; REVISION

NOTES:
1. PURCHASED PART: DISC MAGNET 10 x 5.
2. NdFeB GRADE N42, Ni-Cu-Ni PLATED, AXIALLY MAGNETISED.
3. HOLDING FORCE APPROX. 30 N. BONDED IN A 10.1 POCKET.
4. ALL DIMENSIONS IN MM (REFERENCE).
5. QUANTITY IN ASSEMBLY: 2.

UNLESS OTHERWISE SPECIFIED:
DIMENSIONS ARE IN MILLIMETERS
SURFACE FINISH:
TOLERANCES:
LINEAR:
ANGULAR:

NAME | SIGNATURE | DATE | | | | TITLE: Disc Magnet D10x5 N42

DRAWN | HADAR | | 06/10/26
CHK'D
APPV'D
MFG

34_Magnet_D10x5_N42 | A3 NdFeB N42, Ni-plated

WEIGHT: 0.39 | SCALE:5:1 | SHEET 1 OF 1

E | E
F | F

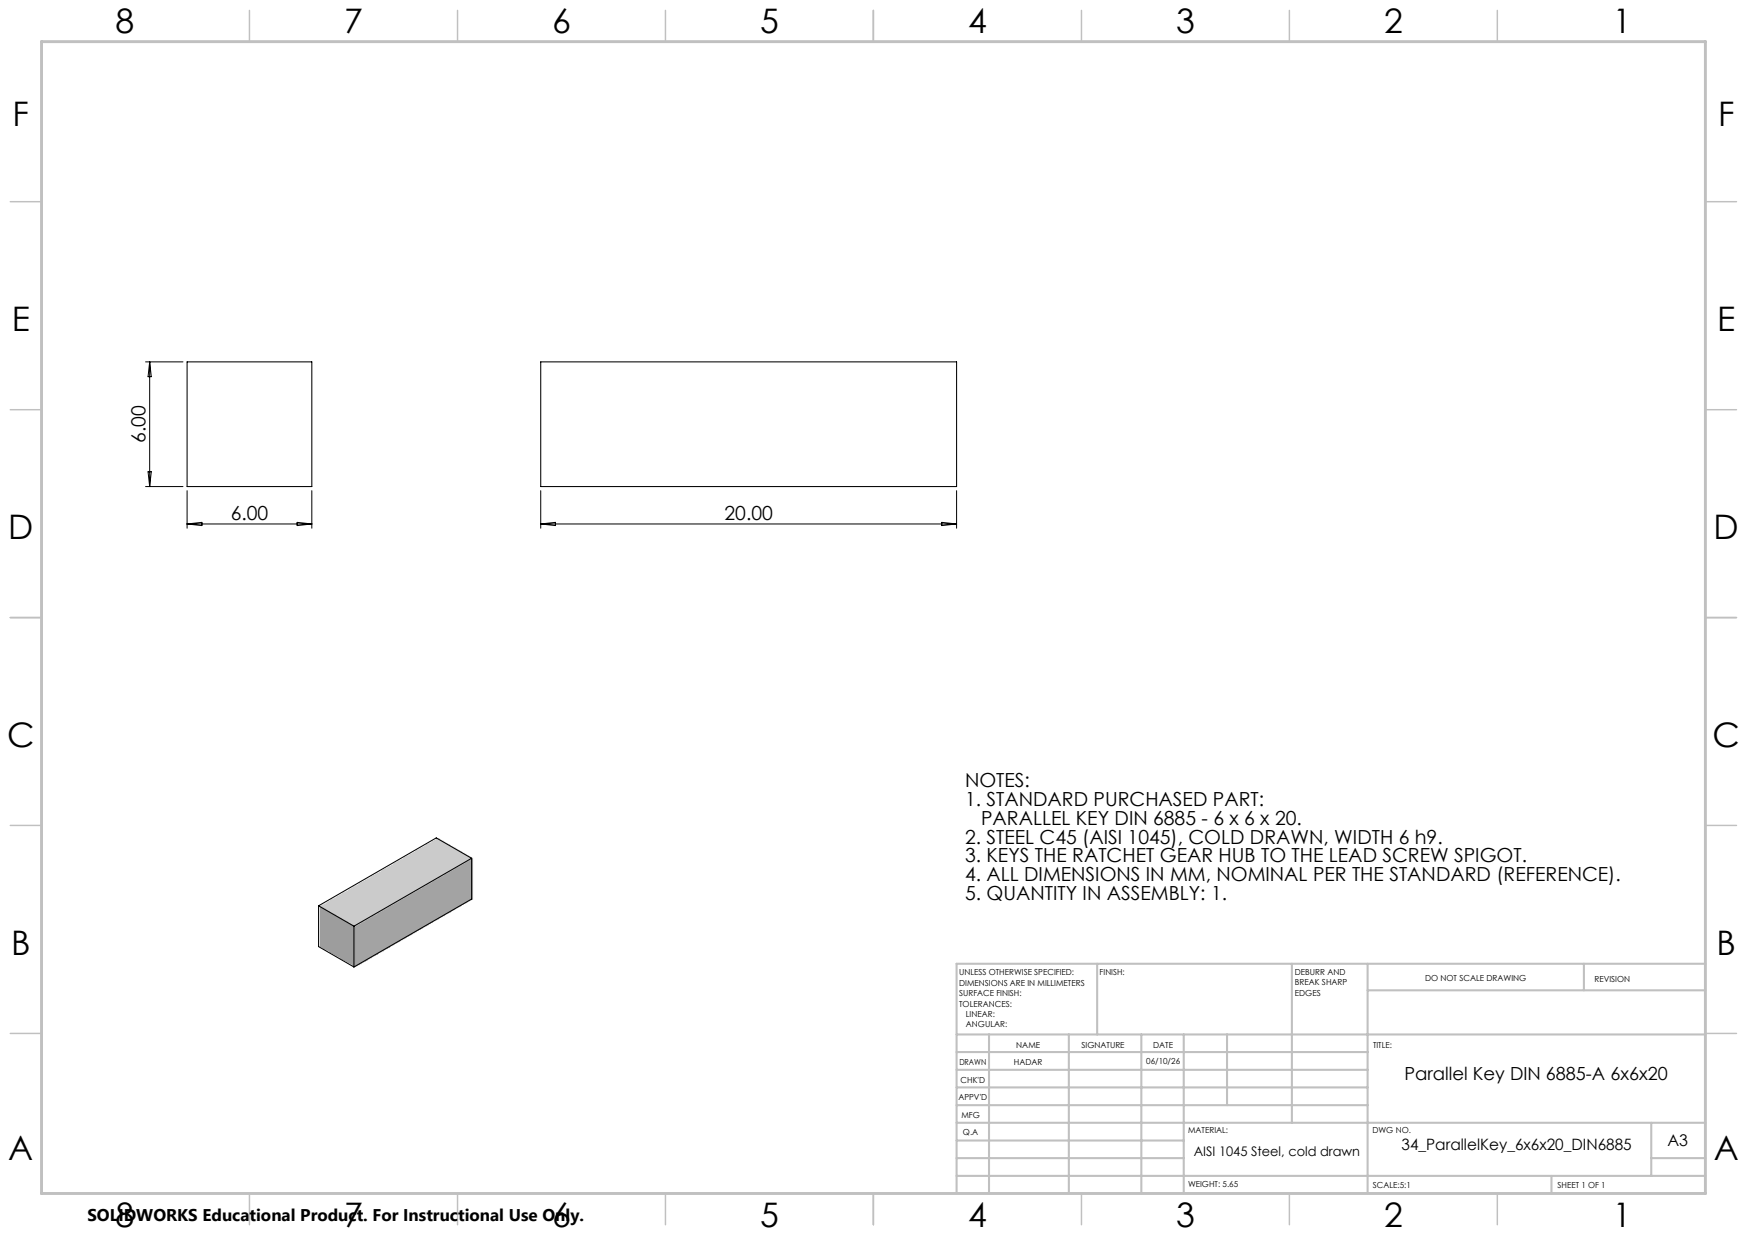
[picture p104: page 43]
FINISH:; DEBURR AND; BREAK SHARP EDGES; DO NOT SCALE DRAWING; REVISION

NOTES:
1. STANDARD PURCHASED PART:
PARALLEL KEY DIN 6885 - 6 x 6 x 20.
2. STEEL C45 (AISI 1045), COLD DRAWN, WIDTH 6 h9.
3. KEYS THE RATCHET GEAR HUB TO THE LEAD SCREW SPIGOT.
4. ALL DIMENSIONS IN MM, NOMINAL PER THE STANDARD (REFERENCE).
5. QUANTITY IN ASSEMBLY: 1.

UNLESS OTHERWISE SPECIFIED:
DIMENSIONS ARE IN MILLIMETERS
SURFACE FINISH:
TOLERANCES:
LINEAR:
ANGULAR:

NAME | SIGNATURE | DATE | | | | TITLE: Parallel Key DIN 6885-A 6x6x20

DRAWN | HADAR | | 06/10/26
CHK'D
APPV'D
MFG

34_ParallelKey_6x6x20_DIN6885 | A3 AISI 1045 Steel, cold drawn

WEIGHT: 5.65 | SCALE:5:1 | SHEET 1 OF 1

E | E
F | F

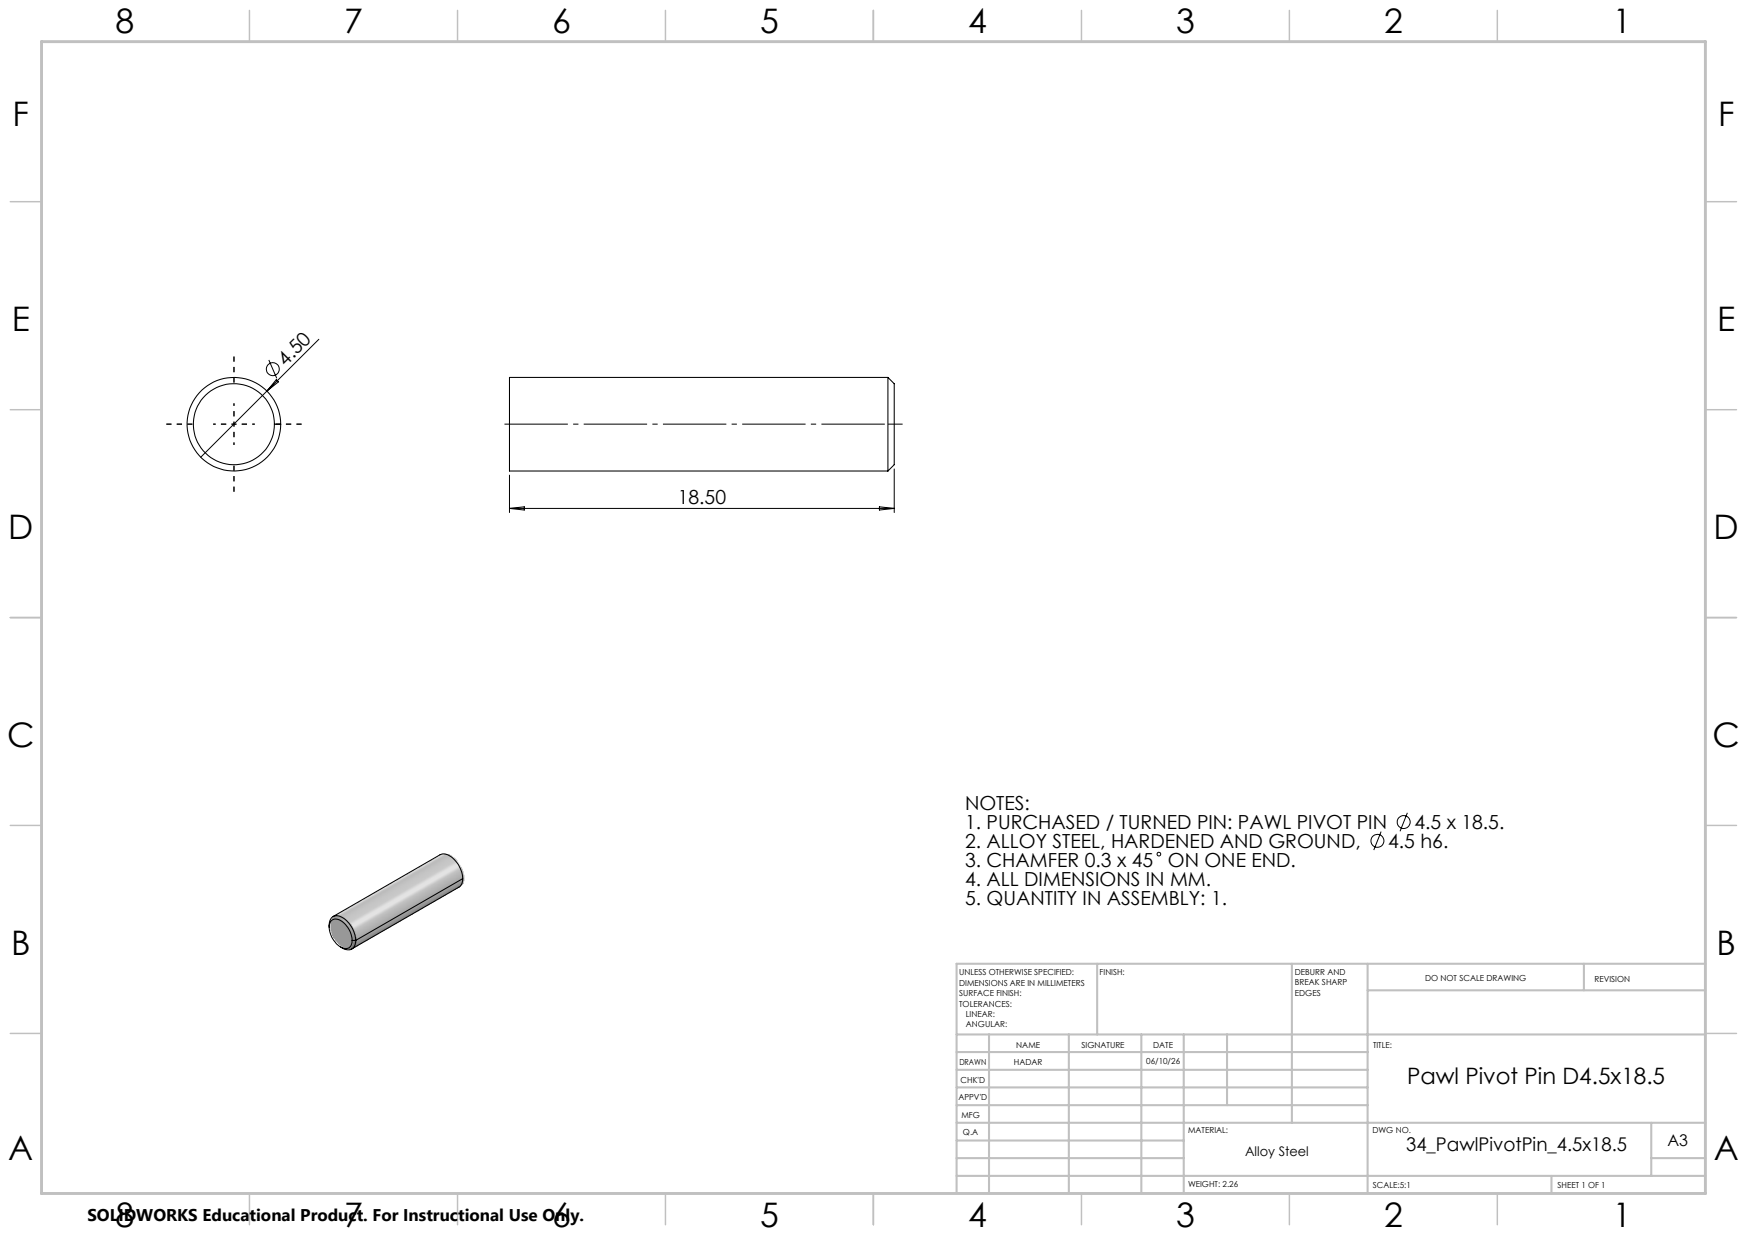
[picture p105: page 44]
FINISH:; DEBURR AND; BREAK SHARP EDGES; DO NOT SCALE DRAWING; REVISION

NOTES:
1. PURCHASED / TURNED PIN: PAWL PIVOT PIN 4.5 x 18.5.
2. ALLOY STEEL, HARDENED AND GROUND, 4.5 h6.
3. CHAMFER 0.3 x 45 ON ONE END.
4. ALL DIMENSIONS IN MM.
5. QUANTITY IN ASSEMBLY: 1.

UNLESS OTHERWISE SPECIFIED:
DIMENSIONS ARE IN MILLIMETERS
SURFACE FINISH:
TOLERANCES:
LINEAR:
ANGULAR:

NAME | SIGNATURE | DATE | | | | TITLE: Pawl Pivot Pin D4.5x18.5

DRAWN | HADAR | | 06/10/26
CHK'D
APPV'D
MFG

34_PawlPivotPin_4.5x18.5 | A3 Alloy Steel

WEIGHT: 2.26 | SCALE:5:1 | SHEET 1 OF 1

E | E
F | F

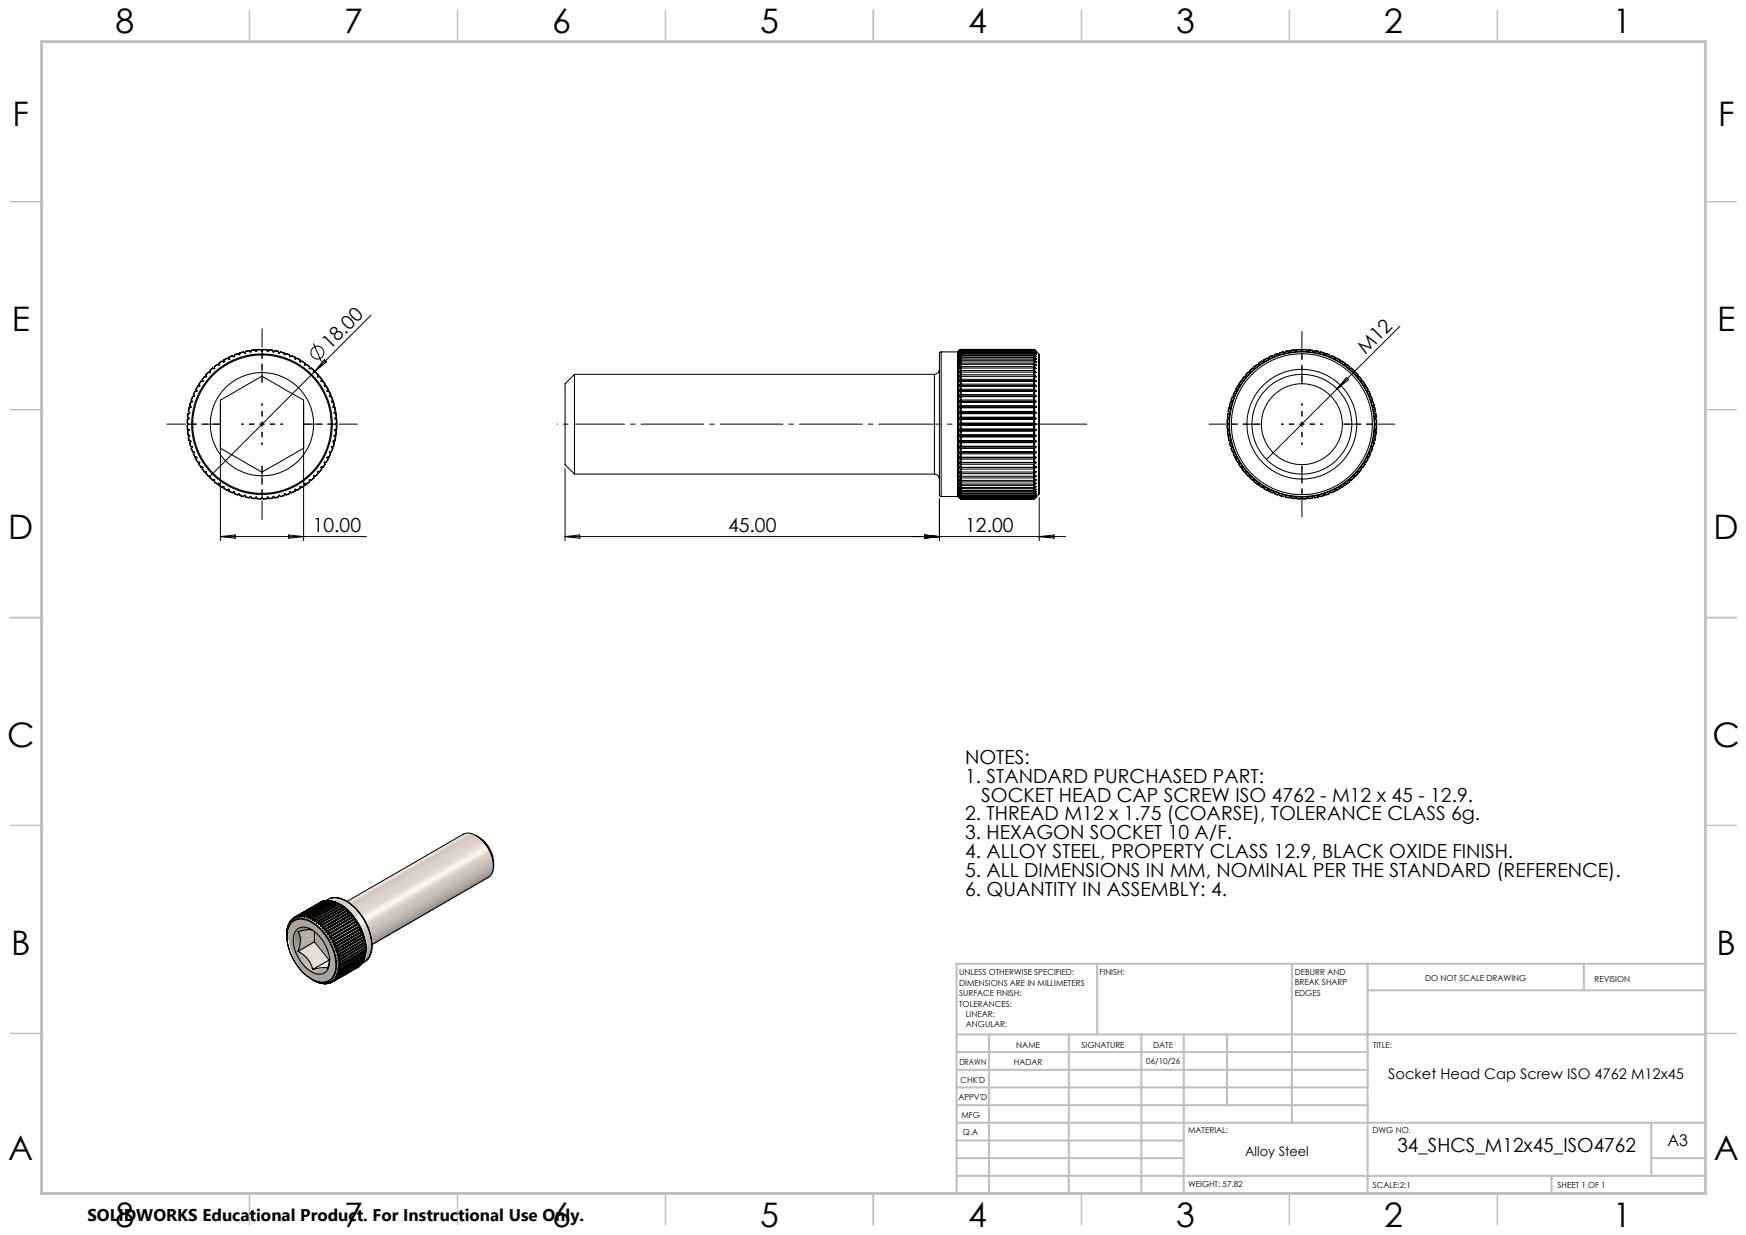
[picture p106: page 45]
FINISH:; DEBURR AND; BREAK SHARP EDGES; DO NOT SCALE DRAWING; REVISION

NOTES:
1. STANDARD PURCHASED PART:
SOCKET HEAD CAP SCREW ISO 4762 - M12 x 45 - 12.9.
2. THREAD M12 x 1.75 (COARSE), TOLERANCE CLASS 6g.
3. HEXAGON SOCKET 10 A/F.
4. ALLOY STEEL, PROPERTY CLASS 12.9, BLACK OXIDE FINISH.
5. ALL DIMENSIONS IN MM, NOMINAL PER THE STANDARD (REFERENCE).
6. QUANTITY IN ASSEMBLY: 4.

UNLESS OTHERWISE SPECIFIED:
DIMENSIONS ARE IN MILLIMETERS
SURFACE FINISH:
TOLERANCES:
LINEAR:
ANGULAR:

NAME | SIGNATURE | DATE | | | | TITLE: Socket Head Cap Screw ISO 4762 M12x45

DRAWN | HADAR | | 06/10/26
CHK'D
APPV'D
MFG

34_SHCS_M12x45_ISO4762 | A3 Alloy Steel

WEIGHT: 57.82 | SCALE:2:1 | SHEET 1 OF 1

E | E
F | F

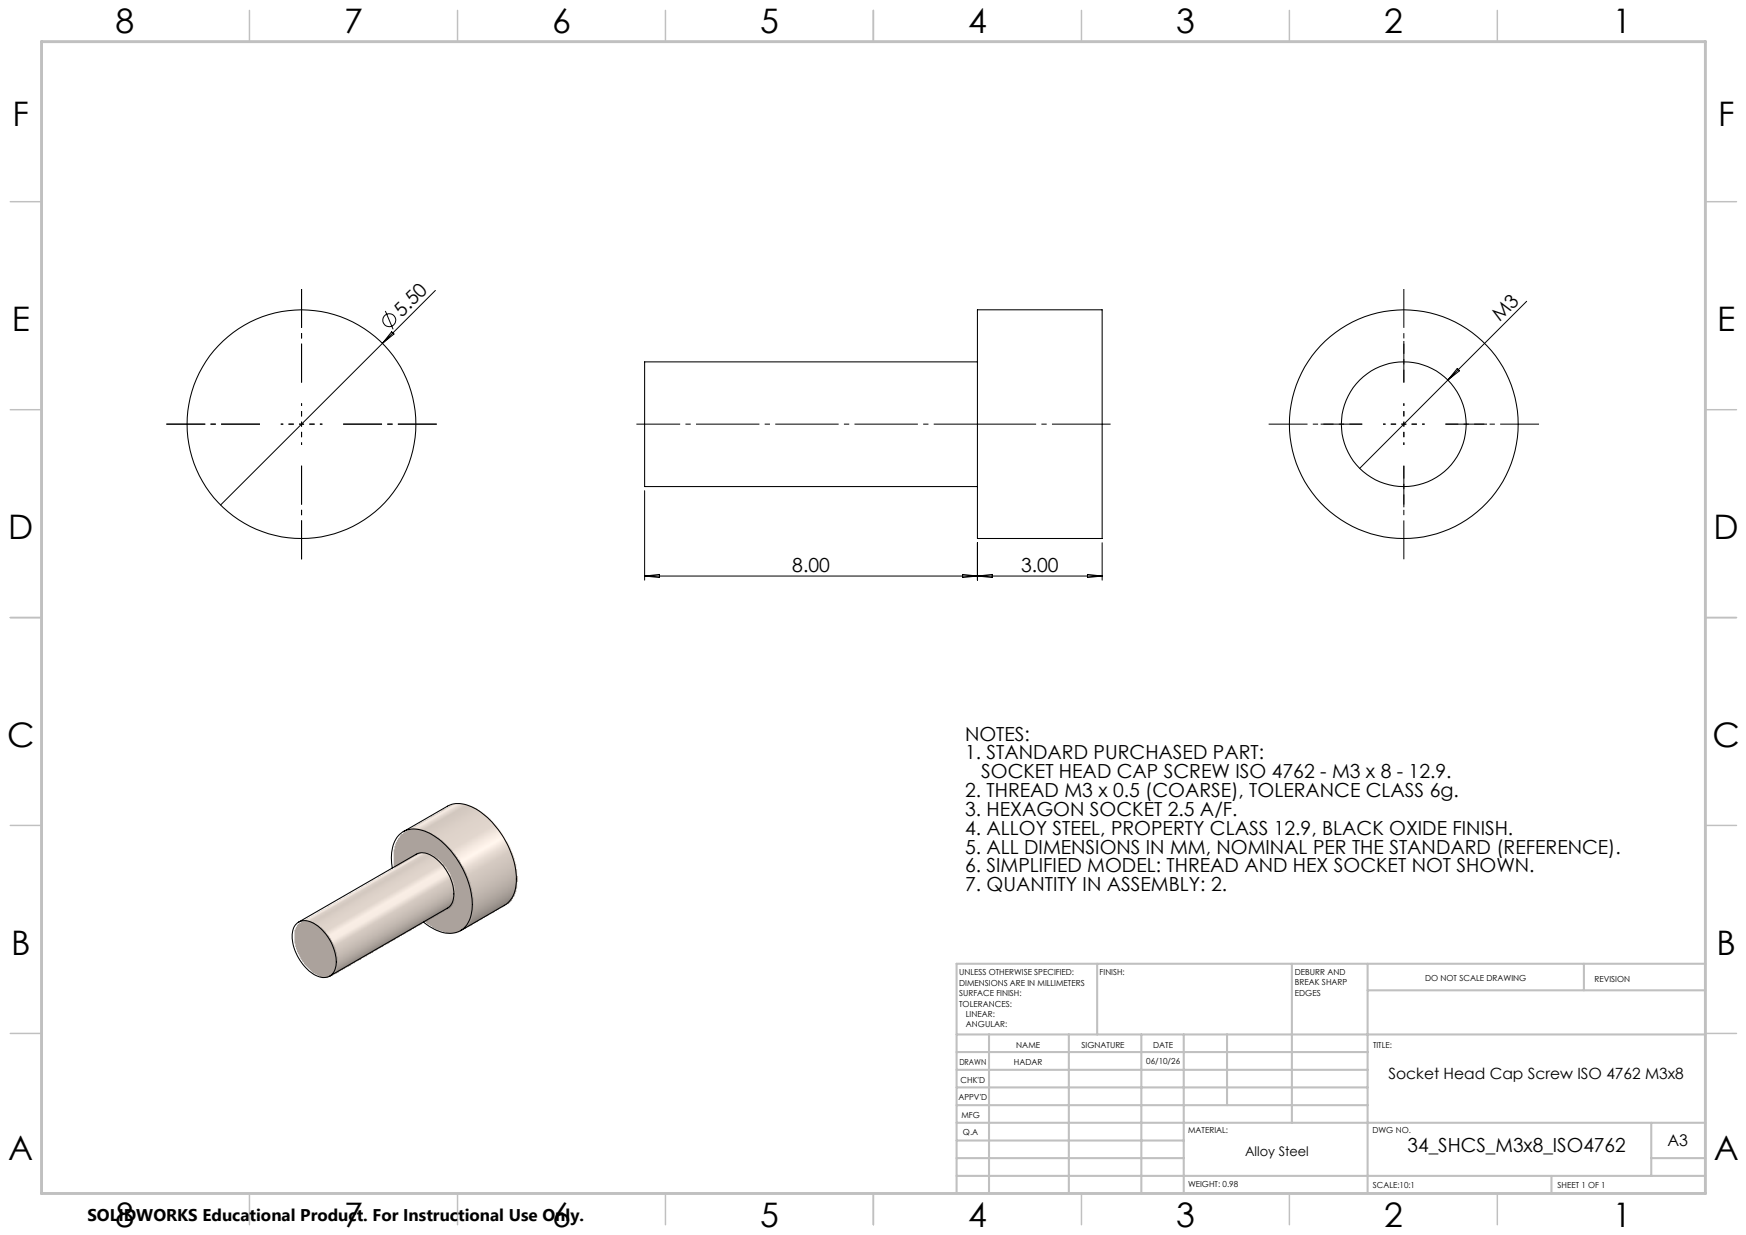
[picture p107: page 46]
FINISH:; DEBURR AND; BREAK SHARP EDGES; DO NOT SCALE DRAWING; REVISION

NOTES:
1. STANDARD PURCHASED PART:
SOCKET HEAD CAP SCREW ISO 4762 - M3 x 8 - 12.9.
2. THREAD M3 x 0.5 (COARSE), TOLERANCE CLASS 6g.
3. HEXAGON SOCKET 2.5 A/F.
4. ALLOY STEEL, PROPERTY CLASS 12.9, BLACK OXIDE FINISH.
5. ALL DIMENSIONS IN MM, NOMINAL PER THE STANDARD (REFERENCE).
6. SIMPLIFIED MODEL: THREAD AND HEX SOCKET NOT SHOWN.
7. QUANTITY IN ASSEMBLY: 2.

UNLESS OTHERWISE SPECIFIED:
DIMENSIONS ARE IN MILLIMETERS
SURFACE FINISH:
TOLERANCES:
LINEAR:
ANGULAR:

NAME | SIGNATURE | DATE | | | | TITLE: Socket Head Cap Screw ISO 4762 M3x8

DRAWN | HADAR | | 06/10/26
CHK'D
APPV'D
MFG

34_SHCS_M3x8_ISO4762 | A3 Alloy Steel

WEIGHT: 0.98 | SCALE:10:1 | SHEET 1 OF 1

E | E
F | F

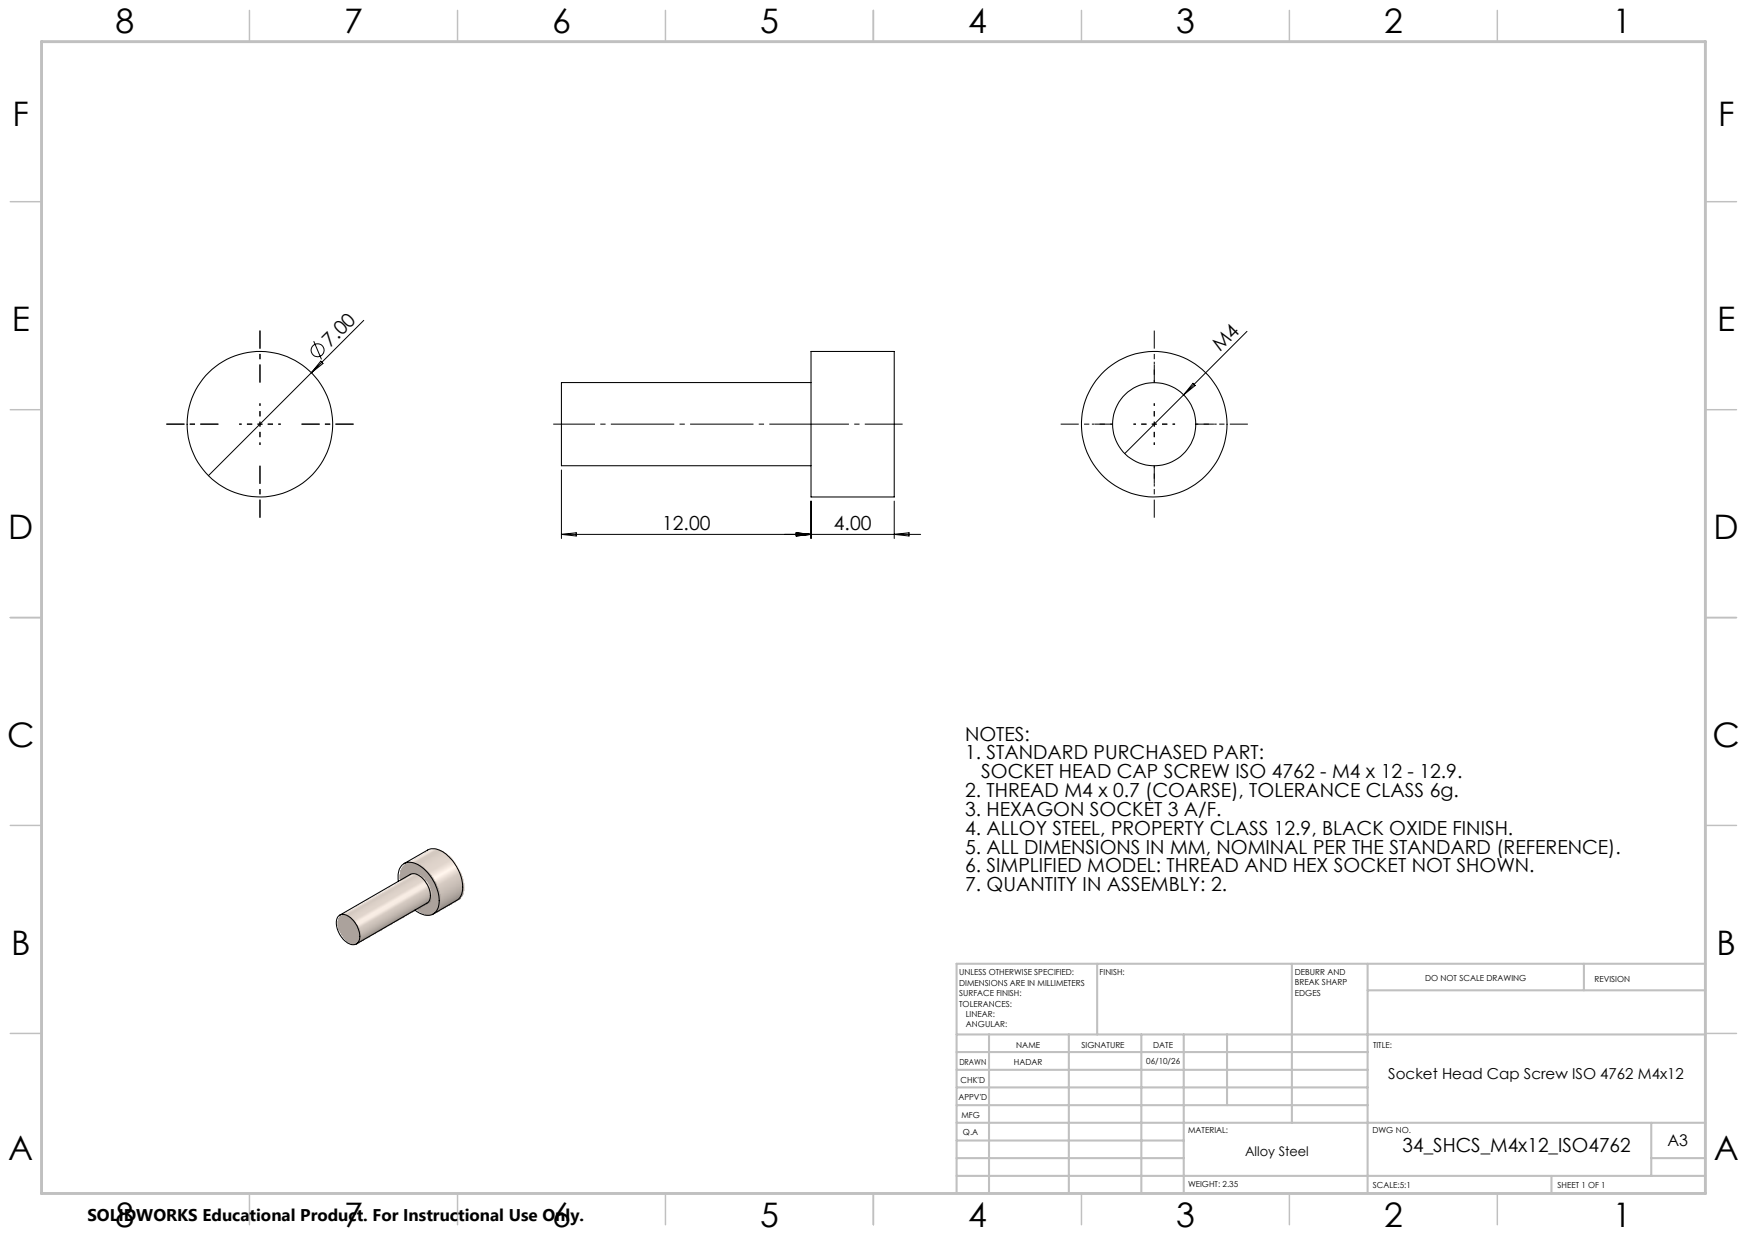
[picture p108: page 47]
FINISH:; DEBURR AND; BREAK SHARP EDGES; DO NOT SCALE DRAWING; REVISION

NOTES:
1. STANDARD PURCHASED PART:
SOCKET HEAD CAP SCREW ISO 4762 - M4 x 12 - 12.9.
2. THREAD M4 x 0.7 (COARSE), TOLERANCE CLASS 6g.
3. HEXAGON SOCKET 3 A/F.
4. ALLOY STEEL, PROPERTY CLASS 12.9, BLACK OXIDE FINISH.
5. ALL DIMENSIONS IN MM, NOMINAL PER THE STANDARD (REFERENCE).
6. SIMPLIFIED MODEL: THREAD AND HEX SOCKET NOT SHOWN.
7. QUANTITY IN ASSEMBLY: 2.

UNLESS OTHERWISE SPECIFIED:
DIMENSIONS ARE IN MILLIMETERS
SURFACE FINISH:
TOLERANCES:
LINEAR:
ANGULAR:

NAME | SIGNATURE | DATE | | | | TITLE: Socket Head Cap Screw ISO 4762 M4x12

DRAWN | HADAR | | 06/10/26
CHK'D
APPV'D
MFG

34_SHCS_M4x12_ISO4762 | A3 Alloy Steel

WEIGHT: 2.35 | SCALE:5:1 | SHEET 1 OF 1

E | E
F | F

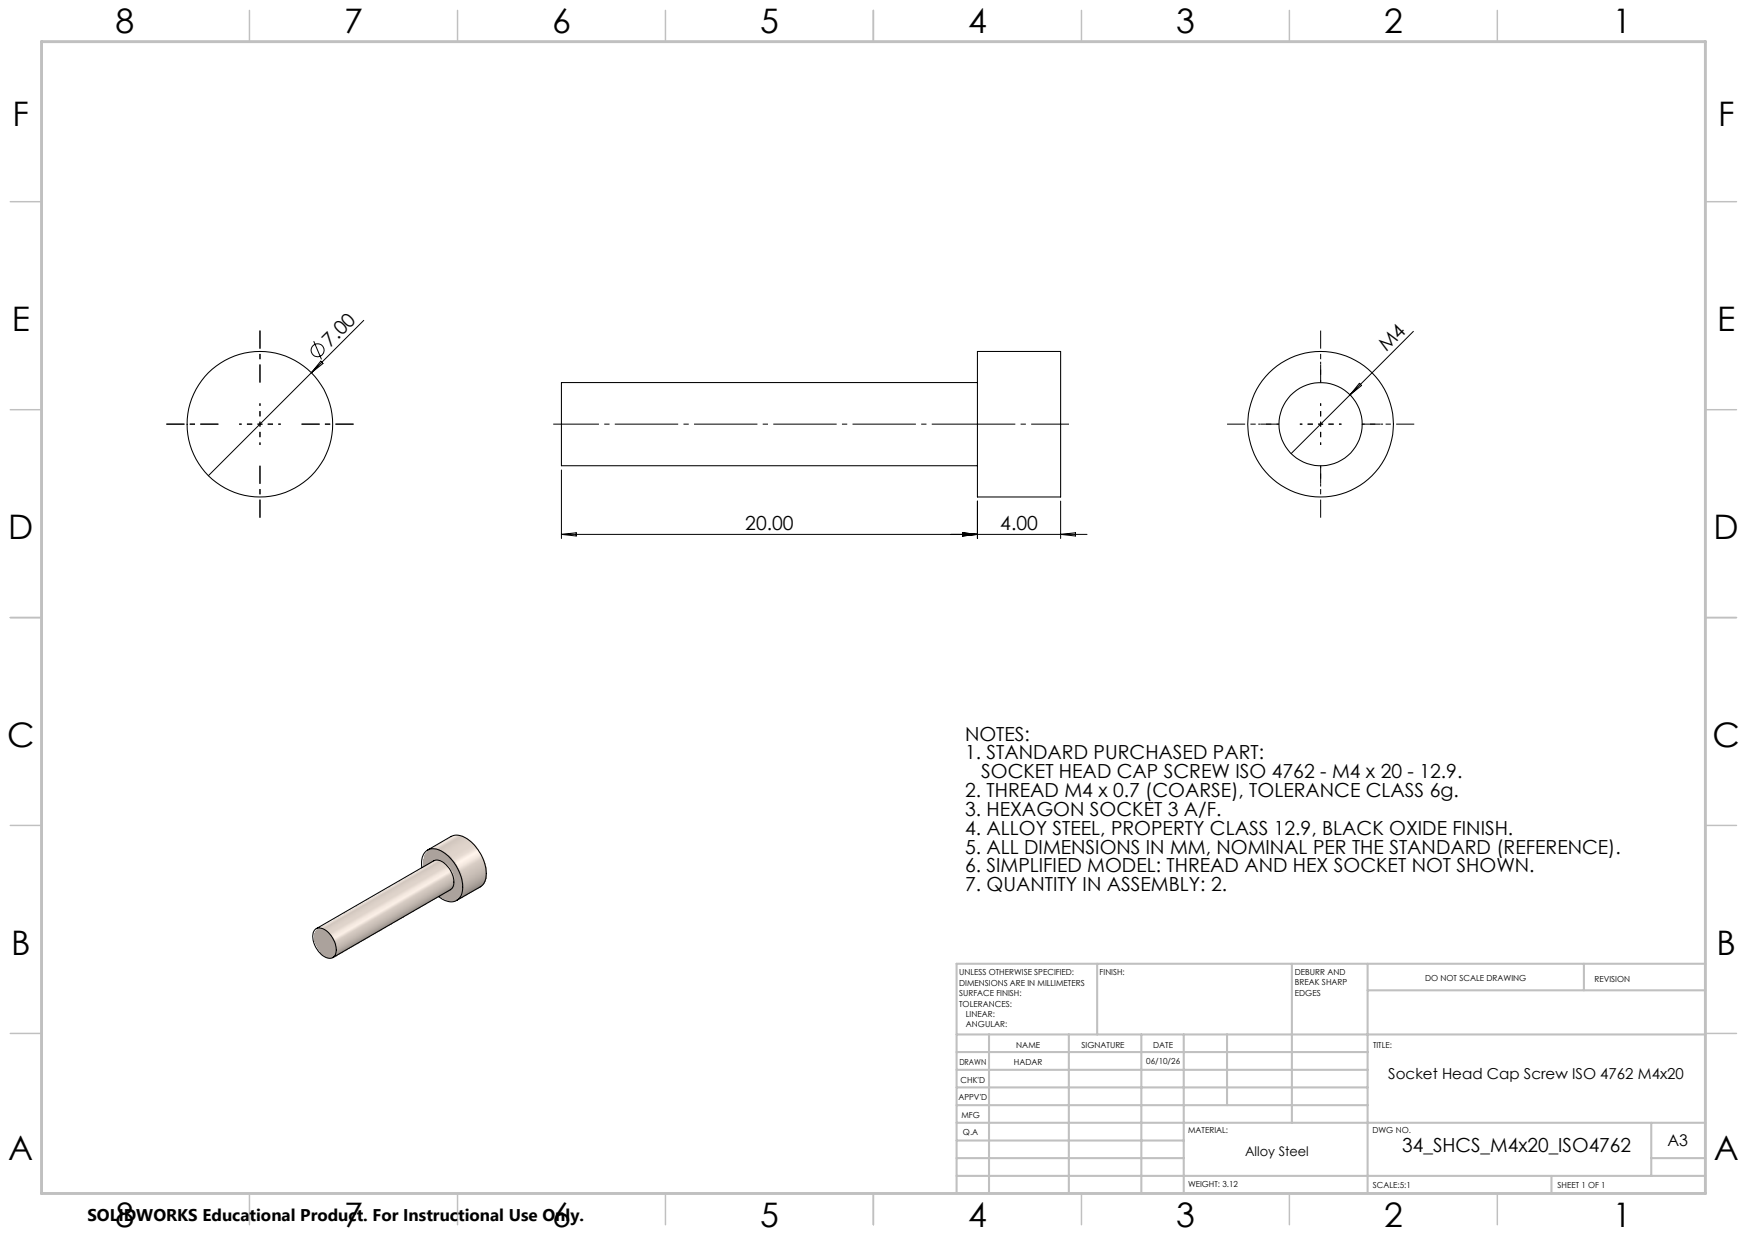
[picture p109: page 48]
FINISH:; DEBURR AND; BREAK SHARP EDGES; DO NOT SCALE DRAWING; REVISION

NOTES:
1. STANDARD PURCHASED PART:
SOCKET HEAD CAP SCREW ISO 4762 - M4 x 20 - 12.9.
2. THREAD M4 x 0.7 (COARSE), TOLERANCE CLASS 6g.
3. HEXAGON SOCKET 3 A/F.
4. ALLOY STEEL, PROPERTY CLASS 12.9, BLACK OXIDE FINISH.
5. ALL DIMENSIONS IN MM, NOMINAL PER THE STANDARD (REFERENCE).
6. SIMPLIFIED MODEL: THREAD AND HEX SOCKET NOT SHOWN.
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
