Avi-Y-Goldstein/compression-jig-solidworks/(commit log)

2026-10-13 Add README, assemblies and drawing PDF
    [CompressionJig_Assembly.SLDASM, SUB_DialIndicator.SLDASM, SUB_LowerStack.SLDASM, SUB_RatchetDrive.SLDASM, SUB_UpperStack.SLDASM]
2026-10-13 Add part files
    [01_Main_Frame_Body.SLDPRT, 02_Heavy_Base_Plate.SLDPRT, 03_Anvil_Pedestal.SLDPRT, 04_LowerRamGuideBlock.SLDPRT, 05_UpperRamGuideBlock.SLDPRT, 06_Left_Safety_Shield.SLDPRT, 07_RightSafetyShield.SLDPRT, 08_ShieldMountingBracket.SLDPRT]
2026-10-13 Add part drawings
    [01_Main_Frame_Body.SLDDRW, 02_Heavy_Base_Plate.SLDDRW, 03_Anvil_Pedestal.SLDDRW, 04_LowerRamGuideBlock.SLDDRW, 05_UpperRamGuideBlock.SLDDRW, 06_Left_Safety_Shield.SLDDRW, 07_RightSafetyShield.SLDDRW, 08_ShieldMountingBracket.SLDDRW]
